nicolaeandreivasile/plc-embedded-application/board-design/kicad-files/ESP32-PLC/board-images-3D/ESP32-PLC-top.jpg

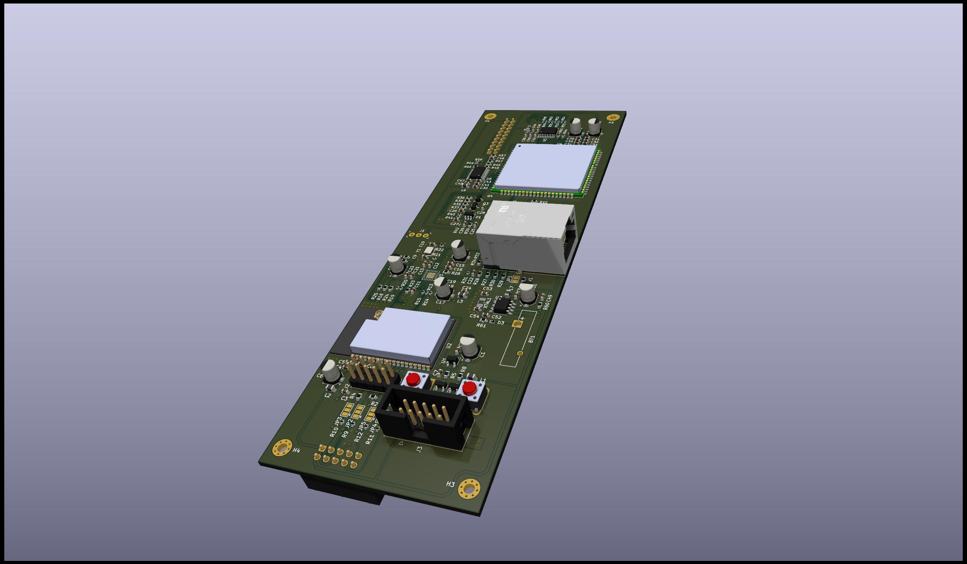
board-design/kicad-files/ESP32-PLC/board-images-3D/ESP32-PLC-top.jpg
