nicolaeandreivasile/plc-embedded-application/board-design/kicad-files/ESP32-PLC-programmer/board-images-3D/ESP32-PLC-programmer-3D-bottom.jpg

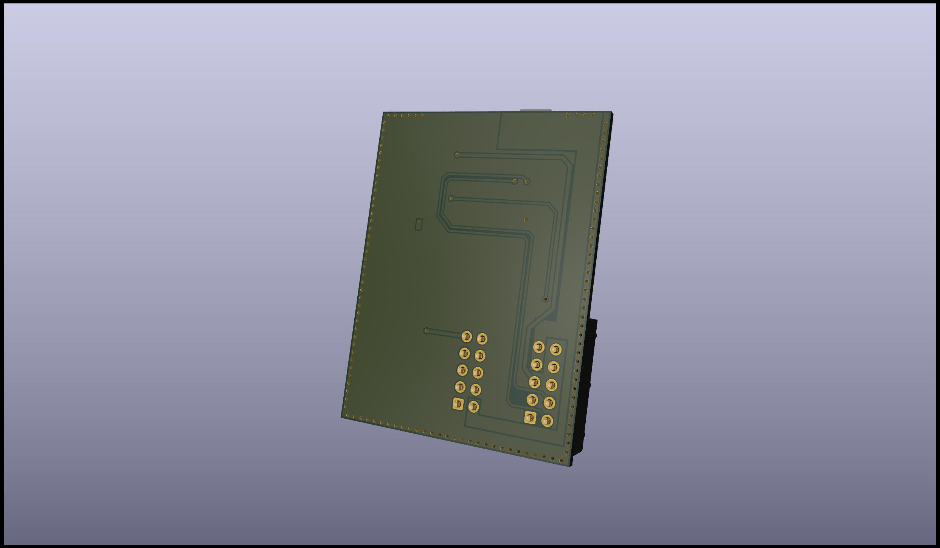
board-design/kicad-files/ESP32-PLC-programmer/board-images-3D/ESP32-PLC-programmer-3D-bottom.jpg
