nicolaeandreivasile/plc-embedded-application/README.md

# plc-embedded-application
A PLC (Programmable Logic Controller) made from scratch focused on controlling and maintaining industrial-like applications

## Board design
Control unit schematic under development. I/O unit schematic development process not started yet
