nicolaeandreivasile/plc-embedded-application/board-design/kicad-files/ESP32-PLC-programmer/schematic-images-sheet/ESP32-programmer-schematic-sheet-color-1.jpg

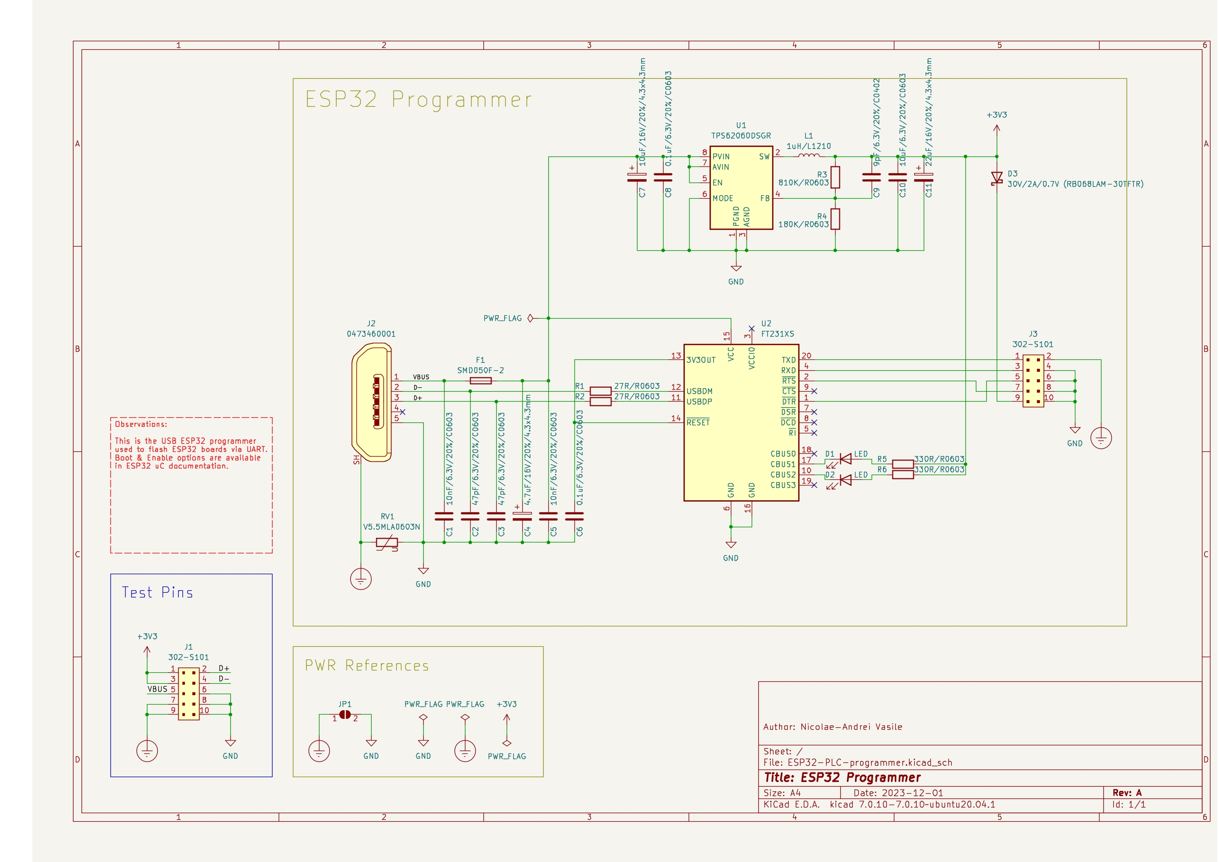
board-design/kicad-files/ESP32-PLC-programmer/schematic-images-sheet/ESP32-programmer-schematic-sheet-color-1.jpg
