nicolaeandreivasile/plc-embedded-application/board-design/kicad-files/ESP32-PLC-programmer/schematic-images-simple/ESP32-programmer-schematic-simple-mono-1.jpg

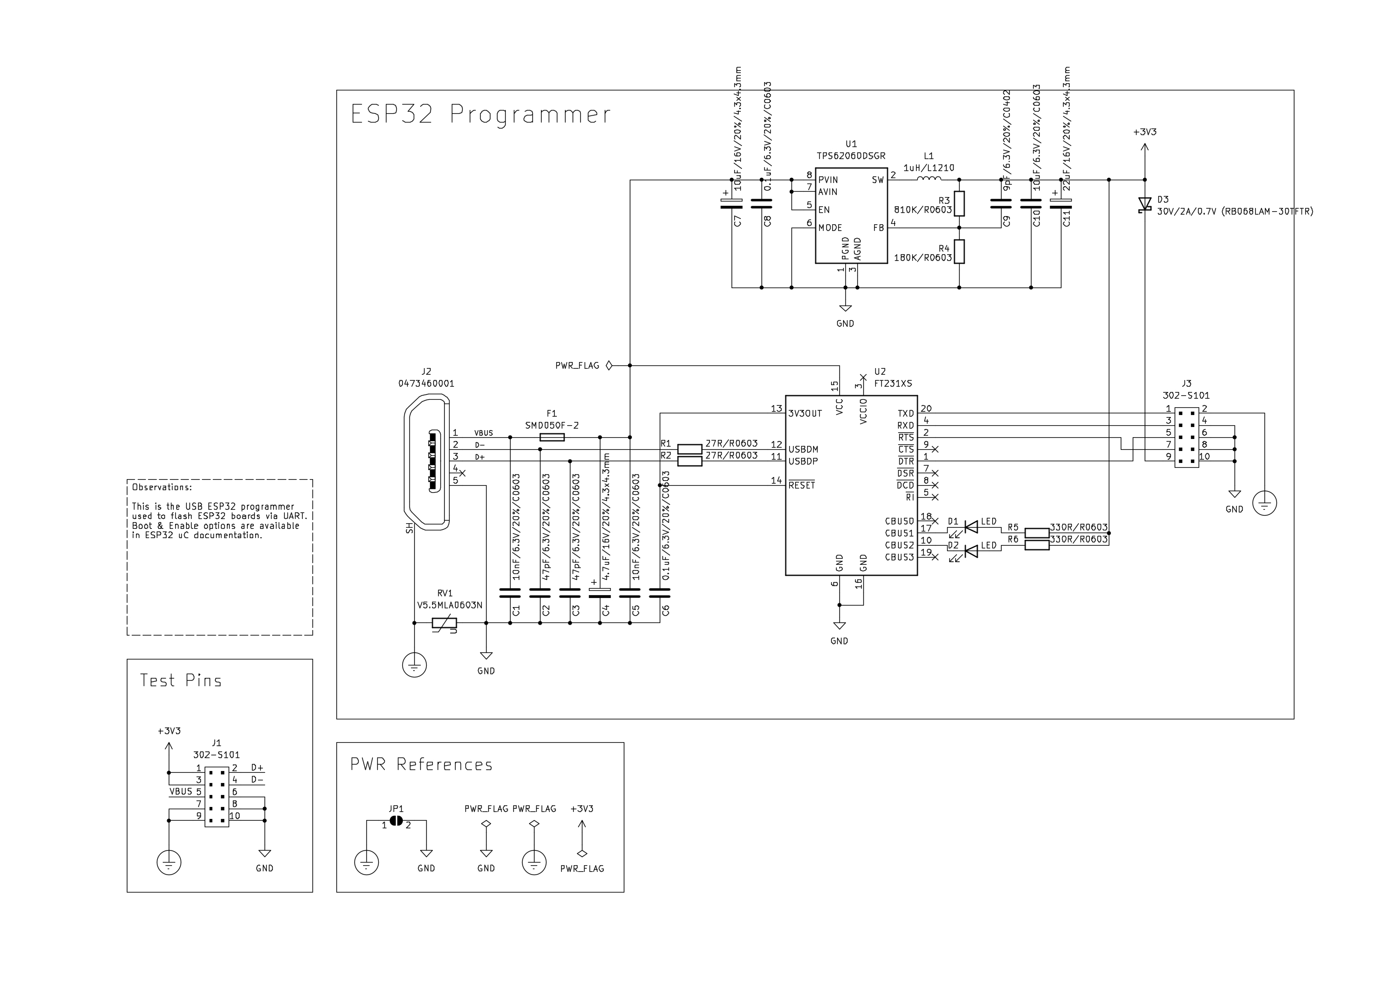
board-design/kicad-files/ESP32-PLC-programmer/schematic-images-simple/ESP32-programmer-schematic-simple-mono-1.jpg
