nicolaeandreivasile/plc-embedded-application/board-design/kicad-files/ESP32-PLC/schematic-images-sheet/ESP32-schematic-sheet-color-3.jpg

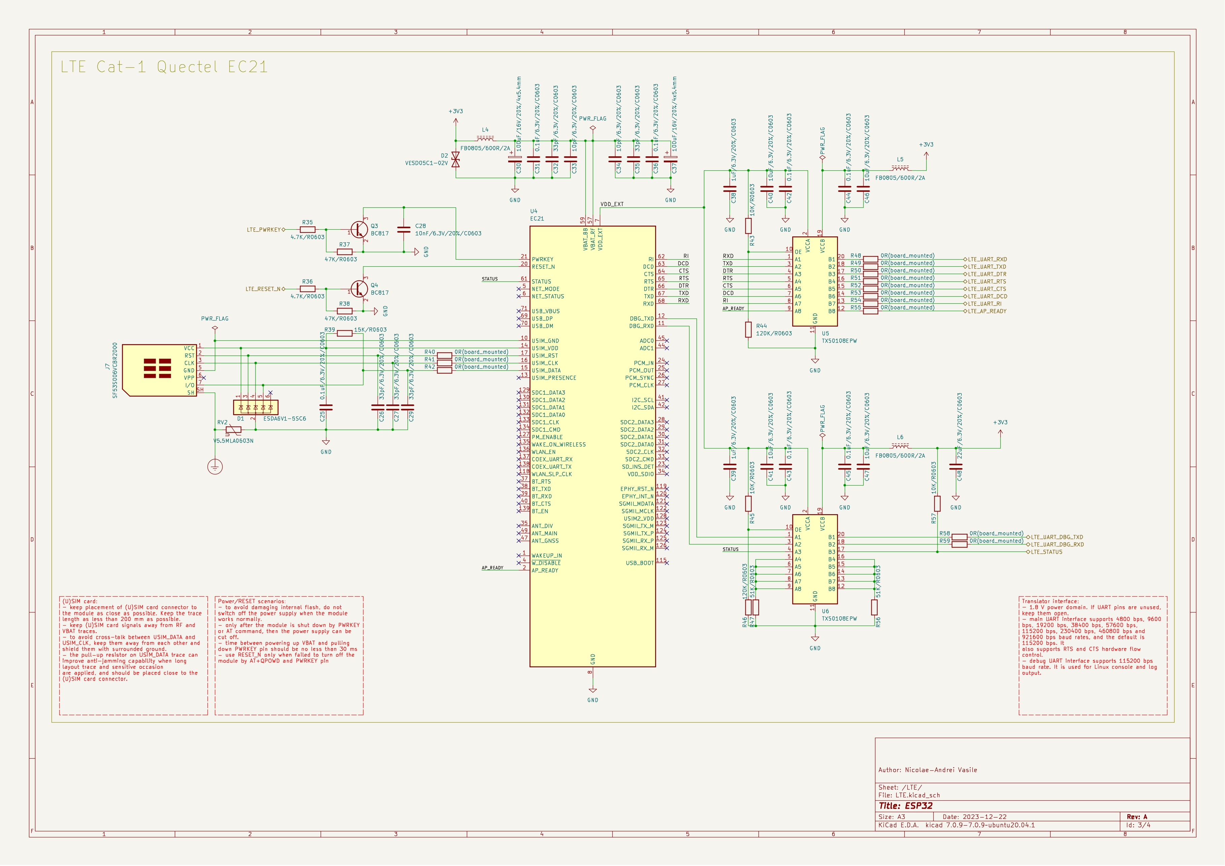
board-design/kicad-files/ESP32-PLC/schematic-images-sheet/ESP32-schematic-sheet-color-3.jpg
