nicolaeandreivasile/plc-embedded-application/board-design/kicad-files/ESP32-PLC/schematic-images-simple/ESP32-schematic-simple-mono-1.jpg

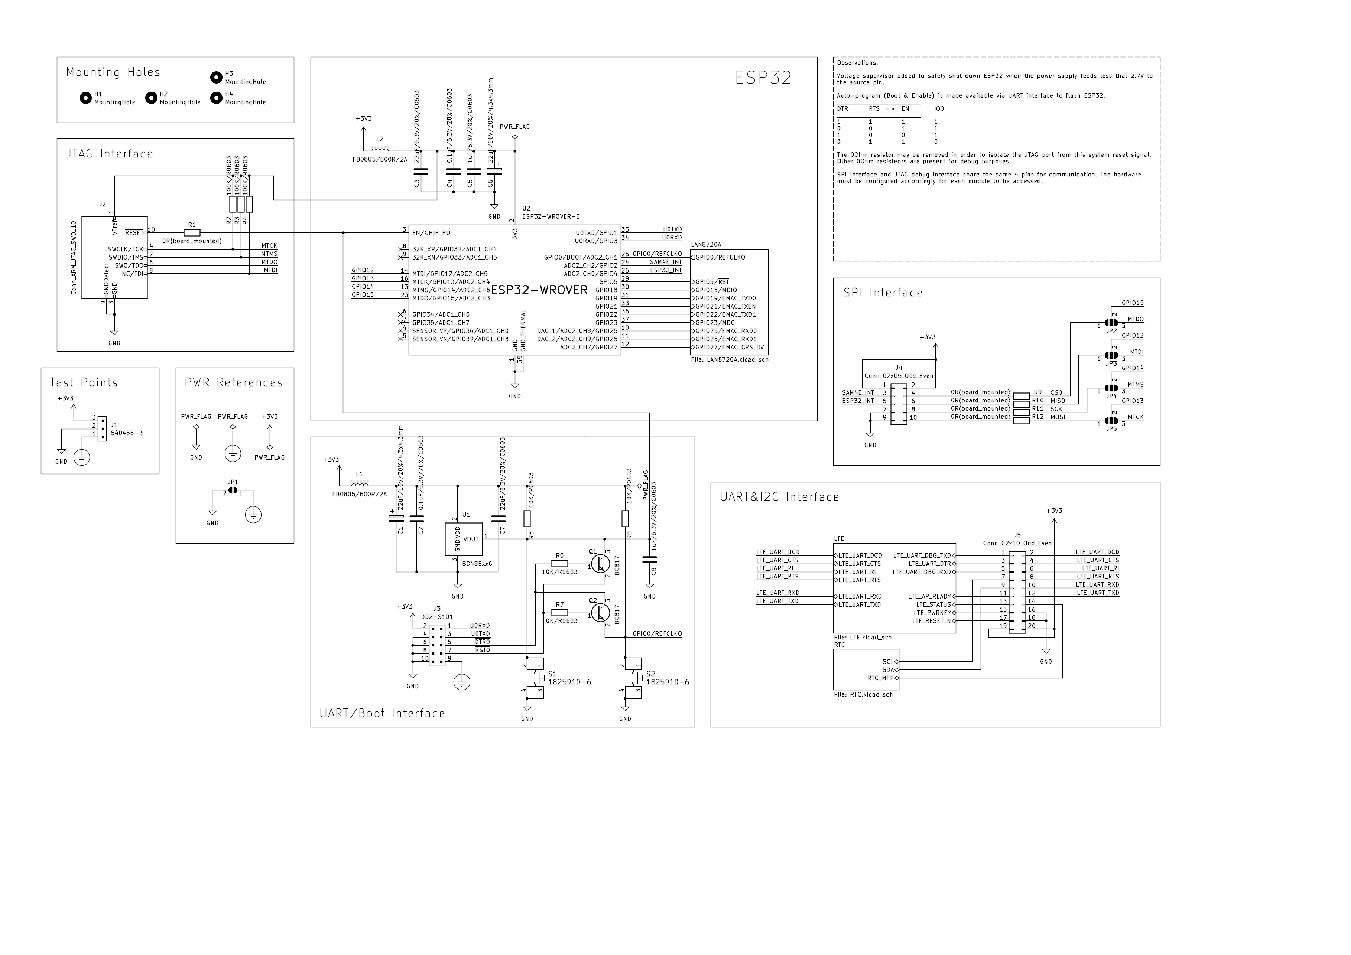
board-design/kicad-files/ESP32-PLC/schematic-images-simple/ESP32-schematic-simple-mono-1.jpg
