nicolaeandreivasile/plc-embedded-application/board-design/kicad-files/SAM4E-PLC/schematic-images-sheet/SAM4E-schematic-sheet-color-4.jpg

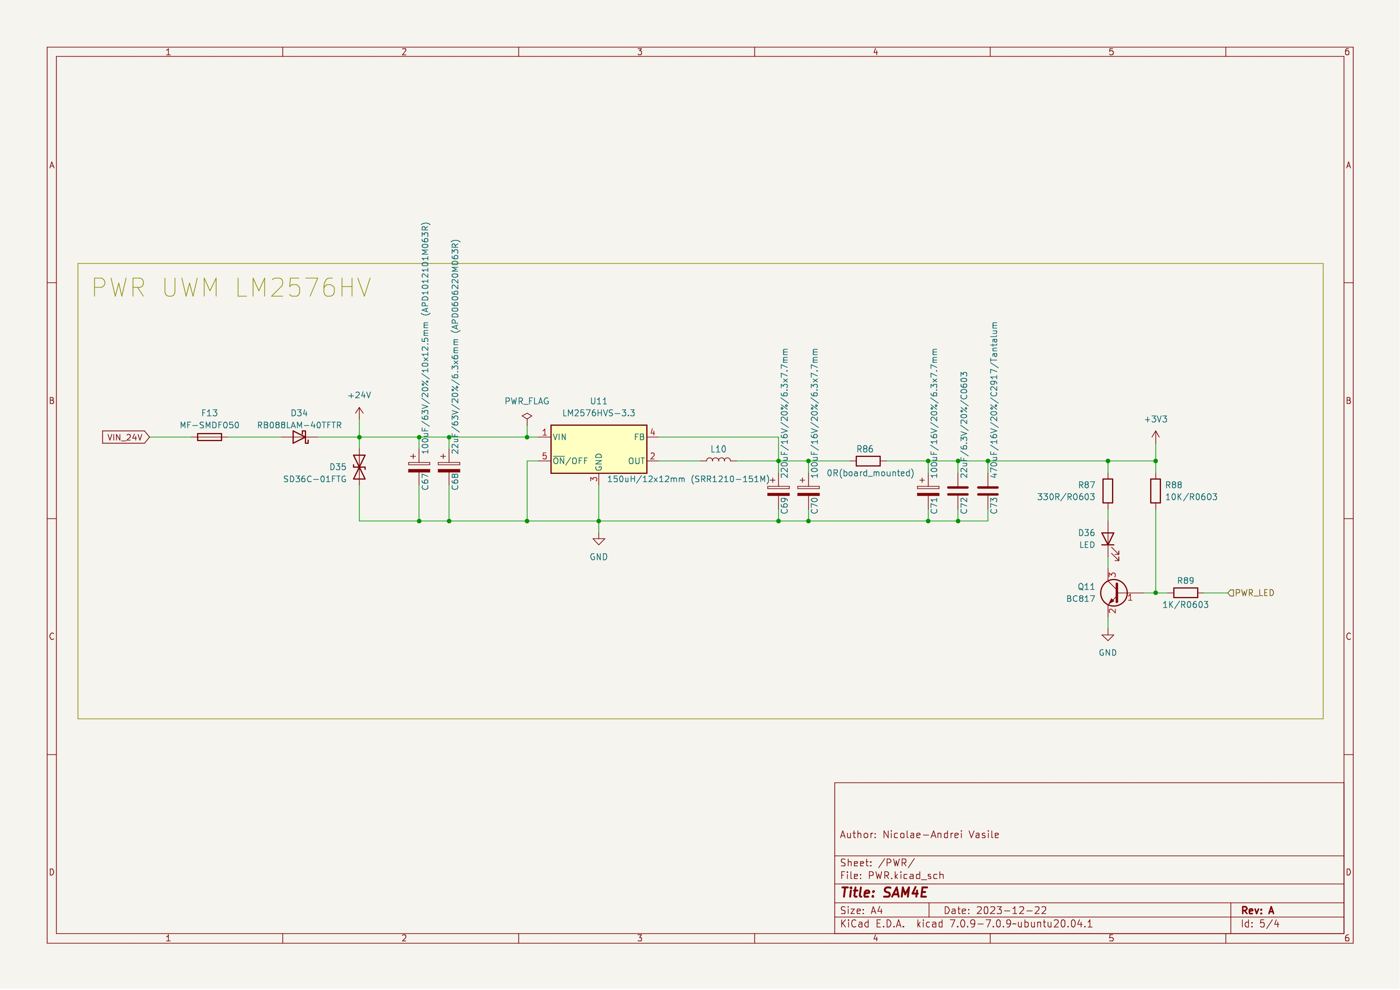
board-design/kicad-files/SAM4E-PLC/schematic-images-sheet/SAM4E-schematic-sheet-color-4.jpg
