nicolaeandreivasile/plc-embedded-application/board-design/kicad-files/SAM4E-PLC/schematic-images-simple/SAM4E-schematic-simple-color-2.jpg

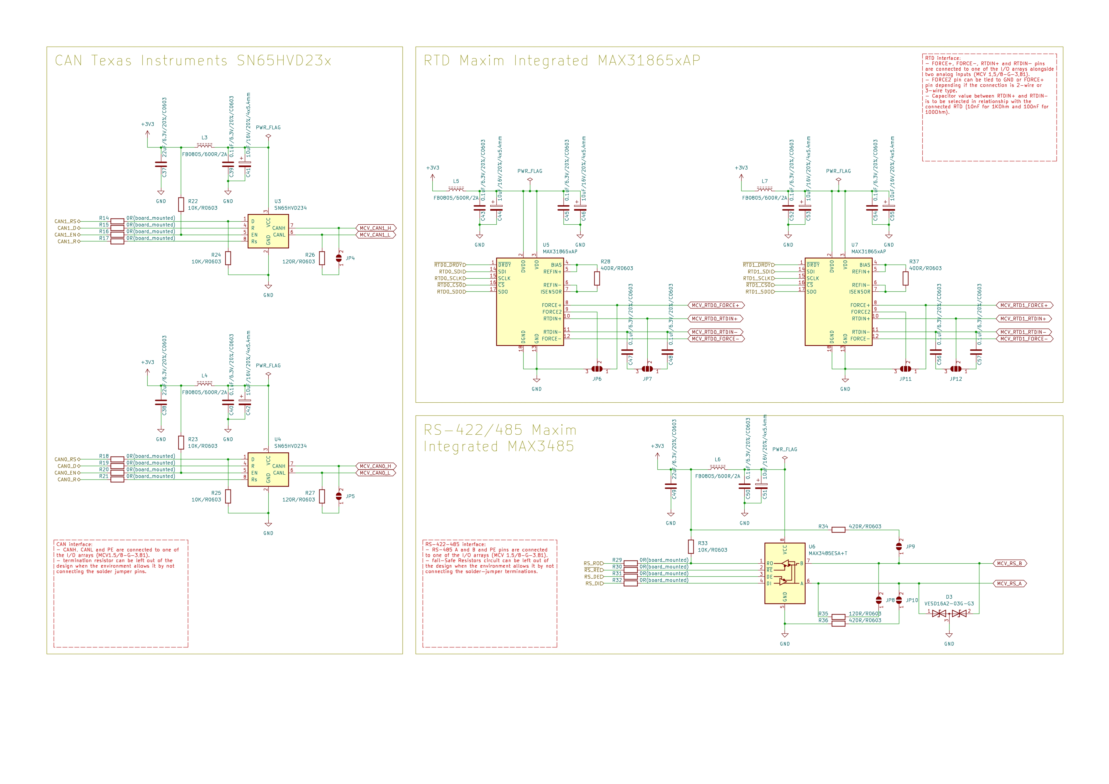
board-design/kicad-files/SAM4E-PLC/schematic-images-simple/SAM4E-schematic-simple-color-2.jpg
