nicolaeandreivasile/plc-embedded-application/board-design/kicad-files/PCB-top_merged.pdf

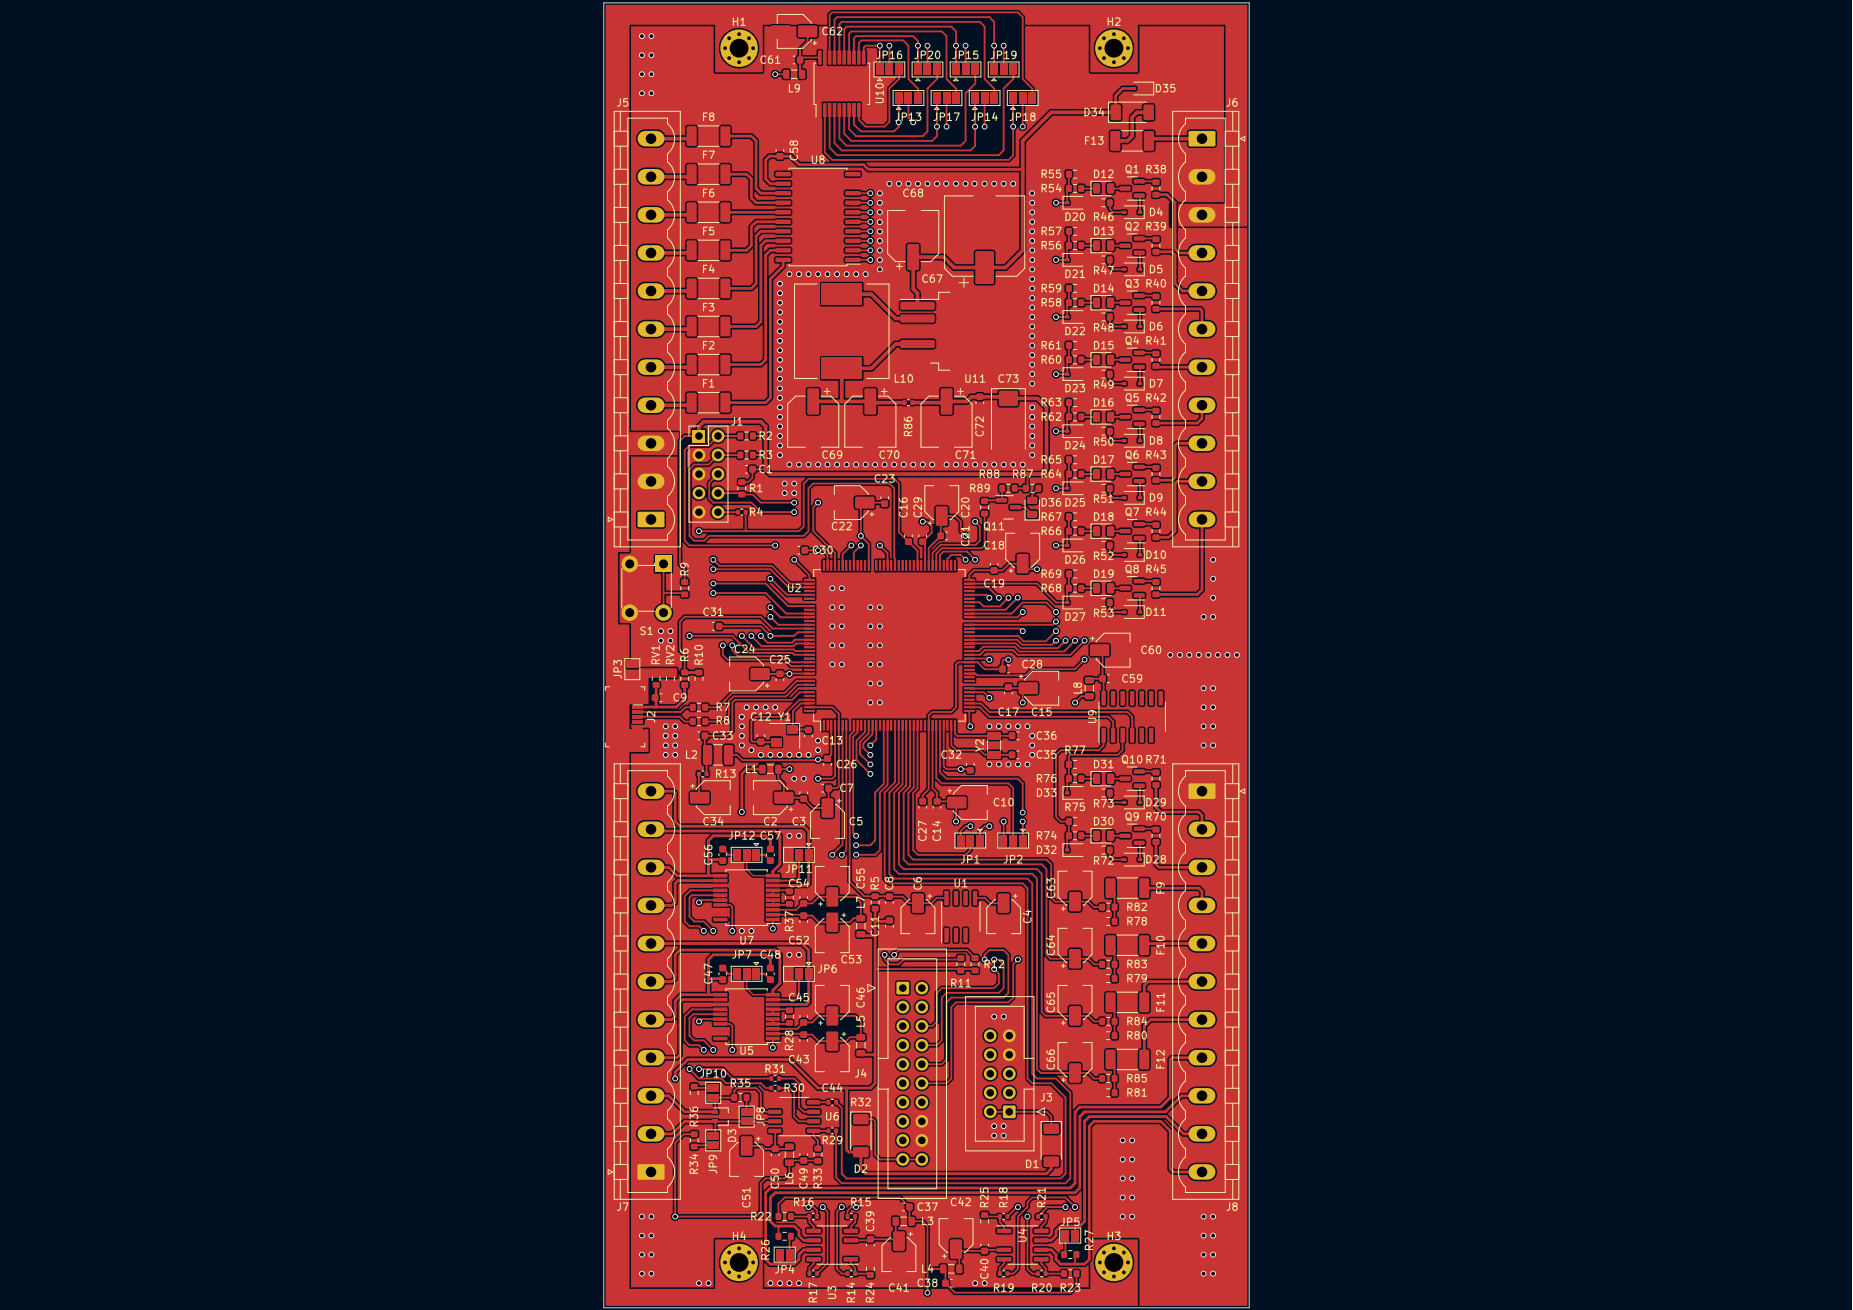
[picture p68: page 1]

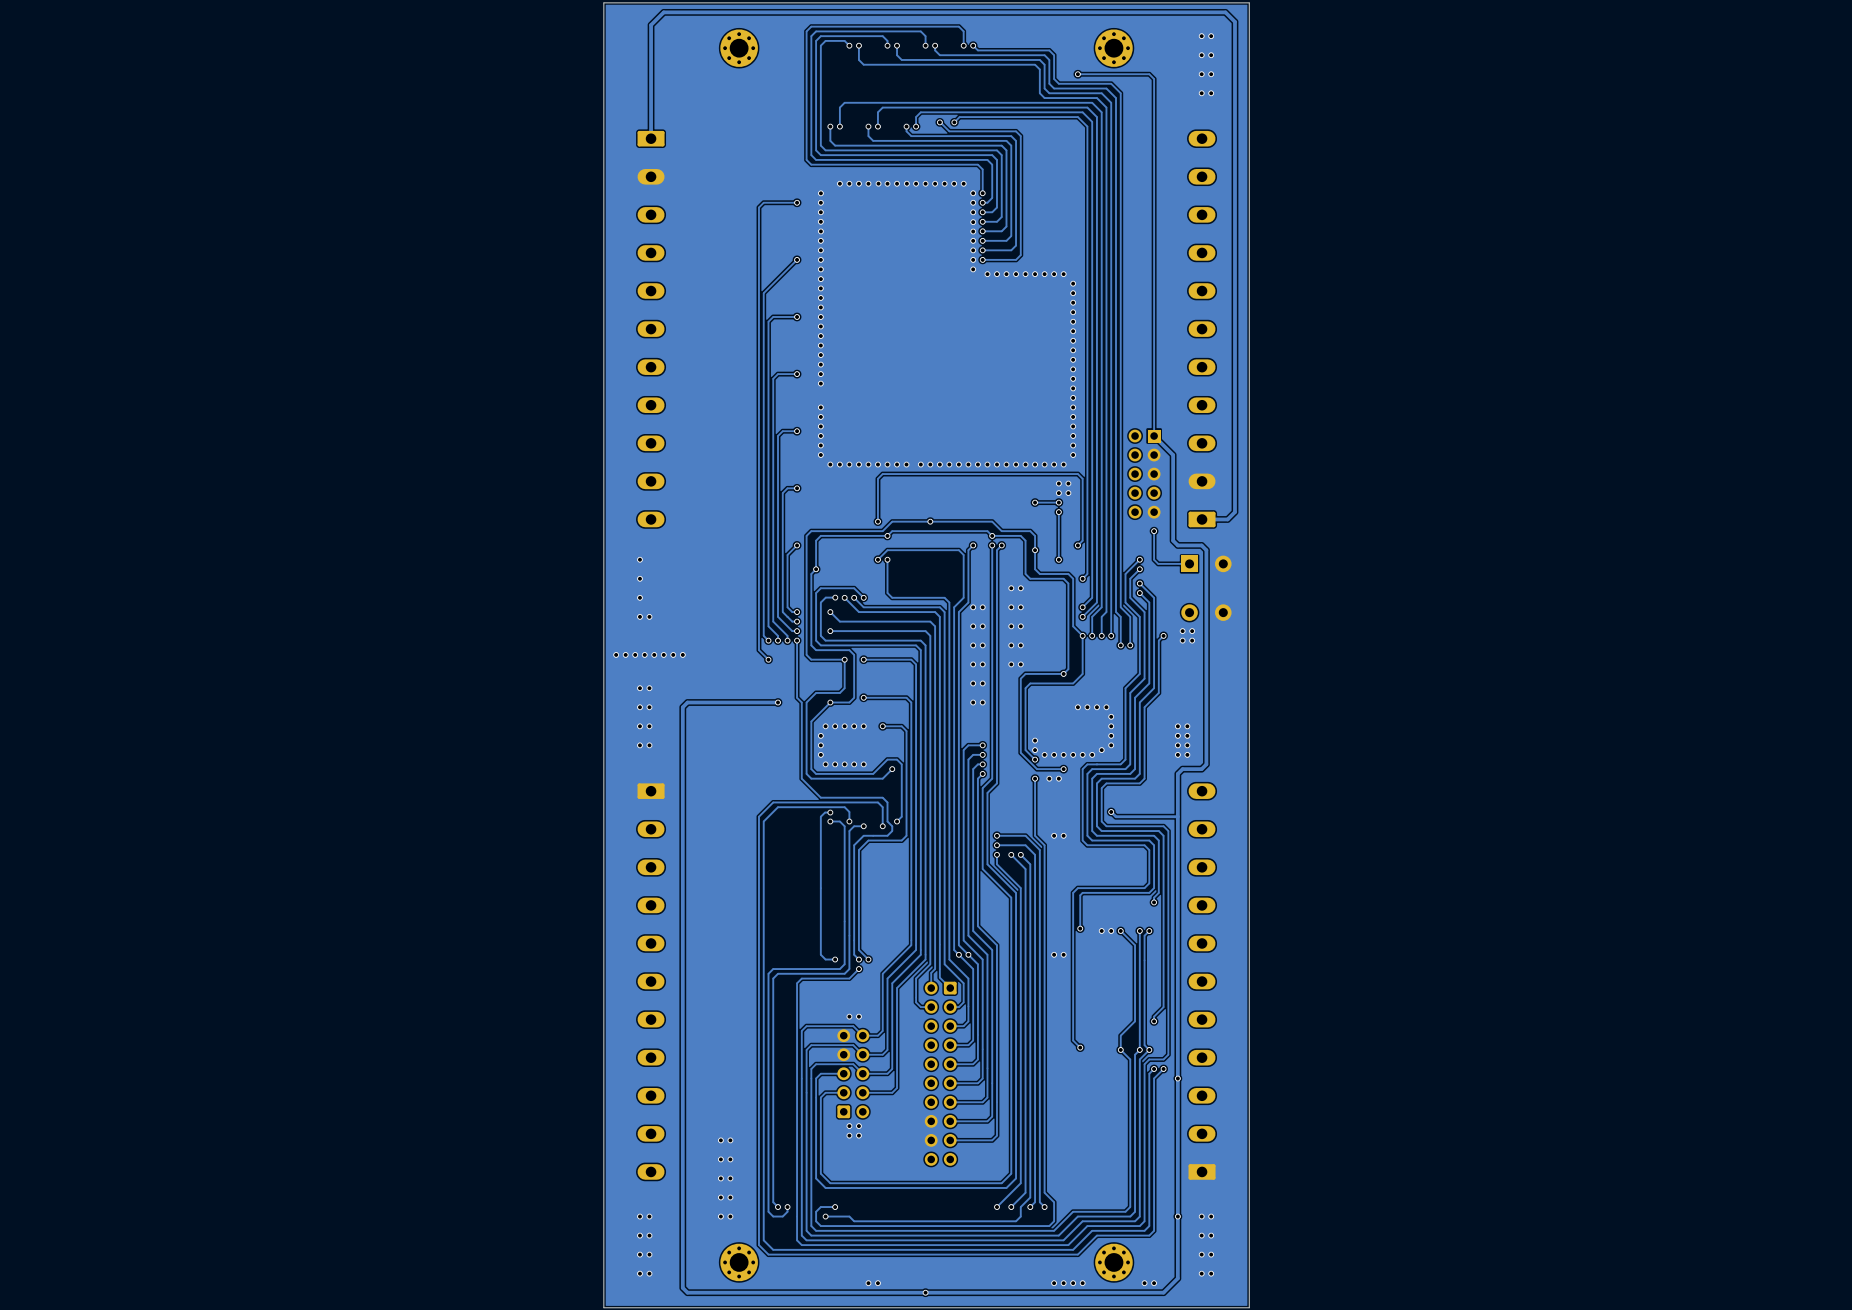
[picture p69: page 2]

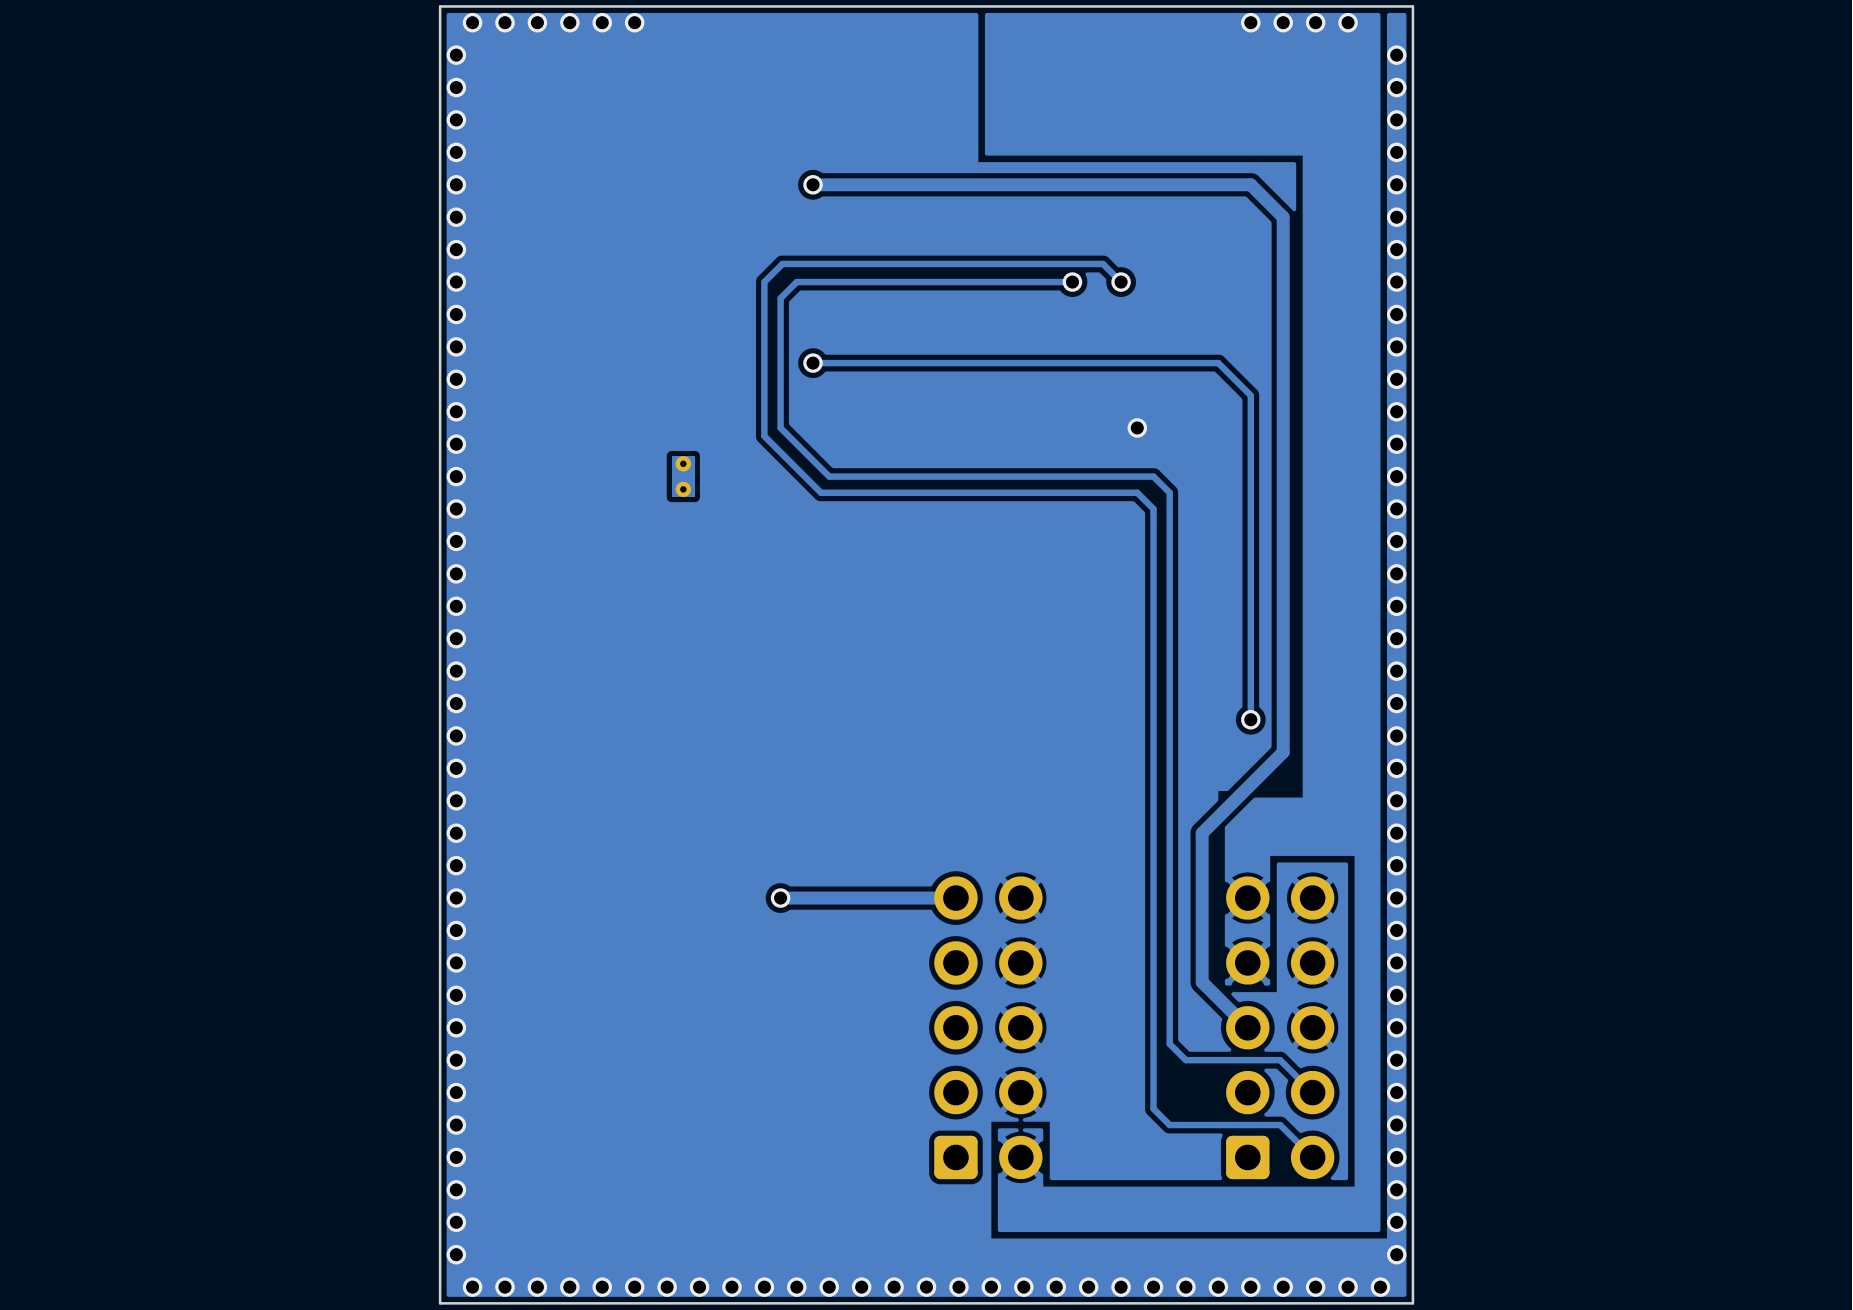
[picture p70: page 3]

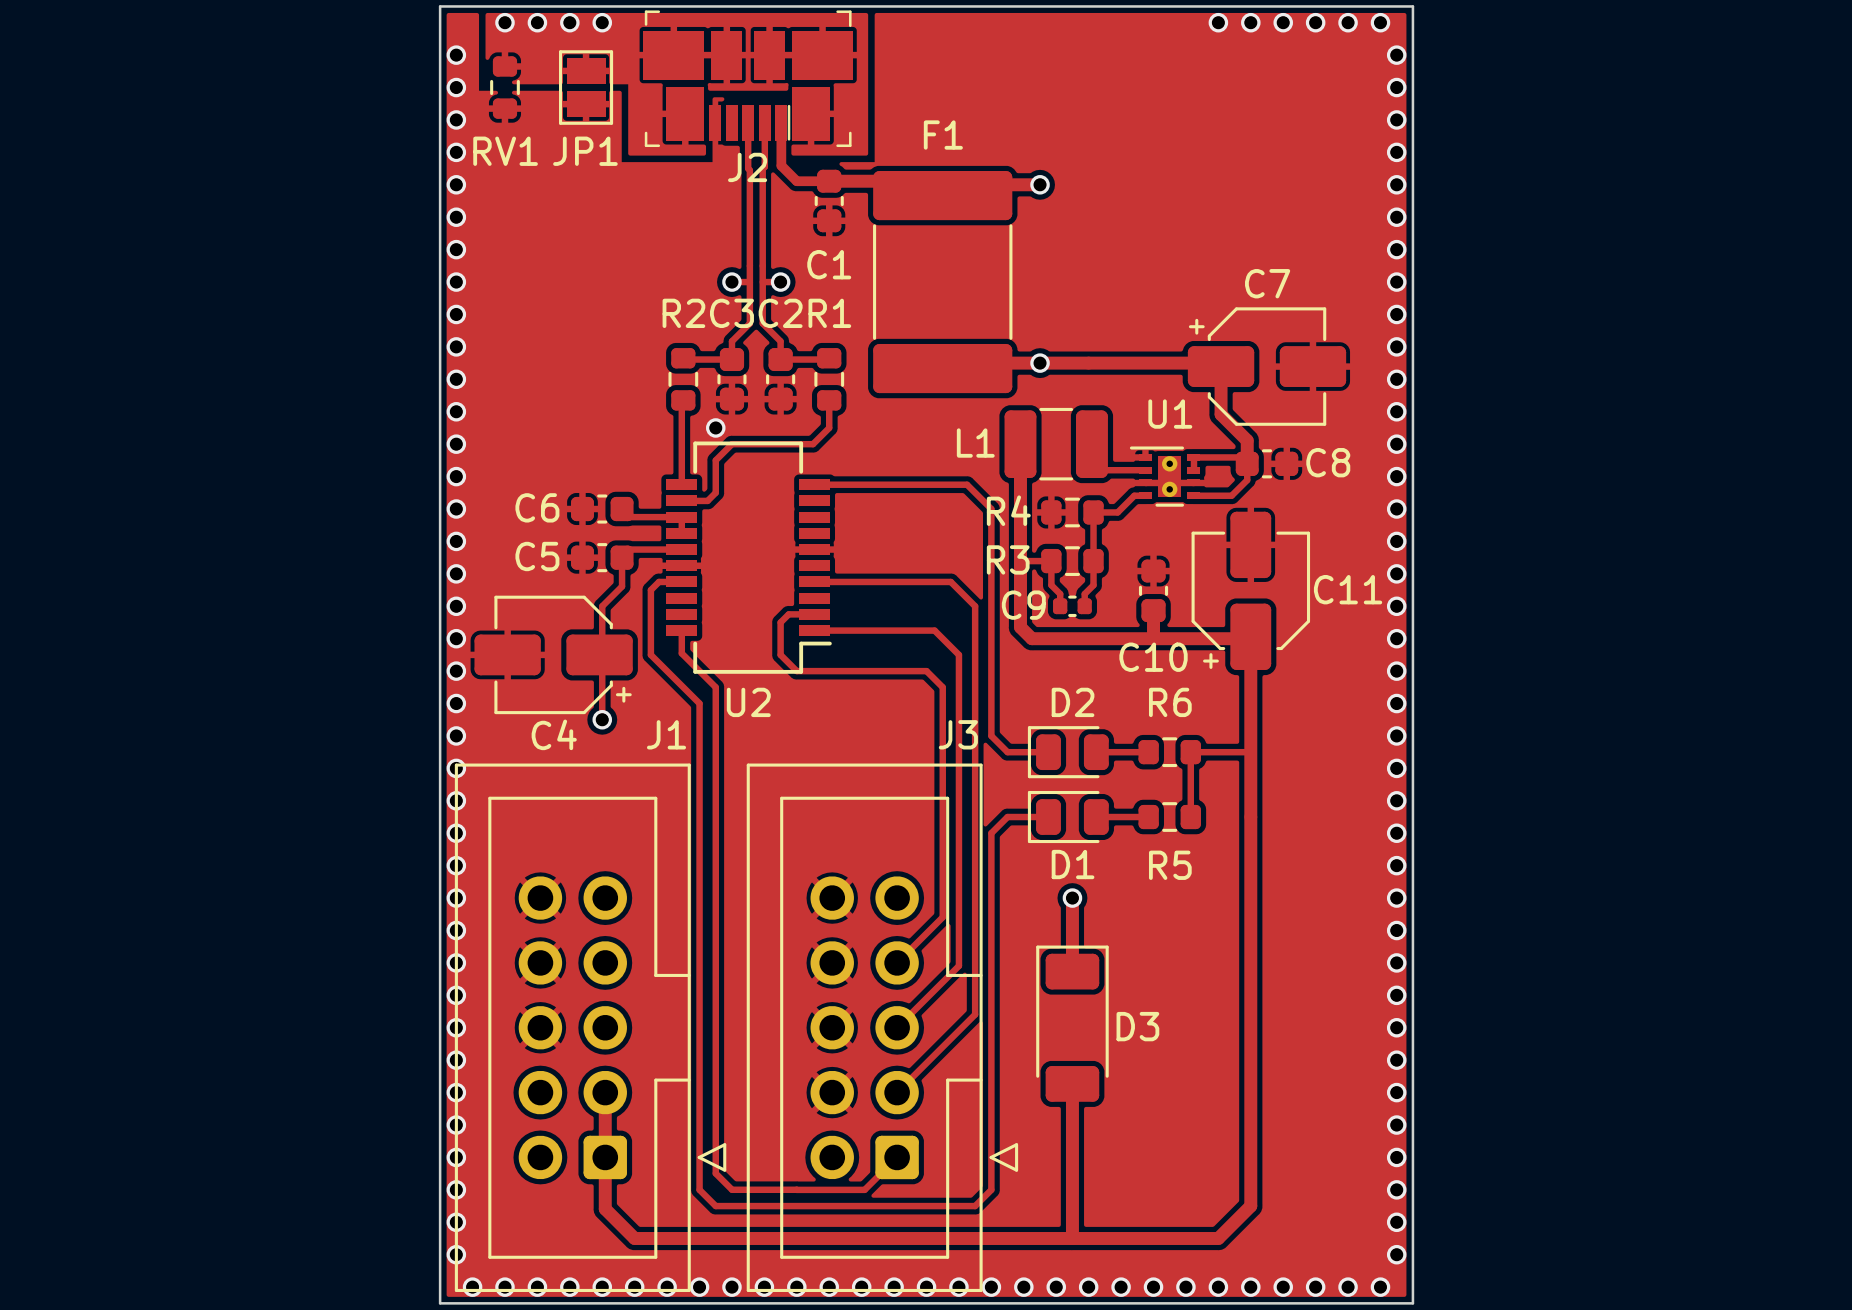
[picture p71: page 4]
