nicolaeandreivasile/plc-embedded-application/board-design/eagle-files/ESP32-PLC-programmer/plc_esp32_programmer.pdf

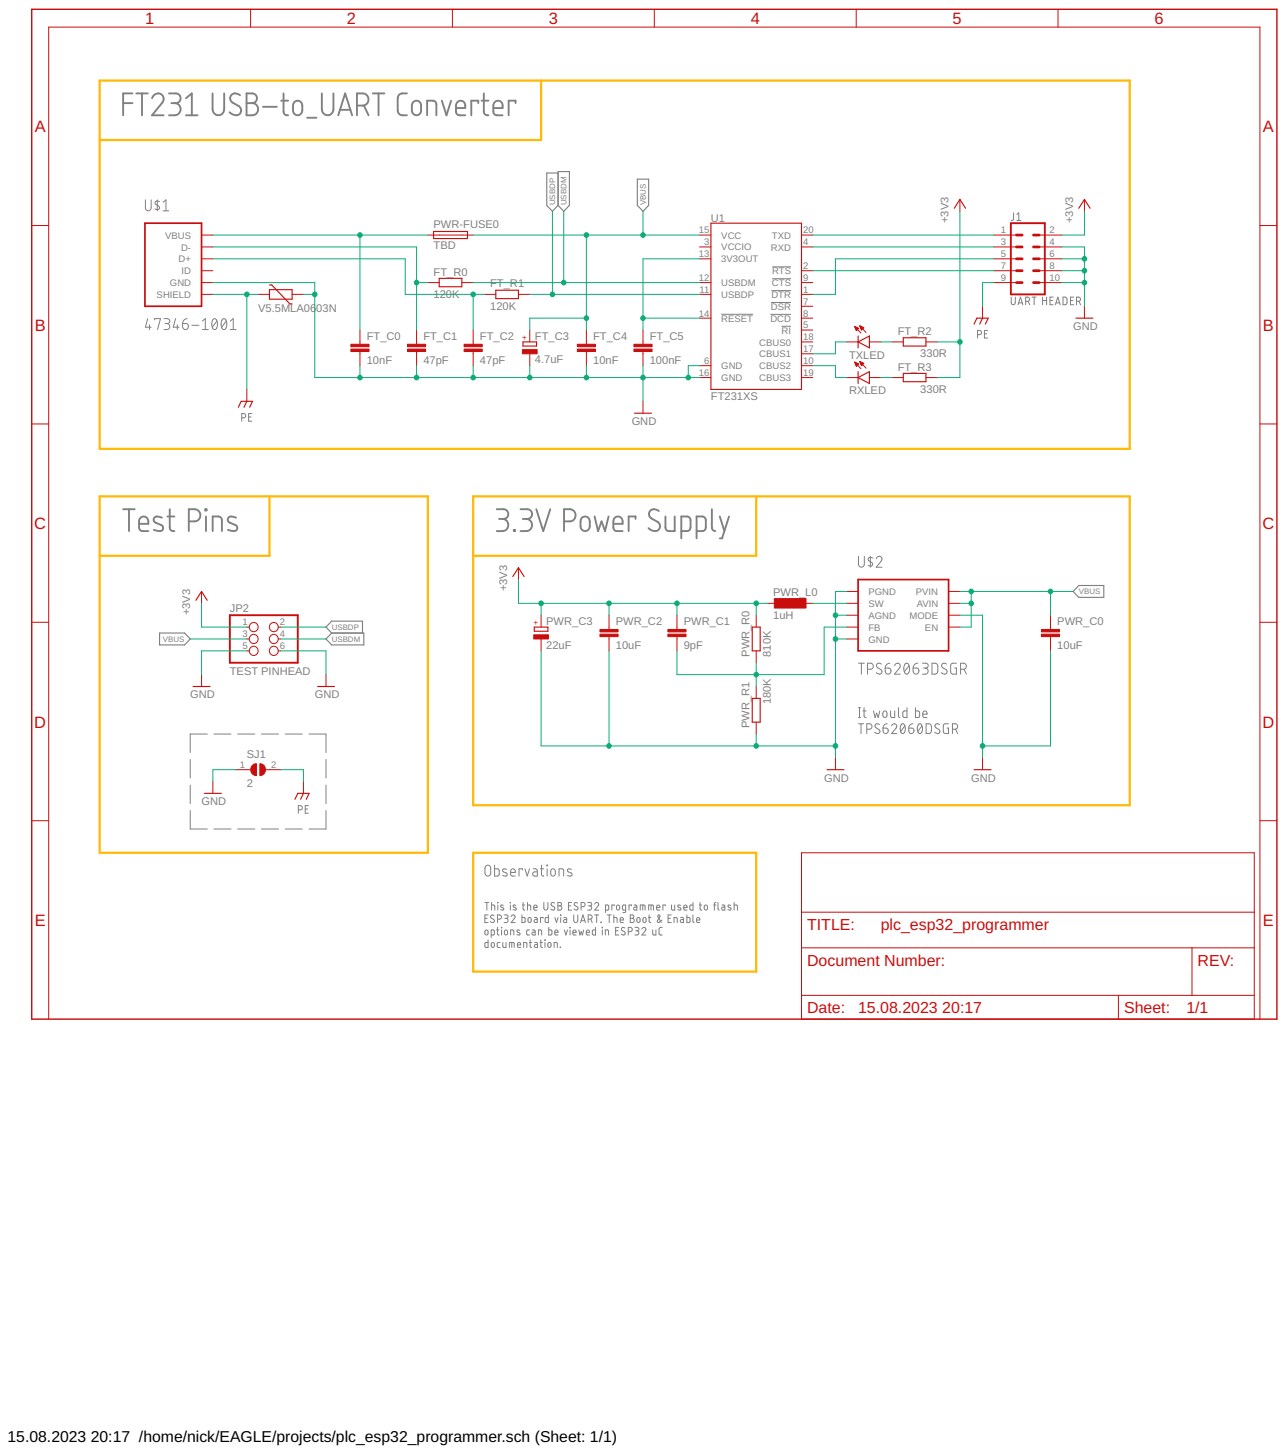
[picture p72: page 1]

3 | 1 VBUSD- D+ 3 | 4

Document Number: | REV:

Date: 15.08.2023 20:17 | Sheet: 1/1

15.08.2023 20:17 /home/nick/EAGLE/projects/plc_esp32_programmer.sch (Sheet: 1/1)
