nicolaeandreivasile/plc-embedded-application/board-design/eagle-files/ESP32-PLC/plc_esp32.pdf

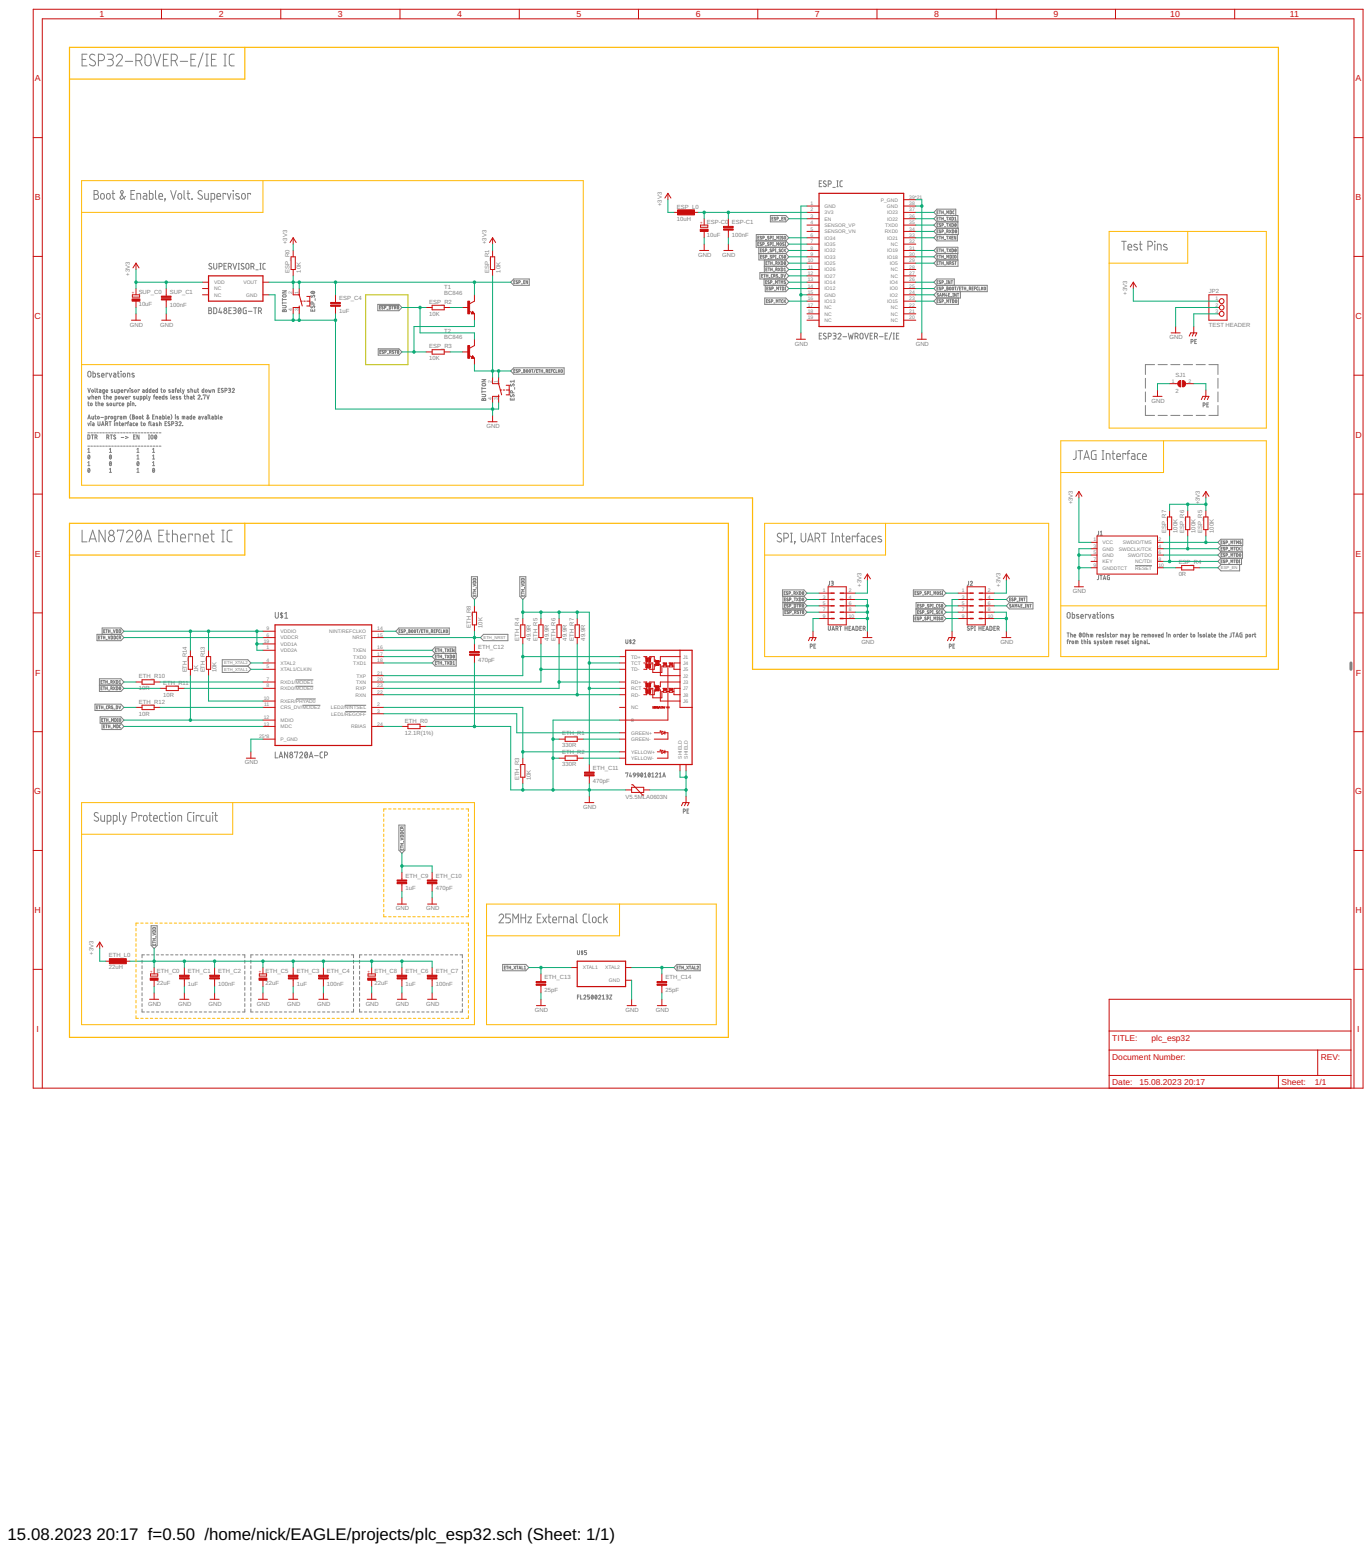
[picture p73: page 1]

TD+ TCT
TD- RD+ RCT RD- NC

15.08.2023 20:17 f=0.50 /home/nick/EAGLE/projects/plc_esp32.sch (Sheet: 1/1)
