nicolaeandreivasile/plc-embedded-application/board-design/eagle-files/SAM4E-PLC/plc_sam4e.pdf

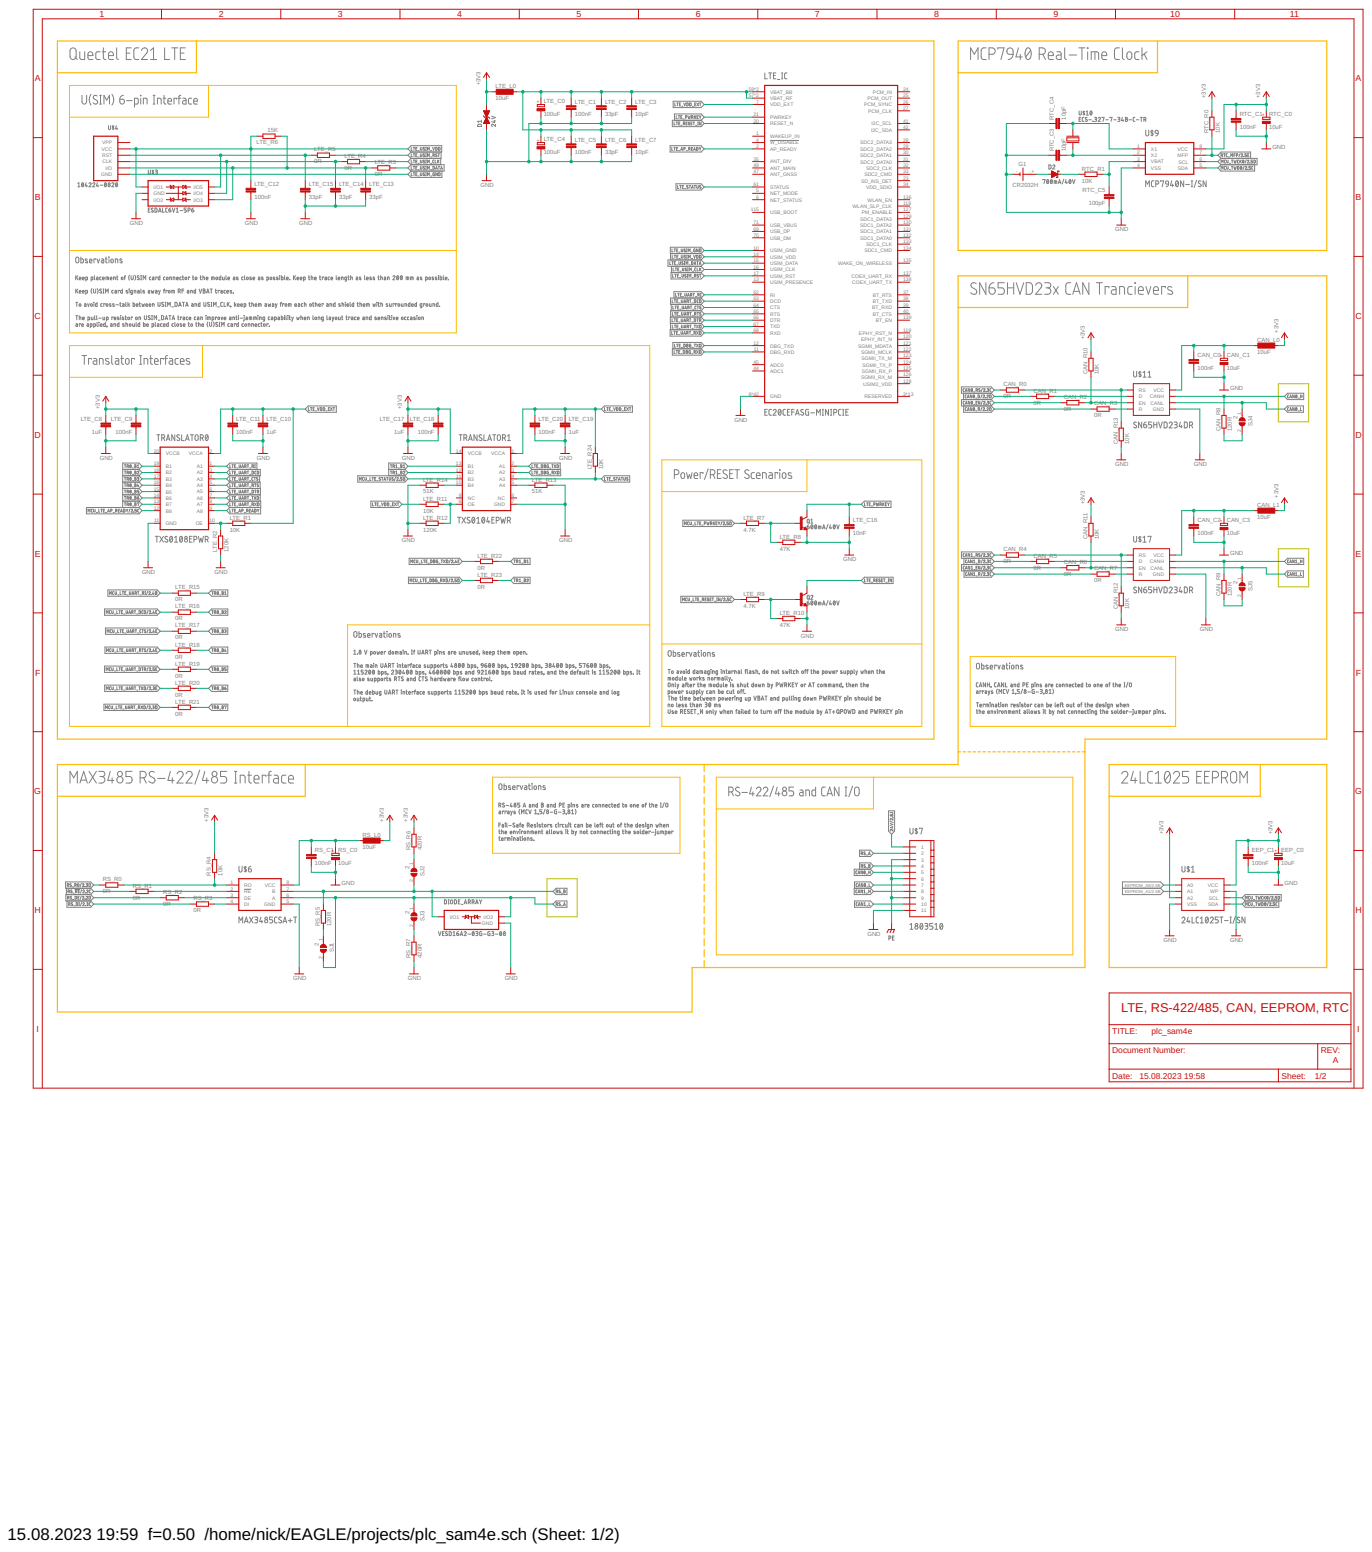
[picture p74: page 1]

LTE, RS-422/485, CAN, EEPROM, RTC

15.08.2023 19:59 f=0.50 /home/nick/EAGLE/projects/plc_sam4e.sch (Sheet: 1/2)

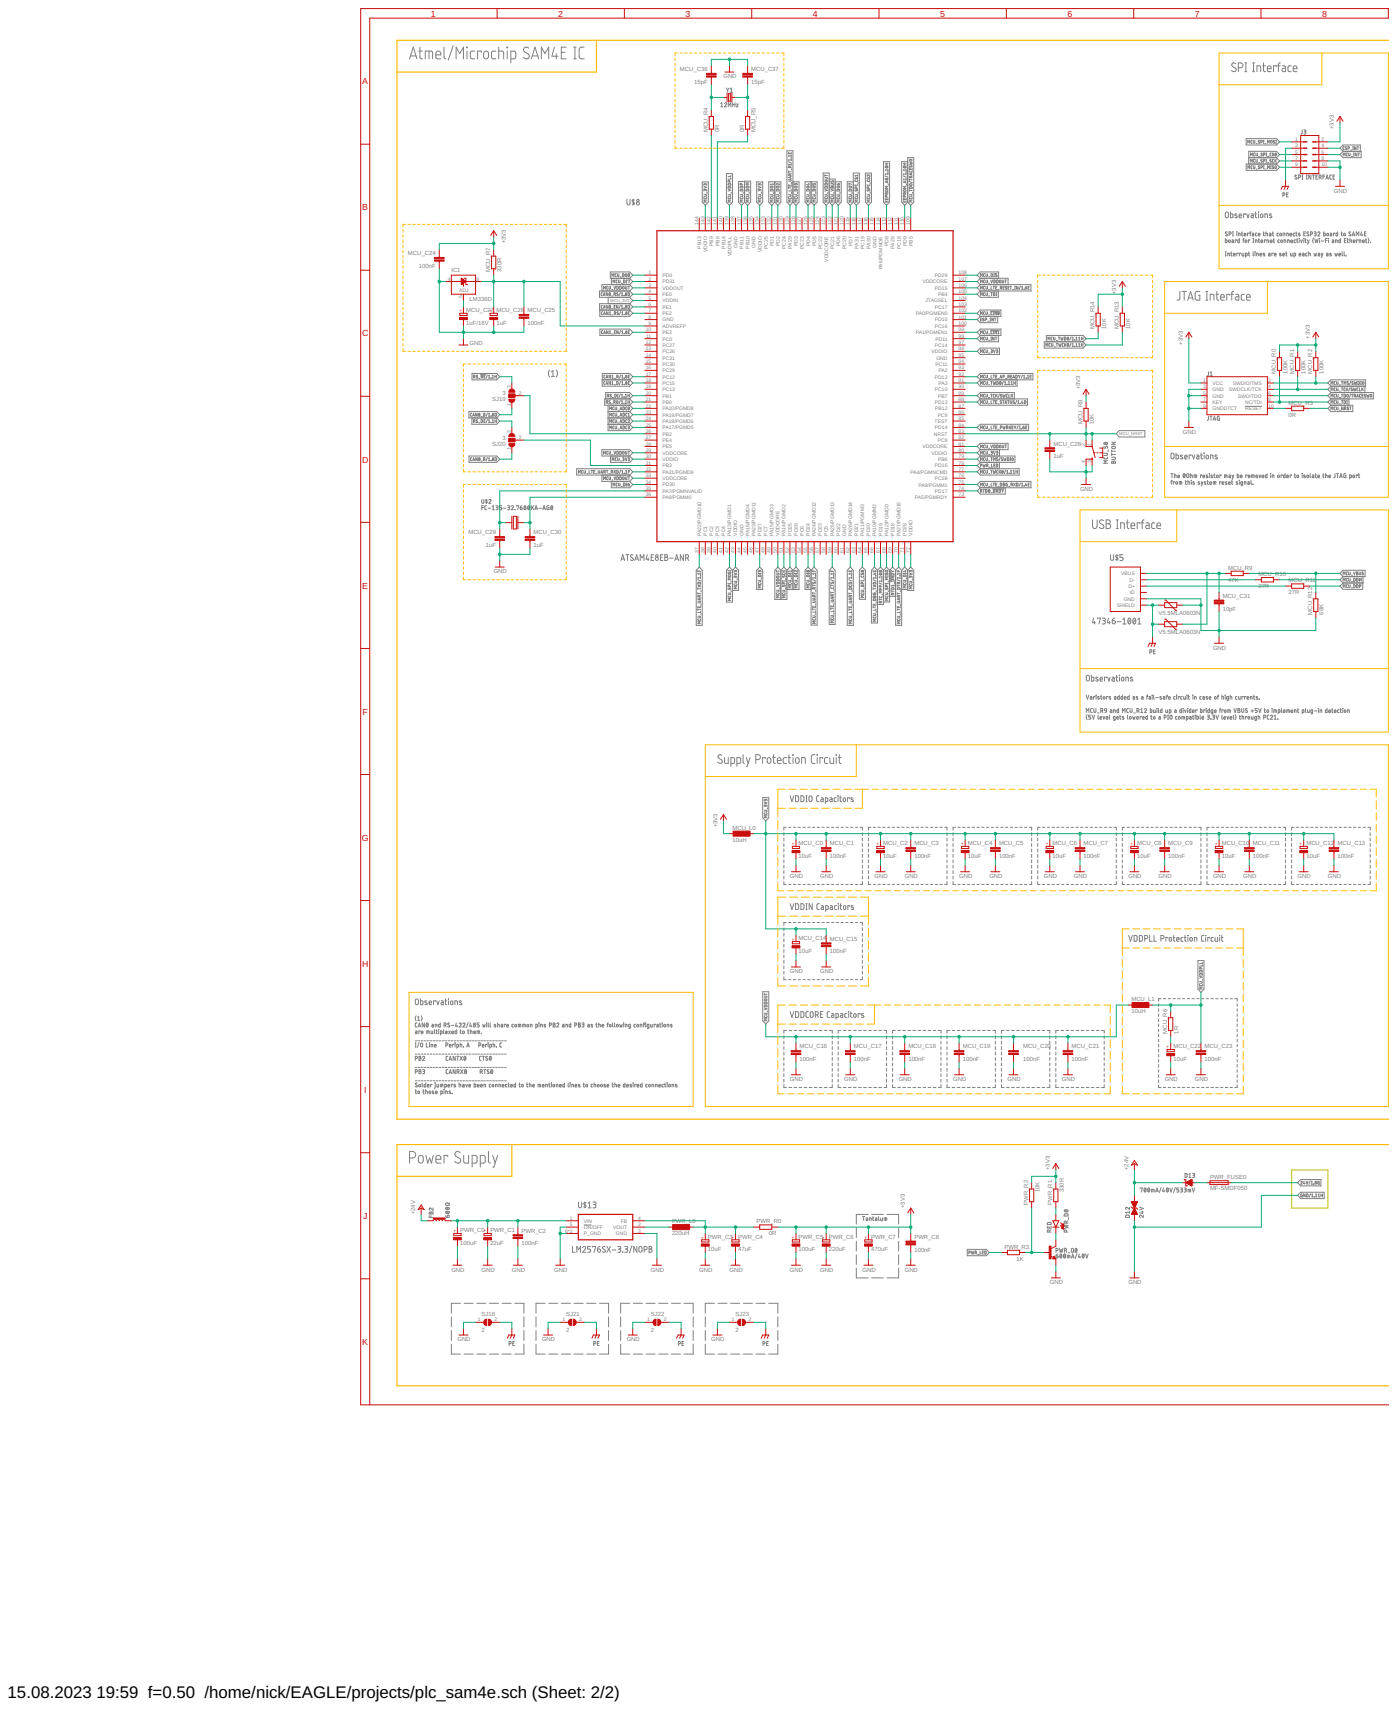
[picture p75: page 2]

4 SWDIO/TMS
6 SWDCLK/TCK
10 NC/TDI 8 SWO/TDO

15.08.2023 19:59 f=0.50 /home/nick/EAGLE/projects/plc_sam4e.sch (Sheet: 2/2)

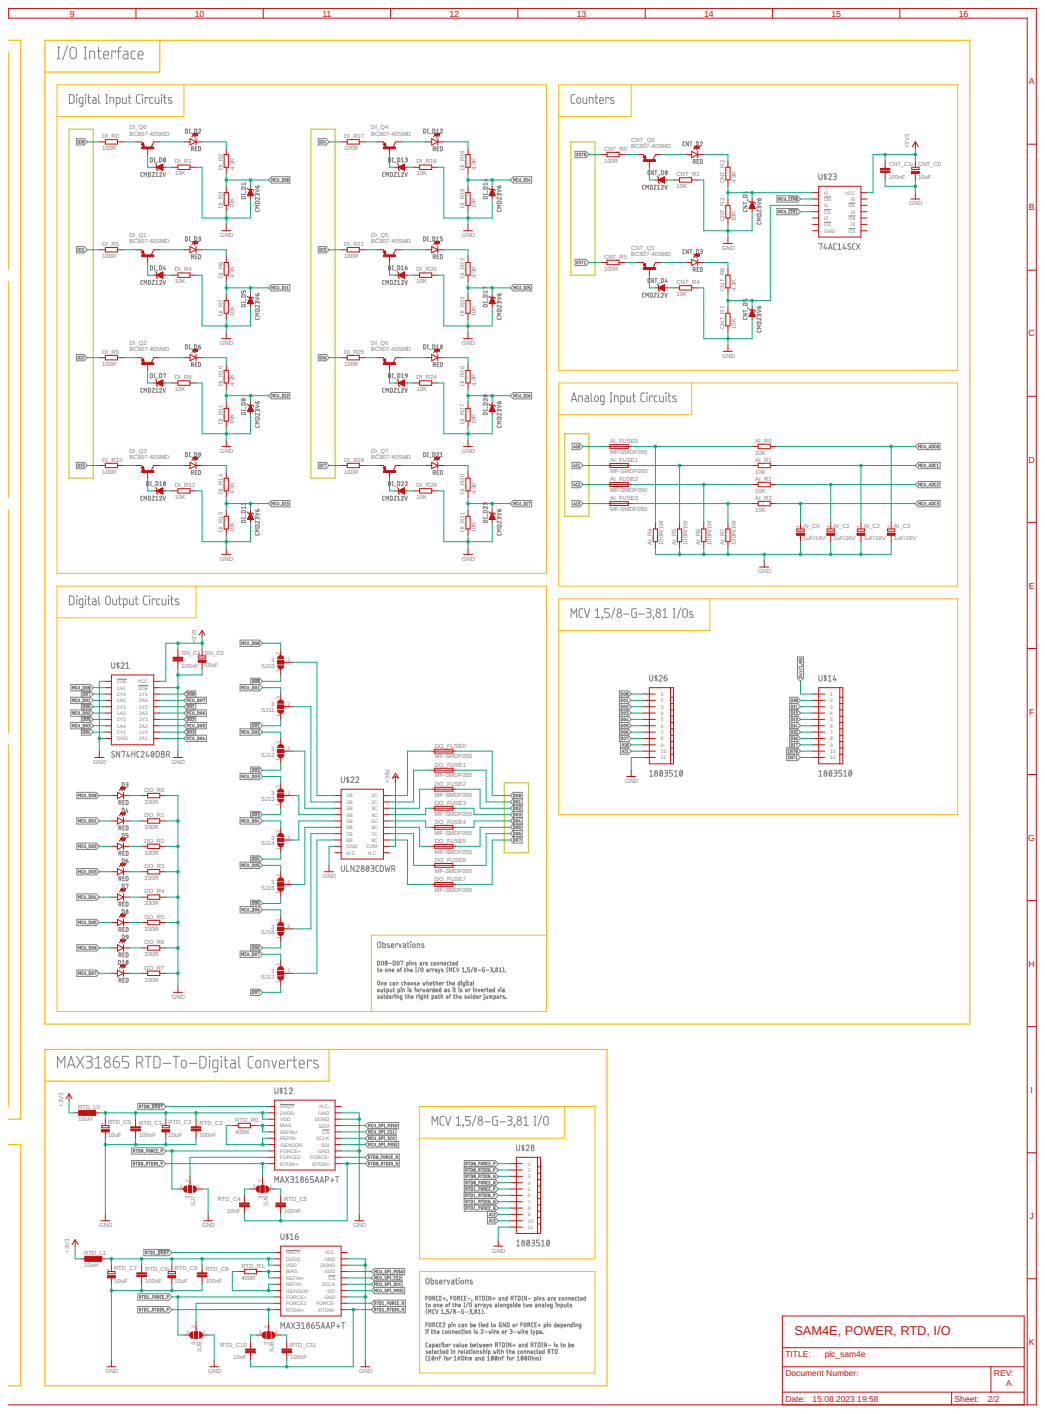
[picture p76: page 3]

DO_FUSE0 DO_FUSE1 DO_FUSE2 DO_FUSE3 DO_FUSE4 DO_FUSE5 DO_FUSE6 DO_FUSE7
MF-SMDF050 MF-SMDF050 MF-SMDF050 MF-SMDF050
