nicolaeandreivasile/plc-embedded-application/board-design/kicad-files/ESP32-PLC-programmer/schematic-sheet-color.pdf

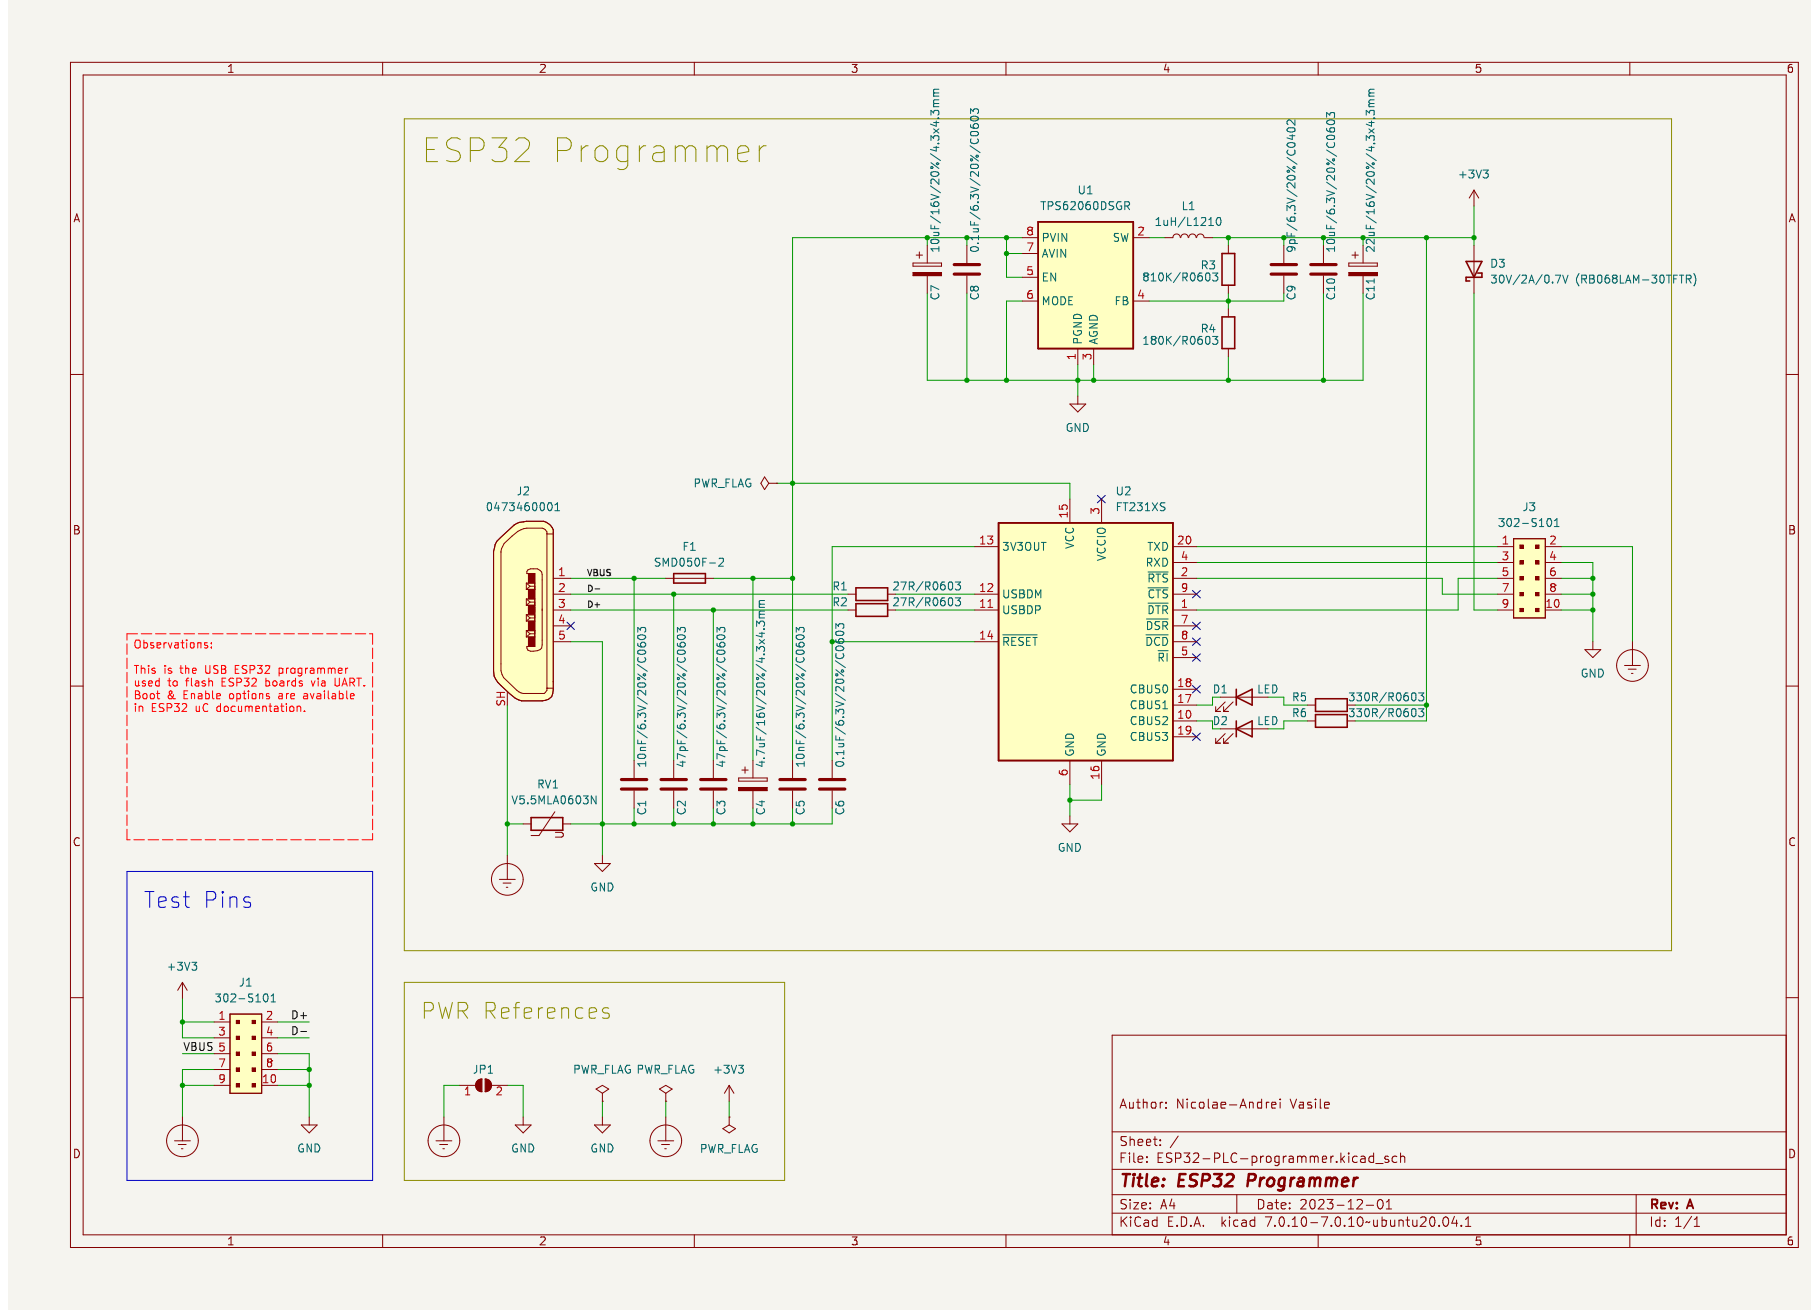
[picture p77: page 1]
