nicolaeandreivasile/plc-embedded-application/board-design/kicad-files/ESP32-PLC-programmer/schematic-simple-color.pdf

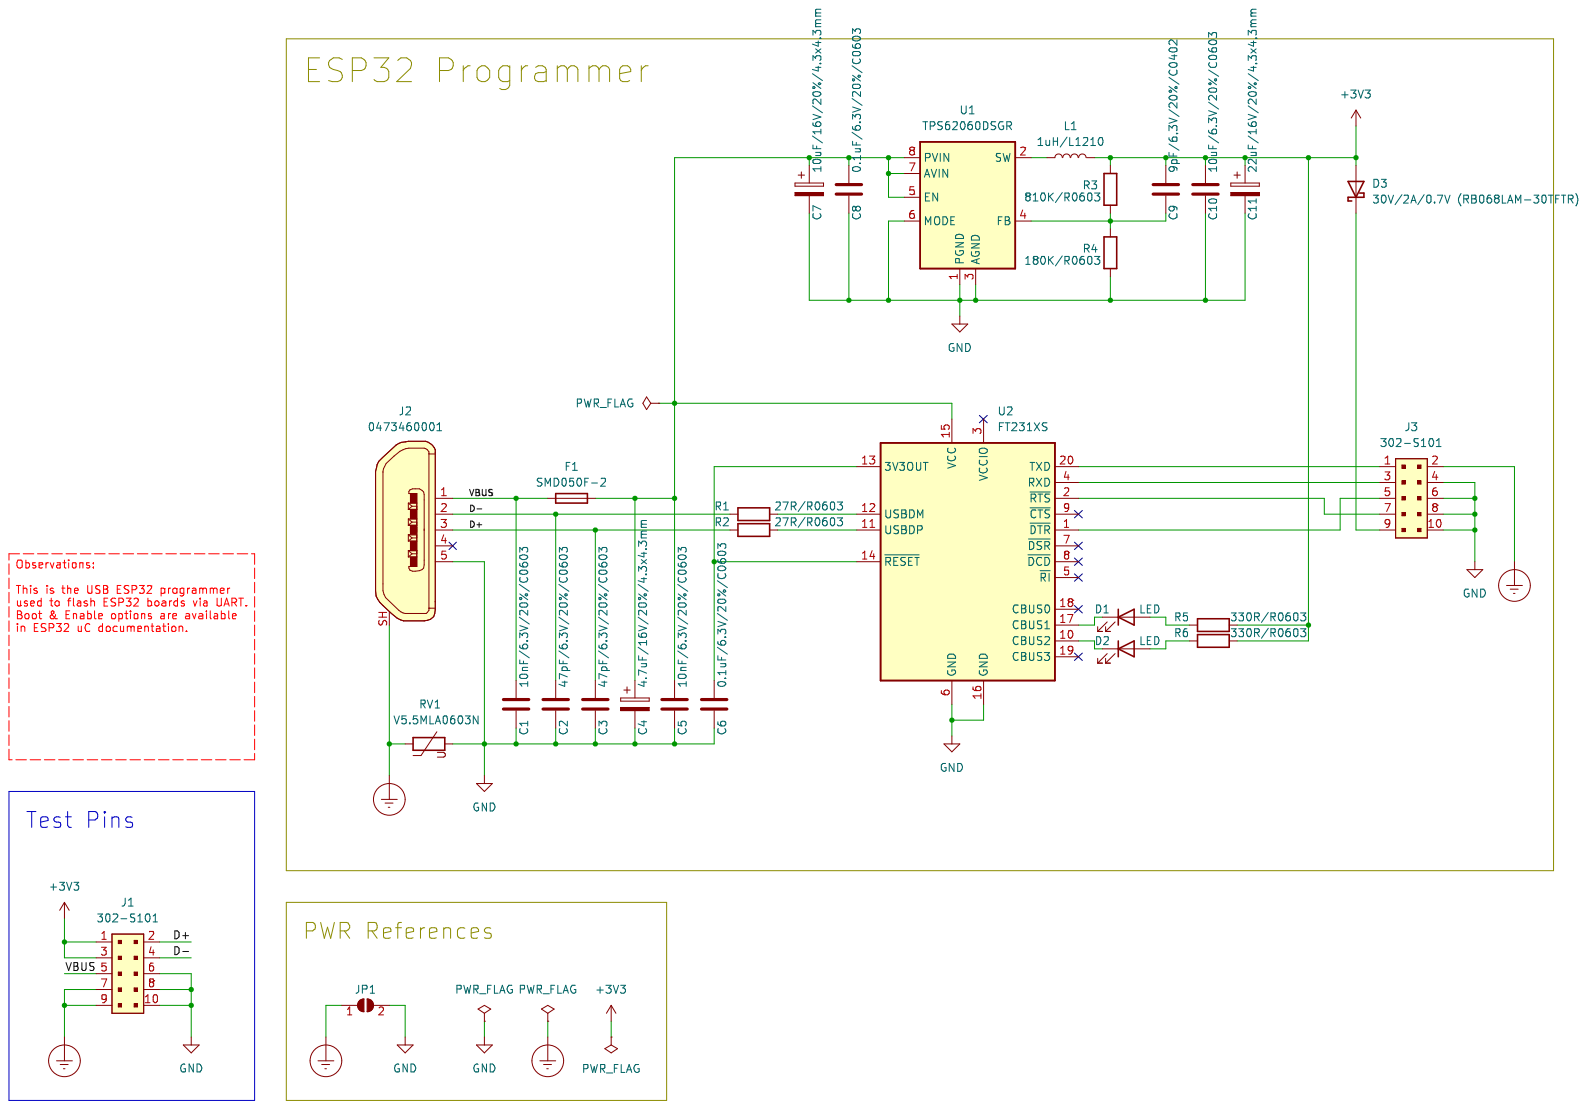
[picture p78: page 1]
