nicolaeandreivasile/plc-embedded-application/board-design/kicad-files/ESP32-PLC-programmer/schematic-simple-mono.pdf

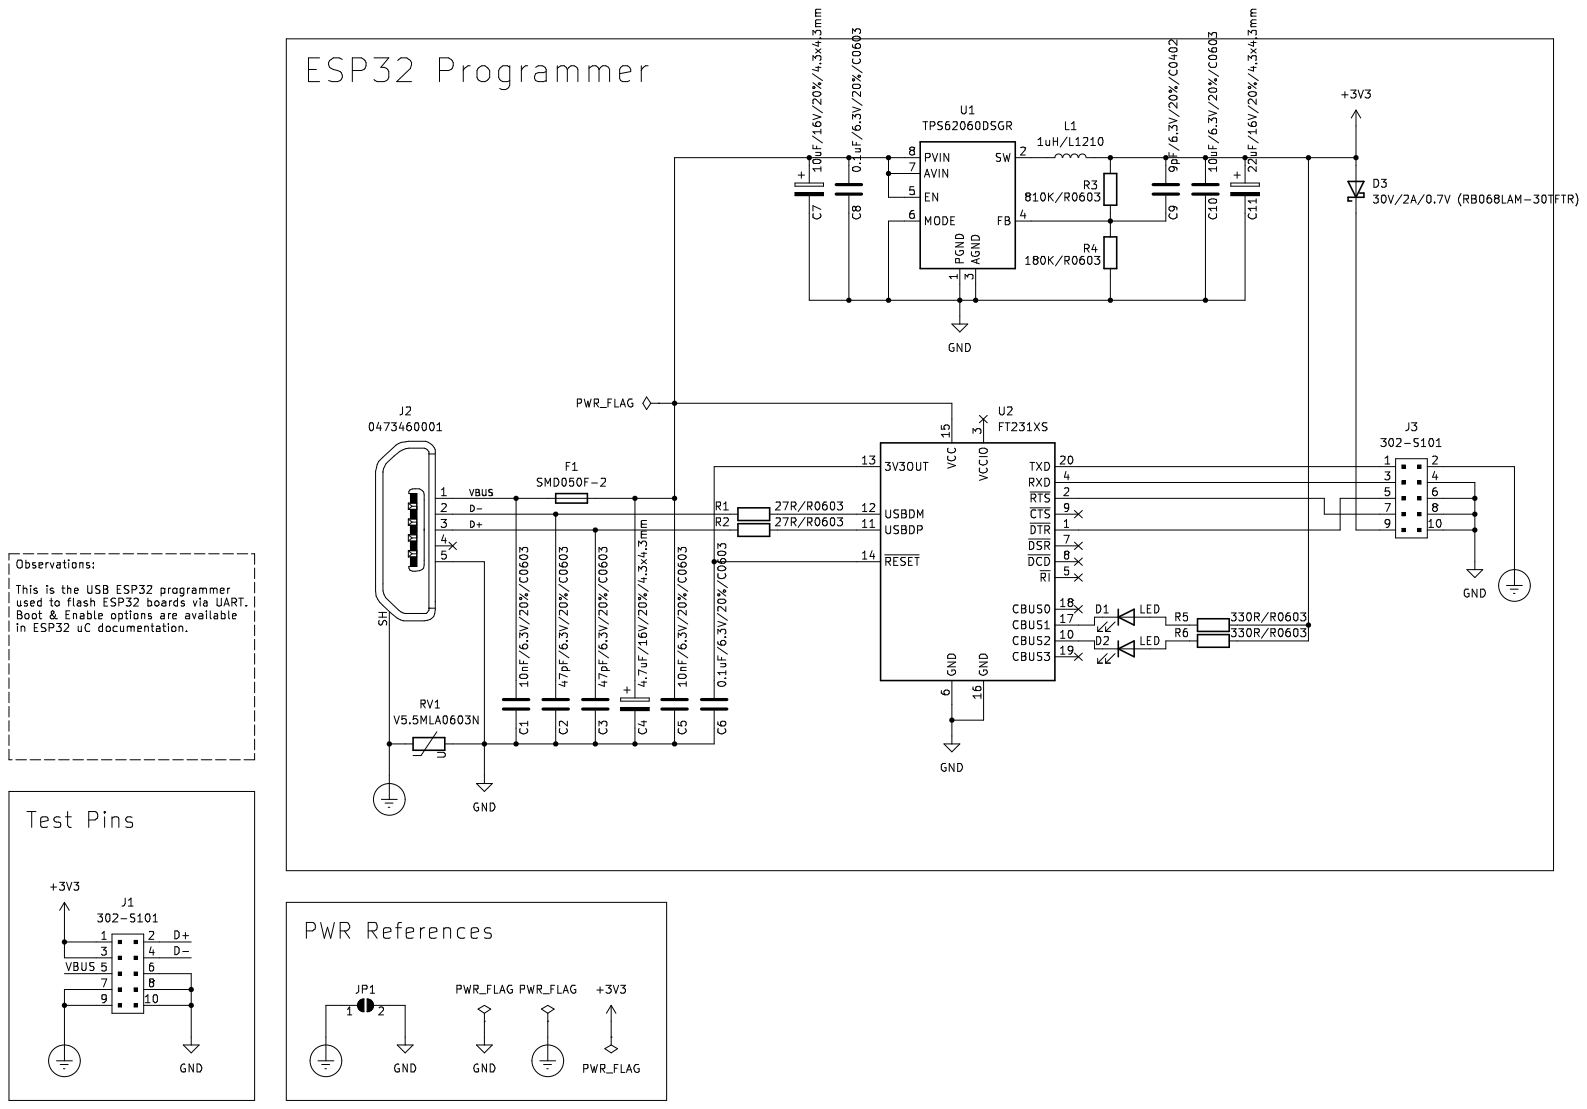
[picture p79: page 1]
