nicolaeandreivasile/plc-embedded-application/board-design/kicad-files/ESP32-PLC/PCB-bottom.pdf

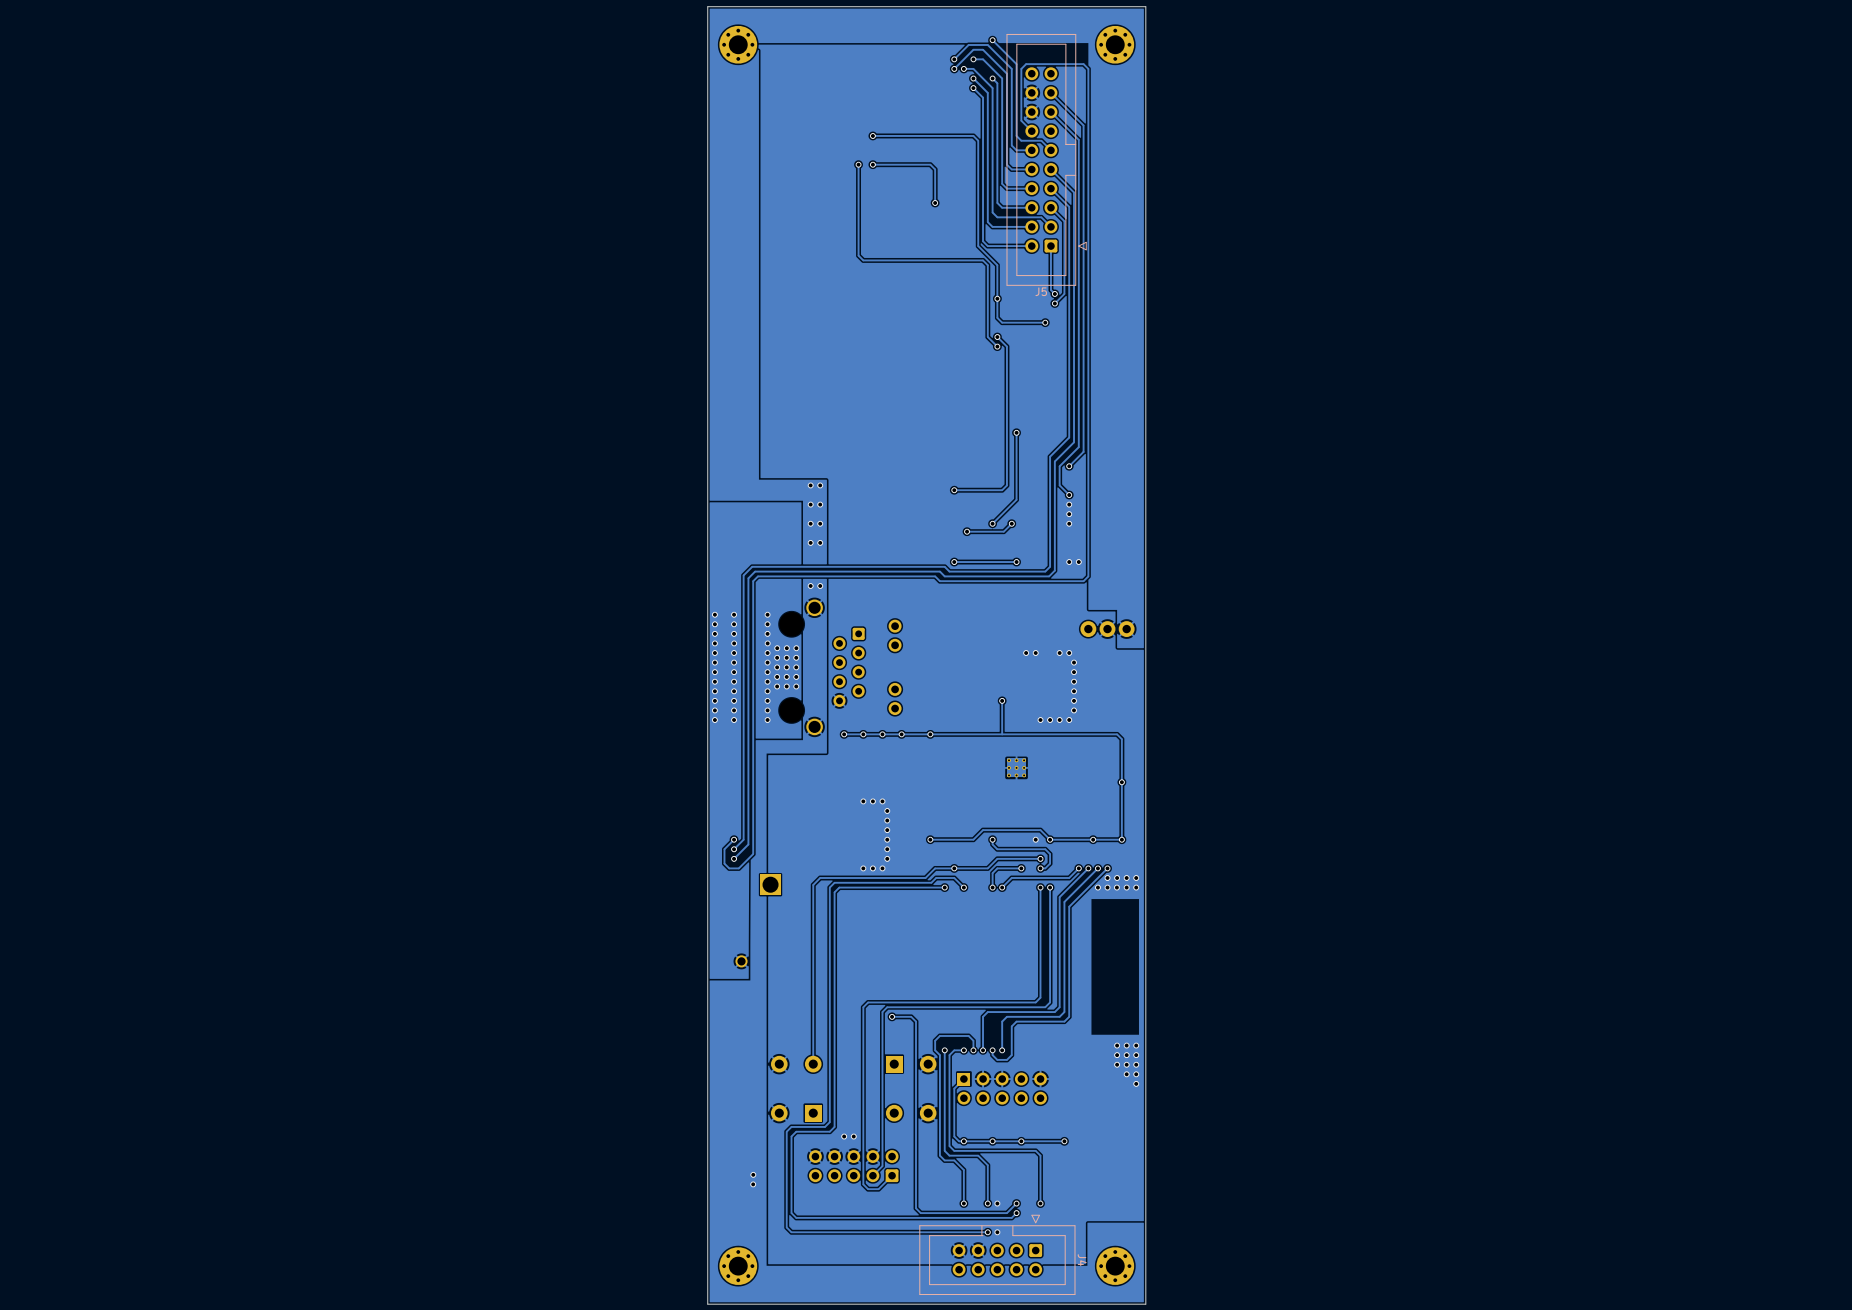
[picture p80: page 1]
