nicolaeandreivasile/plc-embedded-application/board-design/kicad-files/ESP32-PLC/PCB-top.pdf

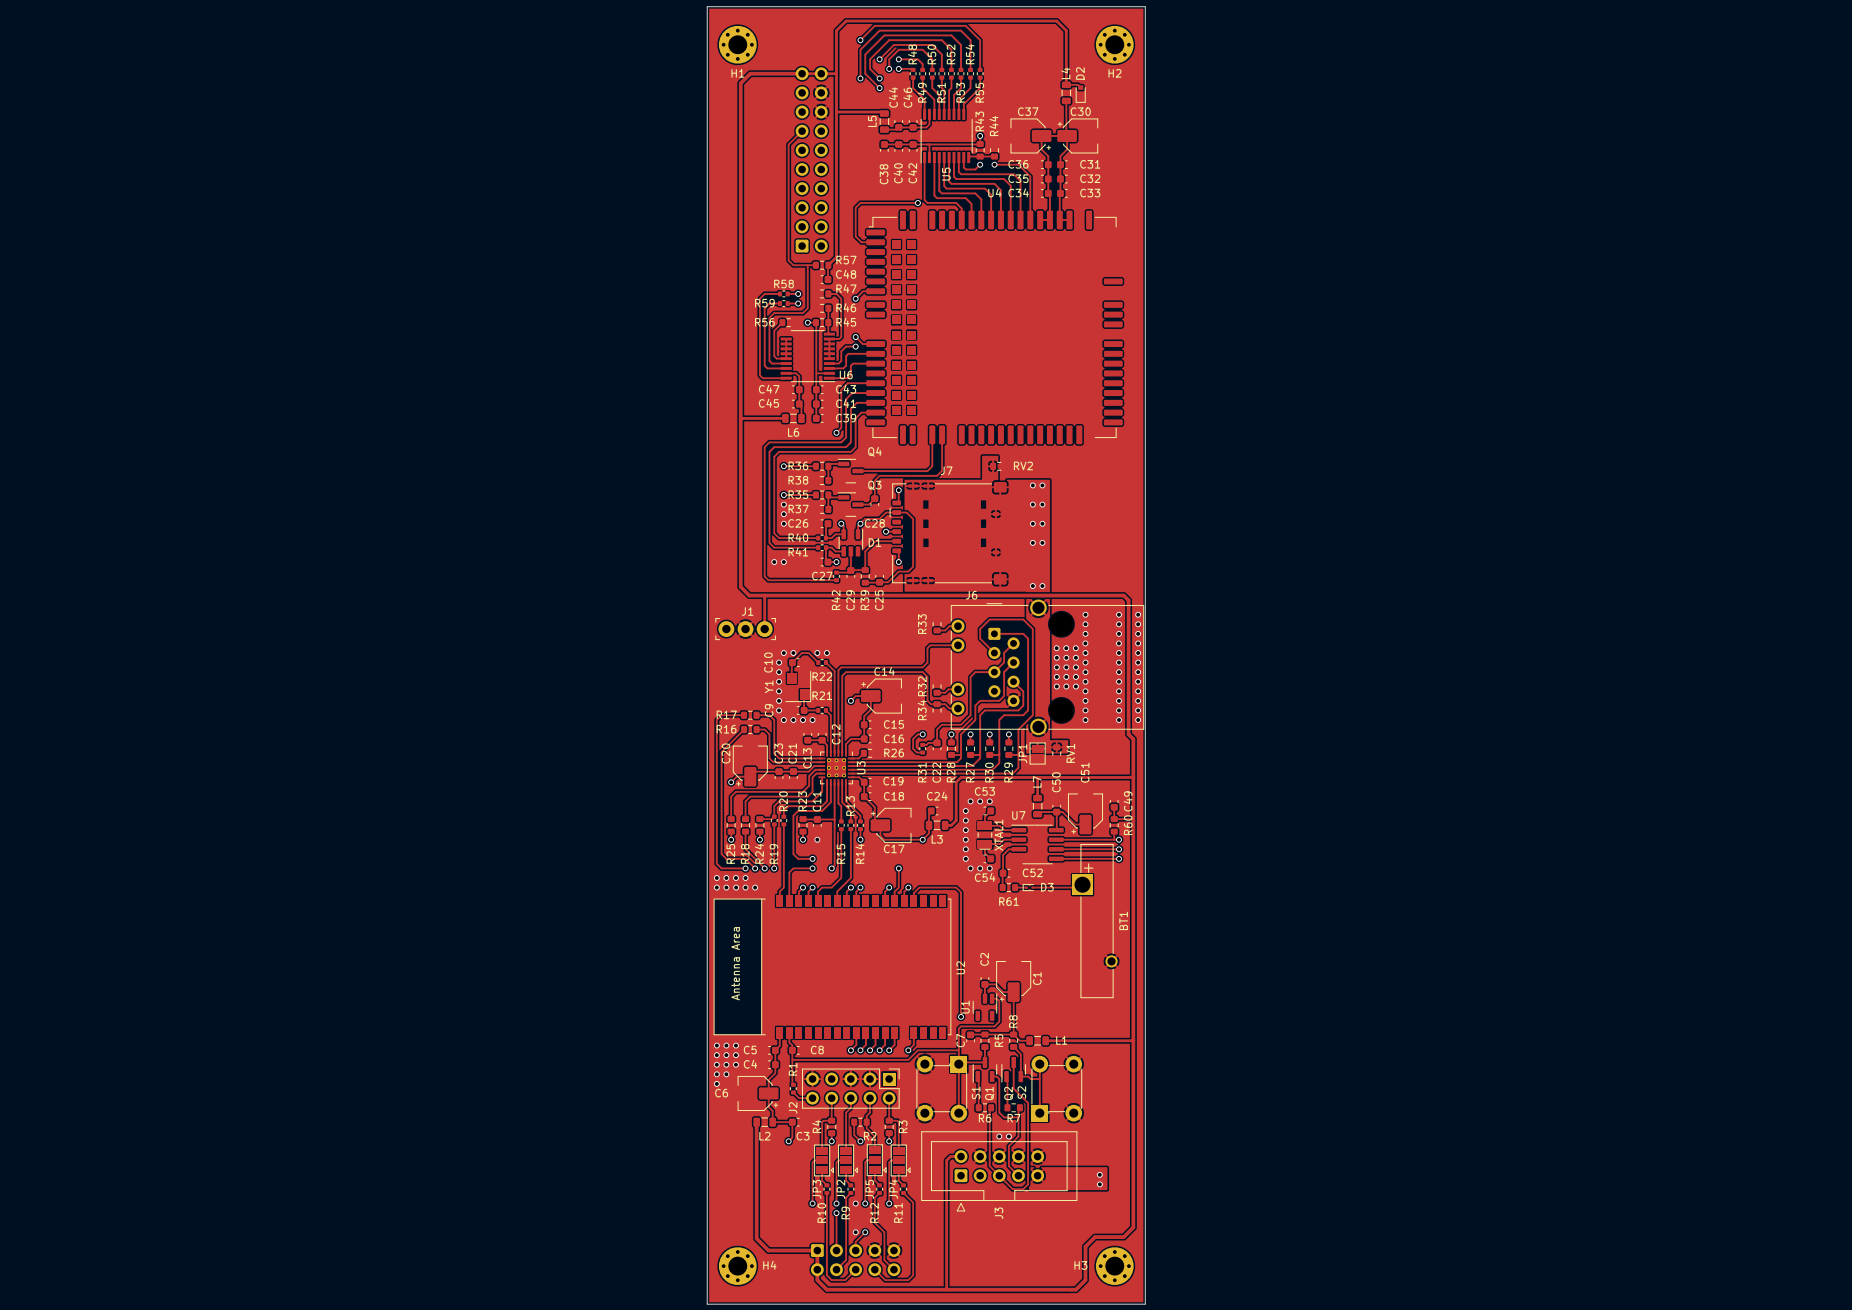
[picture p81: page 1]
