nicolaeandreivasile/plc-embedded-application/board-design/kicad-files/ESP32-PLC/schematic-sheet-color.pdf

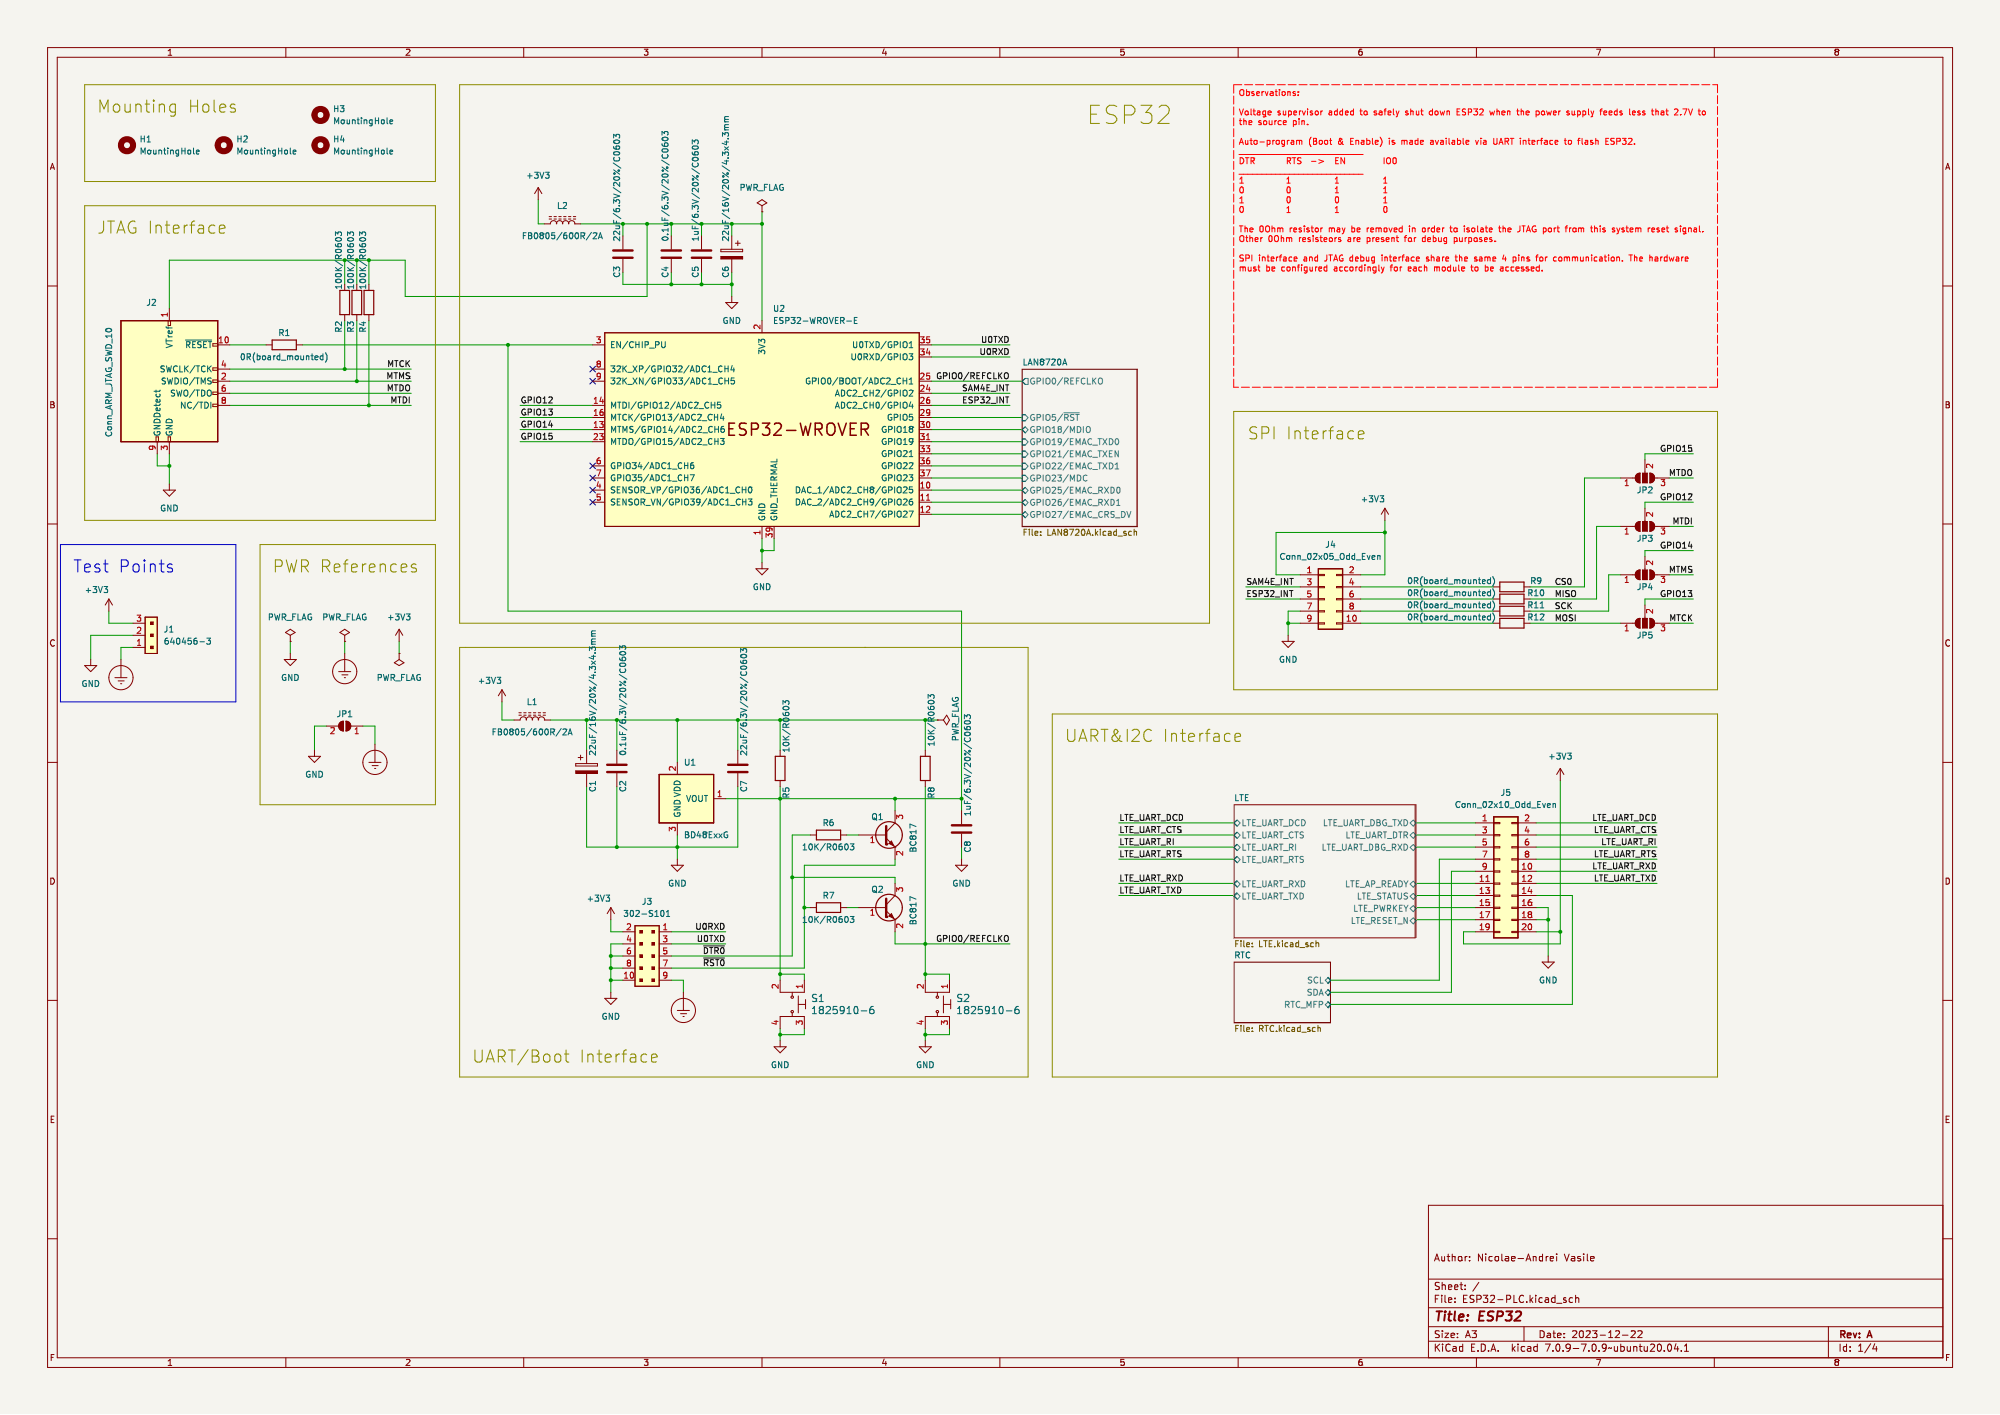
[picture p82: page 1]

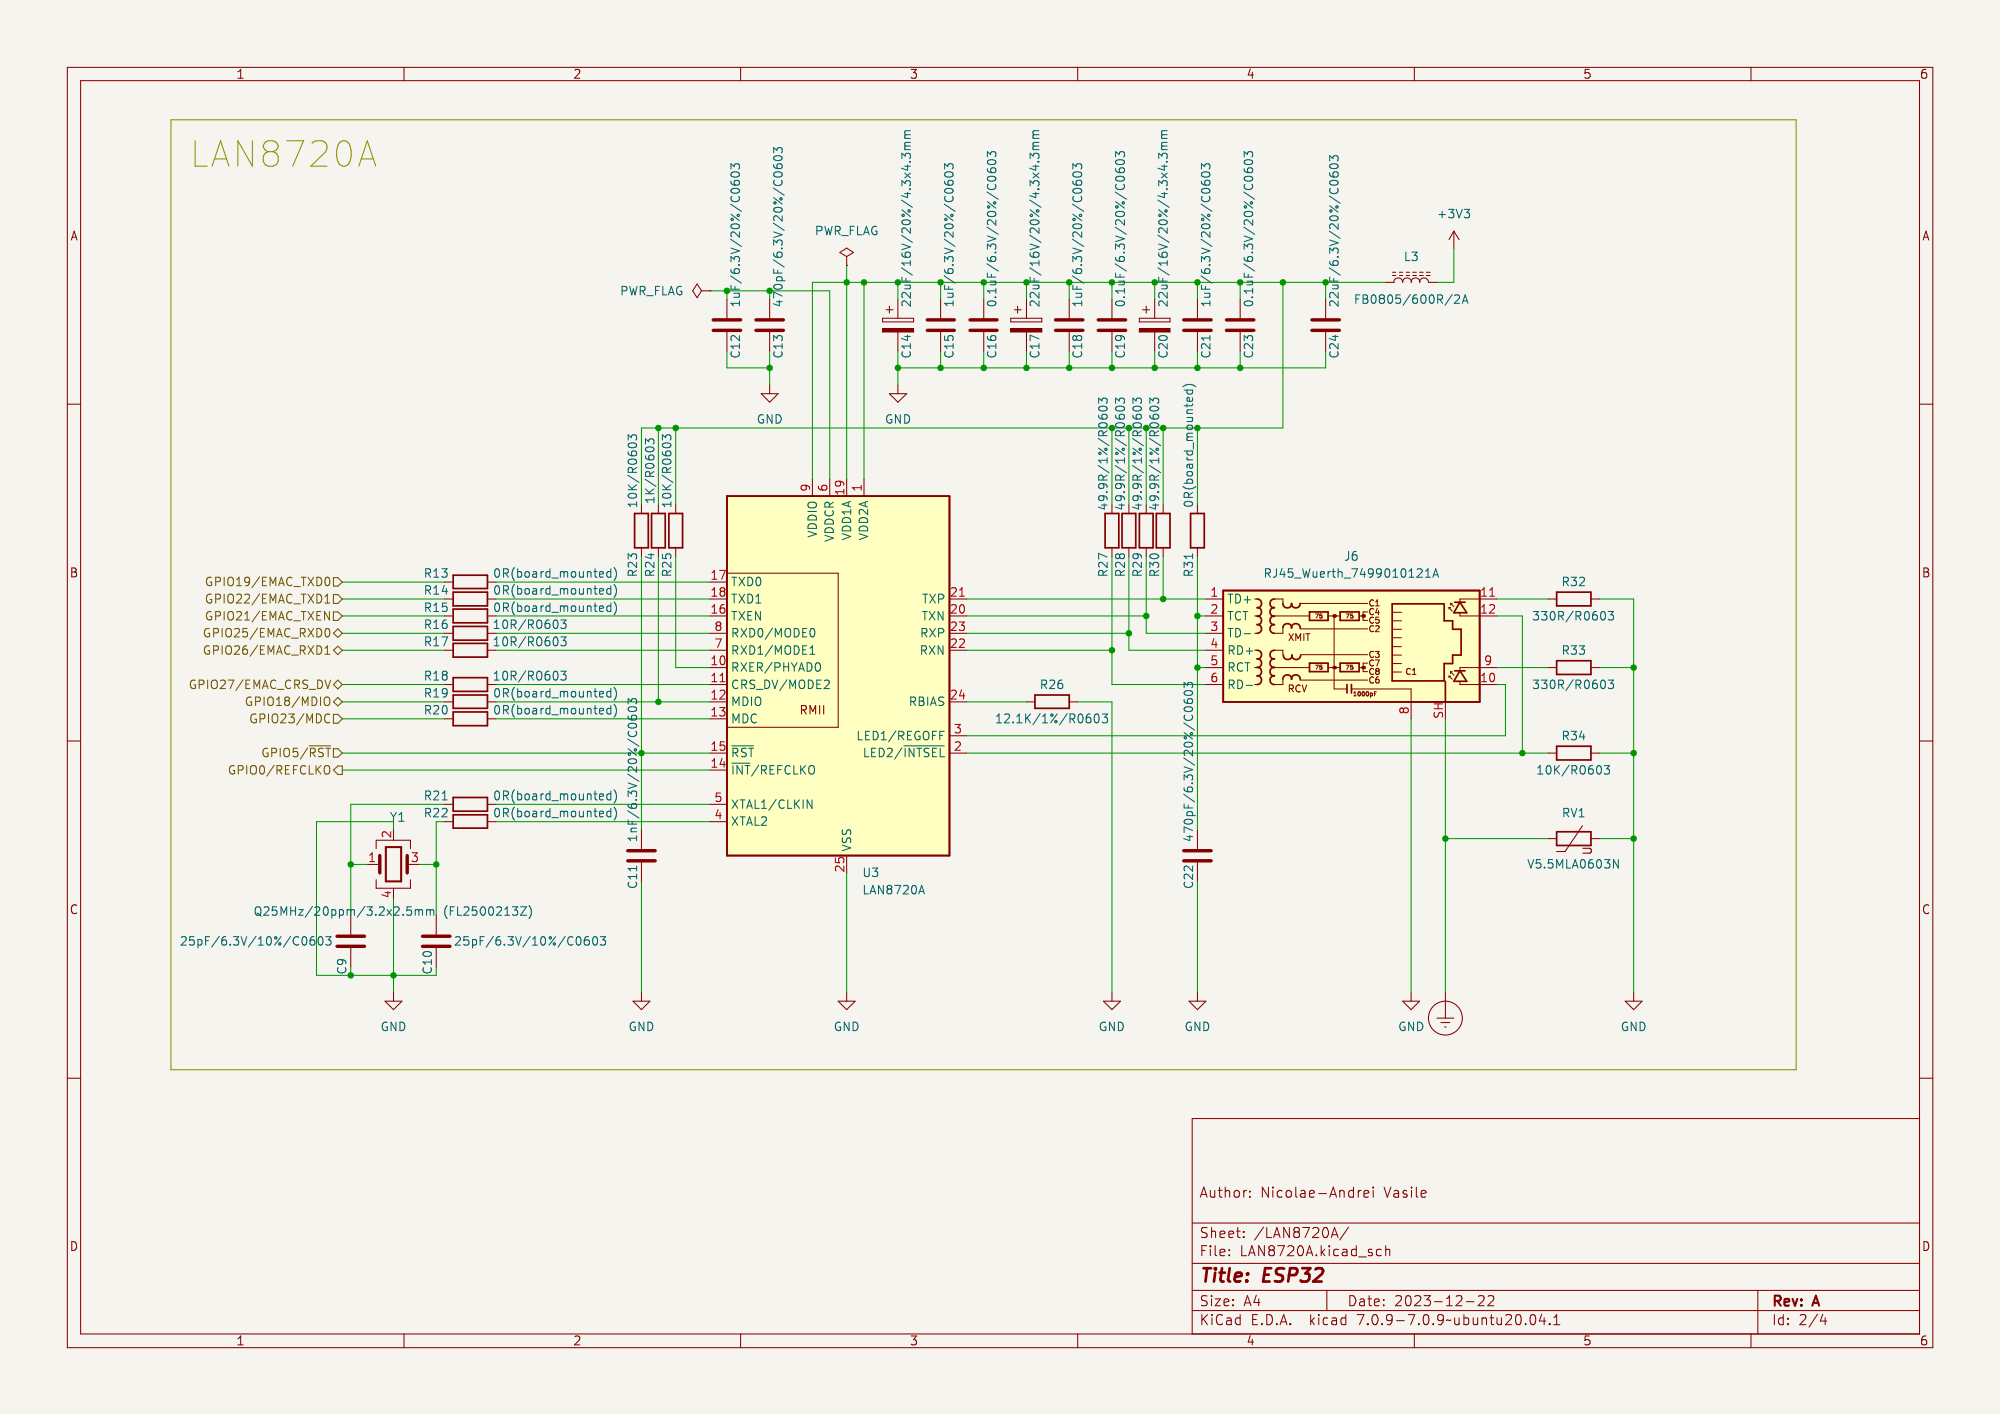
[picture p83: page 2]

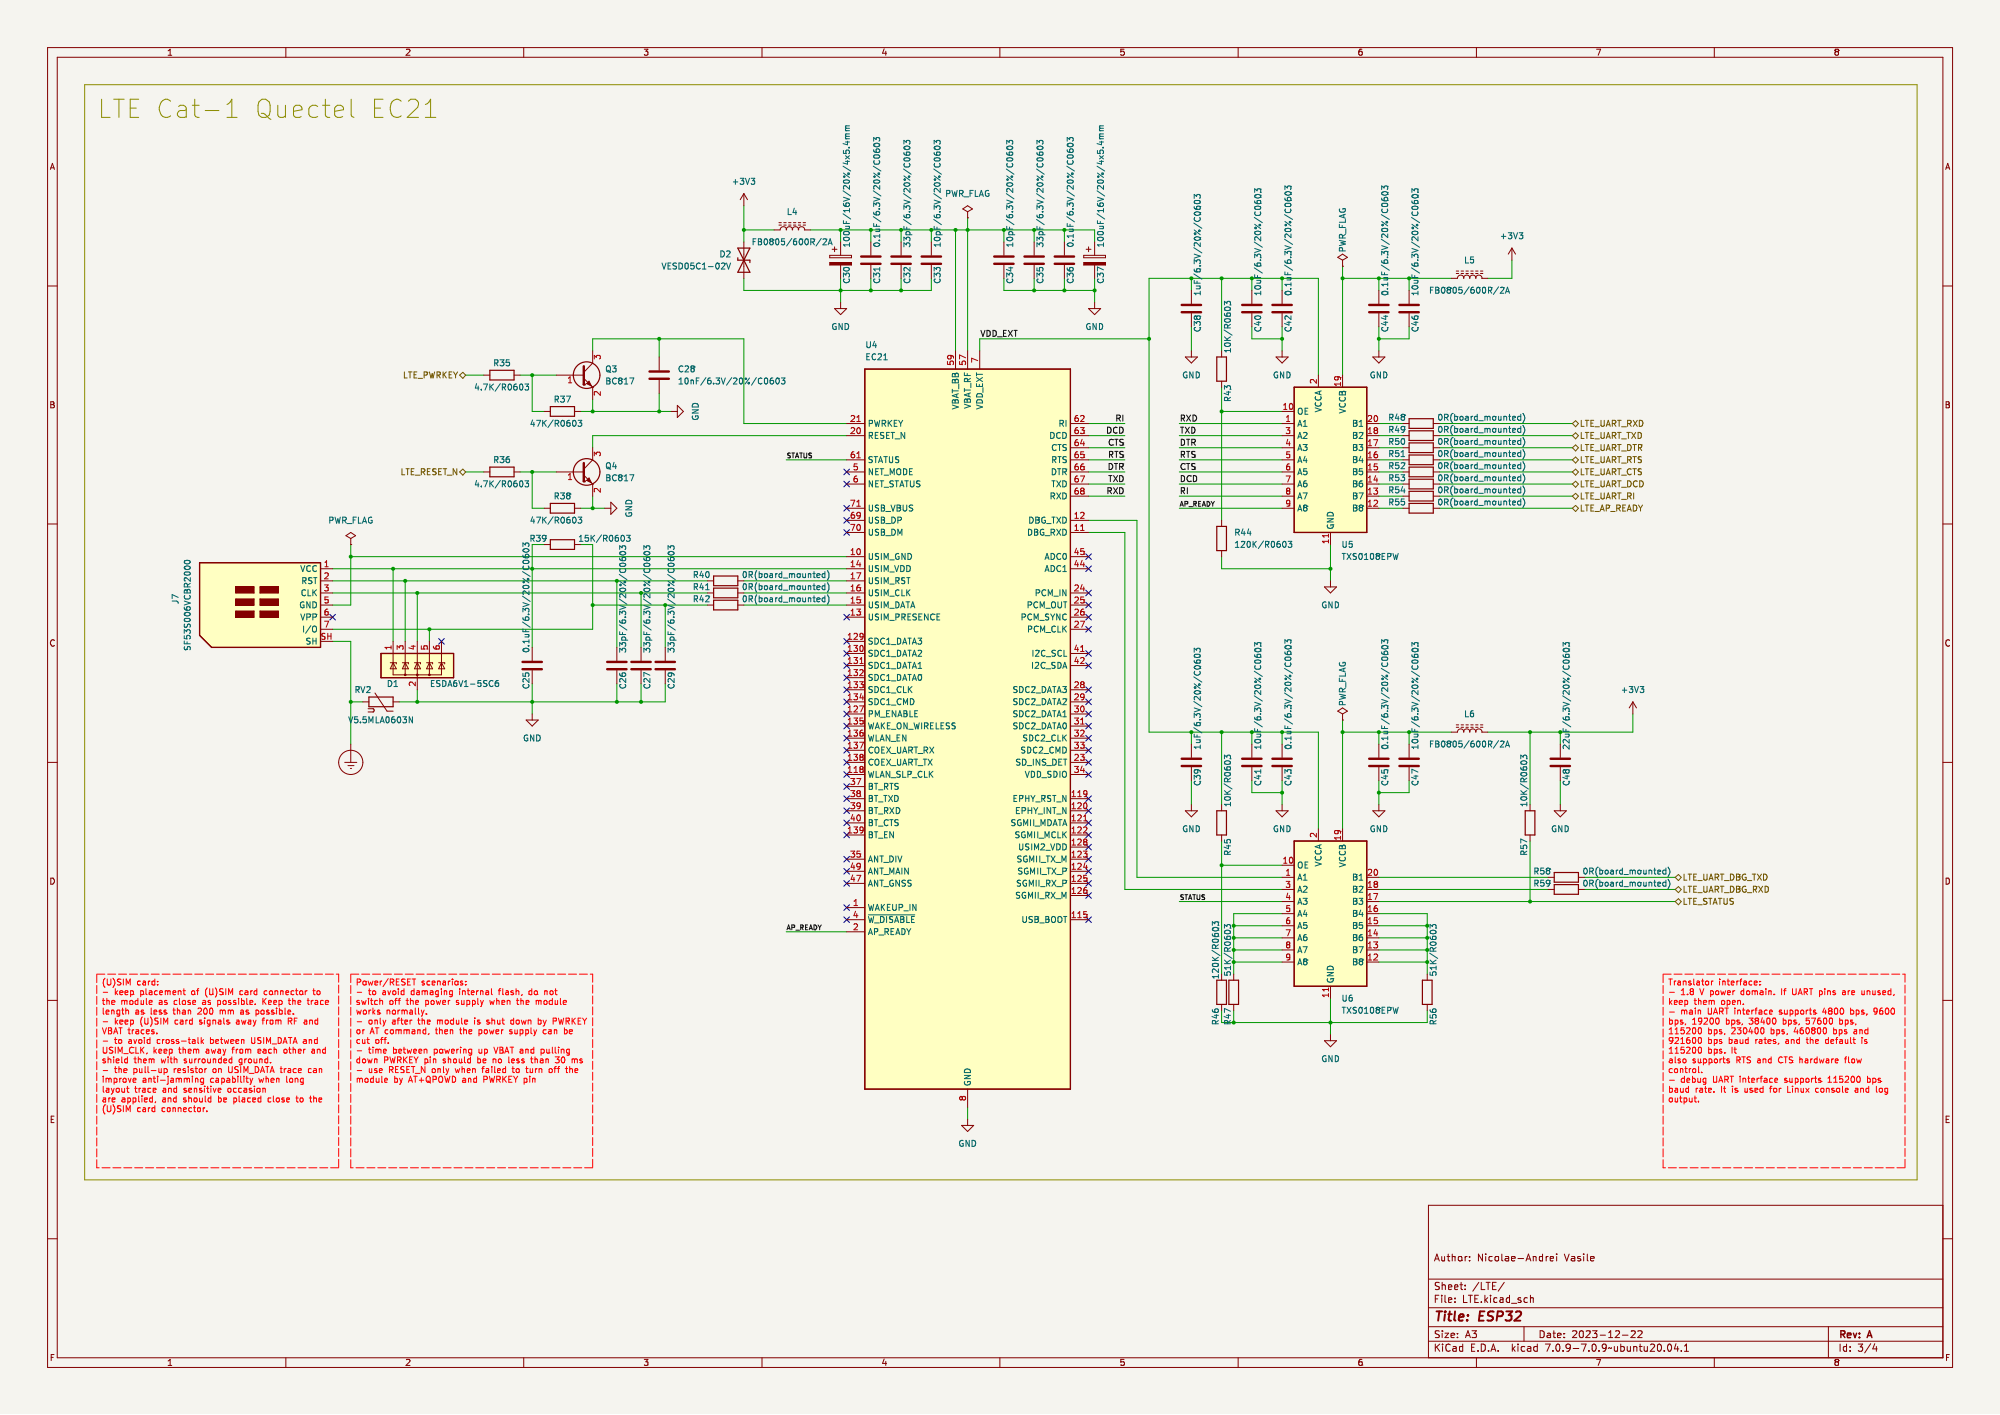
[picture p84: page 3]

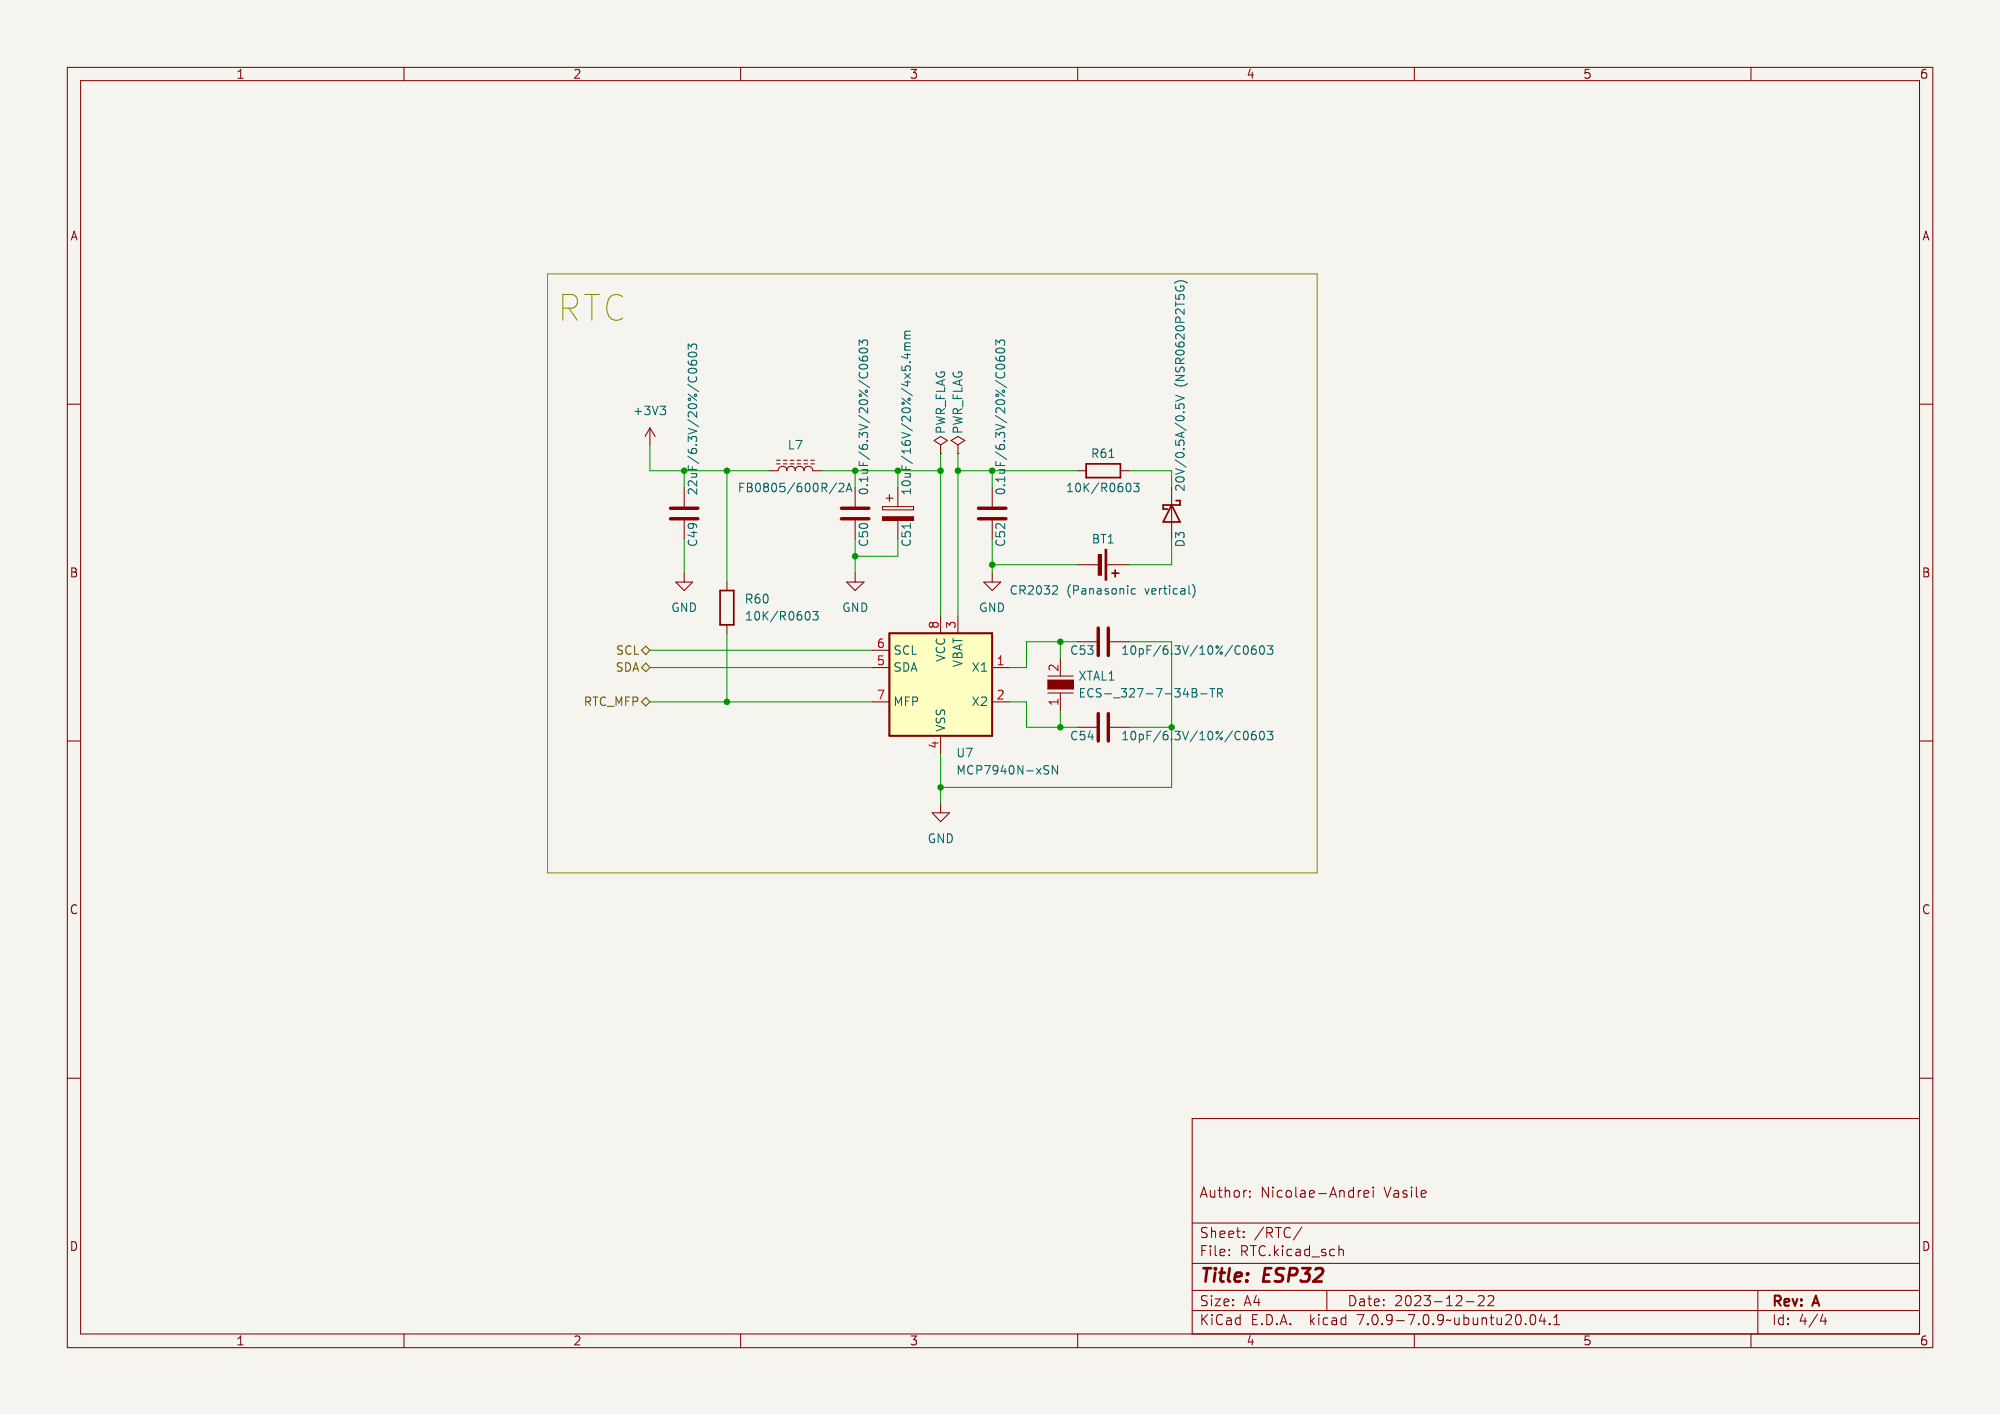
[picture p85: page 4]
