nicolaeandreivasile/plc-embedded-application/board-design/kicad-files/ESP32-PLC/schematic-simple-color.pdf

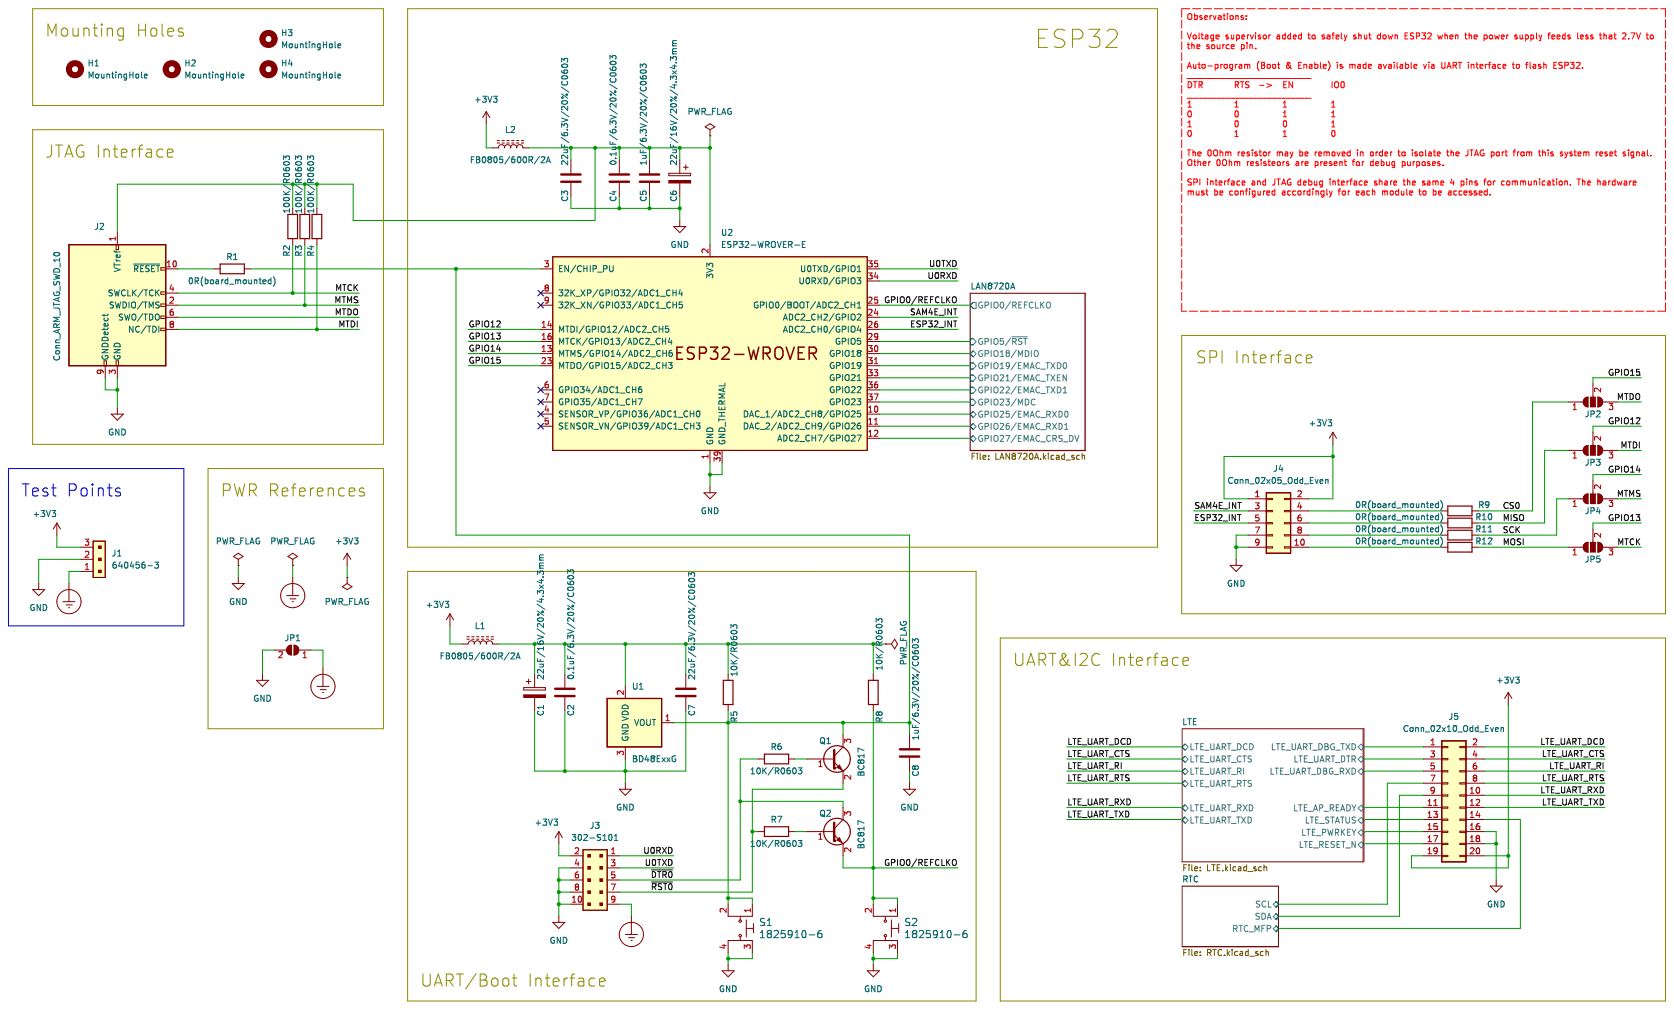
[picture p86: page 1]

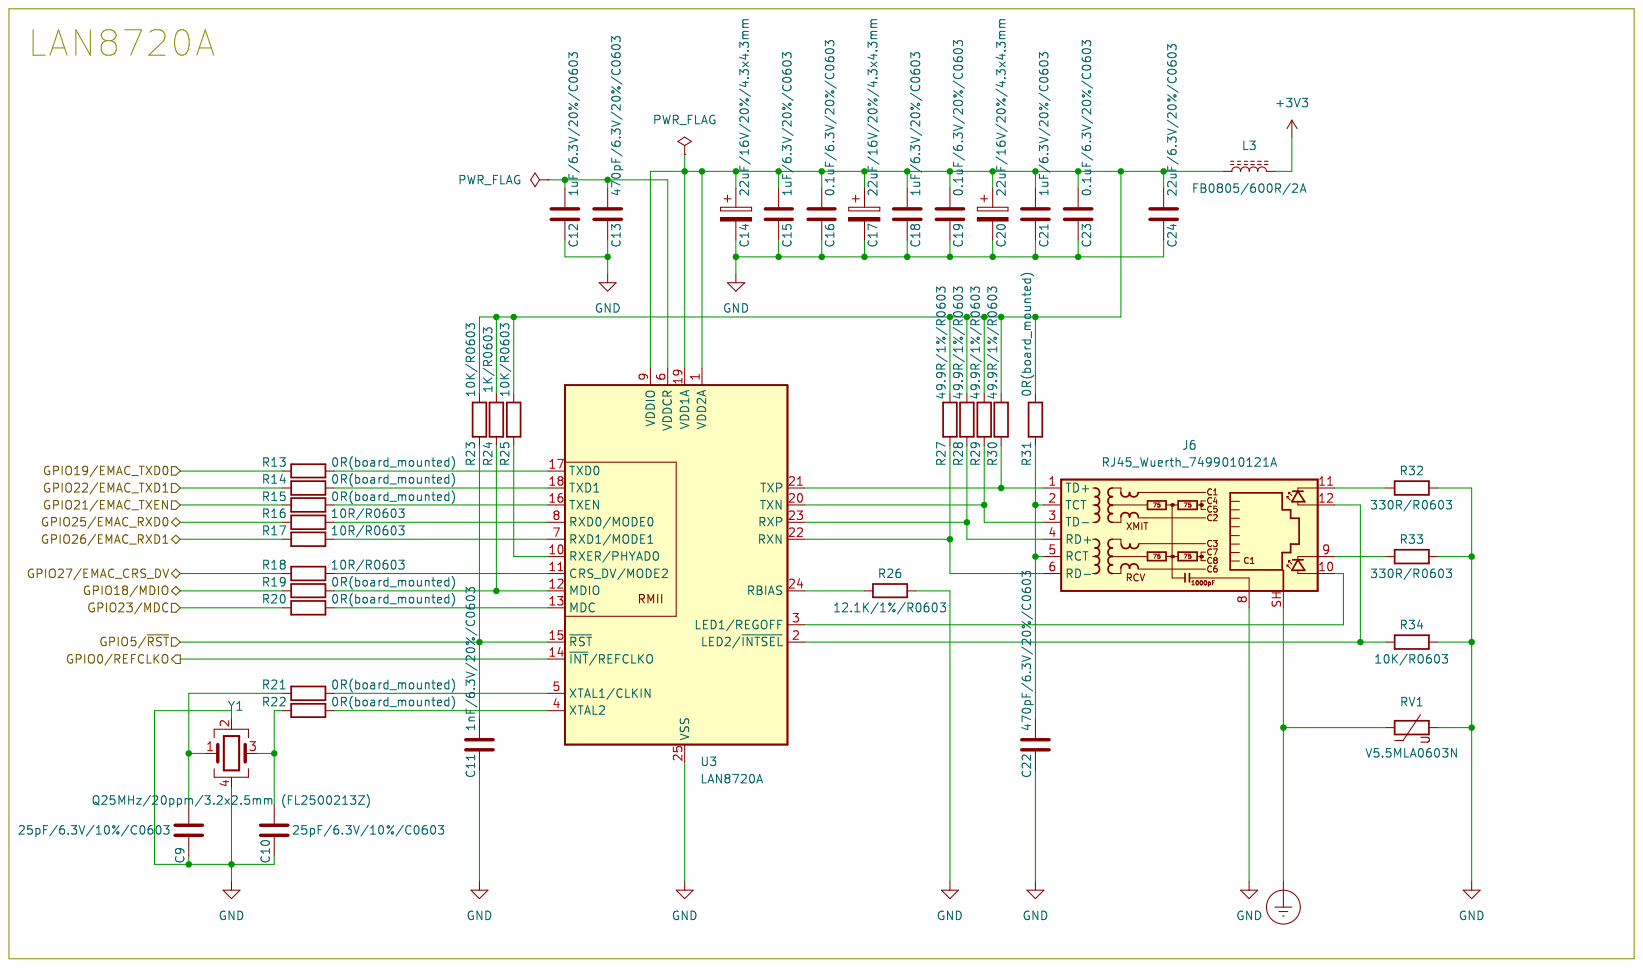
[picture p87: page 2]

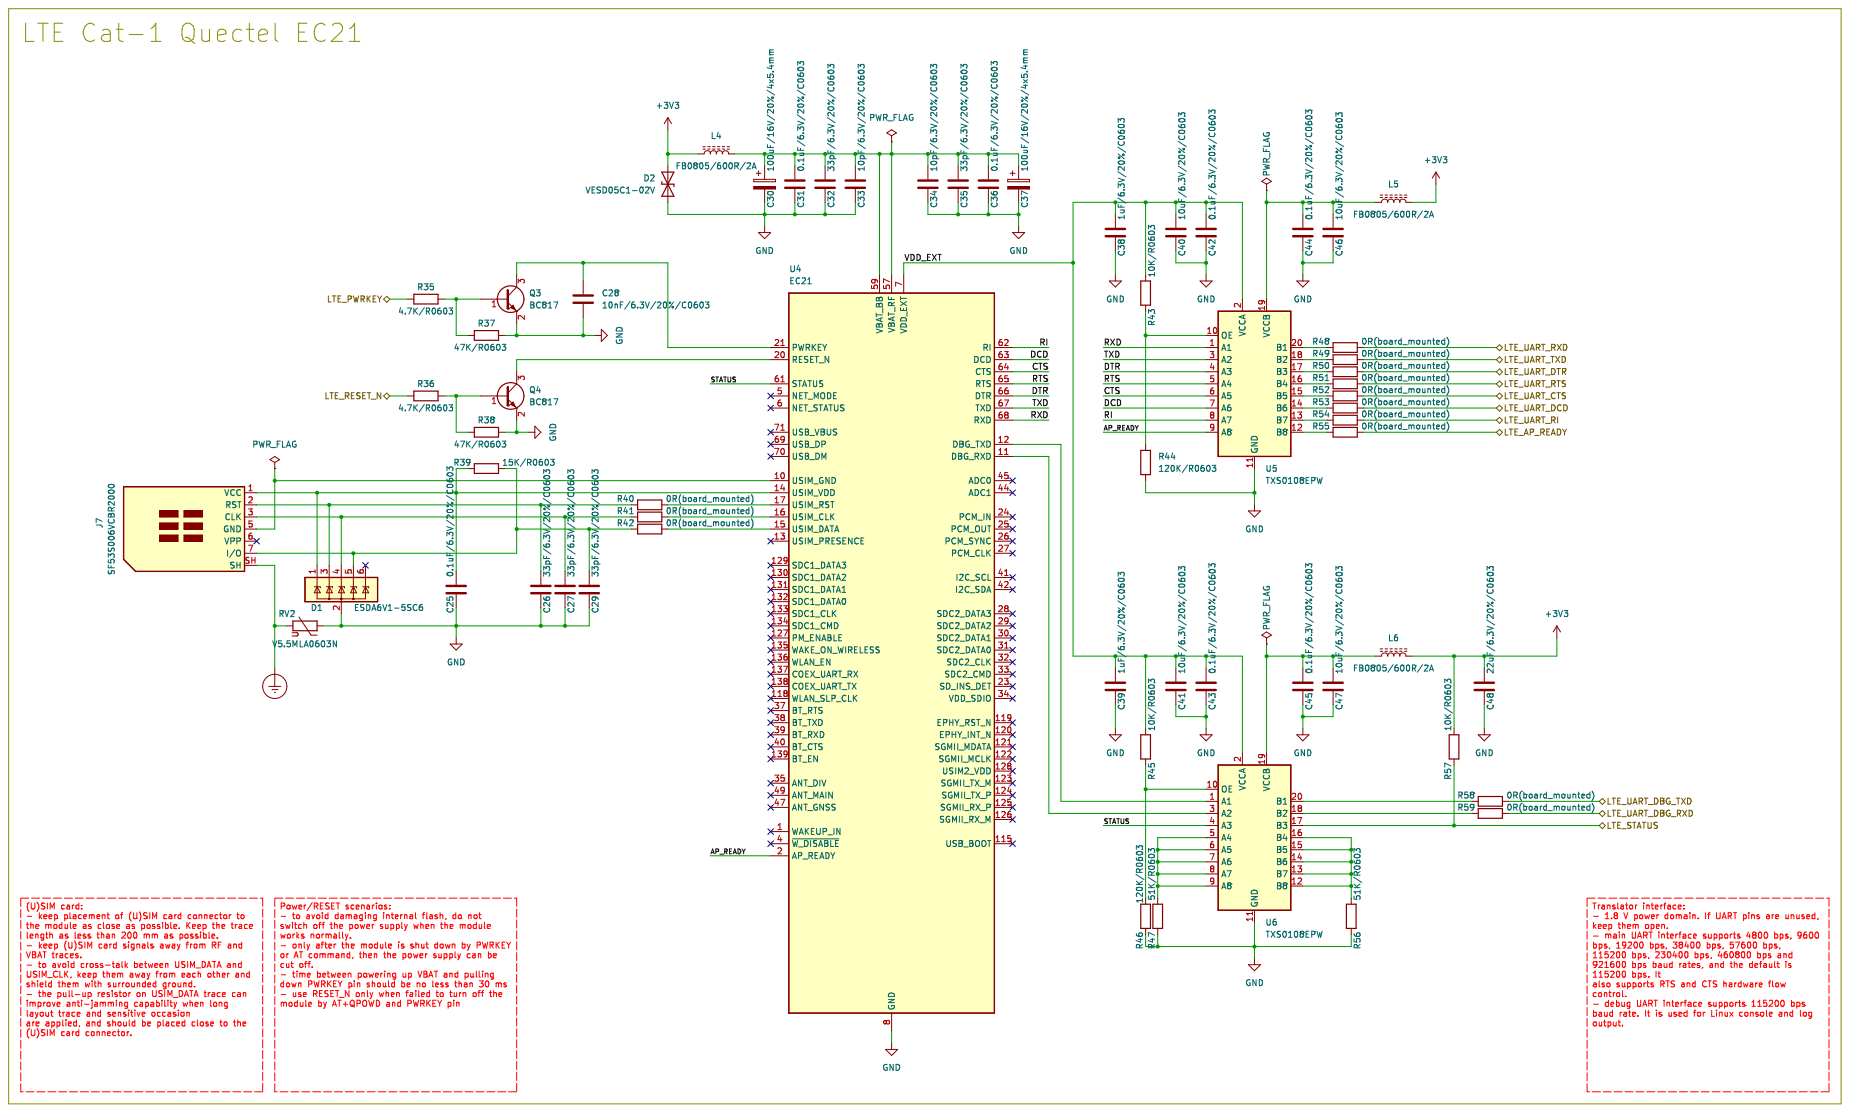
[picture p88: page 3]

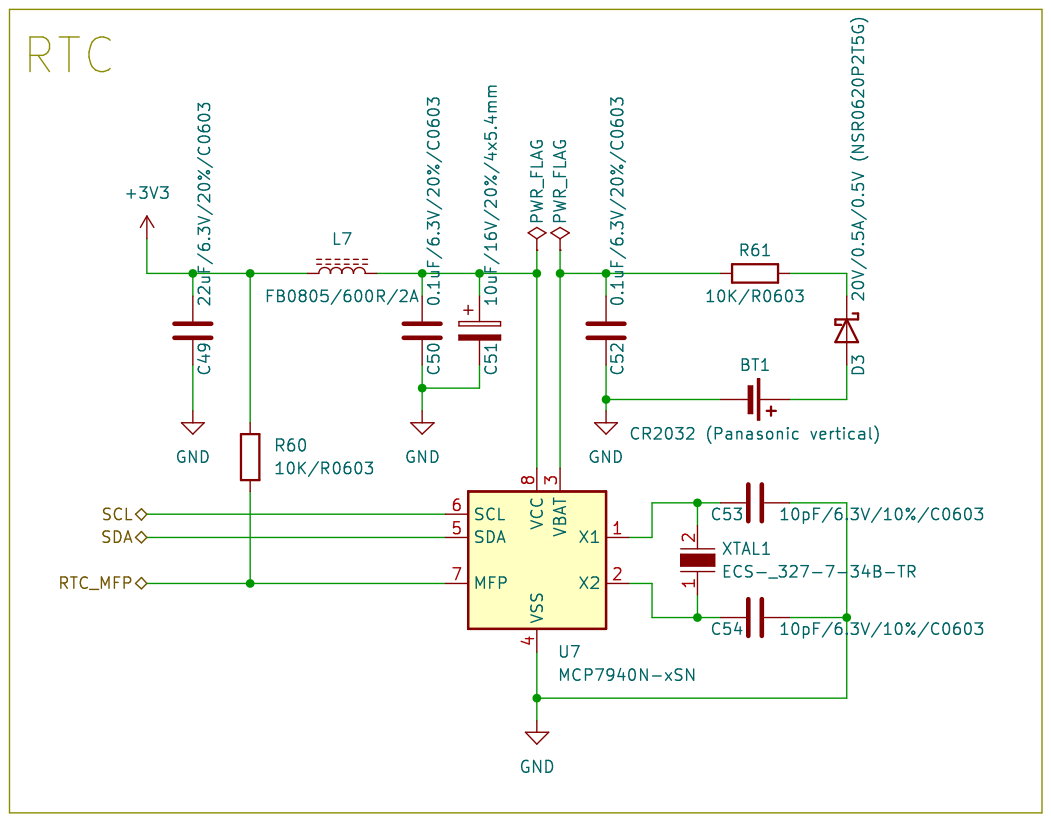
[picture p89: page 4]
