nicolaeandreivasile/plc-embedded-application/board-design/kicad-files/ESP32-PLC/schematic-simple-mono.pdf

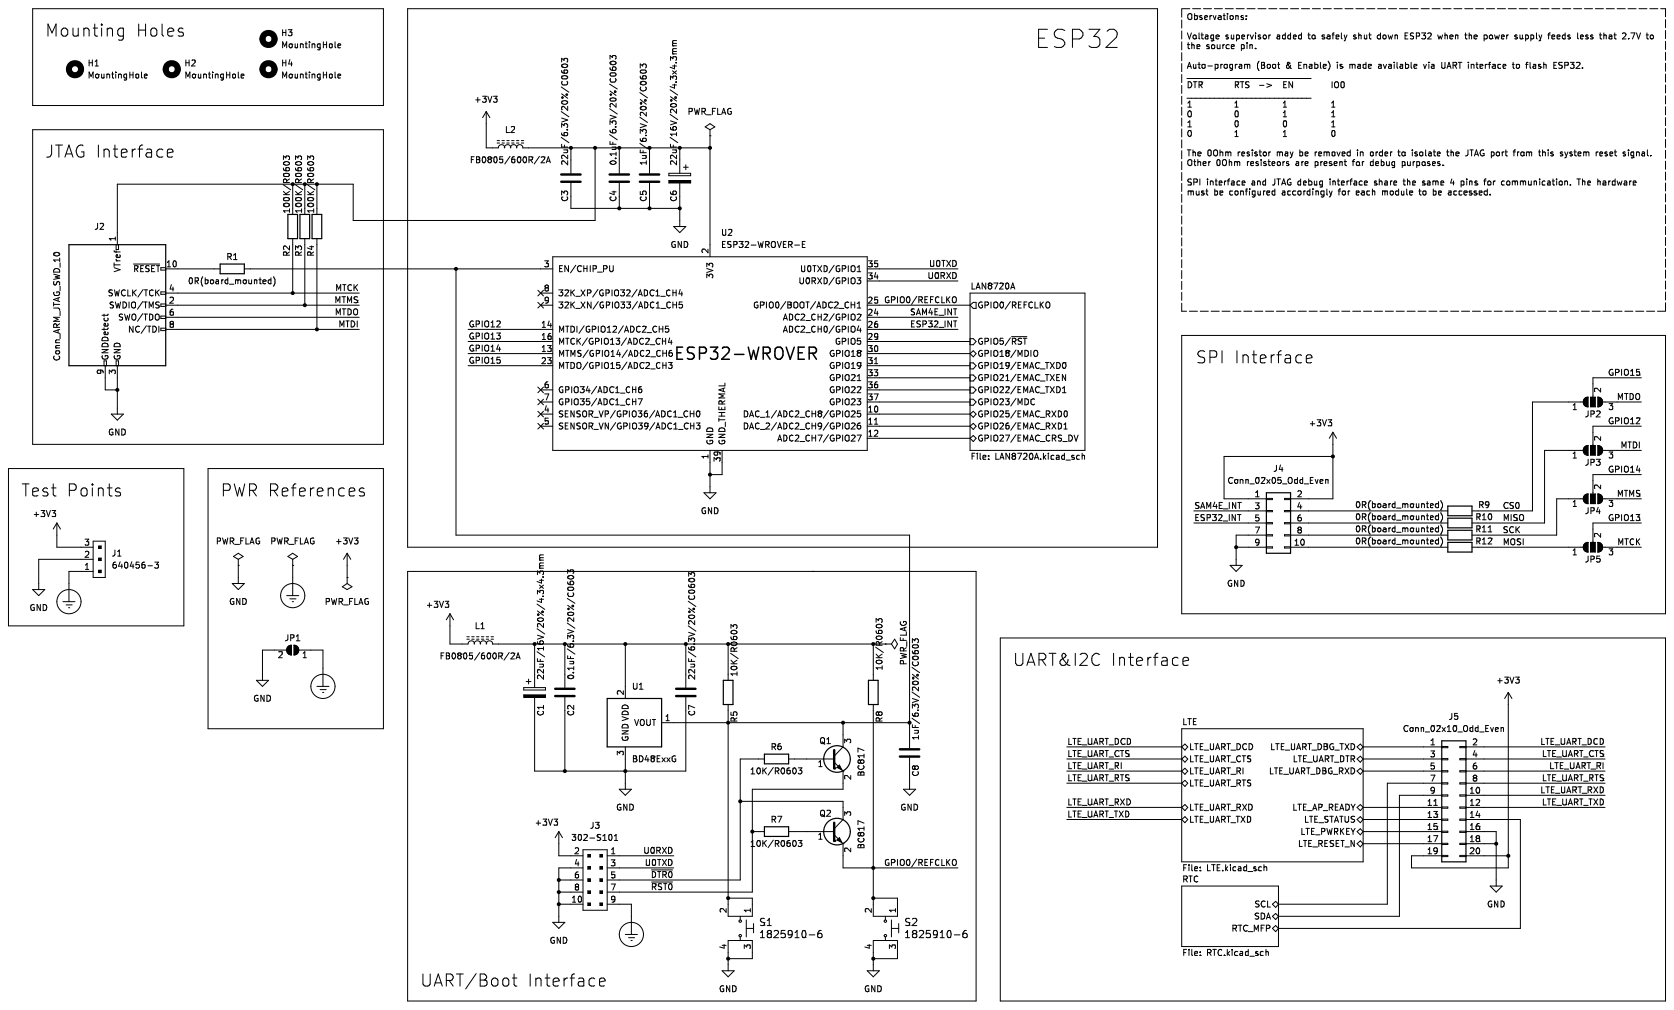
[picture p90: page 1]

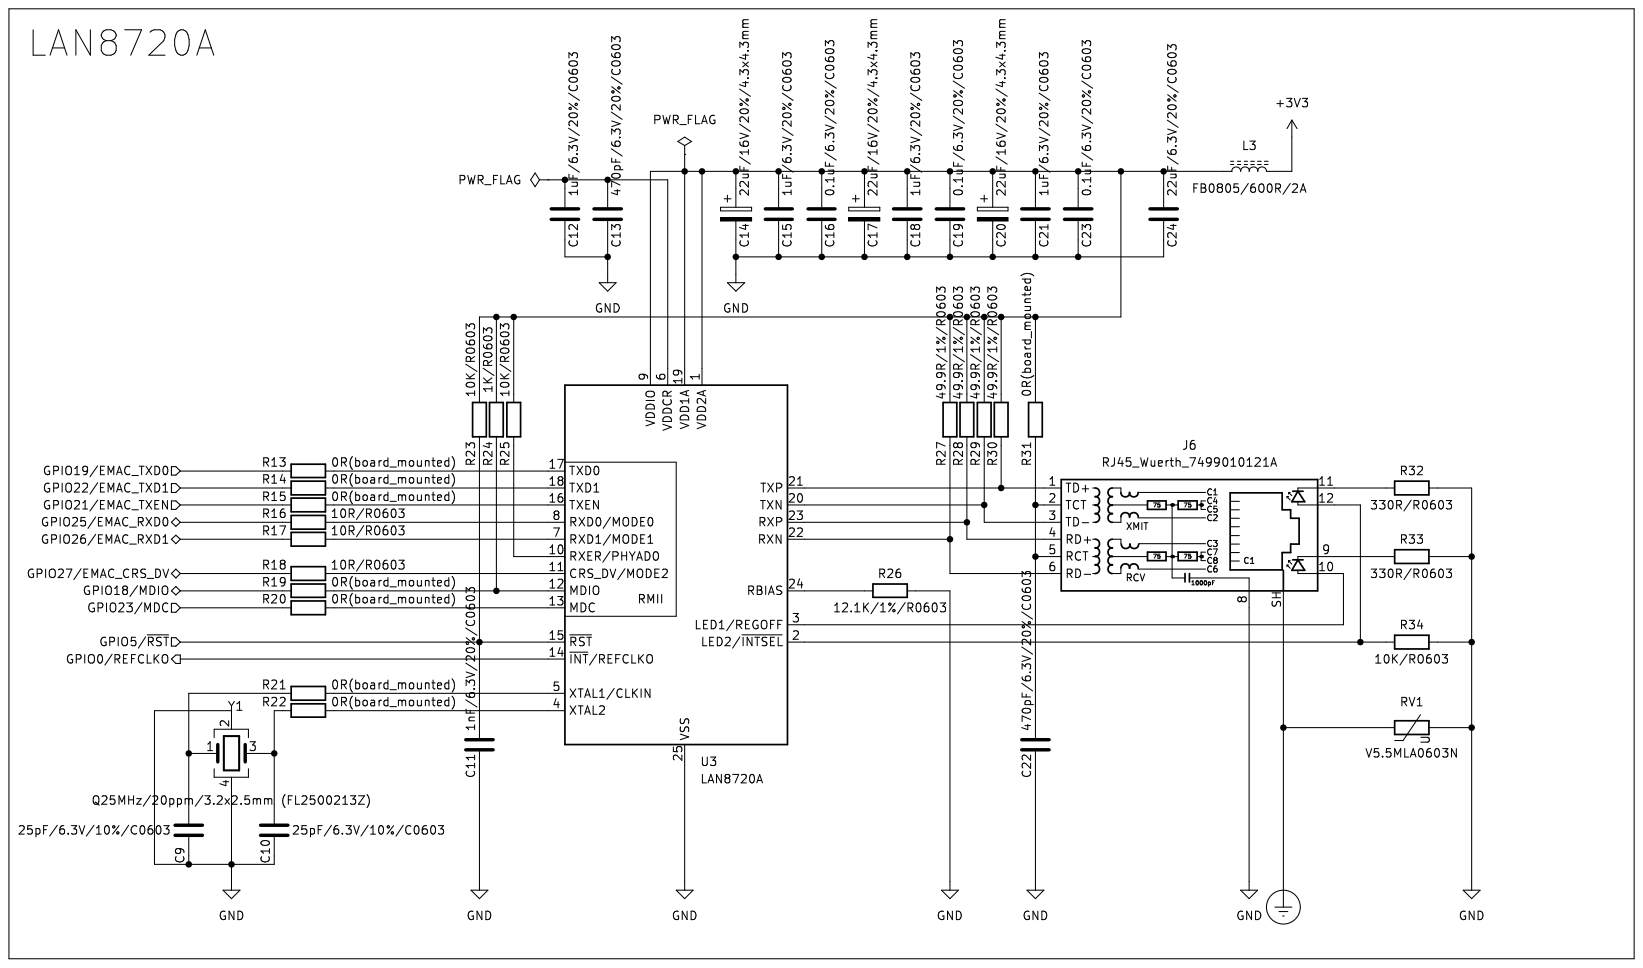
[picture p91: page 2]

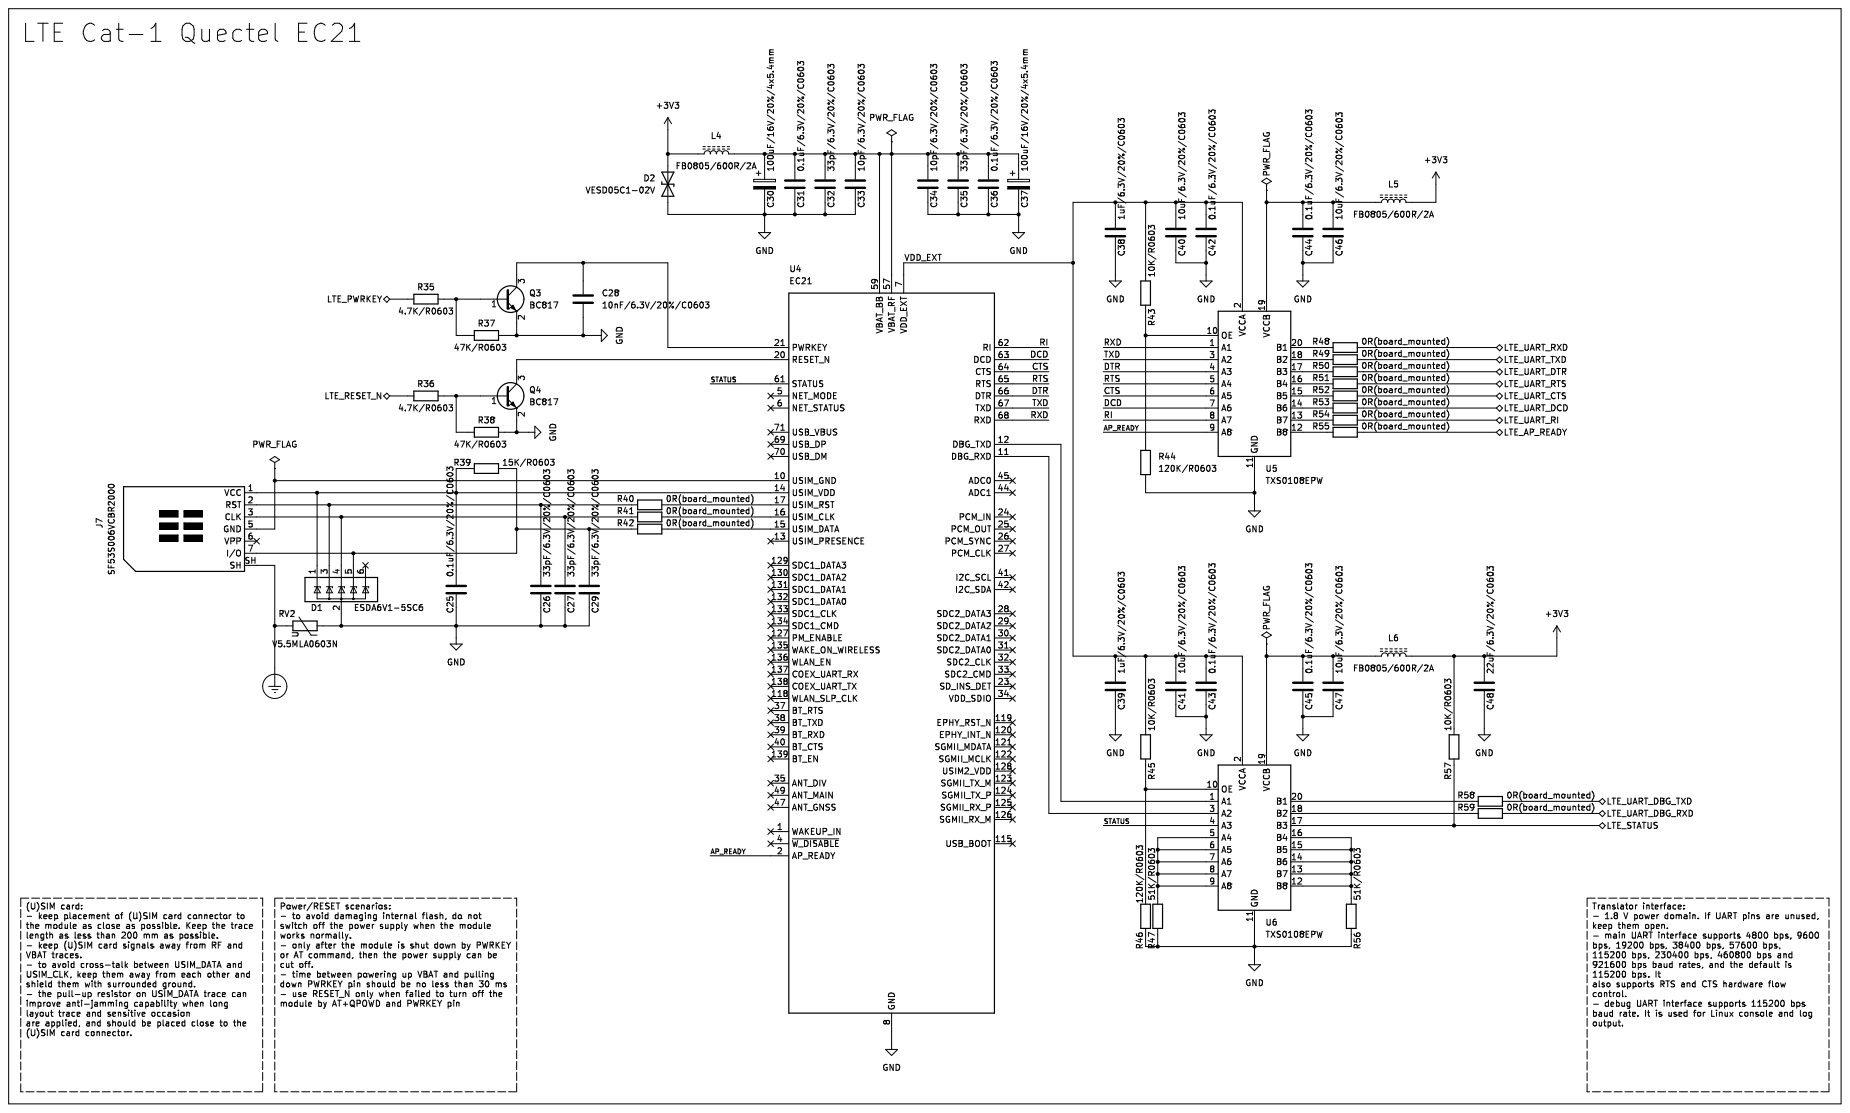
[picture p92: page 3]

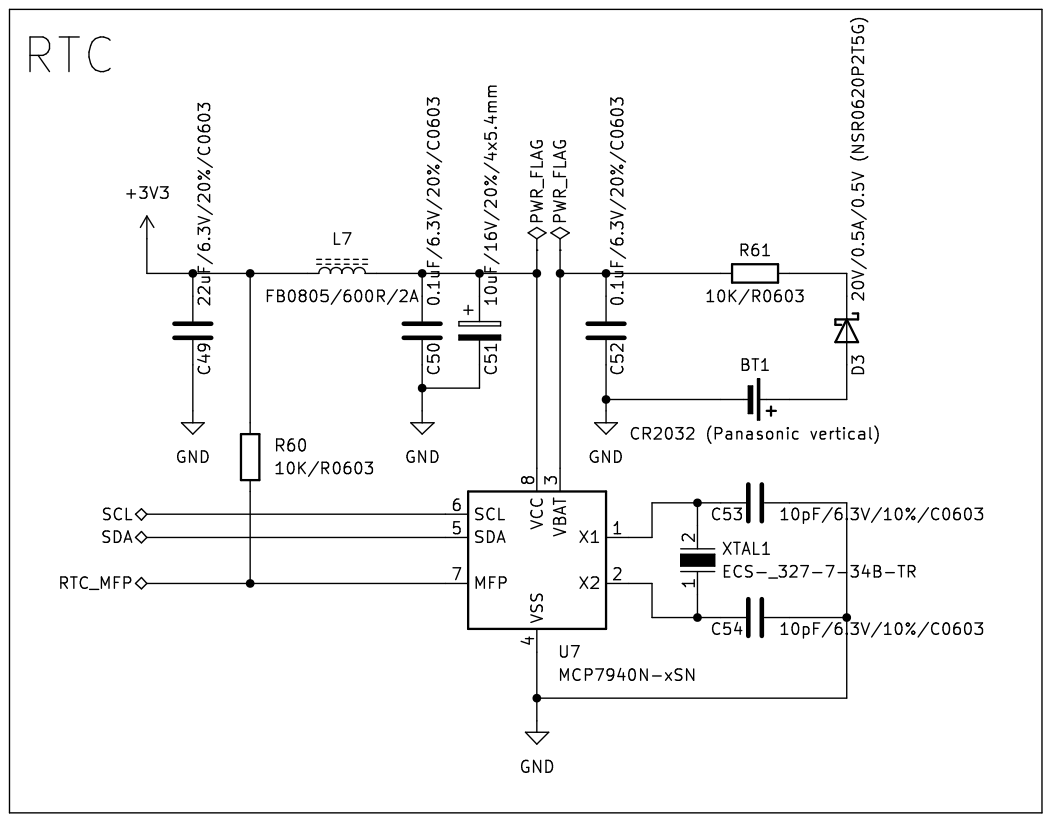
[picture p93: page 4]
