nicolaeandreivasile/plc-embedded-application/board-design/kicad-files/SAM4E-PLC/schematic-sheet-color.pdf

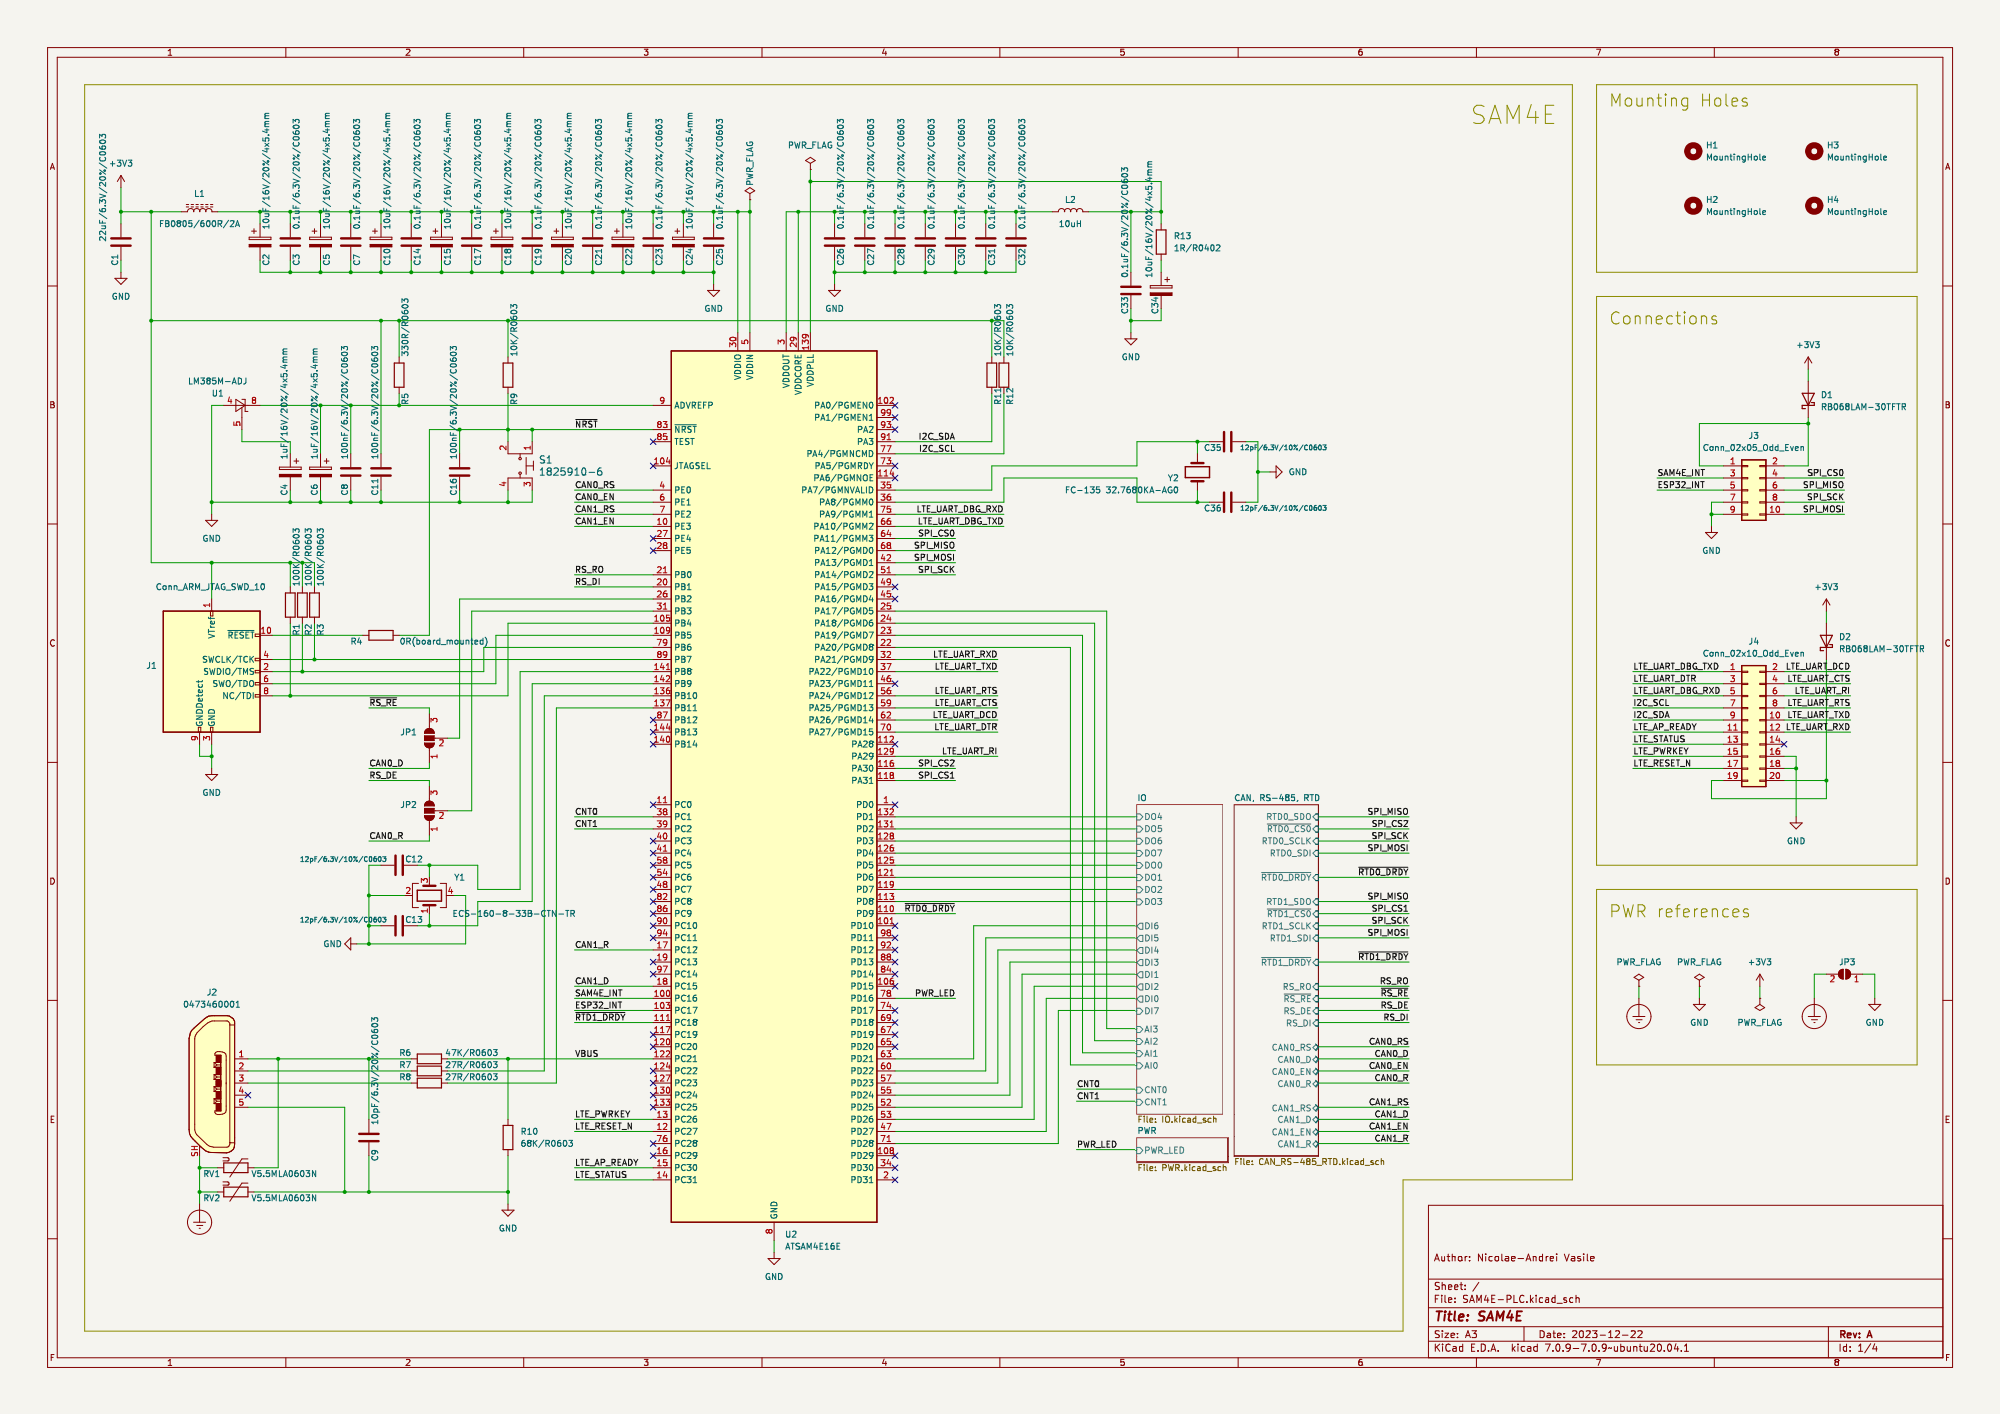
[picture p94: page 1]

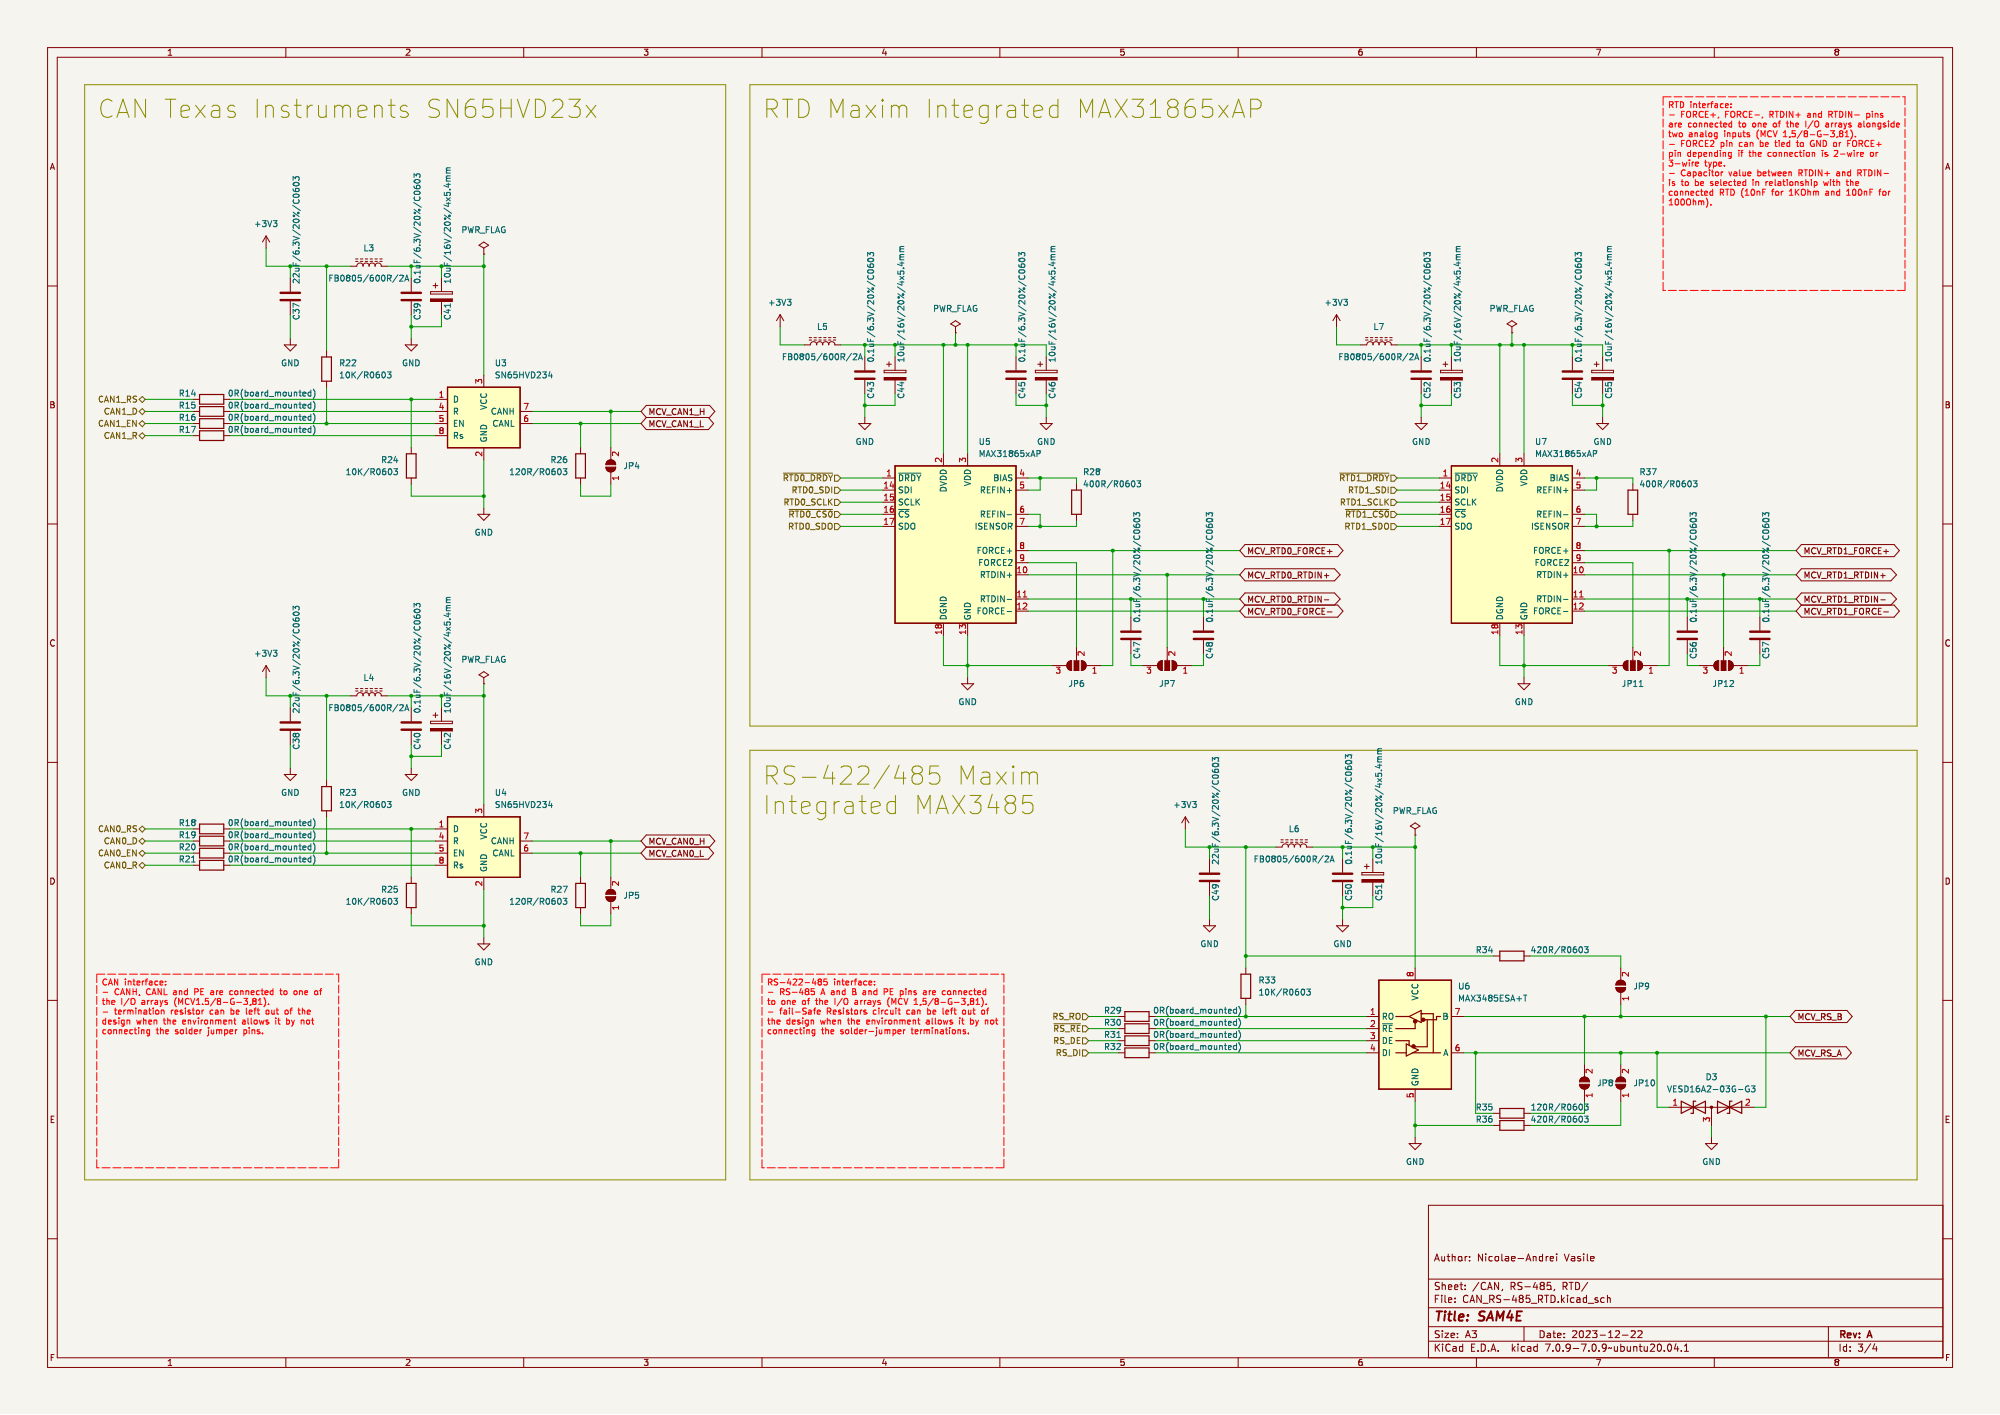
[picture p95: page 2]

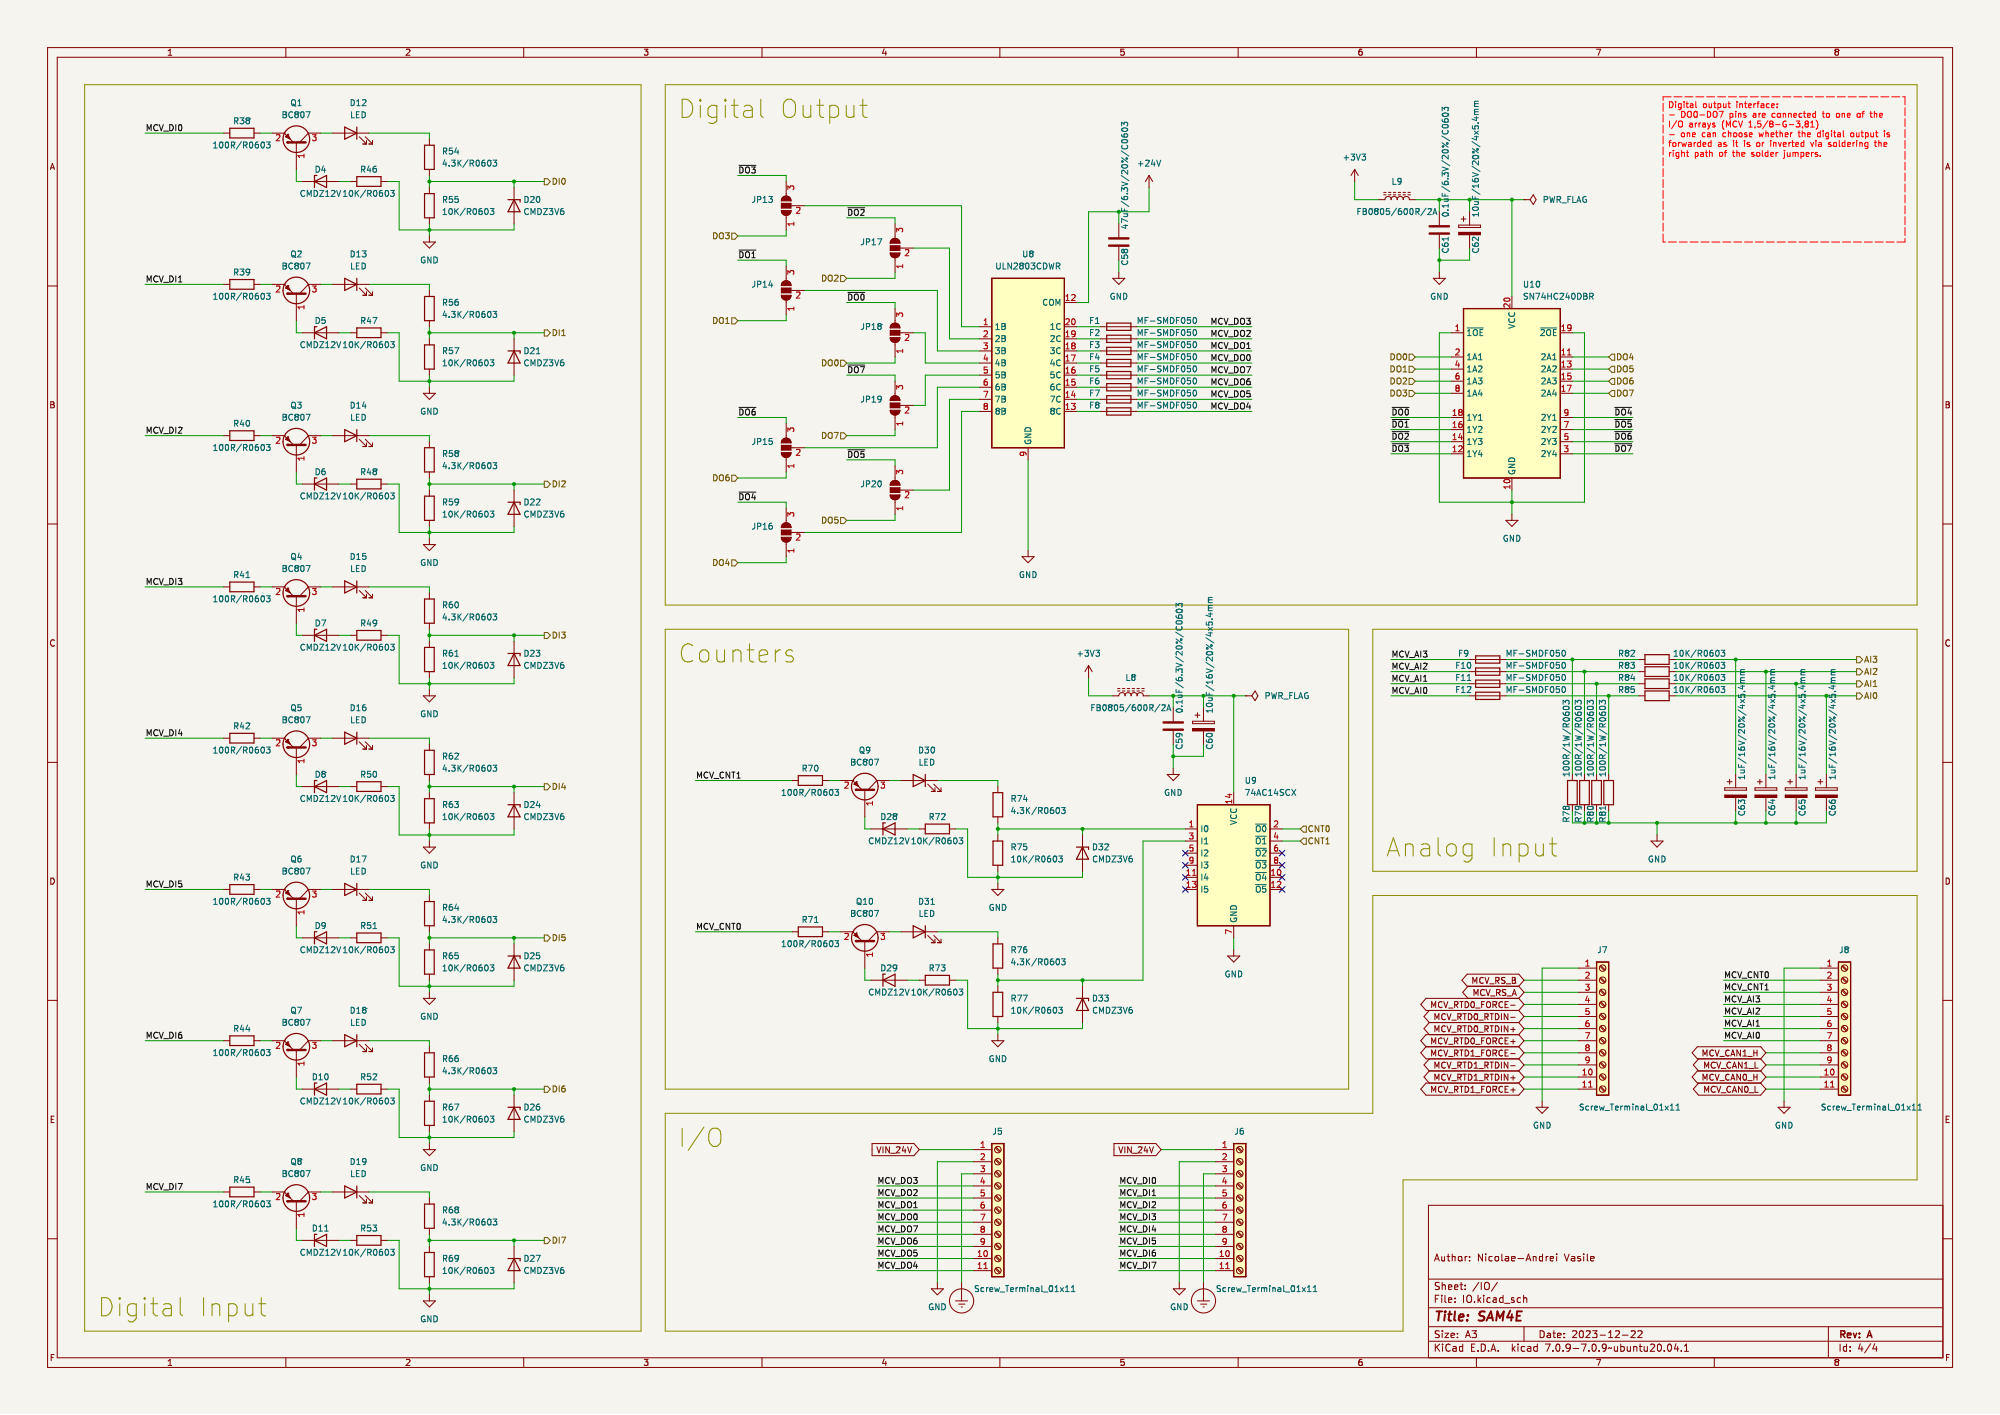
[picture p96: page 3]

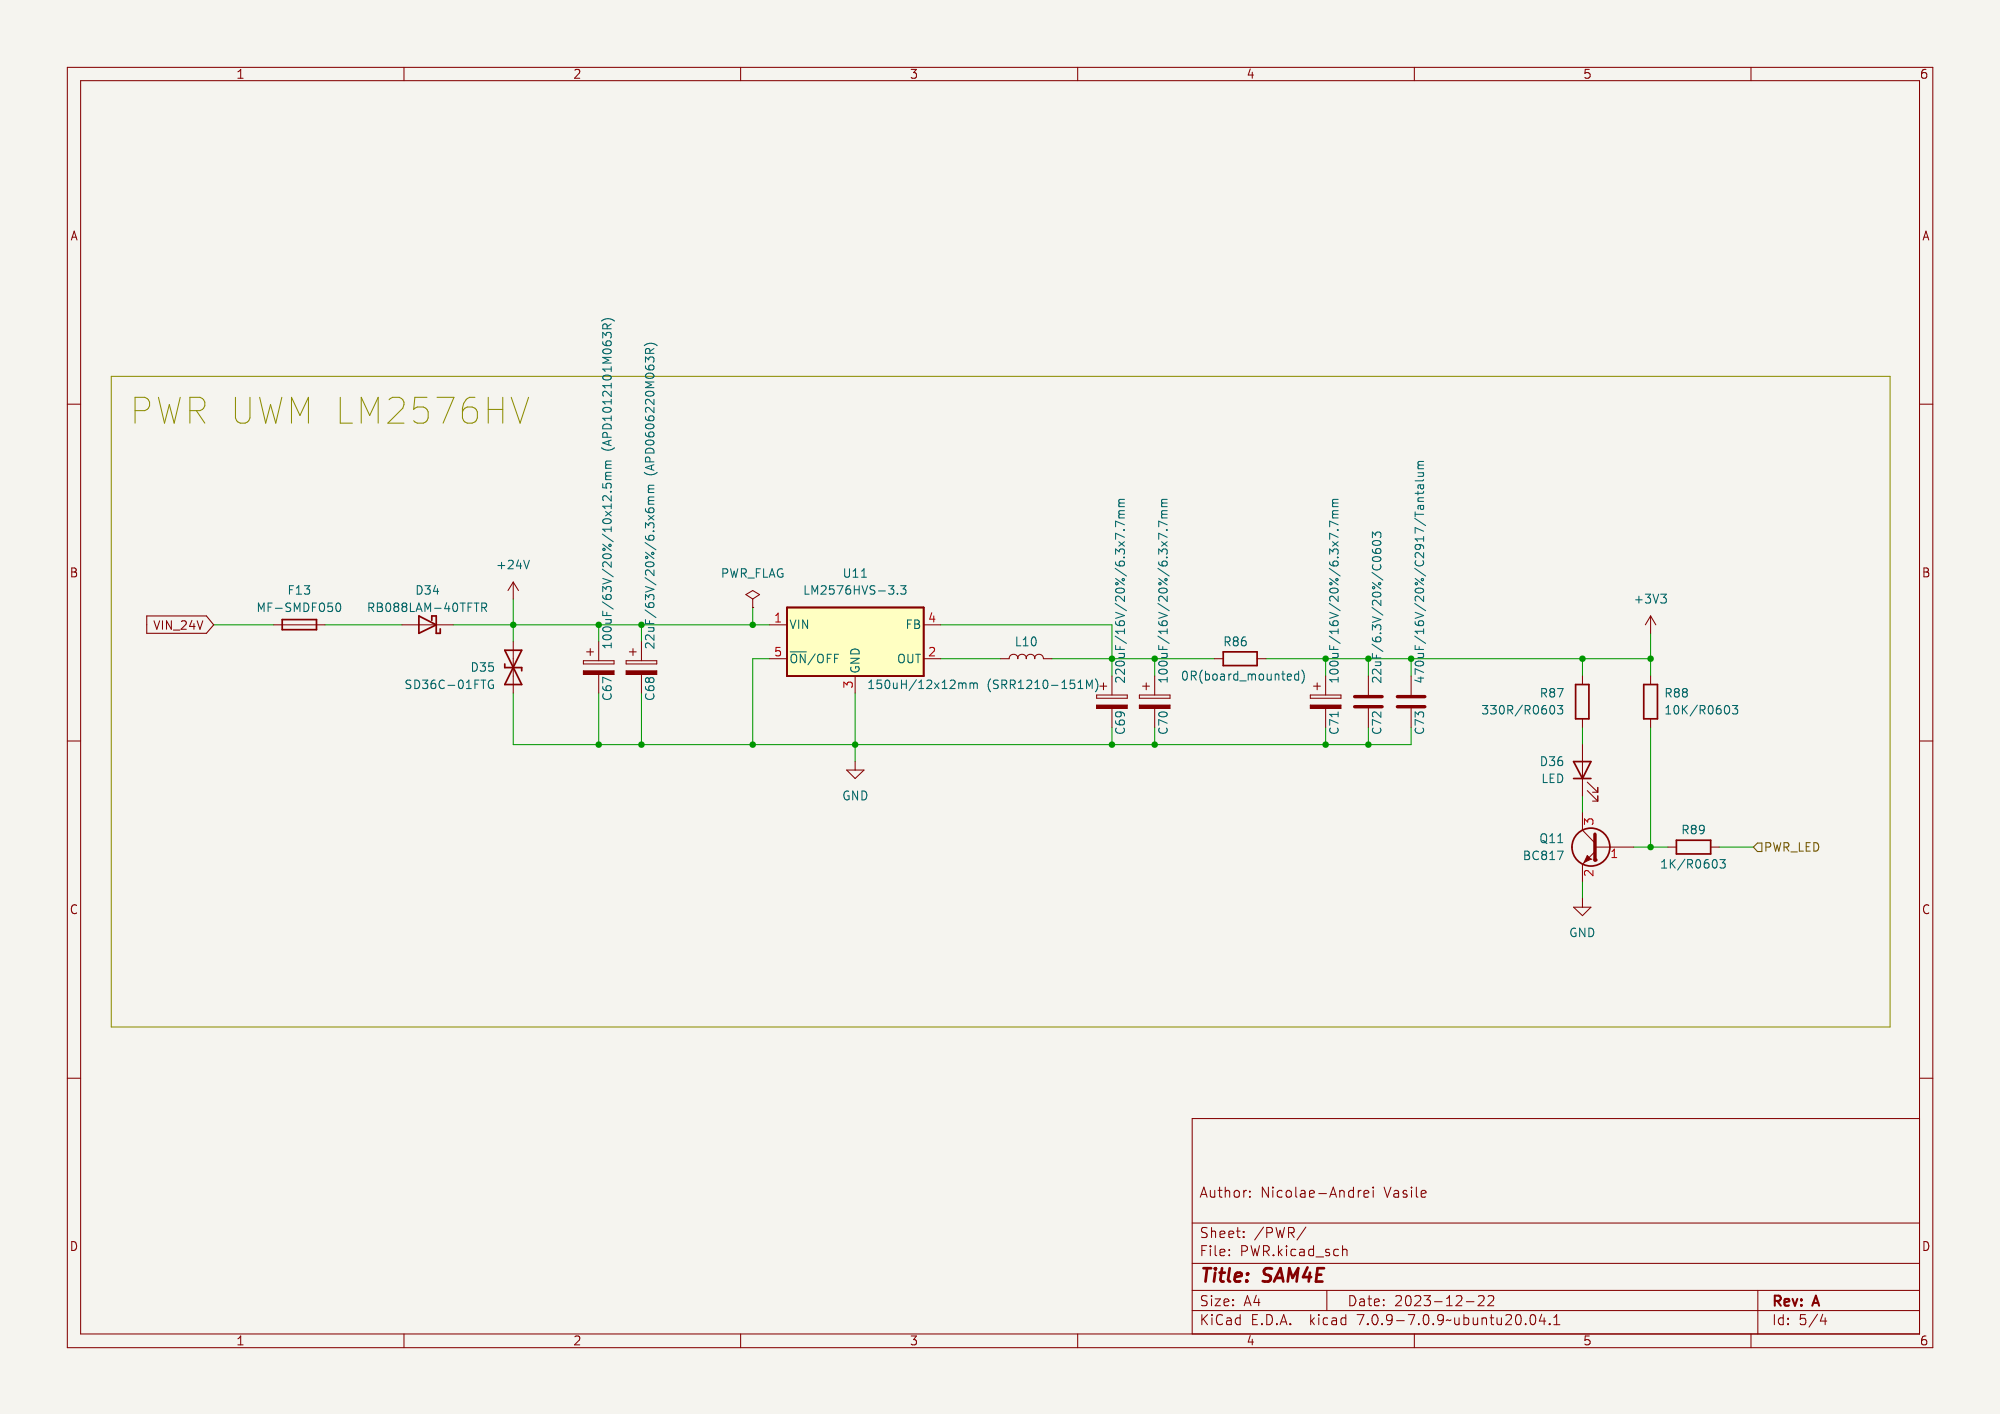
[picture p97: page 4]
