nicolaeandreivasile/plc-embedded-application/board-design/kicad-files/SAM4E-PLC/schematic-simple-color.pdf

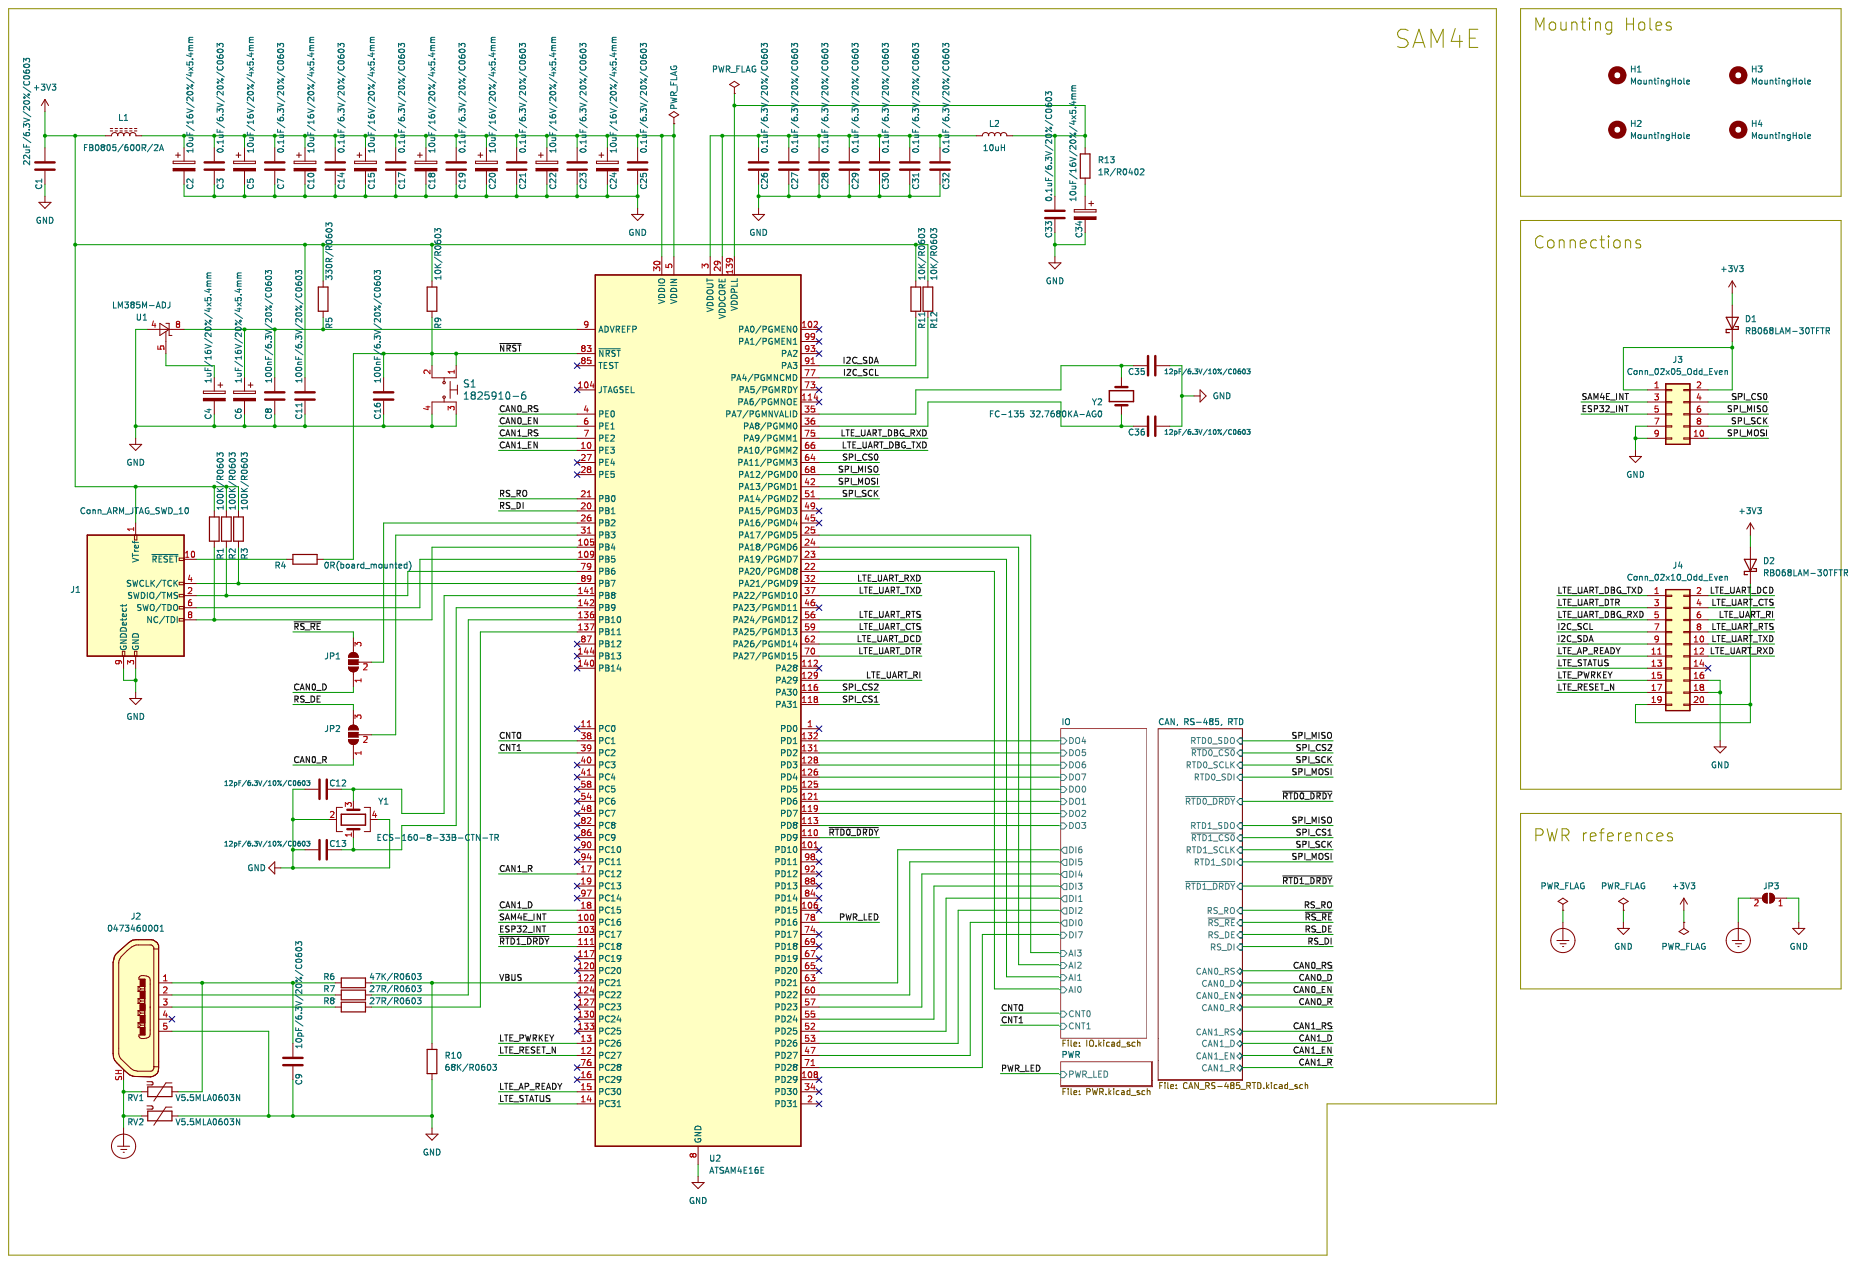
[picture p98: page 1]

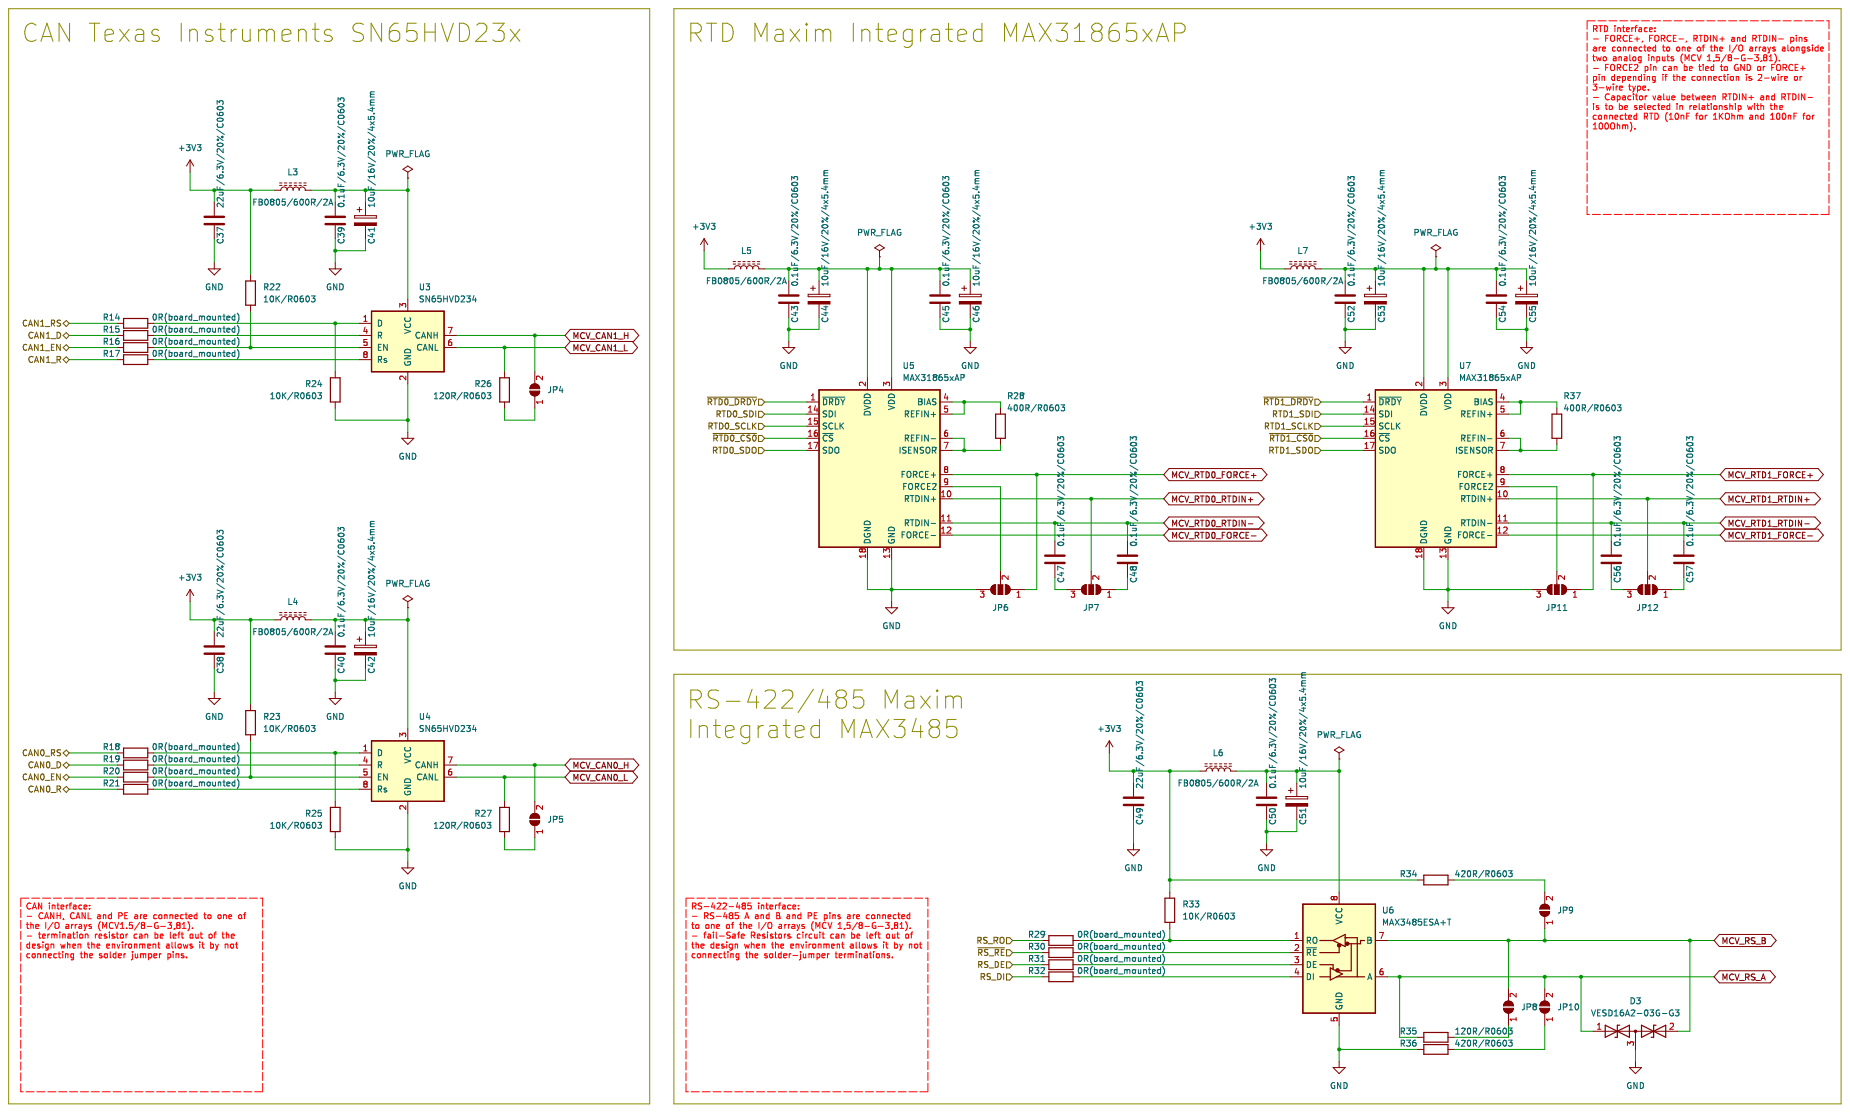
[picture p99: page 2]

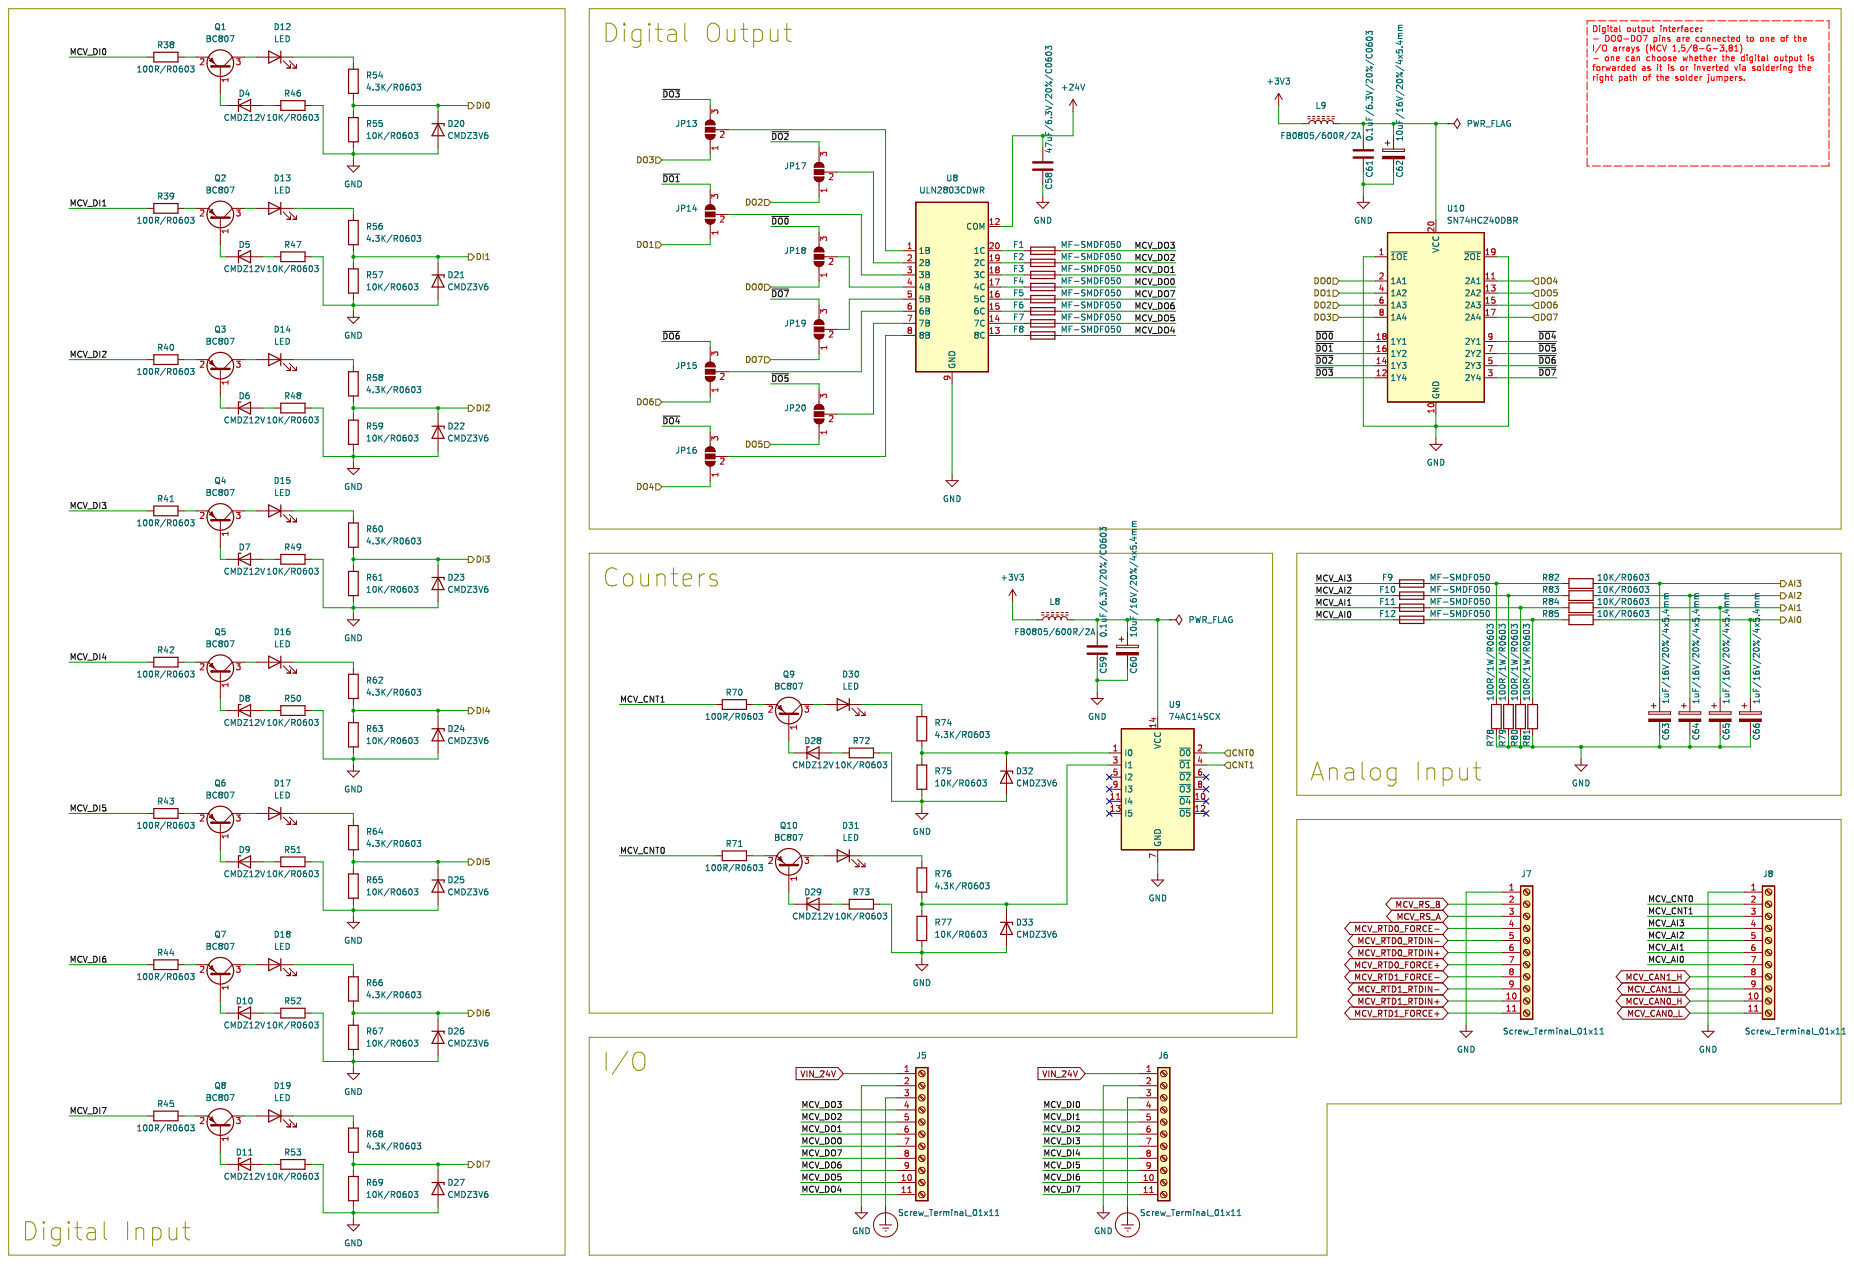
[picture p100: page 3]

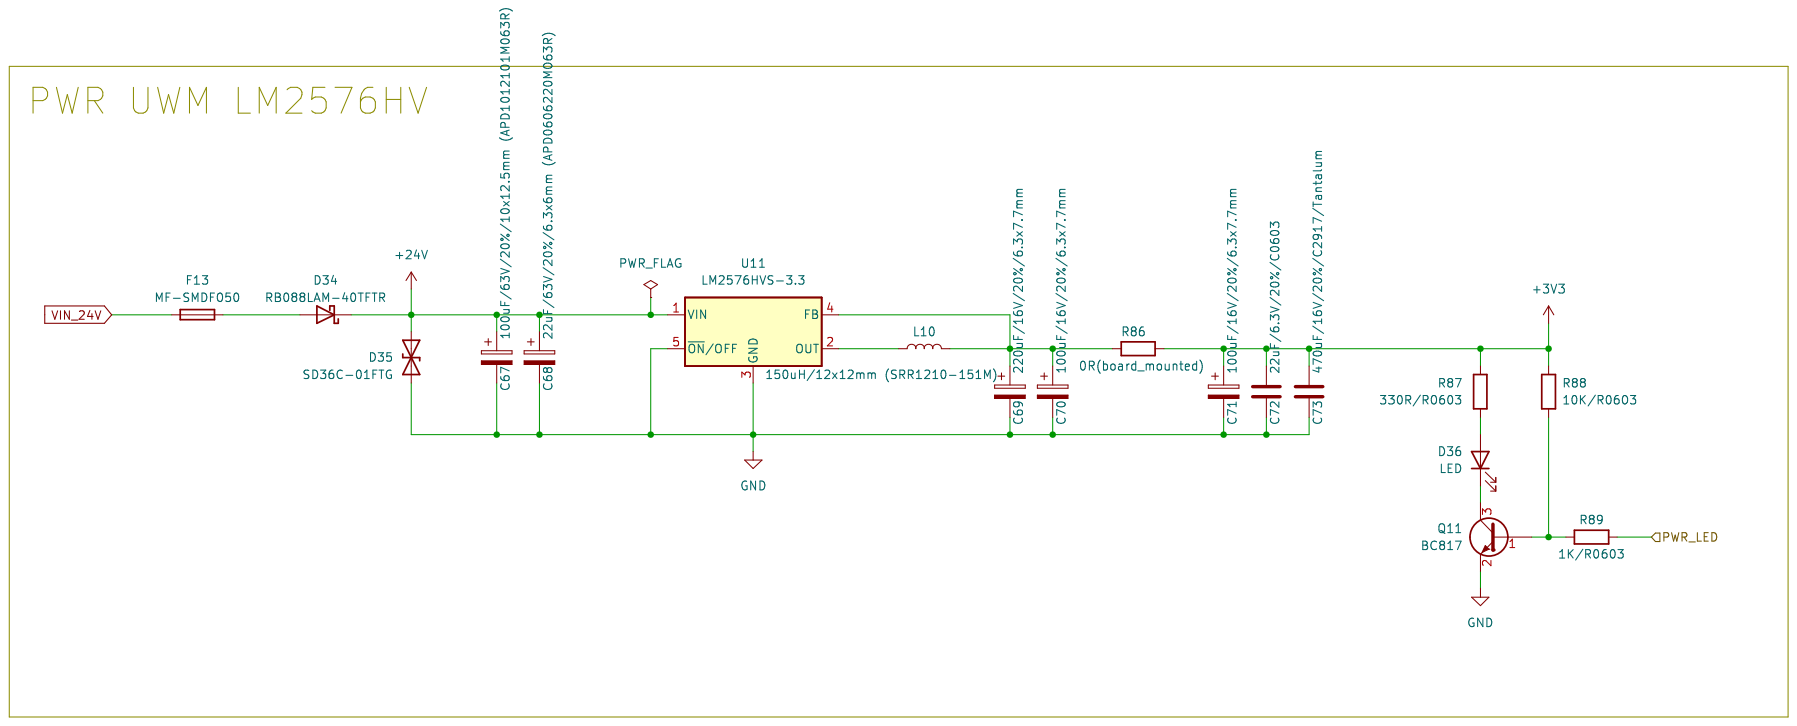
[picture p101: page 4]
