nicolaeandreivasile/plc-embedded-application/board-design/kicad-files/SAM4E-PLC/schematic-simple-mono.pdf

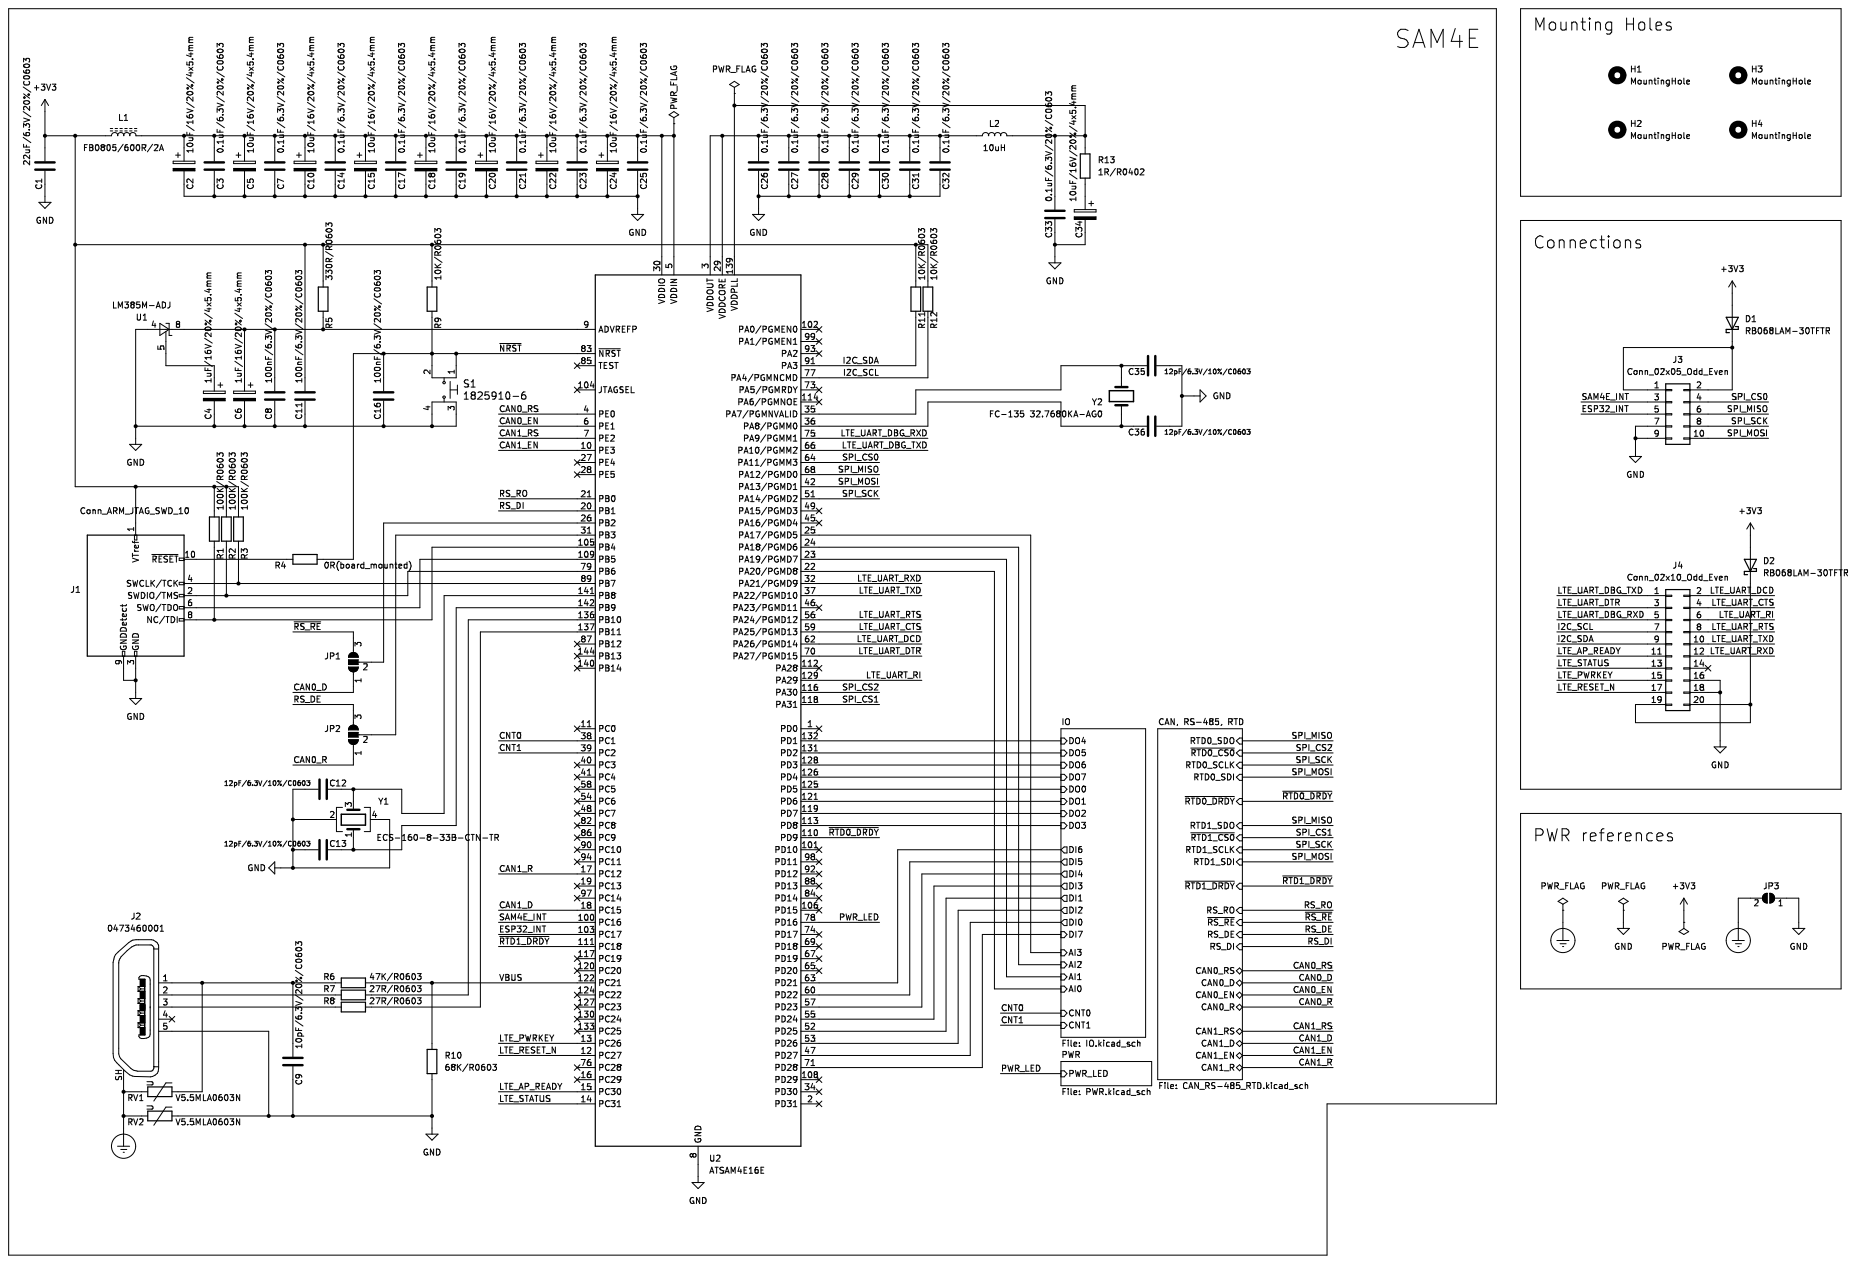
[picture p102: page 1]

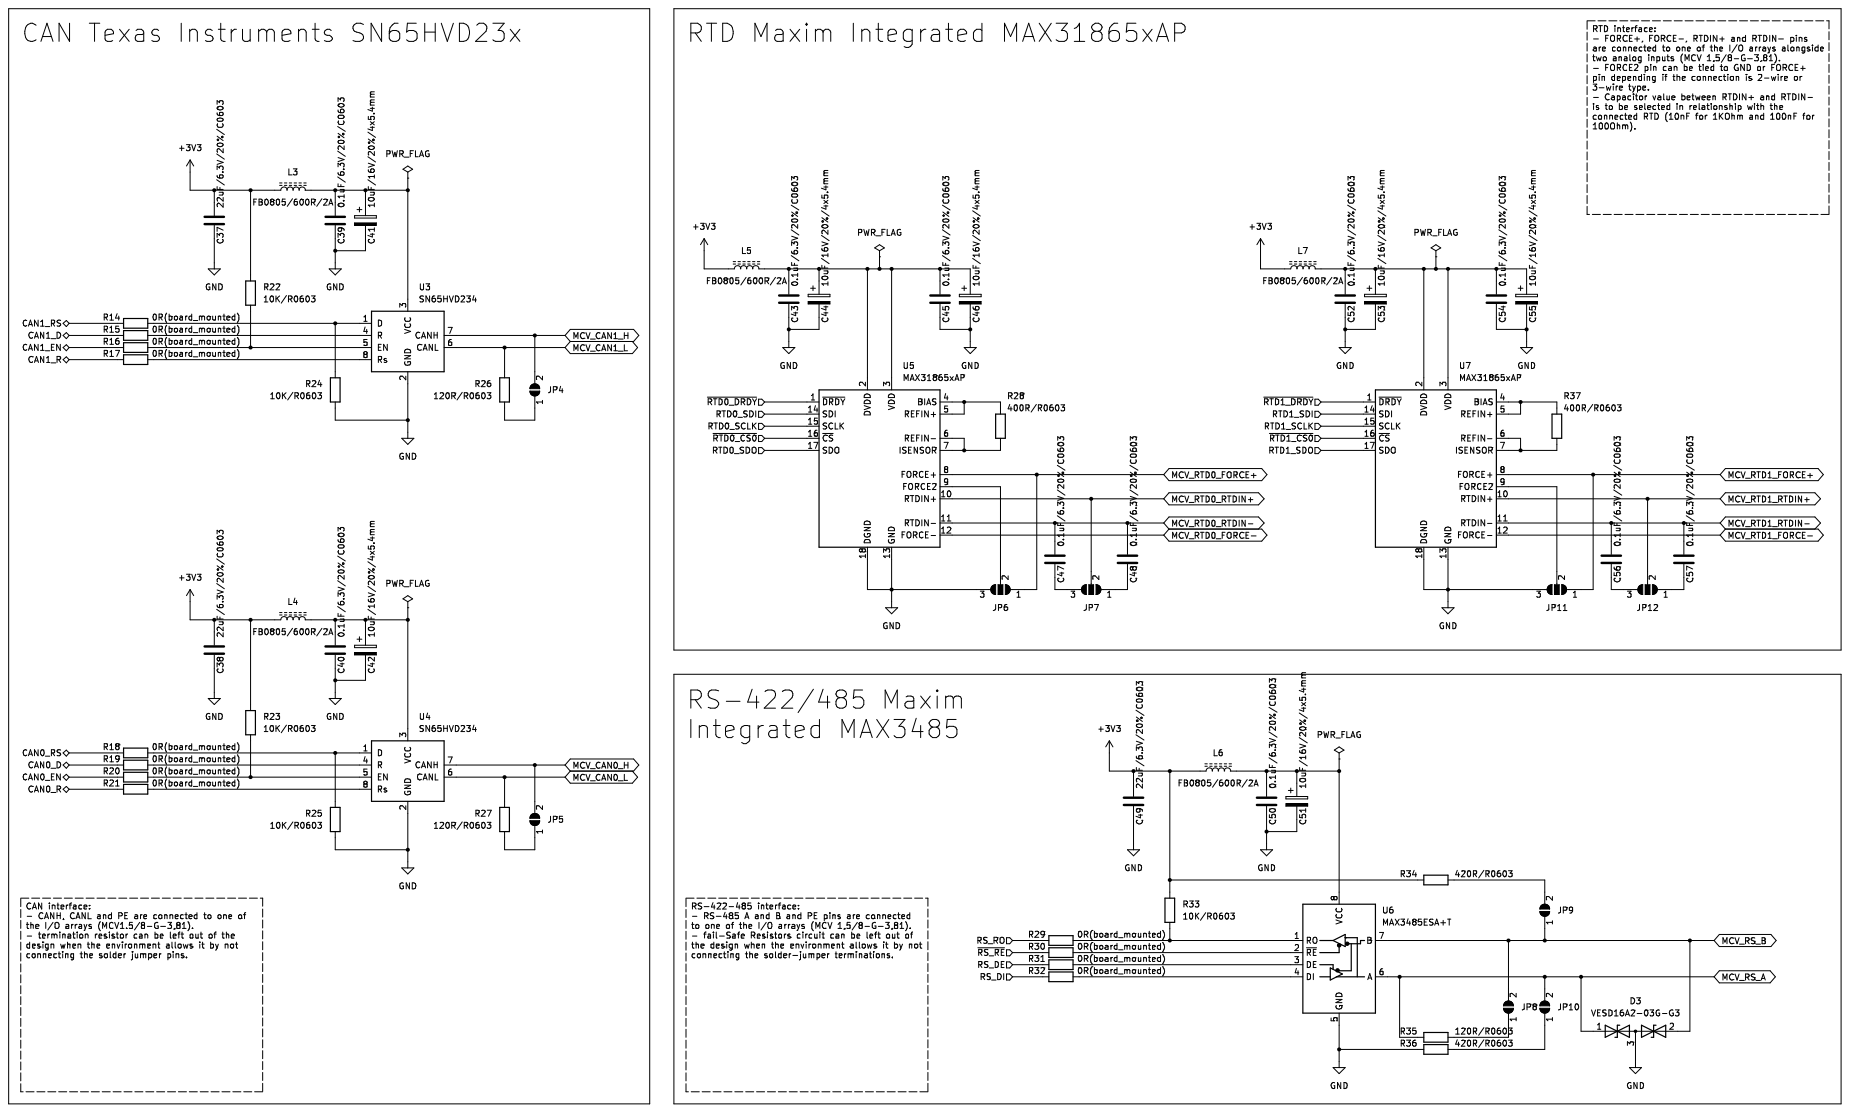
[picture p103: page 2]

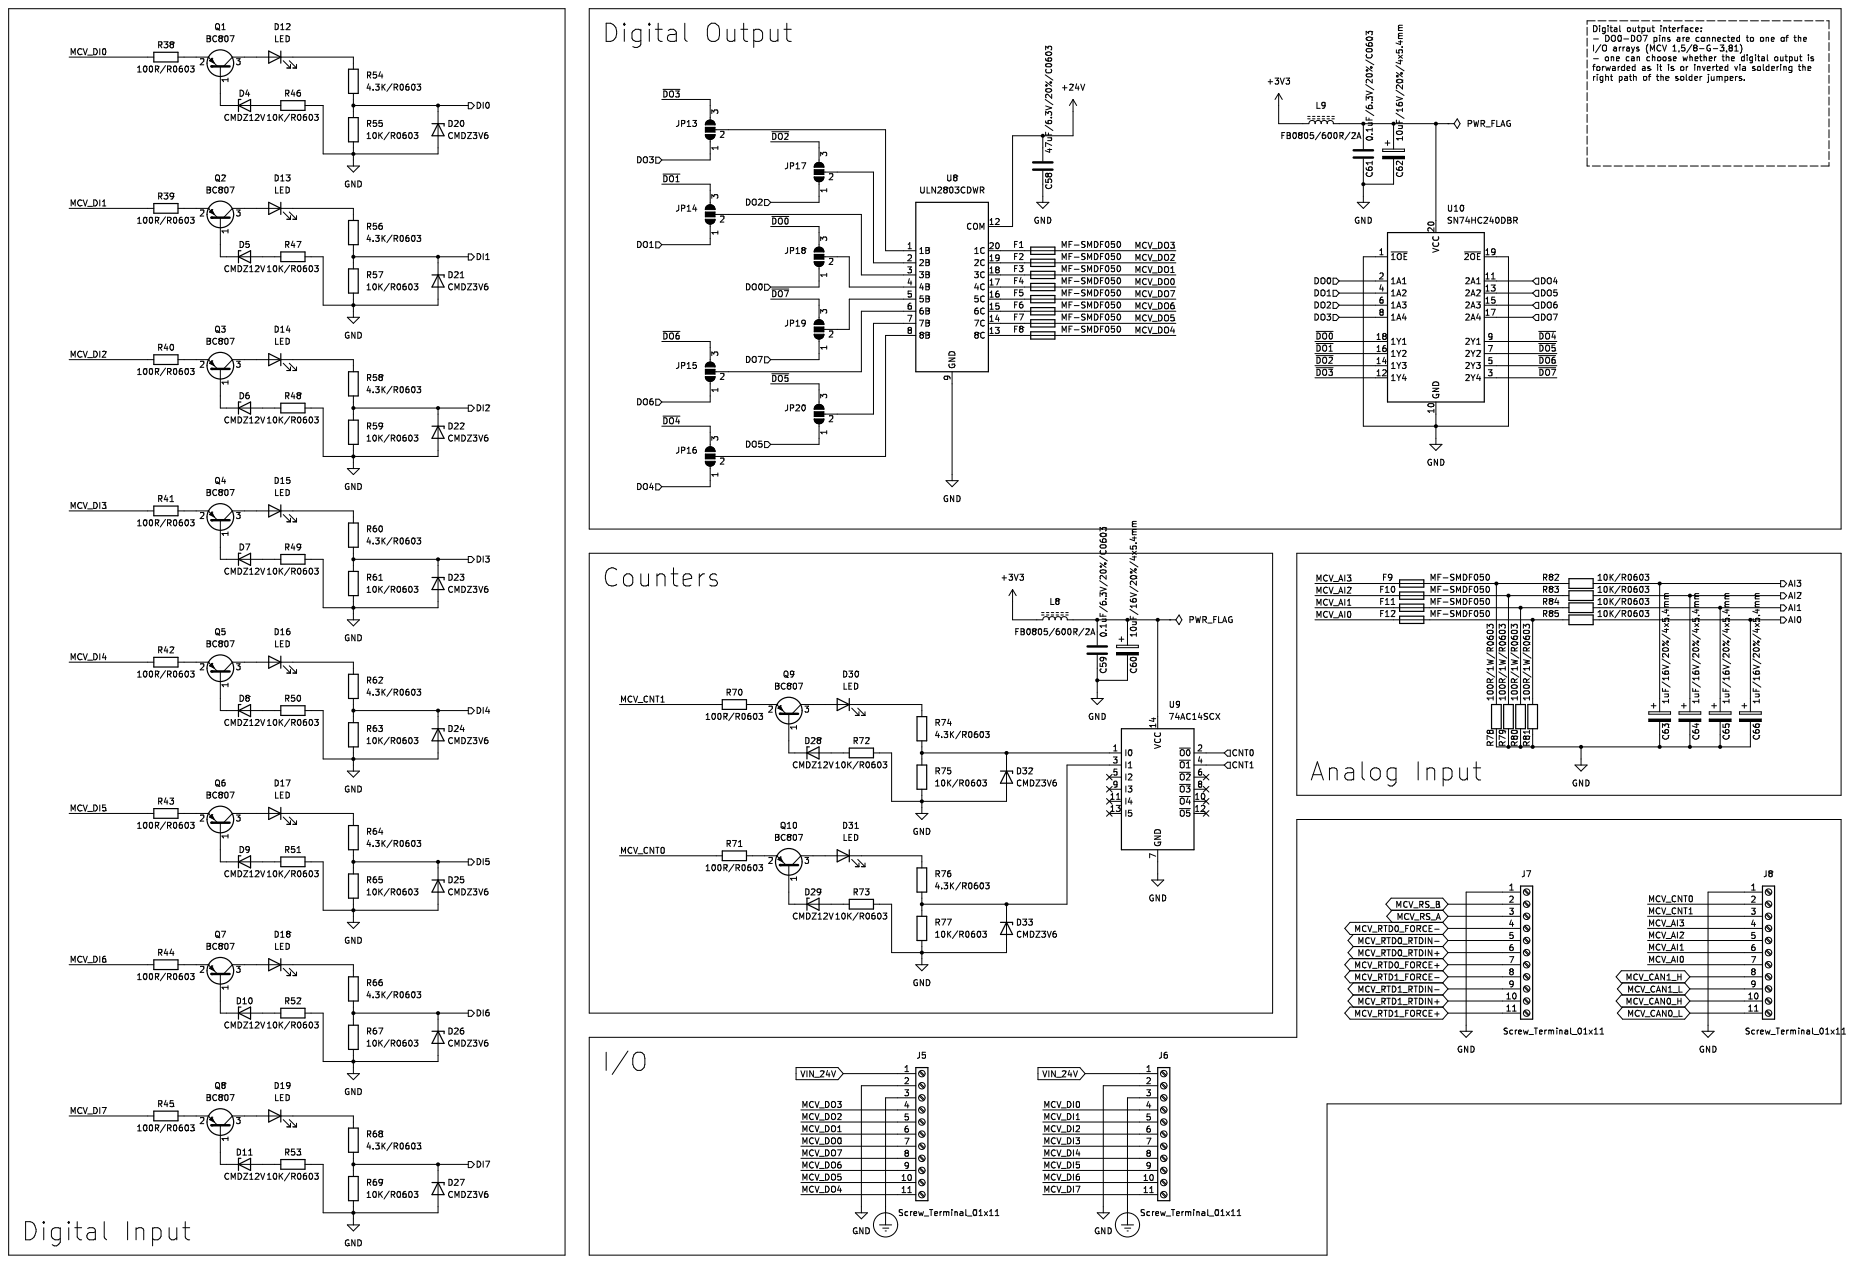
[picture p104: page 3]

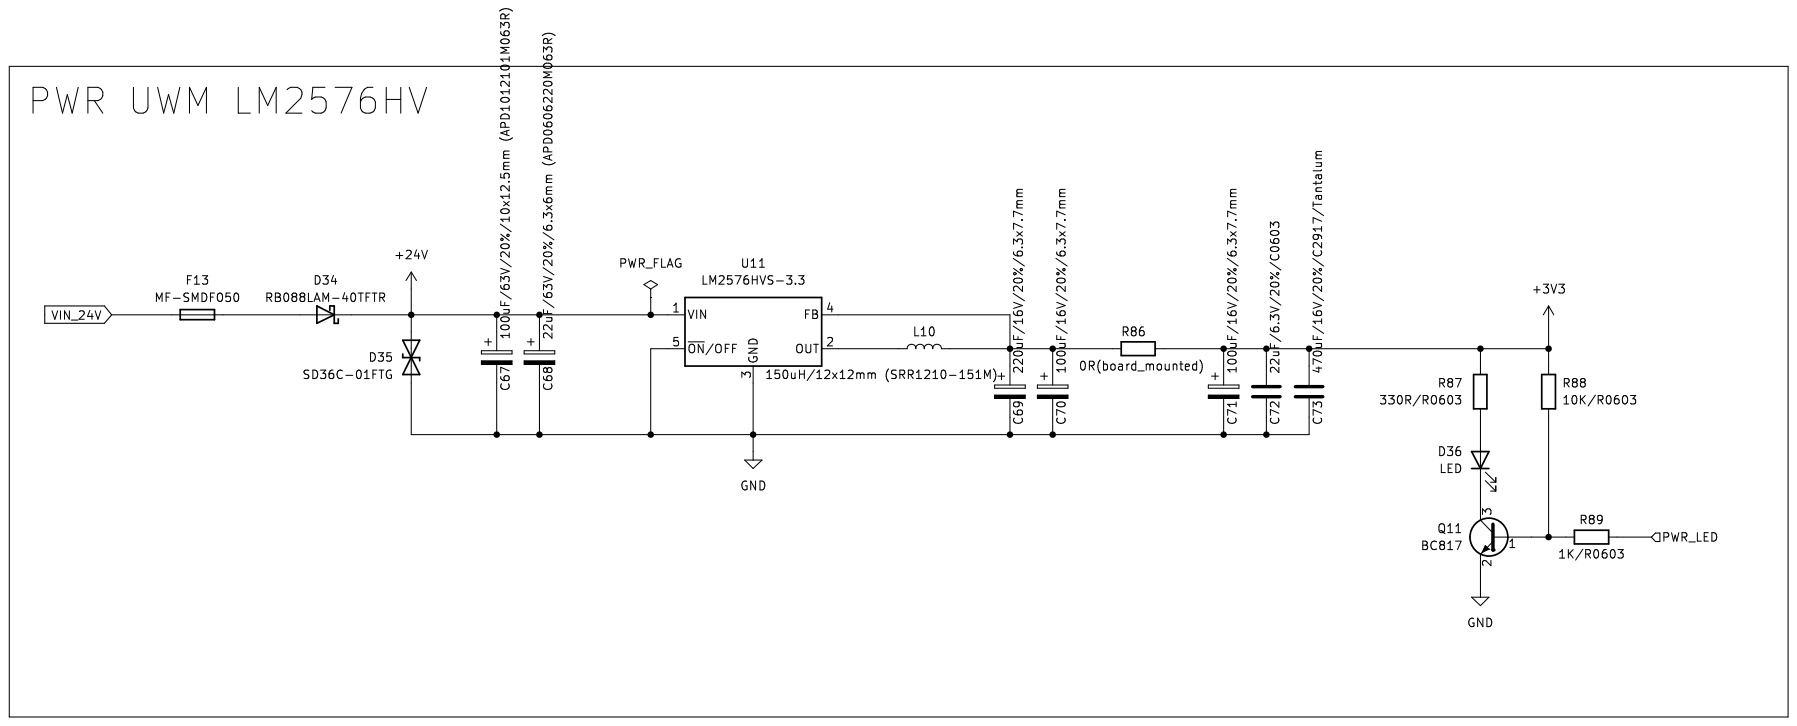
[picture p105: page 4]
