nicolaeandreivasile/plc-embedded-application/board-design/kicad-files/ESP32-PLC-programmer/ESP32-PLC-programmer.kicad_pcb

## KiCad design board-design/kicad-files/ESP32-PLC-programmer/ESP32-PLC-programmer.kicad_pcb (2026-04-05)

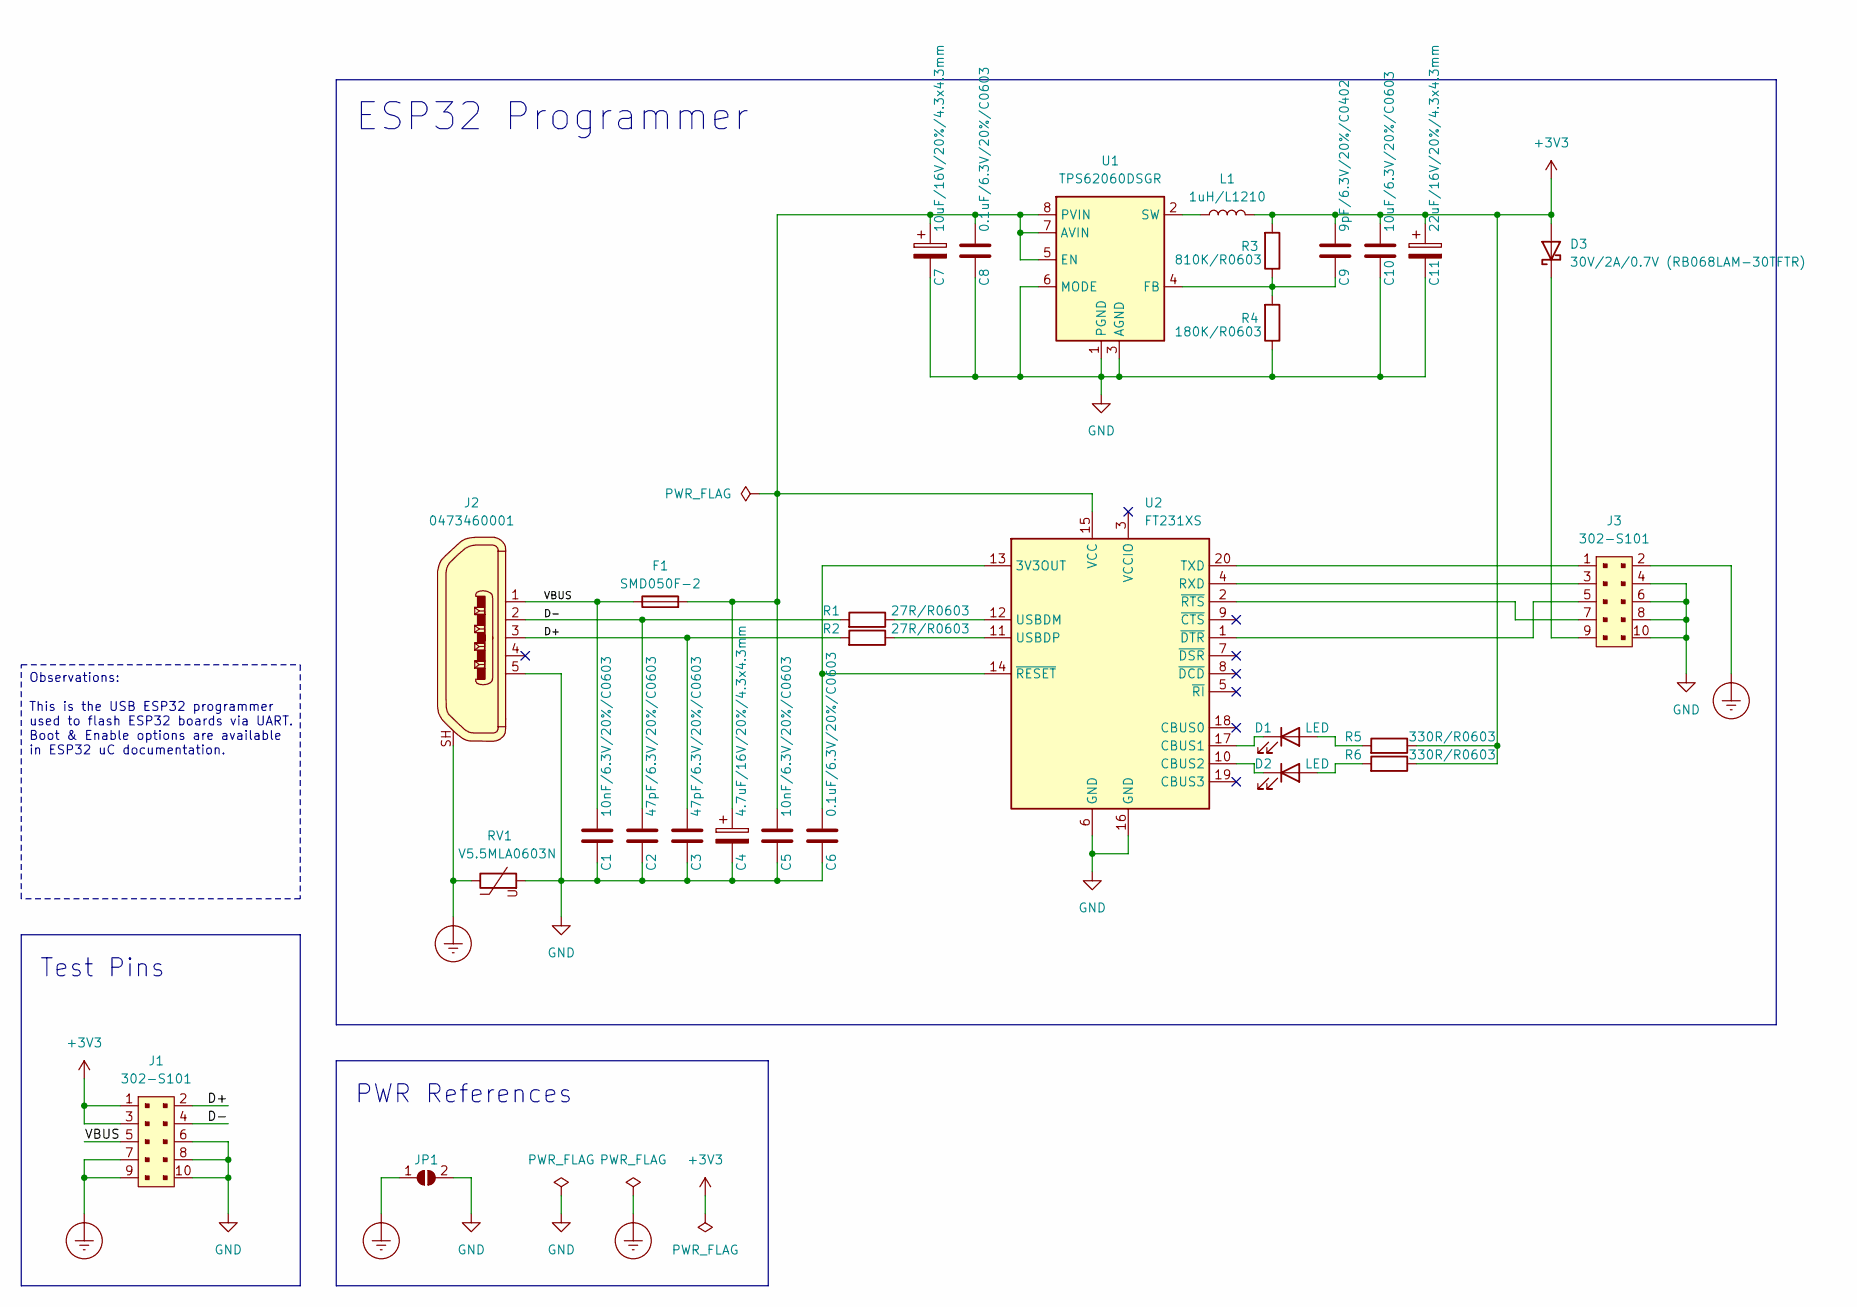
[picture p106: schematic ESP32-PLC-programmer.kicad_sch, ESP32 Programmer]

Parts:
C1, C5: 10nF/6.3V/20%/C0603; C_0603_1608Metric
C2, C3: 47pF/6.3V/20%/C0603; C_0603_1608Metric
C4: 4.7uF/16V/20%/4.3x4.3mm; CP_Elec_4x5.4
C6, C8: 0.1uF/6.3V/20%/C0603; C_0603_1608Metric
C7: 10uF/16V/20%/4.3x4.3mm; CP_Elec_4x5.4
C9: 9pF/6.3V/20%/C0402; C_0402_1005Metric
C10: 10uF/6.3V/20%/C0603; C_0603_1608Metric
C11: 22uF/16V/20%/4.3x4.3mm; CP_Elec_4x5.4
D1, D2: LED; LED_0805_2012Metric
D3: 30V/2A/0.7V (RB068LAM-30TFTR); D_SOD-128
F1: SMD050F-2; Fuse_2920_7451Metric
J1, J3: 302-S101; IDC-Header_2x05_P2.54mm_Vertical; MPN 302-S101; Digi-Key_PN ED1543-ND
J2: 0473460001; USB_Micro_B_Female_0473460001; MPN 0473460001; Digi-Key_PN WM17141CT-ND
JP1: SolderJumper_2_Open; SolderJumper-2_P1.3mm_Open_Pad1.0x1.5mm
L1: 1uH/L1210; L_1210_3225Metric
R1, R2: 27R/R0603; R_0603_1608Metric
R3: 810K/R0603; R_0603_1608Metric
R4: 180K/R0603; R_0603_1608Metric
R5, R6: 330R/R0603; R_0603_1608Metric
RV1: V5.5MLA0603N; R_0603_1608Metric
U1: TPS62060DSGR; WSON-8-1EP_2x2mm_P0.5mm_EP0.9x1.6mm_ThermalVias
U2: FT231XS; SSOP-20_3.9x8.7mm_P0.635mm

Connections:
+3V3: C9.1, C10.1, C11.1, D3.2 (A), J1.1, J1.3, L1.2, R3.2, R5.1, R6.1
/D+: C3.1, J1.2, J2.3, R2.2
/D-: C2.1, J1.4, J2.2, R1.2
/VBUS: C1.1, F1.1, J1.5, J2.1
Earth_Protective: J1.7, J1.9, J2.SH, J3.2, JP1.1 (A), RV1.1
GND: C1.2, C2.2, C3.2, C4.2, C5.2, C6.2, C7.2, C8.2, C10.2, C11.2, J1.6, J1.8, J1.10, J2.5, J3.4, J3.6, J3.8, J3.10, JP1.2 (B), R4.1, RV1.2, U1.1 (PGND), U1.3 (AGND), U1.6 (MODE), U2.6 (GND), U2.16 (GND)
unnamed: D1.2 (A), R5.2
unnamed: D1.1 (K), U2.17 (CBUS1)
unnamed: D2.2 (A), R6.2
unnamed: D2.1 (K), U2.10 (CBUS2)
unnamed: D3.1 (K), J3.9
unnamed: C4.1, C5.1, C7.1, C8.1, F1.2, U1.5 (EN), U1.7 (AVIN), U1.8 (PVIN), U2.15 (VCC)
unnamed: C9.2, R3.1, R4.2, U1.4 (FB)
unnamed: L1.1, U1.2 (SW)
unnamed: C6.1, U2.13 (3V3OUT), U2.14 (~RESET)
unnamed: J3.3, U2.4 (RXD)
unnamed: J3.1, U2.20 (TXD)
unnamed: R1.1, U2.12 (USBDM)
unnamed: R2.1, U2.11 (USBDP)
unnamed: J3.5, U2.1 (~DTR)
unnamed: J3.7, U2.2 (~RTS)

Notes on the sheet:
Observations: This is the USB ESP32 programmer used to flash ESP32 boards via UART. Boot & Enable options are available in ESP32 uC documentation.
PWR References
Test Pins
ESP32 Programmer

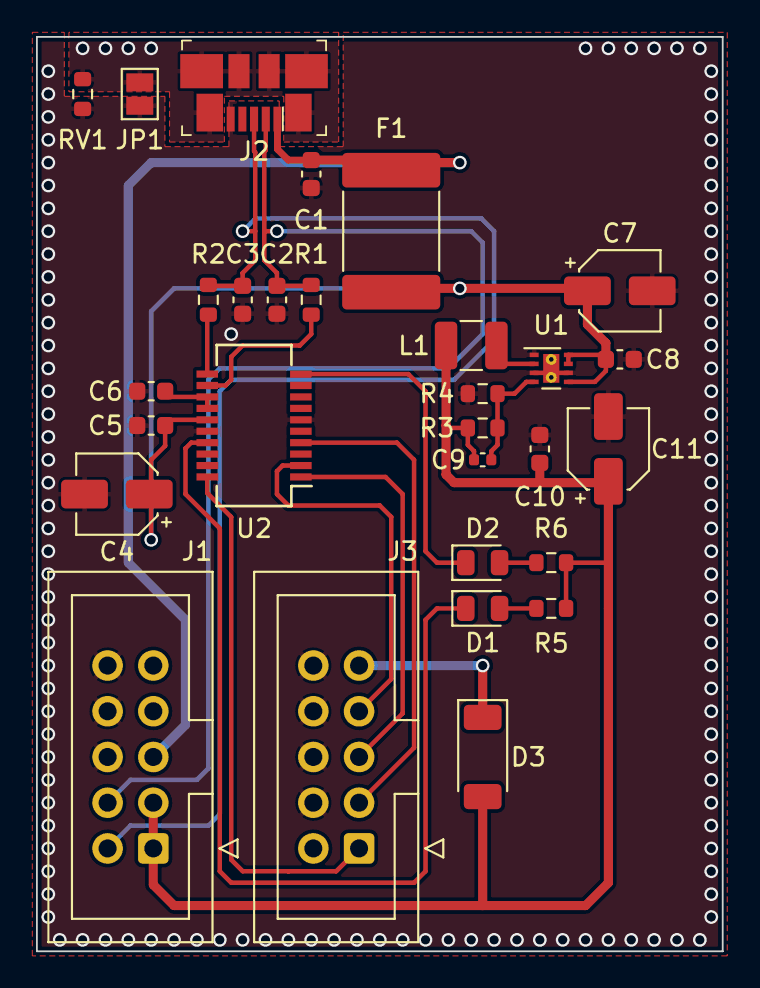
[picture p107: board ESP32-PLC-programmer.kicad_pcb from above]

Board: 2 copper layers, 38.1 x 50.8 mm, 29 parts (0 on the bottom side), 21 nets.
