nicolaeandreivasile/plc-embedded-application/board-design/kicad-files/SAM4E-PLC/SAM4E-PLC.kicad_pcb

## KiCad design board-design/kicad-files/SAM4E-PLC/SAM4E-PLC.kicad_pcb (2026-04-05)

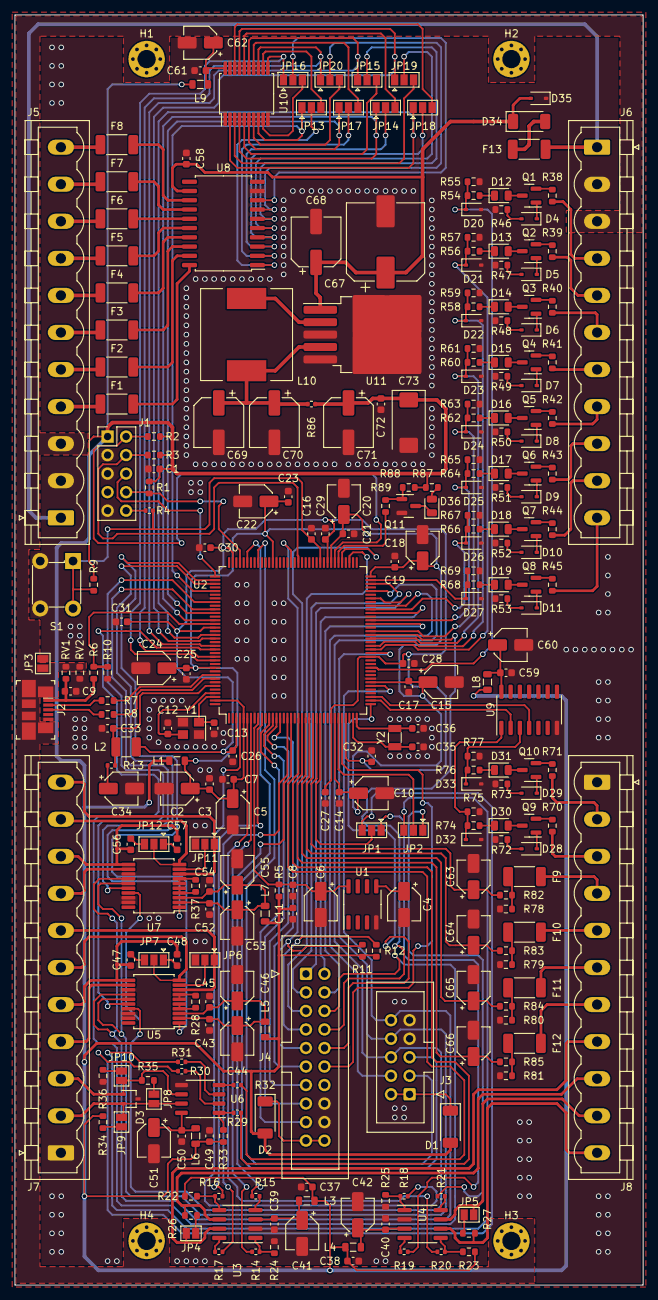
[picture p108: board SAM4E-PLC.kicad_pcb from above]

Board: 2 copper layers, 86.1 x 174.1 mm, 280 parts (0 on the bottom side), 247 nets.

Parts:
C1, C37, C38, C49, C72: 22uF/6.3V/20%/C0603; C_0603_1608Metric
C2, C5, C10, C15, C18, C20, C22, C24, C34, C41, C42, C44, C46, C51, C53, C55, C60, C62: 10uF/16V/20%/4x5.4mm; CP_Elec_4x5.4
C3, C7, C14, C17, C19, C21, C23, C25, C26, C27, C28, C29, C30, C31, C32, C33, C39, C40, C43, C45, C47, C48, C50, C52, C54, C56, C57, C59, C61: 0.1uF/6.3V/20%/C0603; C_0603_1608Metric
C4, C6, C63, C64, C65, C66: 1uF/16V/20%/4x5.4mm; CP_Elec_4x5.4
C8, C11, C16: 100nF/6.3V/20%/C0603; C_0603_1608Metric
C9: 10pF/6.3V/20%/C0603; C_0603_1608Metric
C12, C13, C35, C36: 12pF/6.3V/10%/C0603; C_0603_1608Metric
C58: 47uF/6.3V/20%/C0603; C_0603_1608Metric
C67: 100uF/63V/20%/10x12.5mm (APD1012101M063R); CP_Elec_10x12.5
C68: 22uF/63V/20%/6.3x6mm (APD0606220M063R); CP_Elec_6.3x5.9
C69: 220uF/16V/20%/6.3x7.7mm; CP_Elec_6.3x7.7
C70, C71: 100uF/16V/20%/6.3x7.7mm; CP_Elec_6.3x7.7
C73: 470uF/16V/20%/C2917/Tantalum; CP_EIA-7343-30_AVX-N
D1, D2: RB068LAM-30TFTR; D_SOD-128
D3: VESD16A2-03G-G3; SOT-323_SC-70
D4, D5, D6, D7, D8, D9, D10, D11, D28, D29: CMDZ12V; D_SOD-323
D12, D13, D14, D15, D16, D17, D18, D19, D30, D31, D36: LED; LED_0805_2012Metric
D20, D21, D22, D23, D24, D25, D26, D27, D32, D33: CMDZ3V6; D_SOD-323
D34: RB088LAM-40TFTR; D_SOD-128
D35: SD36C-01FTG; D_SOD-323
F1, F2, F3, F4, F5, F6, F7, F8, F9, F10, F11, F12, F13: MF-SMDF050; Fuse_2010_5025Metric
H1, H2, H3, H4: MountingHole; MountingHole_2.5mm_Pad_Via
J1: Conn_ARM_JTAG_SWD_10; PinHeader_2x05_P2.54mm_Vertical
J2: 0473460001; USB_Micro_B_Female_0473460001
J3: Conn_02x05_Odd_Even; IDC-Header_2x05_P2.54mm_Vertical
J4: Conn_02x10_Odd_Even; IDC-Header_2x10_P2.54mm_Vertical
J5, J6, J7, J8: Screw_Terminal_01x11; PhoenixContact_MSTBVA_2,5_11-G-5,08_1x11_P5.08mm_Vertical
JP1, JP2, JP6, JP7, JP11, JP12, JP13, JP14, JP15, JP16, JP17, JP18, JP19, JP20: SolderJumper_3_Open; SolderJumper-3_P1.3mm_Open_Pad1.0x1.5mm
JP3, JP4, JP5, JP8, JP9, JP10: SolderJumper_2_Open; SolderJumper-2_P1.3mm_Open_Pad1.0x1.5mm
L1, L3, L4, L5, L6, L7, L8, L9: FB0805/600R/2A; L_0805_2012Metric
L2: 10uH; L_1210_3225Metric
L10: 150uH/12x12mm (SRR1210-151M); L_12x12mm_H8mm
Q1, Q2, Q3, Q4, Q5, Q6, Q7, Q8, Q9, Q10: BC807; SOT-23
Q11: BC817; SOT-23
R1, R2, R3: 100K/R0603; R_0603_1608Metric
R4, R14, R15, R16, R17, R18, R19, R20, R21, R29, R30, R31, R32, R86: 0R(board_mounted); R_0402_1005Metric
R5, R87: 330R/R0603; R_0603_1608Metric
R6: 47K/R0603; R_0603_1608Metric
R7, R8: 27R/R0603; R_0603_1608Metric
R9, R11, R12, R22, R23, R24, R25, R33, R46, R47, R48, R49, R50, R51, R52, R53, R55, R57, R59, R61, R63, R65, R67, R69, R72, R73, R75, R77, R82, R83, R84, R85, R88: 10K/R0603; R_0603_1608Metric
R10: 68K/R0603; R_0603_1608Metric
R13: 1R/R0402; R_0402_1005Metric
R26, R27, R35: 120R/R0603; R_0603_1608Metric
R28, R37: 400R/R0603; R_0603_1608Metric
R34, R36: 420R/R0603; R_0603_1608Metric
R38, R39, R40, R41, R42, R43, R44, R45, R70, R71: 100R/R0603; R_0603_1608Metric
R54, R56, R58, R60, R62, R64, R66, R68, R74, R76: 4.3K/R0603; R_0603_1608Metric
R78, R79, R80, R81: 100R/1W/R0603; R_0603_1608Metric
R89: 1K/R0603; R_0603_1608Metric
RV1, RV2: V5.5MLA0603N; R_0603_1608Metric
S1: 1825910-6; Switch_Tactile_THT_6x6mm
U1: LM385M-ADJ; SOIC-8_3.9x4.9mm_P1.27mm
U2: ATSAM4E16E; LQFP-144_20x20mm_P0.5mm
U3, U4: SN65HVD234; SOIC-8_3.9x4.9mm_P1.27mm
U5, U7: MAX31865xAP; SSOP-20_5.3x7.2mm_P0.65mm
U6: MAX3485ESA+T; SO-8_3.9x4.9mm_P1.27mm
U8: ULN2803CDWR; SOIC-20W_7.5x12.8mm_P1.27mm
U9: 74AC14SCX; SOIC-14_3.9x8.7mm_P1.27mm
U10: SN74HC240DBR; SSOP-20_5.3x7.2mm_P0.65mm
U11: LM2576HVS-3.3; TO-263-5_TabPin3
Y1: ECS-160-8-33B-CTN-TR; Crystal_SMD_3225-4Pin_3.2x2.5mm
Y2: FC-135 32.7680KA-AG0; Crystal_SMD_3215-2Pin_3.2x1.5mm

Connections:
+3V3: C1.1, C11.1, C37.1, C38.1, C49.1, C71.1, C72.1, C73.1, D1.2 (A), D2.2 (A), J1.1 (VTref), L1.1, L3.1, L4.1, L5.1, L6.1, L7.1, L8.1, L9.1, R1.2, R2.2, R3.2, R5.1, R9.1, R11.1, R12.1, R22.1, R23.1, R33.1, R34.1, R86.2, R87.1, R88.1
+24V: C58.1, C67.1, C68.1, D34.1 (K), D35.2 (A2), U8.12 (COM), U11.1 (VIN)
/CAN0_D: JP1.1 (A), R19.1
/CAN0_EN: R20.1, U2.6 (PE1)
/CAN0_R: JP2.1 (A), R21.1
/CAN0_RS: R18.1, U2.4 (PE0)
/CAN1_D: R15.1, U2.18 (PC15)
/CAN1_EN: R16.1, U2.10 (PE3)
/CAN1_R: R17.1, U2.17 (PC12)
/CAN1_RS: R14.1, U2.7 (PE2)
/CNT0: U2.38 (PC1), U9.2 (~O0)
/CNT1: U2.39 (PC2), U9.4 (~O1)
/ESP32_INT: J3.5, U2.103 (PC17)
/I2C_SCL: J4.7, R12.2, U2.77 (PA4/PGMNCMD)
/I2C_SDA: J4.9, R11.2, U2.91 (PA3)
/IO/AI0: C66.1, R85.2, U2.22 (PA20/PGMD8)
/IO/AI1: C65.1, R84.2, U2.23 (PA19/PGMD7)
/IO/AI2: C64.1, R83.2, U2.24 (PA18/PGMD6)
/IO/AI3: C63.1, R82.2, U2.25 (PA17/PGMD5)
/IO/DI0: D20.1 (K), R54.2, R55.1, U2.47 (PD27)
/IO/DI1: D21.1 (K), R56.2, R57.1, U2.52 (PD25)
/IO/DI2: D22.1 (K), R58.2, R59.1, U2.53 (PD26)
/IO/DI3: D23.1 (K), R60.2, R61.1, U2.55 (PD24)
/IO/DI4: D24.1 (K), R62.2, R63.1, U2.57 (PD23)
/IO/DI5: D25.1 (K), R64.2, R65.1, U2.60 (PD22)
/IO/DI6: D26.1 (K), R66.2, R67.1, U2.63 (PD21)
/IO/DI7: D27.1 (K), R68.2, R69.1, U2.71 (PD28)
/IO/DO0: JP18.1 (A), U2.125 (PD5), U10.2 (1A1)
/IO/DO1: JP14.1 (A), U2.121 (PD6), U10.4 (1A2)
/IO/DO2: JP17.1 (A), U2.119 (PD7), U10.6 (1A3)
/IO/DO3: JP13.1 (A), U2.113 (PD8), U10.8 (1A4)
/IO/DO4: JP16.1 (A), U2.132 (PD1), U10.11 (2A1)
/IO/DO5: JP20.1 (A), U2.131 (PD2), U10.13 (2A2)
/IO/DO6: JP15.1 (A), U2.128 (PD3), U10.15 (2A3)
/IO/DO7: JP19.1 (A), U2.126 (PD4), U10.17 (2A4)
/IO/MCV_AI0: F12.1, J8.7
/IO/MCV_AI1: F11.1, J8.6
/IO/MCV_AI2: F10.1, J8.5
/IO/MCV_AI3: F9.1, J8.4
/IO/MCV_CNT0: J8.2, R71.1
/IO/MCV_CNT1: J8.3, R70.1
/IO/MCV_DI0: J6.4, R38.1
/IO/MCV_DI1: J6.5, R39.1
/IO/MCV_DI2: J6.6, R40.1
/IO/MCV_DI3: J6.7, R41.1
/IO/MCV_DI4: J6.8, R42.1
/IO/MCV_DI5: J6.9, R43.1
/IO/MCV_DI6: J6.10, R44.1
/IO/MCV_DI7: J6.11, R45.1
/IO/MCV_DO0: F4.2, J5.7
/IO/MCV_DO1: F3.2, J5.6
/IO/MCV_DO2: F2.2, J5.5
/IO/MCV_DO3: F1.2, J5.4
/IO/MCV_DO4: F8.2, J5.11
/IO/MCV_DO5: F7.2, J5.10
/IO/MCV_DO6: F6.2, J5.9
/IO/MCV_DO7: F5.2, J5.8
/IO/~DO0: JP18.3 (B), U10.18 (1Y1)
/IO/~DO1: JP14.3 (B), U10.16 (1Y2)
/IO/~DO2: JP17.3 (B), U10.14 (1Y3)
/IO/~DO3: JP13.3 (B), U10.12 (1Y4)
/IO/~DO4: JP16.3 (B), U10.9 (2Y1)
/IO/~DO5: JP20.3 (B), U10.7 (2Y2)
/IO/~DO6: JP15.3 (B), U10.5 (2Y3)
/IO/~DO7: JP19.3 (B), U10.3 (2Y4)
/LTE_AP_READY: J4.11, U2.15 (PC30)
/LTE_PWRKEY: J4.15, U2.13 (PC26)
/LTE_RESET_N: J4.17, U2.12 (PC27)
/LTE_STATUS: J4.13, U2.14 (PC31)
/LTE_UART_CTS: J4.4, U2.59 (PA25/PGMD13)
/LTE_UART_DBG_RXD: J4.5, U2.75 (PA9/PGMM1)
/LTE_UART_DBG_TXD: J4.1, U2.66 (PA10/PGMM2)
/LTE_UART_DCD: J4.2, U2.62 (PA26/PGMD14)
/LTE_UART_DTR: J4.3, U2.70 (PA27/PGMD15)
/LTE_UART_RI: J4.6, U2.129 (PA29)
/LTE_UART_RTS: J4.8, U2.56 (PA24/PGMD12)
/LTE_UART_RXD: J4.12, U2.32 (PA21/PGMD9)
/LTE_UART_TXD: J4.10, U2.37 (PA22/PGMD10)
/PWR_LED: R89.2, U2.78 (PD16)
/RS_DE: JP2.3 (B), R31.1
/RS_DI: R32.1, U2.20 (PB1)
/RS_RO: R29.1, U2.21 (PB0)
/SAM4E_INT: J3.3, U2.100 (PC16)
/SPI_CS0: J3.4, U2.64 (PA11/PGMM3)
/SPI_CS1: U2.118 (PA31), U7.16 (~CS)
/SPI_CS2: U2.116 (PA30), U5.16 (~CS)
/SPI_MISO: J3.6, U2.68 (PA12/PGMD0), U5.17 (SDO), U7.17 (SDO)
/SPI_MOSI: J3.10, U2.42 (PA13/PGMD1), U5.14 (SDI), U7.14 (SDI)
/SPI_SCK: J3.8, U2.51 (PA14/PGMD2), U5.15 (SCLK), U7.15 (SCLK)
/VBUS: R6.2, R10.1, U2.122 (PC21)
/~NRST: C16.1, R4.2, R9.2, S1.1, S1.2, U2.83 (~NRST)
/~RS_RE: JP1.3 (B), R30.1
/~RTD0_DRDY: U2.110 (PD9), U5.1 (~DRDY)
/~RTD1_DRDY: U2.111 (PC18), U7.1 (~DRDY)
Earth_Protective: J2.SH, J5.3, J6.3, JP3.2 (B), RV1.2, RV2.2
GND: C1.2, C2.2, C3.2, C4.2, C5.2, C6.2, C7.2, C8.2, C9.2, C10.2, C11.2, C12.1, C13.1, C14.2, C15.2, C16.2, C17.2, C18.2, C19.2, C20.2, C21.2, C22.2, C23.2, C24.2, C25.2, C26.2, C27.2, C28.2, C29.2, C30.2, C31.2, C32.2, C33.2, C34.2, C35.1, C36.1, C37.2, C38.2, C39.2, C40.2, C41.2, C42.2, C43.2, C44.2, C45.2, C46.2, C49.2, C50.2, C51.2, C52.2, C53.2, C54.2, C55.2, C58.2, C59.2, C60.2, C61.2, C62.2, C63.2, C64.2, C65.2, C66.2, C67.2, C68.2, C69.2, C70.2, C71.2, C72.2, C73.2, D3.3 (common), D20.2 (A), D21.2 (A), D22.2 (A), D23.2 (A), D24.2 (A), D25.2 (A), D26.2 (A), D27.2 (A), D32.2 (A), D33.2 (A), D35.1 (A1), J1.3 (GND), J1.5 (GND), J1.9 (GNDDetect), J2.5, J3.7, J3.9, J4.16, J4.18, J5.2, J6.2, J7.1, J8.1, JP3.1 (A), JP6.3 (B), JP11.3 (B), Q11.2 (E), R10.2, R24.2, R25.2, R36.1, R46.2, R47.2, R48.2, R49.2, R50.2, R51.2, R52.2, R53.2, R55.2, R57.2, R59.2, R61.2, R63.2, R65.2, R67.2, R69.2, R72.2, R73.2, R75.2, R77.2, R78.1, R79.1, R80.1, R81.1, RV2.1, S1.3, S1.4, U1.4 (A), U2.8 (GND), U2.44 (GND), U2.61 (GND), U2.95 (GND), U2.115 (GND), U2.135 (GND), U2.138 (GND), U3.2 (GND), U4.2 (GND), U5.13 (GND), U5.18 (DGND), U5.19 (GND), U6.5 (GND), U7.13 (GND), U7.18 (DGND), U7.19 (GND), U8.9 (GND), U9.7 (GND), U10.1 (~1OE), U10.10 (GND), U10.19 (~2OE), U11.3 (GND), U11.5 (~ON/OFF), Y1.2, Y1.4
MCV_CAN0_H: J8.10, JP5.2 (B), U4.7 (CANH)
MCV_CAN0_L: J8.11, R27.1, U4.6 (CANL)
MCV_CAN1_H: J8.8, JP4.2 (B), U3.7 (CANH)
MCV_CAN1_L: J8.9, R26.1, U3.6 (CANL)
MCV_RS_A: D3.1 (A1), J7.3, JP10.2 (B), R35.1, U6.6 (A)
MCV_RS_B: D3.2 (A2), J7.2, JP8.2 (B), JP9.1 (A), U6.7 (B)
MCV_RTD0_FORCE+: J7.7, JP6.1 (A), U5.8 (FORCE+)
MCV_RTD0_FORCE-: J7.4, U5.12 (FORCE-)
MCV_RTD0_RTDIN+: J7.6, JP7.2 (C), U5.10 (RTDIN+)
MCV_RTD0_RTDIN-: C47.1, C48.1, J7.5, U5.11 (RTDIN-)
MCV_RTD1_FORCE+: J7.11, JP11.1 (A), U7.8 (FORCE+)
MCV_RTD1_FORCE-: J7.8, U7.12 (FORCE-)
MCV_RTD1_RTDIN+: J7.10, JP12.2 (C), U7.10 (RTDIN+)
MCV_RTD1_RTDIN-: C56.1, C57.1, J7.9, U7.11 (RTDIN-)
unnamed: C9.1, J2.1, R6.1, RV1.1
unnamed: C34.1, R13.2
unnamed: D1.1 (K), J3.1, J3.2
unnamed: D2.1 (K), J4.19, J4.20
unnamed: D4.2 (A), R46.1
unnamed: D4.1 (K), Q1.1 (B)
unnamed: D5.2 (A), R47.1
unnamed: D5.1 (K), Q2.1 (B)
unnamed: D6.2 (A), R48.1
unnamed: D6.1 (K), Q3.1 (B)
unnamed: D7.2 (A), R49.1
unnamed: D7.1 (K), Q4.1 (B)
unnamed: D8.2 (A), R50.1
unnamed: D8.1 (K), Q5.1 (B)
unnamed: D9.2 (A), R51.1
unnamed: D9.1 (K), Q6.1 (B)
unnamed: D10.2 (A), R52.1
unnamed: D10.1 (K), Q7.1 (B)
unnamed: D11.2 (A), R53.1
unnamed: D11.1 (K), Q8.1 (B)
unnamed: D12.2 (A), Q1.3 (C)
unnamed: D12.1 (K), R54.1
unnamed: D13.2 (A), Q2.3 (C)
unnamed: D13.1 (K), R56.1
unnamed: D14.2 (A), Q3.3 (C)
unnamed: D14.1 (K), R58.1
unnamed: D15.2 (A), Q4.3 (C)
unnamed: D15.1 (K), R60.1
unnamed: D16.2 (A), Q5.3 (C)
unnamed: D16.1 (K), R62.1
unnamed: D17.2 (A), Q6.3 (C)
unnamed: D17.1 (K), R64.1
unnamed: D18.2 (A), Q7.3 (C)
unnamed: D18.1 (K), R66.1
unnamed: D19.2 (A), Q8.3 (C)
unnamed: D19.1 (K), R68.1
unnamed: D28.2 (A), R72.1
unnamed: D28.1 (K), Q9.1 (B)
unnamed: D29.2 (A), R73.1
unnamed: D29.1 (K), Q10.1 (B)
unnamed: D30.2 (A), Q9.3 (C)
unnamed: D30.1 (K), R74.1
unnamed: D31.2 (A), Q10.3 (C)
unnamed: D31.1 (K), R76.1
unnamed: D32.1 (K), R74.2, R75.1, U9.1 (I0)
unnamed: D33.1 (K), R76.2, R77.1, U9.3 (I1)
unnamed: D34.2 (A), F13.2
unnamed: D36.2 (A), R87.2
unnamed: D36.1 (K), Q11.3 (C)
unnamed: F9.2, R78.2, R82.1
unnamed: F10.2, R79.2, R83.1
unnamed: F11.2, R80.2, R84.1
unnamed: F12.2, R81.2, R85.1
unnamed: J1.8 (NC/TDI), R1.1, U2.105 (PB4)
unnamed: J1.4 (SWCLK/TCK), R3.1, U2.89 (PB7)
unnamed: J1.2 (SWDIO/TMS), R2.1, U2.79 (PB6)
unnamed: J1.6 (SWO/TDO), U2.109 (PB5)
unnamed: J1.10 (~RESET), R4.1
unnamed: J2.2, R7.1
unnamed: J2.3, R8.1
unnamed: JP1.2 (C), U2.26 (PB2)
unnamed: JP2.2 (C), U2.31 (PB3)
unnamed: JP4.1 (A), R26.2
unnamed: JP5.1 (A), R27.2
unnamed: JP6.2 (C), U5.9 (FORCE2)
unnamed: C48.2, JP7.1 (A)
unnamed: C47.2, JP7.3 (B)
unnamed: JP8.1 (A), R35.2
unnamed: JP9.2 (B), R34.2
unnamed: JP10.1 (A), R36.2
unnamed: JP11.2 (C), U7.9 (FORCE2)
unnamed: C57.2, JP12.1 (A)
unnamed: C56.2, JP12.3 (B)
unnamed: JP13.2 (C), U8.1 (1B)
unnamed: JP14.2 (C), U8.3 (3B)
unnamed: JP15.2 (C), U8.6 (6B)
unnamed: JP16.2 (C), U8.8 (8B)
unnamed: JP17.2 (C), U8.2 (2B)
unnamed: JP18.2 (C), U8.4 (4B)
unnamed: JP19.2 (C), U8.5 (5B)
unnamed: JP20.2 (C), U8.7 (7B)
unnamed: Q1.2 (E), R38.2
unnamed: Q2.2 (E), R39.2
unnamed: Q3.2 (E), R40.2
unnamed: Q4.2 (E), R41.2
unnamed: Q5.2 (E), R42.2
unnamed: Q6.2 (E), R43.2
unnamed: Q7.2 (E), R44.2
unnamed: Q8.2 (E), R45.2
unnamed: Q9.2 (E), R70.2
unnamed: Q10.2 (E), R71.2
unnamed: Q11.1 (B), R88.2, R89.1
unnamed: C4.1, U1.5 (FB)
unnamed: C6.1, C8.1, R5.2, U1.8 (K), U2.9 (ADVREFP)
unnamed: C35.2, U2.35 (PA7/PGMNVALID), Y2.2
unnamed: C36.2, U2.36 (PA8/PGMM0), Y2.1
unnamed: C12.2, U2.141 (PB8), Y1.3
unnamed: C13.2, U2.142 (PB9), Y1.1
unnamed: R7.2, U2.136 (PB10)
unnamed: R8.2, U2.137 (PB11)
unnamed: C2.1, C3.1, C5.1, C7.1, C10.1, C14.1, C15.1, C17.1, C18.1, C19.1, C20.1, C21.1, C22.1, C23.1, C24.1, C25.1, L1.2, U2.5 (VDDIN), U2.30 (VDDIO), U2.43 (VDDIO), U2.72 (VDDIO), U2.80 (VDDIO), U2.96 (VDDIO), U2.134 (VDDIO), U2.143 (VDDIO)
unnamed: C26.1, C27.1, C28.1, C29.1, C30.1, C31.1, C32.1, L2.1, U2.3 (VDDOUT), U2.29 (VDDCORE), U2.33 (VDDCORE), U2.50 (VDDCORE), U2.81 (VDDCORE), U2.107 (VDDCORE), U2.123 (VDDCORE)
unnamed: C33.1, L2.2, R13.1, U2.139 (VDDPLL)
unnamed: R14.2, R24.1, U3.1 (D)
unnamed: R16.2, R22.2, U3.5 (EN)
unnamed: R15.2, U3.4 (R)
unnamed: R17.2, U3.8 (Rs)
unnamed: C39.1, C41.1, L3.2, U3.3 (VCC)
unnamed: R18.2, R25.1, U4.1 (D)
unnamed: R20.2, R23.2, U4.5 (EN)
unnamed: R19.2, U4.4 (R)
unnamed: R21.2, U4.8 (Rs)
unnamed: C40.1, C42.1, L4.2, U4.3 (VCC)
unnamed: R28.1, U5.4 (BIAS), U5.5 (REFIN+)
unnamed: C43.1, C44.1, C45.1, C46.1, L5.2, U5.2 (DVDD), U5.3 (VDD)
unnamed: R28.2, U5.6 (REFIN-), U5.7 (ISENSOR)
unnamed: R31.2, U6.3 (DE)
unnamed: R32.2, U6.4 (DI)
unnamed: R29.2, R33.2, U6.1 (RO)
unnamed: C50.1, C51.1, L6.2, U6.8 (VCC)
unnamed: R30.2, U6.2 (~RE)
unnamed: R37.1, U7.4 (BIAS), U7.5 (REFIN+)
unnamed: C52.1, C53.1, C54.1, C55.1, L7.2, U7.2 (DVDD), U7.3 (VDD)
unnamed: R37.2, U7.6 (REFIN-), U7.7 (ISENSOR)
unnamed: F1.1, U8.20 (1C)
unnamed: F2.1, U8.19 (2C)
unnamed: F3.1, U8.18 (3C)
unnamed: F4.1, U8.17 (4C)
unnamed: F5.1, U8.16 (5C)
unnamed: F6.1, U8.15 (6C)
unnamed: F7.1, U8.14 (7C)
unnamed: F8.1, U8.13 (8C)
unnamed: C59.1, C60.1, L8.2, U9.14 (VCC)
unnamed: C61.1, C62.1, L9.2, U10.20 (VCC)
unnamed: C69.1, C70.1, L10.2, R86.1, U11.4 (FB)
unnamed: L10.1, U11.2 (OUT)
VIN_24V: F13.1, J5.1, J6.1
