nicolaeandreivasile/plc-embedded-application/board-design/kicad-files/ESP32-PLC/ESP32-PLC.kicad_pcb

## KiCad design board-design/kicad-files/ESP32-PLC/ESP32-PLC.kicad_pcb (2026-04-05)

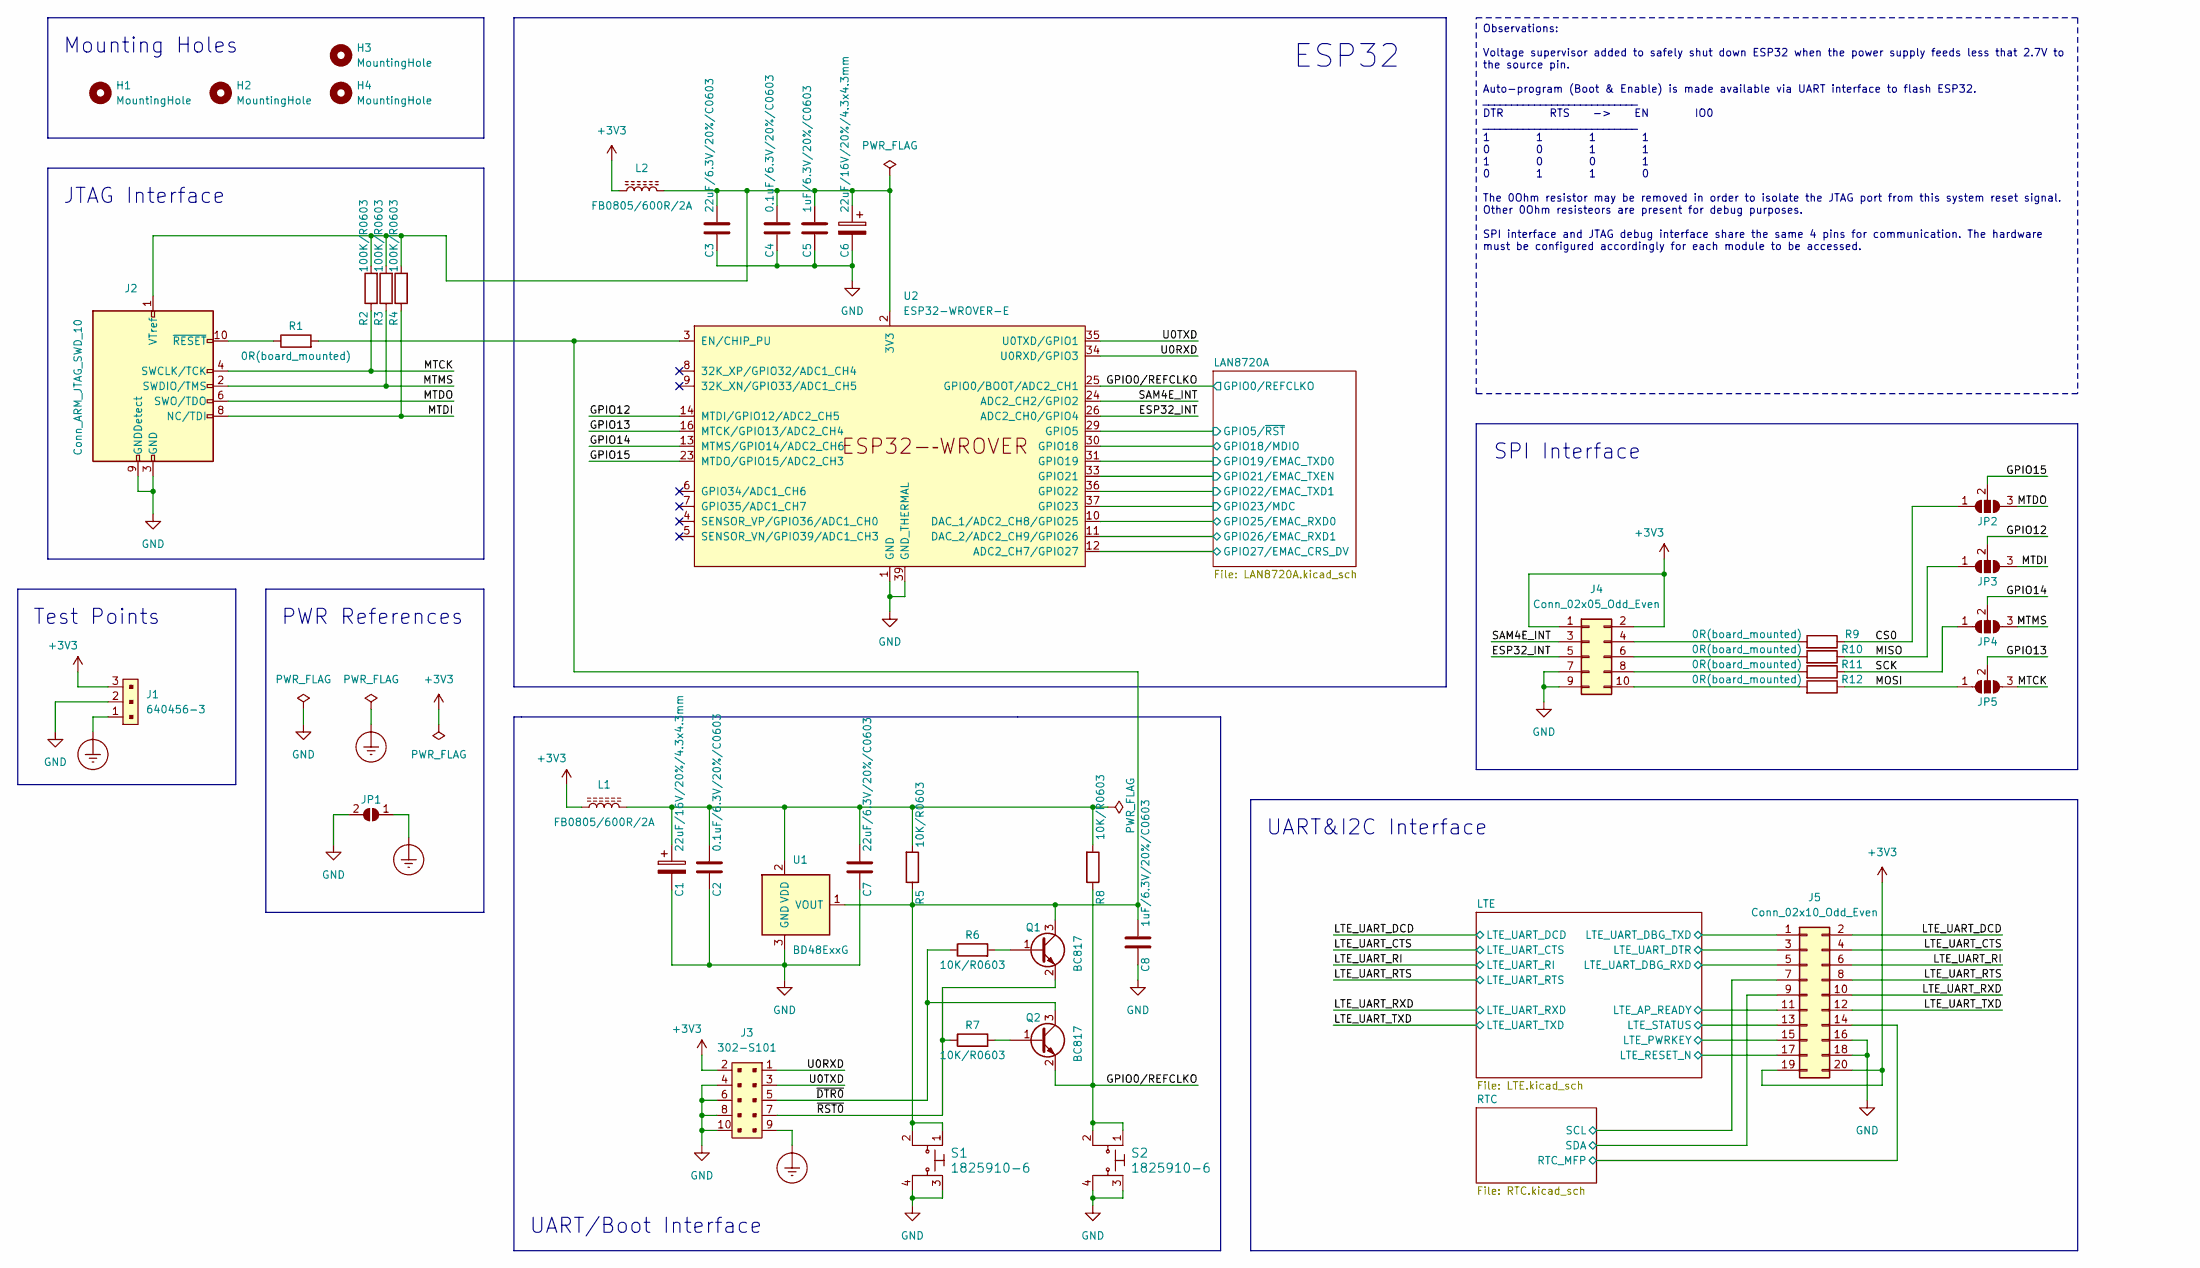
[picture p109: schematic ESP32-PLC.kicad_sch, ESP32]

Parts:
C1, C6: 22uF/16V/20%/4.3x4.3mm; CP_Elec_4x5.4
C2, C4: 0.1uF/6.3V/20%/C0603; C_0603_1608Metric
C3, C7: 22uF/6.3V/20%/C0603; C_0603_1608Metric
C5, C8: 1uF/6.3V/20%/C0603; C_0603_1608Metric
H1, H2, H3, H4: MountingHole; MountingHole_2.5mm_Pad_Via
J1: 640456-3; PinHeader_1x3_P2.54_Drill1.1mm; MPN 640456-3; Digi-Key_PN A19470-ND
J2: Conn_ARM_JTAG_SWD_10; PinHeader_2x05_P2.54mm_Vertical
J3: 302-S101; IDC-Header_2x05_P2.54mm_Vertical; MPN 302-S101; Digi-Key_PN ED1543-ND
J4: Conn_02x05_Odd_Even; IDC-Header_2x05_P2.54mm_Vertical
J5: Conn_02x10_Odd_Even; IDC-Header_2x10_P2.54mm_Vertical
JP1: SolderJumper_2_Open; SolderJumper-2_P1.3mm_Open_Pad1.0x1.5mm
JP2, JP3, JP4, JP5: SolderJumper_3_Open; SolderJumper-3_P1.3mm_Open_Pad1.0x1.5mm
L1, L2: FB0805/600R/2A; L_0805_2012Metric
Q1, Q2: BC817; SOT-23
R1, R9, R10, R11, R12: 0R(board_mounted); R_0402_1005Metric
R2, R3, R4: 100K/R0603; R_0603_1608Metric
R5, R6, R7, R8: 10K/R0603; R_0603_1608Metric
S1, S2: 1825910-6; Switch_Tactile_THT_6x6mm; MPN 1825910-6; Digi-Key_PN 450-1650-ND
U1: BD48ExxG; SOT-23-5
U2: ESP32-WROVER-E

Connections:
+3V3: J1.3, J3.2, J4.1, J4.2, J5.19, J5.20, L1.1, L2.1; also elsewhere on the board
/CS0: JP2.1 (A), R9.1
/ESP32_INT: J4.5, U2.26 (ADC2_CH0/GPIO4)
/GPIO0/REFCLKO: Q2.2 (E), R8.1, S2.1, S2.2, U2.25 (GPIO0/BOOT/ADC2_CH1); also elsewhere on the board
/GPIO12: JP3.2 (C), U2.14 (MTDI/GPIO12/ADC2_CH5)
/GPIO13: JP5.2 (C), U2.16 (MTCK/GPIO13/ADC2_CH4)
/GPIO14: JP4.2 (C), U2.13 (MTMS/GPIO14/ADC2_CH6)
/GPIO15: JP2.2 (C), U2.23 (MTDO/GPIO15/ADC2_CH3)
/LAN8720A/GPIO5/~RST: U2.29 (GPIO5); also elsewhere on the board
/LAN8720A/GPIO18/MDIO: U2.30 (GPIO18); also elsewhere on the board
/LAN8720A/GPIO19/EMAC_TXD0: U2.31 (GPIO19); also elsewhere on the board
/LAN8720A/GPIO21/EMAC_TXEN: U2.33 (GPIO21); also elsewhere on the board
/LAN8720A/GPIO22/EMAC_TXD1: U2.36 (GPIO22); also elsewhere on the board
/LAN8720A/GPIO23/MDC: U2.37 (GPIO23); also elsewhere on the board
/LAN8720A/GPIO25/EMAC_RXD0: U2.10 (DAC_1/ADC2_CH8/GPIO25); also elsewhere on the board
/LAN8720A/GPIO26/EMAC_RXD1: U2.11 (DAC_2/ADC2_CH9/GPIO26); also elsewhere on the board
/LAN8720A/GPIO27/EMAC_CRS_DV: U2.12 (ADC2_CH7/GPIO27); also elsewhere on the board
/LTE/LTE_AP_READY: J5.11; also elsewhere on the board
/LTE/LTE_PWRKEY: J5.15; also elsewhere on the board
/LTE/LTE_RESET_N: J5.17; also elsewhere on the board
/LTE/LTE_STATUS: J5.13; also elsewhere on the board
/LTE/LTE_UART_DBG_RXD: J5.5; also elsewhere on the board
/LTE/LTE_UART_DBG_TXD: J5.1; also elsewhere on the board
/LTE/LTE_UART_DTR: J5.3; also elsewhere on the board
/LTE_UART_CTS: J5.4; also elsewhere on the board
/LTE_UART_DCD: J5.2; also elsewhere on the board
/LTE_UART_RI: J5.6; also elsewhere on the board
/LTE_UART_RTS: J5.8; also elsewhere on the board
/LTE_UART_RXD: J5.10; also elsewhere on the board
/LTE_UART_TXD: J5.12; also elsewhere on the board
/MISO: JP3.1 (A), R10.1
/MOSI: JP5.1 (A), R12.1
/MTCK: J2.4 (SWCLK/TCK), JP5.3 (B), R2.1
/MTDI: J2.8 (NC/TDI), JP3.3 (B), R4.1
/MTDO: J2.6 (SWO/TDO), JP2.3 (B)
/MTMS: J2.2 (SWDIO/TMS), JP4.3 (B), R3.1
/RTC/RTC_MFP: J5.14; also elsewhere on the board
/RTC/SCL: J5.7; also elsewhere on the board
/RTC/SDA: J5.9; also elsewhere on the board
/SAM4E_INT: J4.3, U2.24 (ADC2_CH2/GPIO2)
/SCK: JP4.1 (A), R11.1
/U0RXD: J3.1, U2.34 (U0RXD/GPIO3)
/U0TXD: J3.3, U2.35 (U0TXD/GPIO1)
/~DTR0: J3.5, Q2.3 (C), R6.1
/~RST0: J3.7, Q1.2 (E), R7.1
Earth_Protective: J1.1, J3.9, JP1.1 (A); also elsewhere on the board
GND: C1.2, C2.2, C3.2, C4.2, C5.2, C6.2, C7.2, C8.2, J1.2, J2.3 (GND), J2.5 (GND), J2.9 (GNDDetect), J3.4, J3.6, J3.8, J3.10, J4.7, J4.9, J5.16, J5.18, JP1.2 (B), S1.3, S1.4, S2.3, S2.4, U1.3 (GND), U2.1 (GND), U2.15 (GND), U2.38 (GND), U2.39 (GND_THERMAL); also elsewhere on the board
unnamed: C3.1, C4.1, C5.1, C6.1, J2.1 (VTref), L2.2, R2.2, R3.2, R4.2, U2.2 (3V3)
unnamed: J2.10 (~RESET), R1.1
unnamed: J4.4, R9.2
unnamed: J4.6, R10.2
unnamed: J4.8, R11.2
unnamed: J4.10, R12.2
unnamed: Q1.1 (B), R6.2
unnamed: C8.1, Q1.3 (C), R1.2, R5.1, S1.1, S1.2, U1.1 (VOUT), U2.3 (EN/CHIP_PU)
unnamed: Q2.1 (B), R7.2
unnamed: C1.1, C2.1, C7.1, L1.2, R5.2, R8.2, U1.2 (VDD)

Notes on the sheet:
Observations: Voltage supervisor added to safely shut down ESP32 when the power supply feeds less that 2.7V to the source pin. Auto-program (Boot & Enable) is made available via UART interface to flash ESP32. ___________________________ DTR RTS -> EN IO0 ___________________________ 1 1 1 1 0 0 1 1 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
SPI Interface
UART/Boot Interface
Test Points
ESP32
PWR References
Mounting Holes
JTAG Interface
UART&I2C Interface

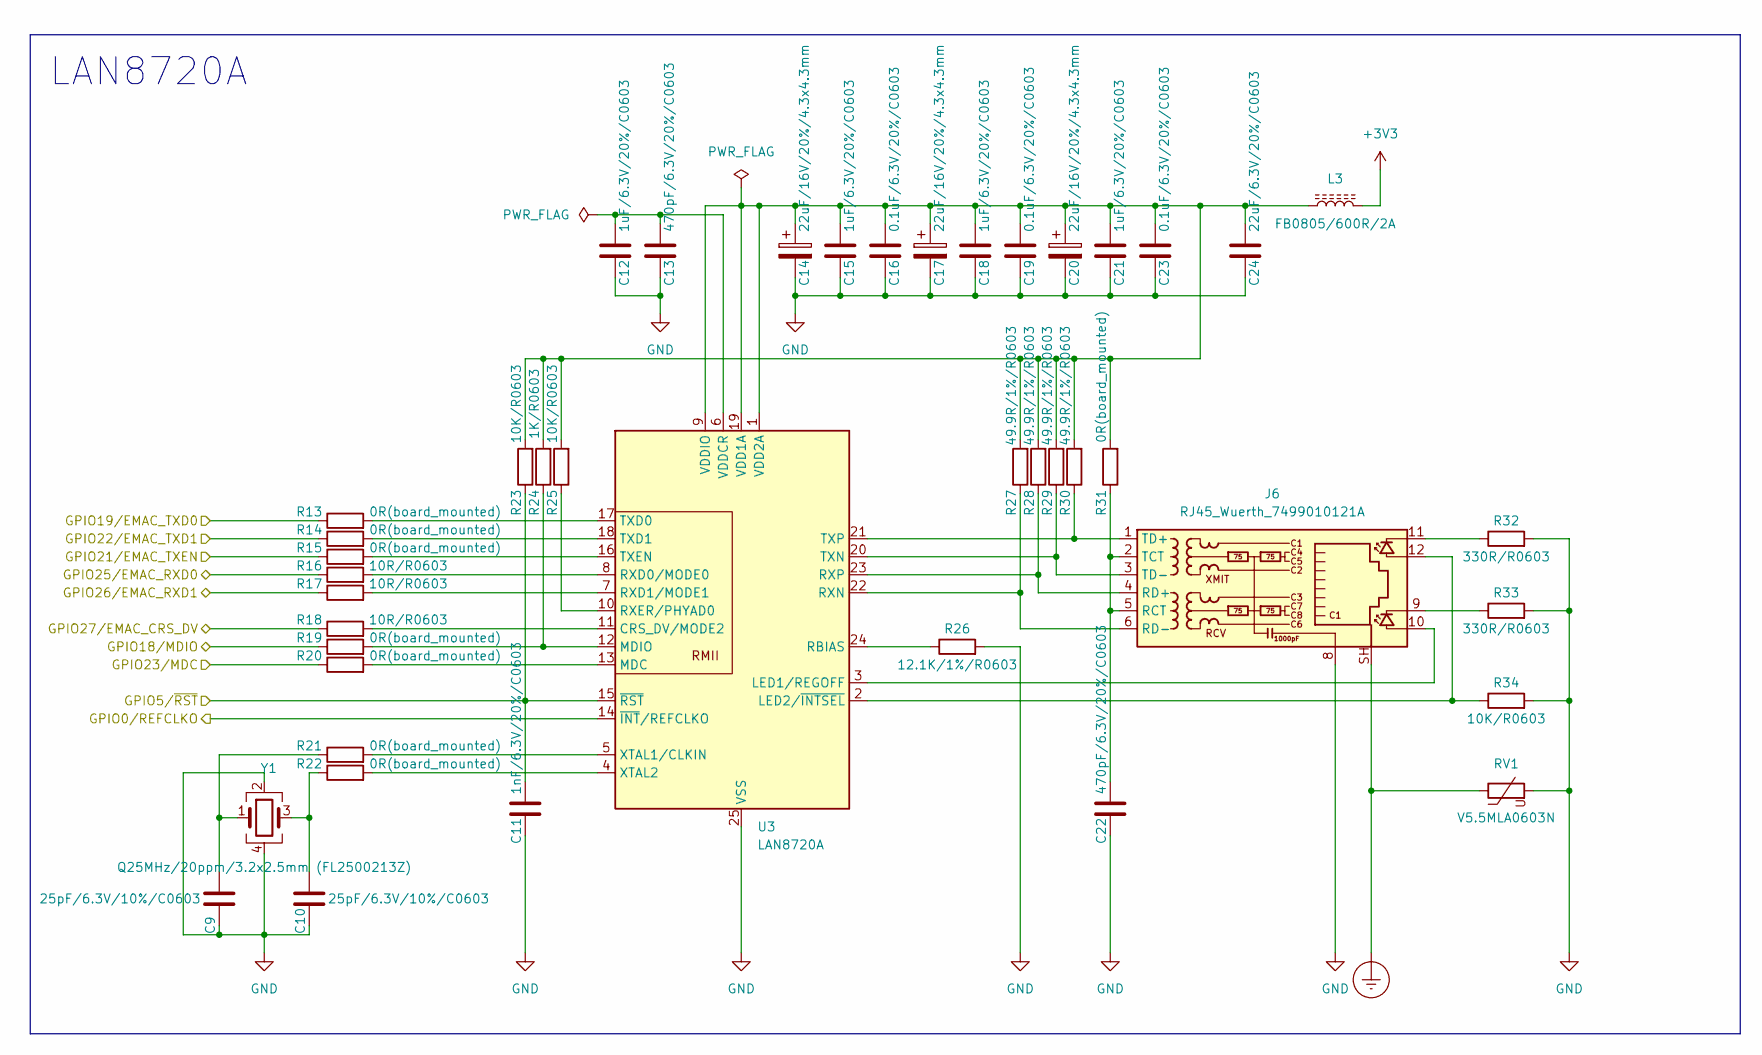
[picture p110: schematic LAN8720A.kicad_sch, ESP32]

Parts:
C9, C10: 25pF/6.3V/10%/C0603; C_0603_1608Metric
C11: 1nF/6.3V/20%/C0603; C_0603_1608Metric
C12, C15, C18, C21: 1uF/6.3V/20%/C0603; C_0603_1608Metric
C13, C22: 470pF/6.3V/20%/C0603; C_0603_1608Metric
C14, C17, C20: 22uF/16V/20%/4.3x4.3mm; CP_Elec_4x5.4
C16, C19, C23: 0.1uF/6.3V/20%/C0603; C_0603_1608Metric
C24: 22uF/6.3V/20%/C0603; C_0603_1608Metric
J6: RJ45_Wuerth_7499010121A; RJ45_Wuerth_7499010121A_Horizontal
L3: FB0805/600R/2A; L_0805_2012Metric
R13, R14, R15, R19, R20, R21, R22, R31: 0R(board_mounted); R_0402_1005Metric
R16, R17, R18: 10R/R0603; R_0603_1608Metric
R23, R25, R34: 10K/R0603; R_0603_1608Metric
R24: 1K/R0603; R_0603_1608Metric
R26: 12.1K/1%/R0603; R_0603_1608Metric
R27, R28, R29, R30: 49.9R/1%/R0603; R_0603_1608Metric
R32, R33: 330R/R0603; R_0603_1608Metric
RV1: V5.5MLA0603N; R_0603_1608Metric
U3: LAN8720A; VQFN-24-1EP_4x4mm_P0.5mm_EP2.5x2.5mm_ThermalVias
Y1: Q25MHz/20ppm/3.2x2.5mm (FL2500213Z); Crystal_SMD_3225-4Pin_3.2x2.5mm

Connections:
+3V3: L3.2; also elsewhere on the board
/GPIO0/REFCLKO: U3.14 (~INT/REFCLKO); also elsewhere on the board
/LAN8720A/GPIO5/~RST: C11.1, R23.1, U3.15 (~RST); also elsewhere on the board
/LAN8720A/GPIO18/MDIO: R19.1; also elsewhere on the board
/LAN8720A/GPIO19/EMAC_TXD0: R13.1; also elsewhere on the board
/LAN8720A/GPIO21/EMAC_TXEN: R15.1; also elsewhere on the board
/LAN8720A/GPIO22/EMAC_TXD1: R14.1; also elsewhere on the board
/LAN8720A/GPIO23/MDC: R20.1; also elsewhere on the board
/LAN8720A/GPIO25/EMAC_RXD0: R16.1; also elsewhere on the board
/LAN8720A/GPIO26/EMAC_RXD1: R17.1; also elsewhere on the board
/LAN8720A/GPIO27/EMAC_CRS_DV: R18.1; also elsewhere on the board
Earth_Protective: J6.SH, RV1.1; also elsewhere on the board
GND: C9.2, C10.2, C11.2, C12.2, C13.2, C14.2, C15.2, C16.2, C17.2, C18.2, C19.2, C20.2, C21.2, C22.2, C23.2, C24.2, J6.8, R26.2, R32.2, R33.2, R34.2, RV1.2, U3.25 (VSS), Y1.2, Y1.4; also elsewhere on the board
unnamed: C9.1, R21.1, Y1.1
unnamed: C10.1, R22.1, Y1.3
unnamed: J6.9, R33.1
unnamed: J6.11, R32.1
unnamed: C22.1, J6.2 (TCT), J6.5 (RCT), R31.1
unnamed: J6.4 (RD+), R28.1, U3.23 (RXP)
unnamed: J6.6 (RD-), R27.1, U3.22 (RXN)
unnamed: J6.1 (TD+), R30.1, U3.21 (TXP)
unnamed: J6.3 (TD-), R29.1, U3.20 (TXN)
unnamed: R18.2, U3.11 (CRS_DV/MODE2)
unnamed: J6.10, U3.3 (LED1/REGOFF)
unnamed: J6.12, R34.1, U3.2 (LED2/~INTSEL)
unnamed: R20.2, U3.13 (MDC)
unnamed: R19.2, R24.1, U3.12 (MDIO)
unnamed: R26.1, U3.24 (RBIAS)
unnamed: R16.2, U3.8 (RXD0/MODE0)
unnamed: R17.2, U3.7 (RXD1/MODE1)
unnamed: R25.1, U3.10 (RXER/PHYAD0)
unnamed: R13.2, U3.17 (TXD0)
unnamed: R14.2, U3.18 (TXD1)
unnamed: R15.2, U3.16 (TXEN)
unnamed: C14.1, C15.1, C16.1, C17.1, C18.1, C19.1, C20.1, C21.1, C23.1, C24.1, L3.1, R23.2, R24.2, R25.2, R27.2, R28.2, R29.2, R30.2, R31.2, U3.1 (VDD2A), U3.9 (VDDIO), U3.19 (VDD1A)
unnamed: C12.1, C13.1, U3.6 (VDDCR)
unnamed: R21.2, U3.5 (XTAL1/CLKIN)
unnamed: R22.2, U3.4 (XTAL2)

Notes on the sheet:
LAN8720A
