nicolaeandreivasile/plc-embedded-application/board-design/kicad-files/ESP32-PLC/ESP32-PLC.kicad_pcb

## KiCad design board-design/kicad-files/ESP32-PLC/ESP32-PLC.kicad_pcb (continued)

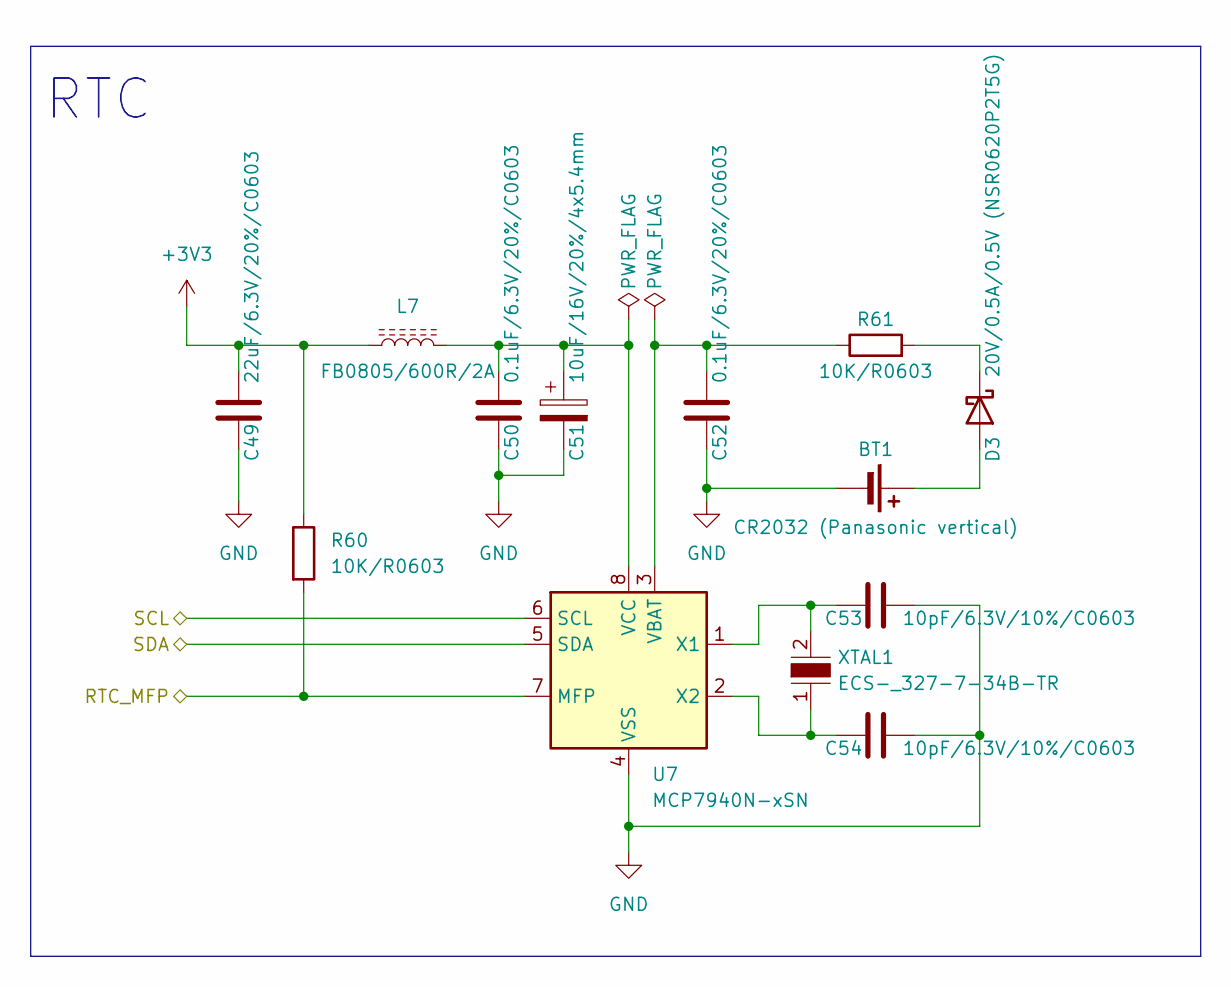
[picture p111: schematic RTC.kicad_sch, ESP32]

Parts:
BT1: CR2032 (Panasonic vertical); Battery_Panasonic_CR2032-VS1N_Vertical_CircularHoles
C49: 22uF/6.3V/20%/C0603; C_0603_1608Metric
C50, C52: 0.1uF/6.3V/20%/C0603; C_0603_1608Metric
C51: 10uF/16V/20%/4x5.4mm; CP_Elec_4x5.4
C53, C54: 10pF/6.3V/10%/C0603; C_0603_1608Metric
D3: 20V/0.5A/0.5V (NSR0620P2T5G); D_SOD-923
L7: FB0805/600R/2A; L_0805_2012Metric
R60, R61: 10K/R0603; R_0603_1608Metric
U7: MCP7940N-xSN; SOIC-8_3.9x4.9mm_P1.27mm
XTAL1: ECS-_327-7-34B-TR; SMD-2_3.2x1.5mm; MPN ECS-.327-12.5-34B-TR; Digi-Key_PN XC1617CT-ND

Connections:
+3V3: C49.1, L7.1, R60.1; also elsewhere on the board
/RTC/RTC_MFP: R60.2, U7.7 (MFP); also elsewhere on the board
/RTC/SCL: U7.6 (SCL); also elsewhere on the board
/RTC/SDA: U7.5 (SDA); also elsewhere on the board
GND: BT1.2 (-), C49.2, C50.2, C51.2, C52.2, C53.1, C54.1, U7.4 (VSS); also elsewhere on the board
unnamed: BT1.1 (+), D3.2 (A)
unnamed: D3.1 (K), R61.2
unnamed: C52.1, R61.1, U7.3 (VBAT)
unnamed: C50.1, C51.1, L7.2, U7.8 (VCC)
unnamed: C53.2, U7.1 (X1), XTAL1.2
unnamed: C54.2, U7.2 (X2), XTAL1.1

Notes on the sheet:
RTC

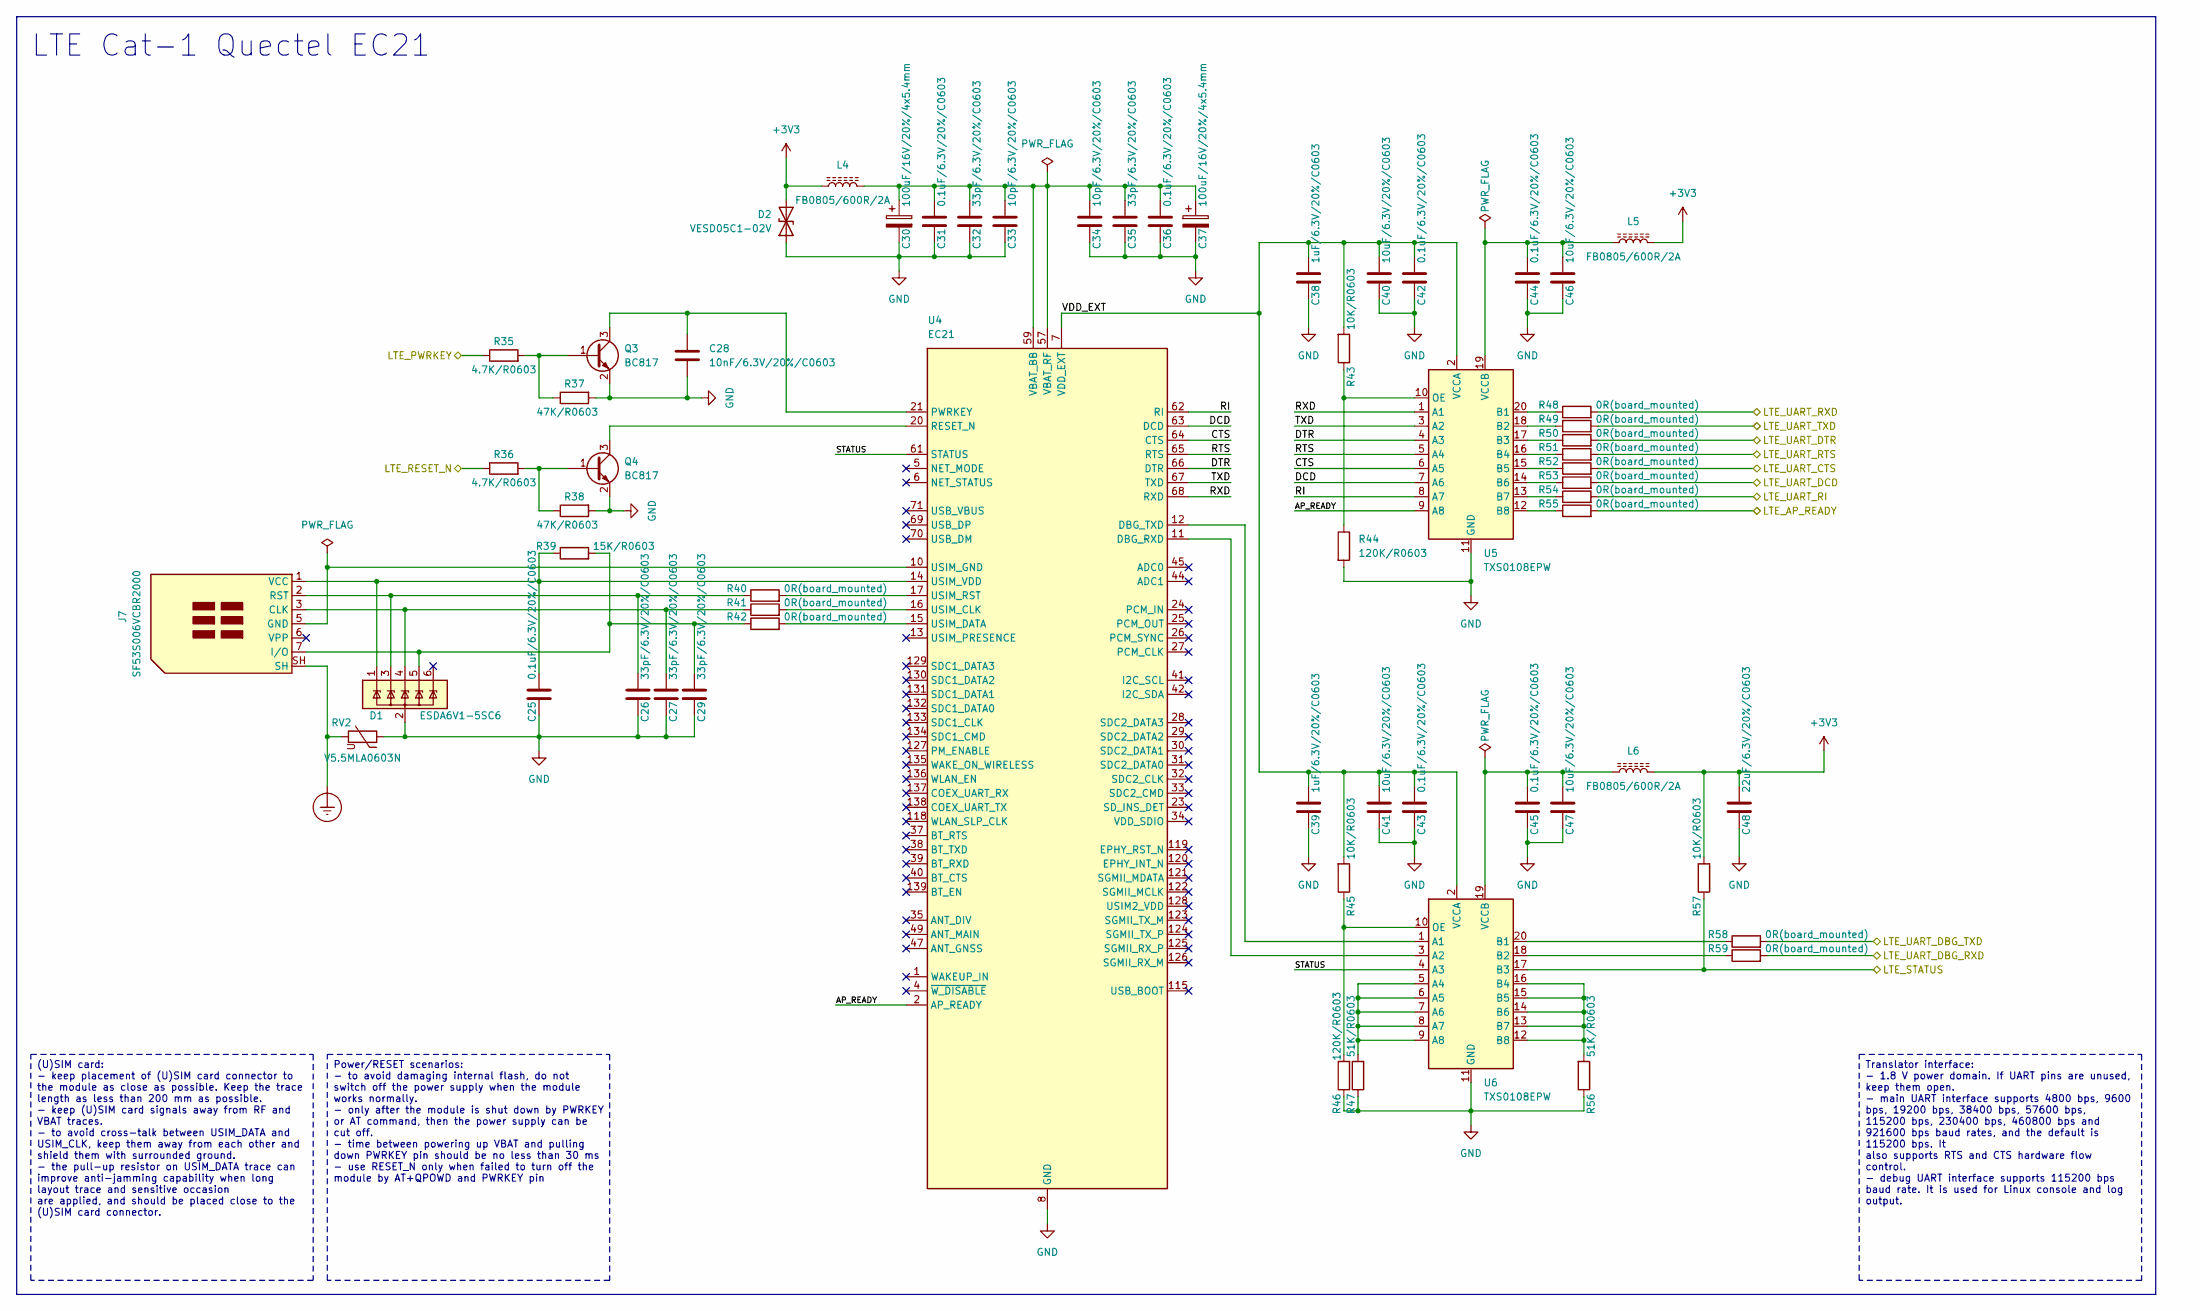
[picture p112: schematic LTE.kicad_sch, ESP32]

Parts:
C25, C31, C36, C42, C43, C44, C45: 0.1uF/6.3V/20%/C0603; C_0603_1608Metric
C26, C27, C29, C32, C35: 33pF/6.3V/20%/C0603; C_0603_1608Metric
C28: 10nF/6.3V/20%/C0603; C_0603_1608Metric
C30, C37: 100uF/16V/20%/4x5.4mm; CP_Elec_4x5.4
C33, C34: 10pF/6.3V/20%/C0603; C_0603_1608Metric
C38, C39: 1uF/6.3V/20%/C0603; C_0603_1608Metric
C40, C41, C46, C47: 10uF/6.3V/20%/C0603; C_0603_1608Metric
C48: 22uF/6.3V/20%/C0603; C_0603_1608Metric
D1: ESDA6V1-5SC6; SOT-23-6
D2: VESD05C1-02V; D_SOD-523
J7: SF53S006VCBR2000; microSIM_JAE_SF53S006VCBR2000
L4, L5, L6: FB0805/600R/2A; L_0805_2012Metric
Q3, Q4: BC817; SOT-23
R35, R36: 4.7K/R0603; R_0603_1608Metric
R37, R38: 47K/R0603; R_0603_1608Metric
R39: 15K/R0603; R_0603_1608Metric
R40, R41, R42, R48, R49, R50, R51, R52, R53, R54, R55, R58, R59: 0R(board_mounted); R_0402_1005Metric
R43, R45, R57: 10K/R0603; R_0603_1608Metric
R44, R46: 120K/R0603; R_0603_1608Metric
R47, R56: 51K/R0603; R_0603_1608Metric
RV2: V5.5MLA0603N; R_0603_1608Metric
U4: EC21; Quectel_EC21_L29.0mm_W32.0mm
U5, U6: TXS0108EPW; TSSOP-20_4.4x6.5mm_P0.65mm

Connections:
+3V3: C48.1, D2.2 (A2), L4.1, L5.2, L6.2, R57.2; also elsewhere on the board
/LTE/AP_READY: U4.2 (AP_READY), U5.9 (A8)
/LTE/CTS: U4.64 (CTS), U5.6 (A5)
/LTE/DCD: U4.63 (DCD), U5.7 (A6)
/LTE/DTR: U4.66 (DTR), U5.4 (A3)
/LTE/LTE_AP_READY: R55.2; also elsewhere on the board
/LTE/LTE_PWRKEY: R35.1; also elsewhere on the board
/LTE/LTE_RESET_N: R36.1; also elsewhere on the board
/LTE/LTE_STATUS: R57.1, U6.17 (B3); also elsewhere on the board
/LTE/LTE_UART_DBG_RXD: R59.2; also elsewhere on the board
/LTE/LTE_UART_DBG_TXD: R58.2; also elsewhere on the board
/LTE/LTE_UART_DTR: R50.2; also elsewhere on the board
/LTE/RI: U4.62 (RI), U5.8 (A7)
/LTE/RTS: U4.65 (RTS), U5.5 (A4)
/LTE/RXD: U4.68 (RXD), U5.1 (A1)
/LTE/STATUS: U4.61 (STATUS), U6.4 (A3)
/LTE/TXD: U4.67 (TXD), U5.3 (A2)
/LTE/VDD_EXT: C38.1, C39.1, C40.1, C41.1, C42.1, C43.1, R43.2, R45.2, U4.7 (VDD_EXT), U5.2 (VCCA), U6.2 (VCCA)
/LTE_UART_CTS: R52.2; also elsewhere on the board
/LTE_UART_DCD: R53.2; also elsewhere on the board
/LTE_UART_RI: R54.2; also elsewhere on the board
/LTE_UART_RTS: R51.2; also elsewhere on the board
/LTE_UART_RXD: R48.2; also elsewhere on the board
/LTE_UART_TXD: R49.2; also elsewhere on the board
Earth_Protective: J7.SH, RV2.2; also elsewhere on the board
GND: C25.2, C26.2, C27.2, C28.2, C29.2, C30.2, C31.2, C32.2, C33.2, C34.2, C35.2, C36.2, C37.2, C38.2, C39.2, C40.2, C41.2, C42.2, C43.2, C44.2, C45.2, C46.2, C47.2, C48.2, D1.2 (GND), D2.1 (A1), Q3.2 (E), Q4.2 (E), R37.2, R38.2, R44.2, R46.1, R47.1, R56.1, RV2.1, U4.8 (GND), U4.9 (GND), U4.19 (GND), U4.22 (GND), U4.36 (GND), U4.46 (GND), U4.48 (GND), U4.50 (GND), U4.51 (GND), U4.52 (GND), U4.53 (GND), U4.54 (GND), U4.56 (GND), U4.72 (GND), U4.85 (GND), U4.86 (GND), U4.87 (GND), U4.88 (GND), U4.89 (GND), U4.90 (GND), U4.91 (GND), U4.92 (GND), U4.93 (GND), U4.94 (GND), U4.95 (GND), U4.96 (GND), U4.97 (GND), U4.98 (GND), U4.99 (GND), U4.100 (GND), U4.101 (GND), U4.102 (GND), U4.103 (GND), U4.104 (GND), U4.105 (GND), U4.106 (GND), U4.107 (GND), U4.108 (GND), U4.109 (GND), U4.110 (GND), U4.111 (GND), U4.112 (GND), U5.11 (GND), U6.11 (GND); also elsewhere on the board
unnamed: C30.1, C31.1, C32.1, C33.1, C34.1, C35.1, C36.1, C37.1, L4.2, U4.57 (VBAT_RF), U4.58 (VBAT_RF), U4.59 (VBAT_BB), U4.60 (VBAT_BB)
unnamed: C25.1, D1.1 (IO1), J7.1 (VCC), R39.1, U4.14 (USIM_VDD)
unnamed: C26.1, D1.3 (IO2), J7.2 (RST), R40.1
unnamed: C27.1, D1.4 (IO3), J7.3 (CLK), R41.1
unnamed: C29.1, D1.5 (IO4), J7.7 (I/O), R39.2, R42.1
unnamed: J7.5 (GND), U4.10 (USIM_GND)
unnamed: Q3.1 (B), R35.2, R37.1
unnamed: C28.1, Q3.3 (C), U4.21 (PWRKEY)
unnamed: Q4.1 (B), R36.2, R38.1
unnamed: Q4.3 (C), U4.20 (RESET_N)
unnamed: U4.11 (DBG_RXD), U6.3 (A2)
unnamed: U4.12 (DBG_TXD), U6.1 (A1)
unnamed: R41.2, U4.16 (USIM_CLK)
unnamed: R42.2, U4.15 (USIM_DATA)
unnamed: R40.2, U4.17 (USIM_RST)
unnamed: R48.1, U5.20 (B1)
unnamed: R49.1, U5.18 (B2)
unnamed: R50.1, U5.17 (B3)
unnamed: R51.1, U5.16 (B4)
unnamed: R52.1, U5.15 (B5)
unnamed: R53.1, U5.14 (B6)
unnamed: R54.1, U5.13 (B7)
unnamed: R55.1, U5.12 (B8)
unnamed: R43.1, R44.1, U5.10 (OE)
unnamed: C44.1, C46.1, L5.1, U5.19 (VCCB)
unnamed: R47.2, U6.5 (A4), U6.6 (A5), U6.7 (A6), U6.8 (A7), U6.9 (A8)
unnamed: R58.1, U6.20 (B1)
unnamed: R59.1, U6.18 (B2)
unnamed: R56.2, U6.12 (B8), U6.13 (B7), U6.14 (B6), U6.15 (B5), U6.16 (B4)
unnamed: R45.1, R46.2, U6.10 (OE)
unnamed: C45.1, C47.1, L6.1, U6.19 (VCCB)

Notes on the sheet:
(U)SIM card: - keep placement of (U)SIM card connector to the module as close as possible. Keep the trace length as less than 200 mm as possible. - keep (U)SIM card signals away from RF and VBAT traces. - to avoid cross-talk between USIM_DATA and USIM_CLK, keep them away from each other and shield 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
Translator interface: - 1.8 V power domain. If UART pins are unused, keep them open. - main UART interface supports 4800 bps, 9600 bps, 19200 bps, 38400 bps, 57600 bps, 115200 bps, 230400 bps, 460800 bps and 921600 bps baud rates, and the default is 115200 bps. It also supports RTS and CTS hardware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
Power/RESET scenarios: - to avoid damaging internal flash, do not switch off the power supply when the module works normally. - only after the module is shut down by PWRKEY or AT command, then the power supply can be cut off. - time between powering up VBAT and pulling down PWRKEY pin should be no 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
LTE Cat-1 Quectel EC21

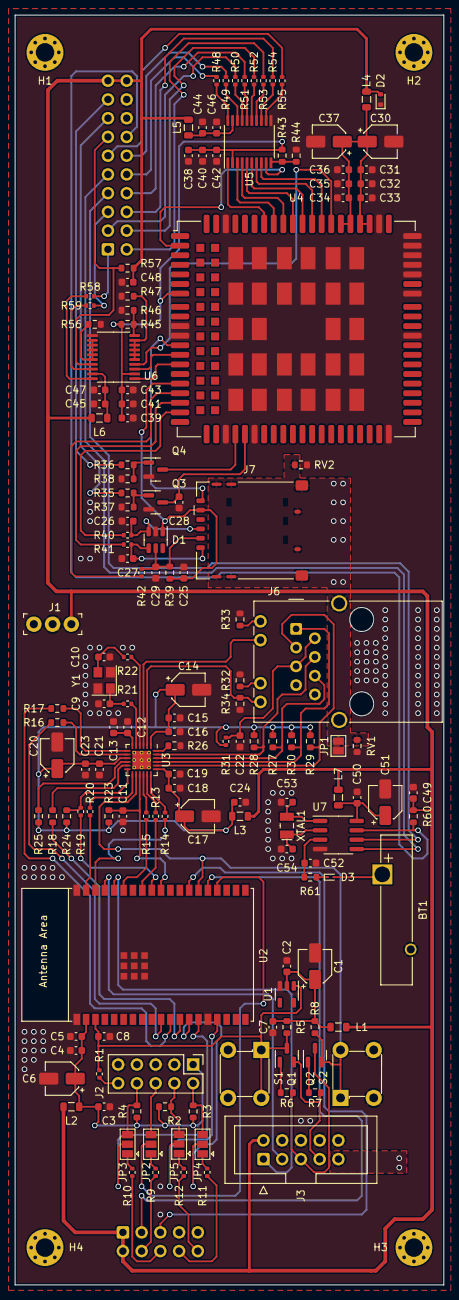
[picture p113: board ESP32-PLC.kicad_pcb from above]

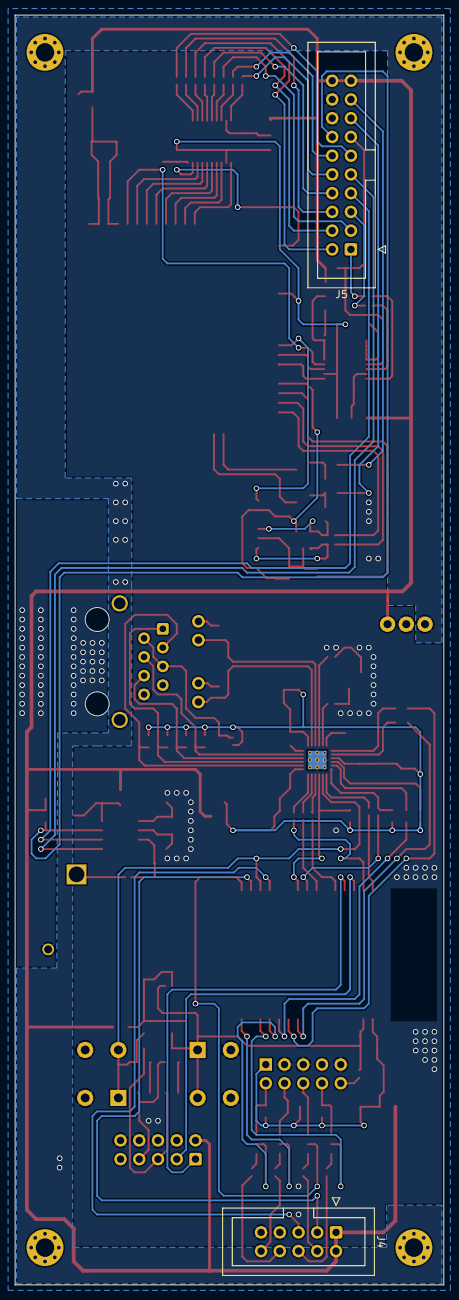
[picture p114: board ESP32-PLC.kicad_pcb from below]

Board: 2 copper layers, 58.1 x 172.1 mm, 159 parts (2 on the bottom side), 129 nets.
