nicolaeandreivasile/plc-embedded-application/board-design/eagle-files/ESP32-PLC/plc_esp32.brd

## EAGLE design board-design/eagle-files/ESP32-PLC/plc_esp32.brd (2026-04-05)

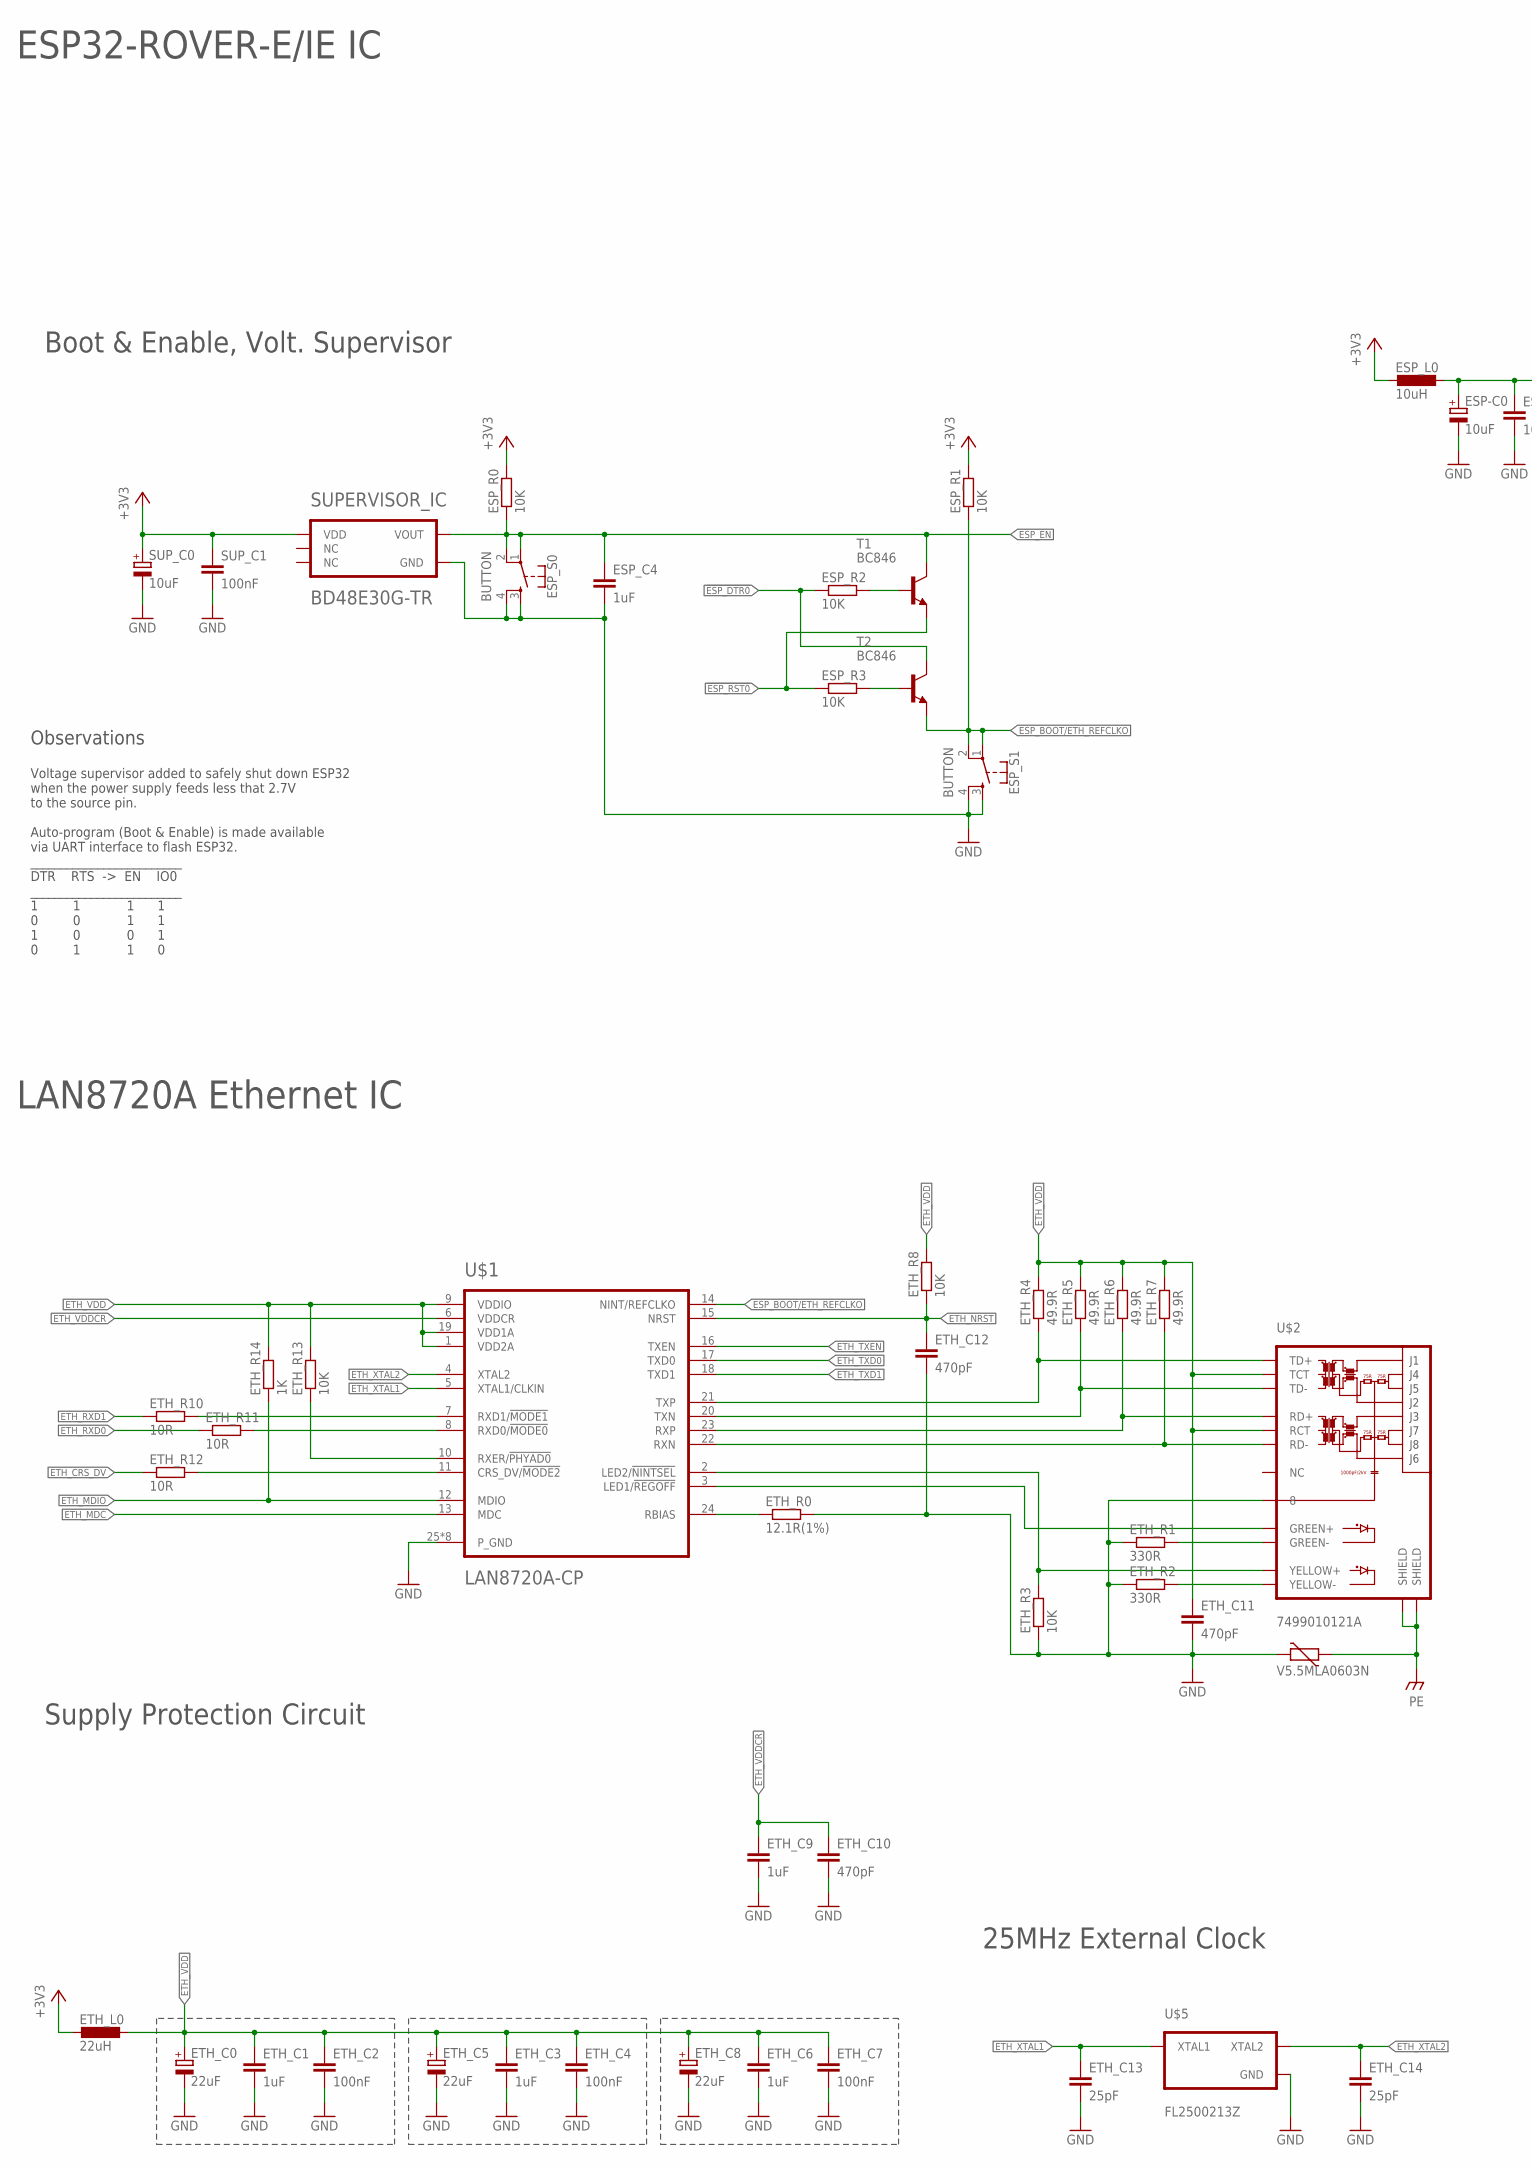
[picture p115: schematic plc_esp32.sch, part in row 1, column 1]

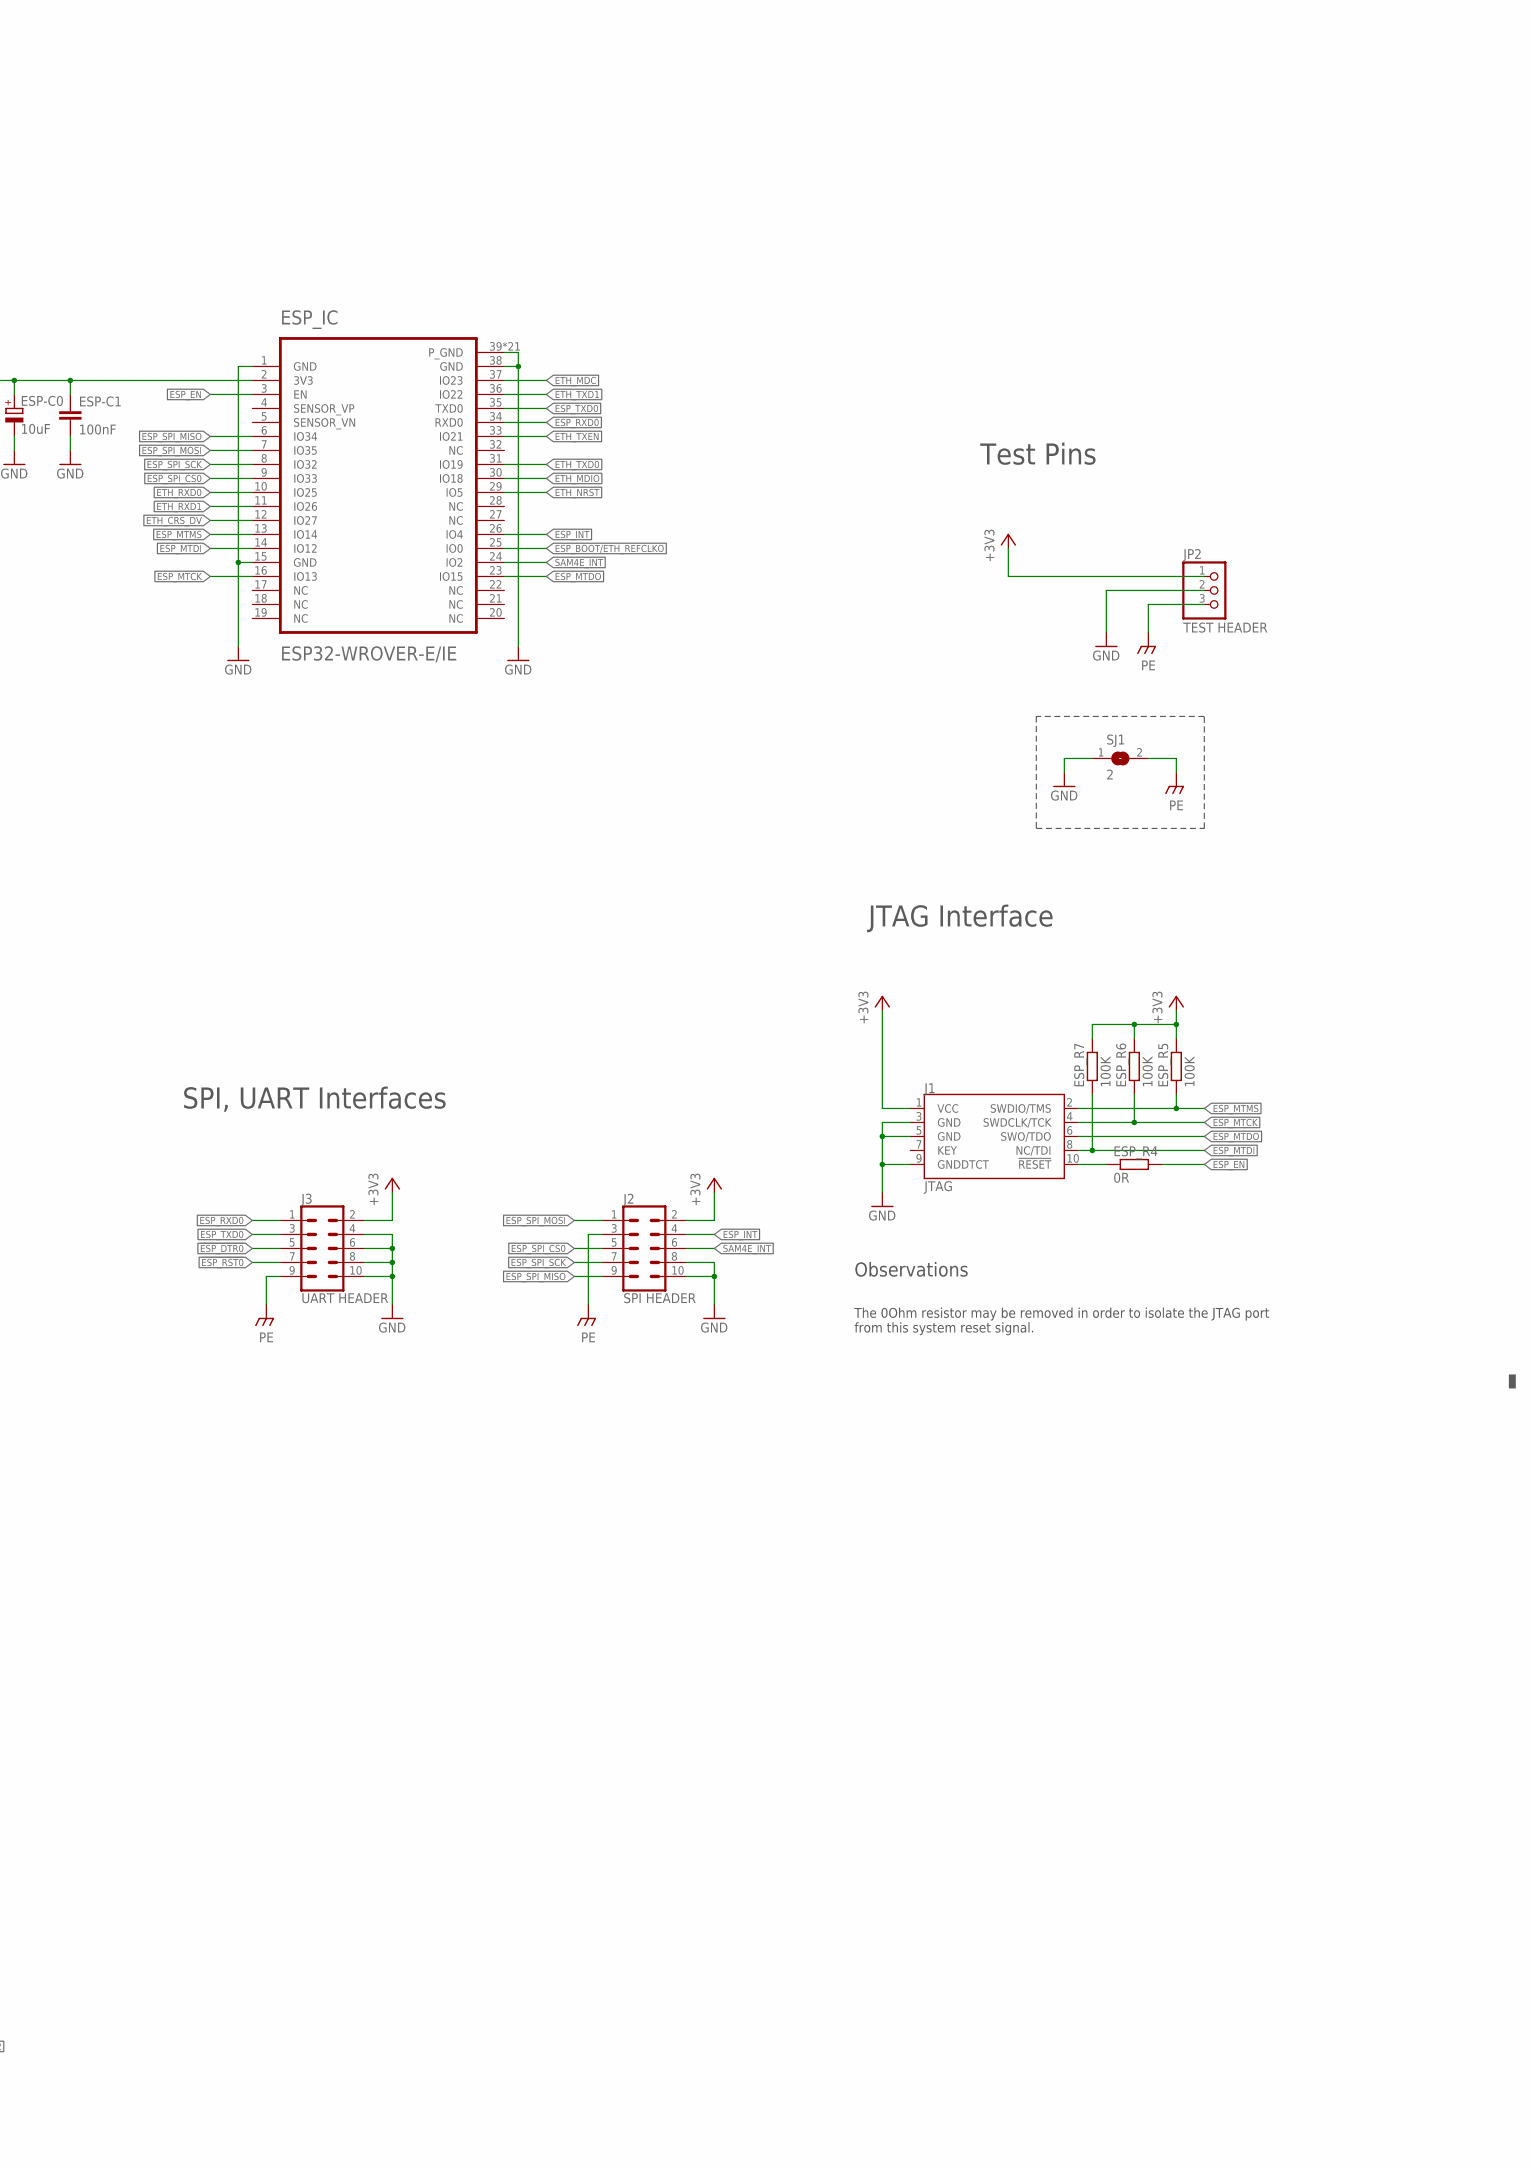
[picture p116: schematic plc_esp32.sch, part in row 1, column 2]

Parts:
ESP-C0: 10uF; SMC_B
ESP-C1: 100nF; C0402
ESP_C4: 1uF; C0402
ESP_IC: ESP32-WROVER-E/IE
ESP_L0: 10uH; L1812
ESP_R0, ESP_R1, ESP_R2, ESP_R3: 10K; R0402
ESP_R4: 0R; R0402
ESP_R5, ESP_R6, ESP_R7: 100K; R0402
ESP_S0, ESP_S1: BUTTON; TACTILE_SWITCH_SMD_4.6X2.8MM
ETH_C0, ETH_C5, ETH_C8: 22uF; SMC_B
ETH_C1, ETH_C3, ETH_C6, ETH_C9: 1uF; C0402
ETH_C2, ETH_C4, ETH_C7: 100nF; C0402
ETH_C10, ETH_C11, ETH_C12: 470pF; C0402
ETH_C13, ETH_C14: 25pF; C0402
ETH_L0: 22uH; L1812
ETH_R0: 12.1R(1%); R0402
ETH_R1, ETH_R2: 330R; R0402
ETH_R3, ETH_R8, ETH_R13: 10K; R0402
ETH_R4, ETH_R5, ETH_R6, ETH_R7: 49.9R; R0402
ETH_R10, ETH_R11, ETH_R12: 10R; R0402
ETH_R14: 1K; R0402
J1: JTAG; 2X5-SMD-1.27MM
J2: SPI HEADER; 2X5-SHROUDED_SMD
J3: UART HEADER; 2X5-SHROUDED_SMD
JP2: TEST HEADER; 1X03
MCU_VAR1: V5.5MLA0603N; CT/CN0603
SJ1: 2; SJ
SUPERVISOR_IC: BD48E30G-TR; SSOP5
SUP_C0: 10uF; SMC_B
SUP_C1: 100nF; C0402
T1, T2: BC846; SOT23
U$1: LAN8720A-CP; QFN-24(4X4MM)
U$2: 7499010121A; RJ45-7499010121A
U$5: FL2500213Z; 3.2X2.5MM

Connections:
!ESP_DTR0: ESP_R2.1, J3.5, T2.3 (C)
!ESP_RST0: ESP_R3.1, J3.7, T1.2 (E)
+3V3: ESP_L0.2, ESP_R0.2, ESP_R1.2, ESP_R5.2, ESP_R6.2, ESP_R7.2, ETH_L0.2, J1.1 (VCC), J2.2, J3.2, JP2.1, SUPERVISOR_IC.2 (VDD), SUP_C0.+, SUP_C1.1
ESP_3V3: ESP-C0.+, ESP-C1.1, ESP_IC.2 (3V3), ESP_L0.1
ESP_BOOT/ETH_REFCLKO: ESP_IC.25 (IO0), ESP_R1.1, ESP_S1.1, ESP_S1.2, T2.2 (E), U$1.14 (NINT/REFCLKO)
ESP_EN: ESP_C4.1, ESP_IC.3 (EN), ESP_R0.1, ESP_R4.2, ESP_S0.1, ESP_S0.2, SUPERVISOR_IC.1 (VOUT), T1.3 (C)
ESP_INT: ESP_IC.26 (IO4), J2.4
ESP_MTCK: ESP_IC.16 (IO13), ESP_R6.1, J1.4 (SWDCLK/TCK)
ESP_MTDI: ESP_IC.14 (IO12), ESP_R7.1, J1.8 (NC/TDI)
ESP_MTDO: ESP_IC.23 (IO15), J1.6 (SWO/TDO)
ESP_MTMS: ESP_IC.13 (IO14), ESP_R5.1, J1.2 (SWDIO/TMS)
ESP_RXD0: ESP_IC.34 (RXD0), J3.1
ESP_SPI_CS0: ESP_IC.9 (IO33), J2.5
ESP_SPI_MISO: ESP_IC.6 (IO34), J2.9
ESP_SPI_MOSI: ESP_IC.7 (IO35), J2.1
ESP_SPI_SCK: ESP_IC.8 (IO32), J2.7
ESP_TXD0: ESP_IC.35 (TXD0), J3.3
ETH_CRS_DV: ESP_IC.12 (IO27), ETH_R12.1
ETH_MDC: ESP_IC.37 (IO23), U$1.13 (MDC)
ETH_MDIO: ESP_IC.30 (IO18), ETH_R14.1, U$1.12 (MDIO)
ETH_NRST: ESP_IC.29 (IO5), ETH_C12.1, ETH_R8.1, U$1.15 (NRST)
ETH_RJ45_LED2: ETH_R3.2, U$1.2 (LED2/!NINTSEL), U$2.12 (YELLOW+)
ETH_RJ45_RXN: ETH_R7.1, U$1.22 (RXN), U$2.6 (RD-)
ETH_RJ45_RXP: ETH_R6.1, U$1.23 (RXP), U$2.4 (RD+)
ETH_RJ45_TXN: ETH_R5.1, U$1.20 (TXN), U$2.3 (TD-)
ETH_RJ45_TXP: ETH_R4.1, U$1.21 (TXP), U$2.1 (TD+)
ETH_RXD0: ESP_IC.10 (IO25), ETH_R11.1
ETH_RXD1: ESP_IC.11 (IO26), ETH_R10.1
ETH_TXD0: ESP_IC.31 (IO19), U$1.17 (TXD0)
ETH_TXD1: ESP_IC.36 (IO22), U$1.18 (TXD1)
ETH_TXEN: ESP_IC.33 (IO21), U$1.16 (TXEN)
ETH_VDD: ETH_C0.+, ETH_C1.1, ETH_C2.1, ETH_C3.1, ETH_C4.1, ETH_C5.+, ETH_C6.1, ETH_C7.1, ETH_C8.+, ETH_C11.1, ETH_L0.1, ETH_R4.2, ETH_R5.2, ETH_R6.2, ETH_R7.2, ETH_R8.2, ETH_R13.2, ETH_R14.2, U$1.1 (VDD2A), U$1.9 (VDDIO), U$1.19 (VDD1A), U$2.2 (TCT), U$2.5 (RCT)
ETH_VDDCR: ETH_C9.1, ETH_C10.1, U$1.6 (VDDCR)
ETH_XTAL1: ETH_C13.1, U$1.5 (XTAL1/CLKIN), U$5.1 (XTAL1)
ETH_XTAL2: ETH_C14.1, U$1.4 (XTAL2), U$5.3 (XTAL2)
GND: ESP-C0.-, ESP-C1.2, ESP_C4.2, ESP_IC.1 (GND), ESP_IC.15 (GND), ESP_IC.38 (GND), ESP_IC.39 (P_GND), ESP_IC.40 (P_GND), ESP_IC.41 (P_GND), ESP_IC.42 (P_GND), ESP_IC.43 (P_GND), ESP_IC.44 (P_GND), ESP_IC.45 (P_GND), ESP_IC.46 (P_GND), ESP_IC.47 (P_GND), ESP_IC.48 (P_GND), ESP_IC.49 (P_GND), ESP_IC.50 (P_GND), ESP_IC.51 (P_GND), ESP_IC.52 (P_GND), ESP_IC.53 (P_GND), ESP_IC.54 (P_GND), ESP_IC.55 (P_GND), ESP_IC.56 (P_GND), ESP_IC.57 (P_GND), ESP_IC.58 (P_GND), ESP_IC.59 (P_GND), ESP_S0.3, ESP_S0.4, ESP_S1.3, ESP_S1.4, ETH_C0.-, ETH_C1.2, ETH_C2.2, ETH_C3.2, ETH_C4.2, ETH_C5.-, ETH_C6.2, ETH_C7.2, ETH_C8.-, ETH_C9.2, ETH_C10.2, ETH_C11.2, ETH_C12.2, ETH_C13.2, ETH_C14.2, ETH_R0.2, ETH_R1.1, ETH_R2.1, ETH_R3.1, J1.3 (GND), J1.5 (GND), J1.9 (GNDDTCT), J2.8, J2.10, J3.4, J3.6, J3.8, J3.10, JP2.2, MCU_VAR1.2, SJ1.1, SUPERVISOR_IC.3 (GND), SUP_C0.-, SUP_C1.2, U$1.25 (P_GND), U$1.26 (P_GND), U$1.27 (P_GND), U$1.28 (P_GND), U$1.29 (P_GND), U$1.30 (P_GND), U$1.31 (P_GND), U$1.32 (P_GND), U$2.8, U$5.2 (GND), U$5.4 (GND)
unnamed: ETH_R0.1, U$1.24 (RBIAS)
unnamed: ETH_R10.2, U$1.7 (RXD1/!MODE1)
unnamed: ETH_R11.2, U$1.8 (RXD0/!MODE0)
unnamed: ETH_R13.1, U$1.10 (RXER/!PHYAD0)
unnamed: ESP_R4.1, J1.10 (!RESET)
unnamed: U$1.3 (LED1/!REGOFF), U$2.10 (GREEN+)
unnamed: ESP_R3.2, T2.1 (B)
unnamed: ESP_R2.2, T1.1 (B)
unnamed: ETH_R12.2, U$1.11 (CRS_DV/!MODE2)
unnamed: ETH_R1.2, U$2.9 (GREEN-)
unnamed: ETH_R2.2, U$2.11 (YELLOW-)
P$1: J2.3, J3.9, JP2.3, MCU_VAR1.1, SJ1.2, U$2.13 (SHIELD), U$2.14 (SHIELD)
SAM4E_INT: ESP_IC.24 (IO2), J2.6

Notes on the sheet:
Supply Protection Circuit
25MHz External Clock
LAN8720A Ethernet IC
Observations
The 0Ohm resistor may be removed in order to isolate the JTAG port from this system reset signal.
JTAG Interface
Boot & Enable, Volt. Supervisor
Voltage supervisor added to safely shut down ESP32 when the power supply feeds less that 2.7V to the source pin. Auto-program (Boot & Enable) is made available via UART interface to flash ESP32. _________________________ DTR RTS -> EN IO0 _________________________ 1 1 1 1 0 0 1 1 1 0 0 1 0 1 1 0
SPI, UART Interfaces
Test Pins
ESP32-ROVER-E/IE IC

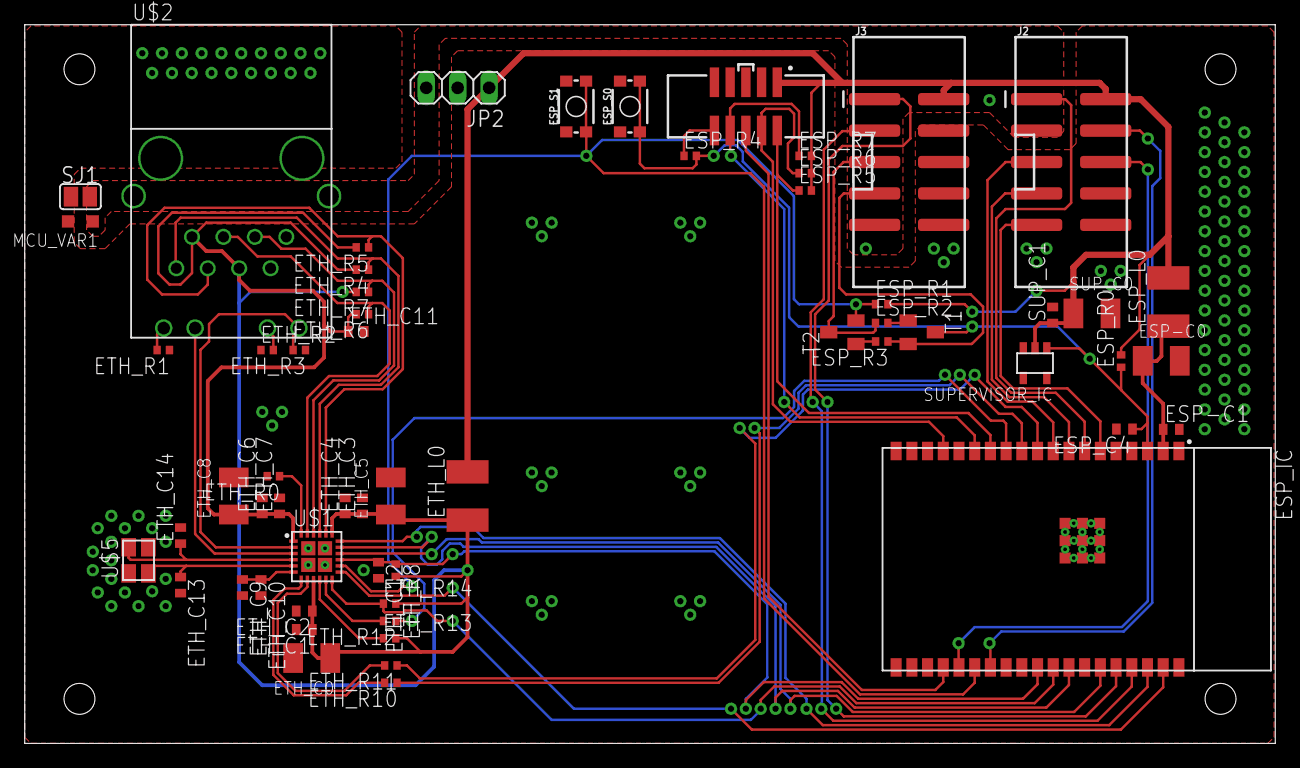
[picture p117: board plc_esp32.brd from above]

Board: 2 copper layers, 101.1 x 58.1 mm, 59 parts (0 on the bottom side), 49 nets.
