nicolaeandreivasile/plc-embedded-application/board-design/eagle-files/SAM4E-PLC/plc_sam4e.brd

## EAGLE design board-design/eagle-files/SAM4E-PLC/plc_sam4e.brd (2026-04-05)

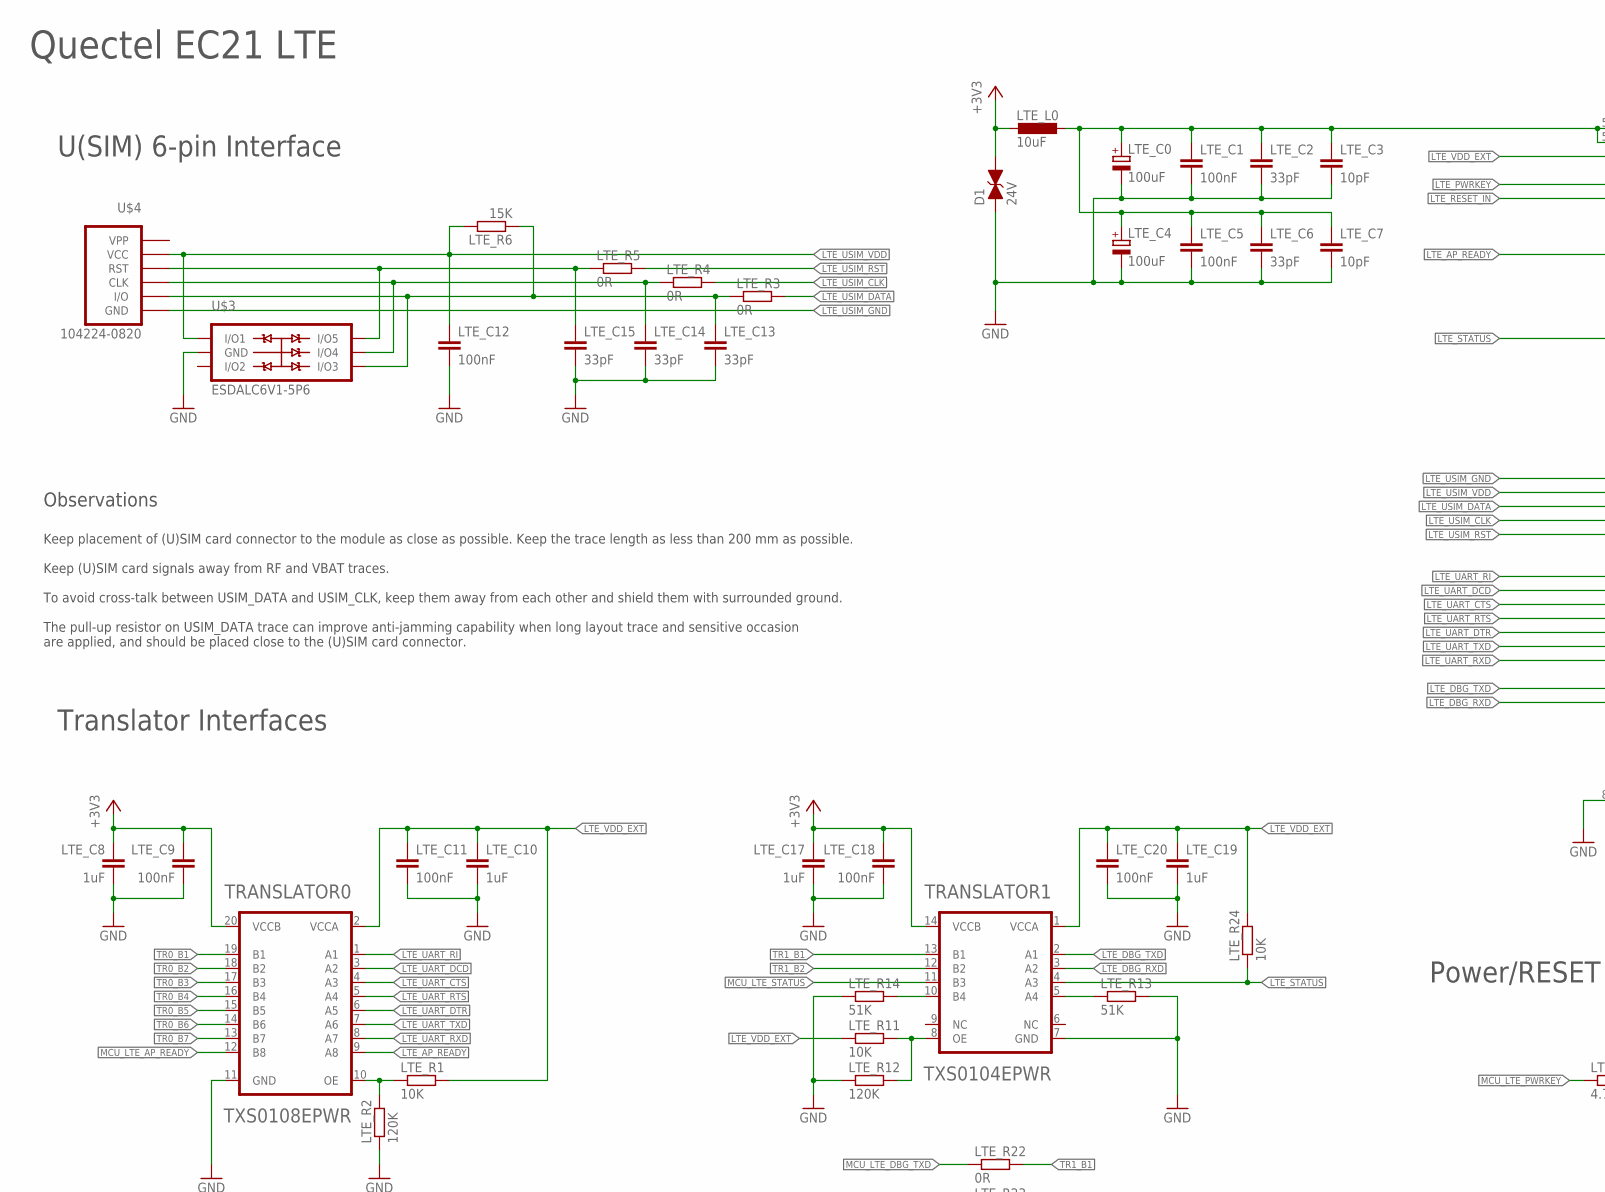
[picture p118: schematic plc_sam4e.sch, sheet 1, part in row 1, column 1]

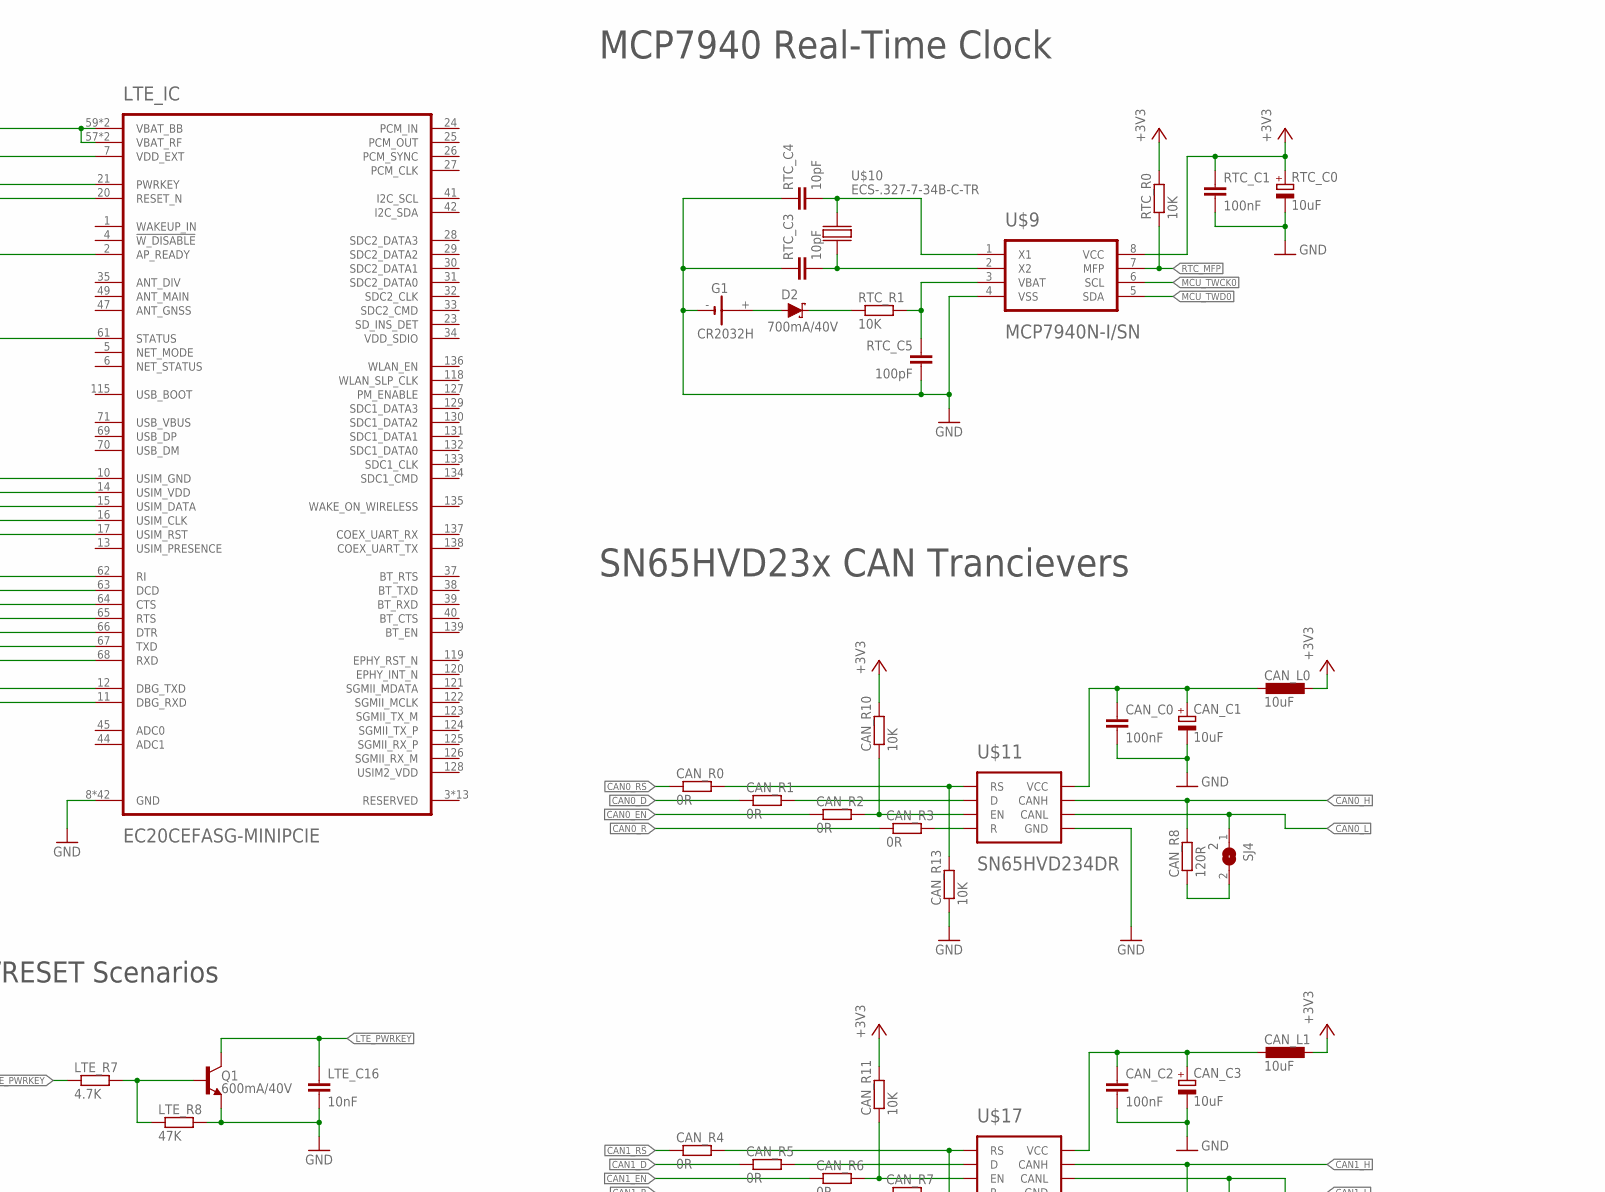
[picture p119: schematic plc_sam4e.sch, sheet 1, part in row 1, column 2]

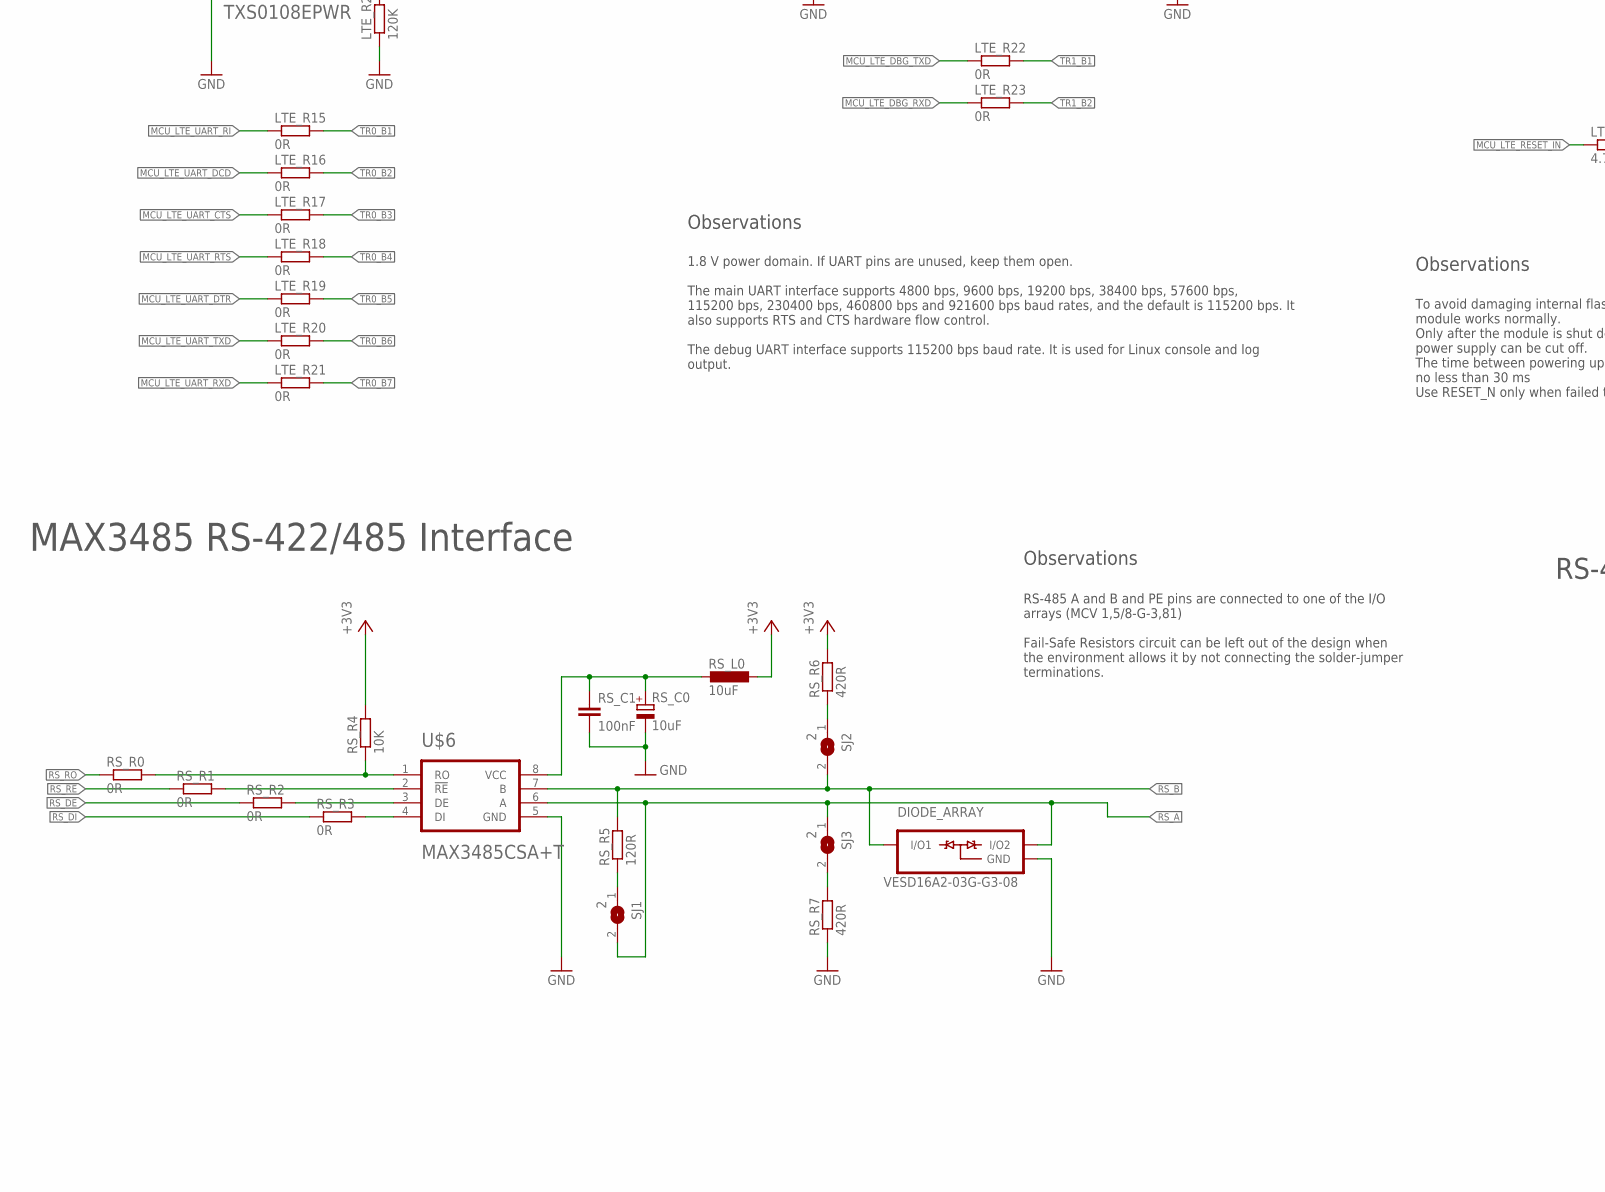
[picture p120: schematic plc_sam4e.sch, sheet 1, part in row 2, column 1]

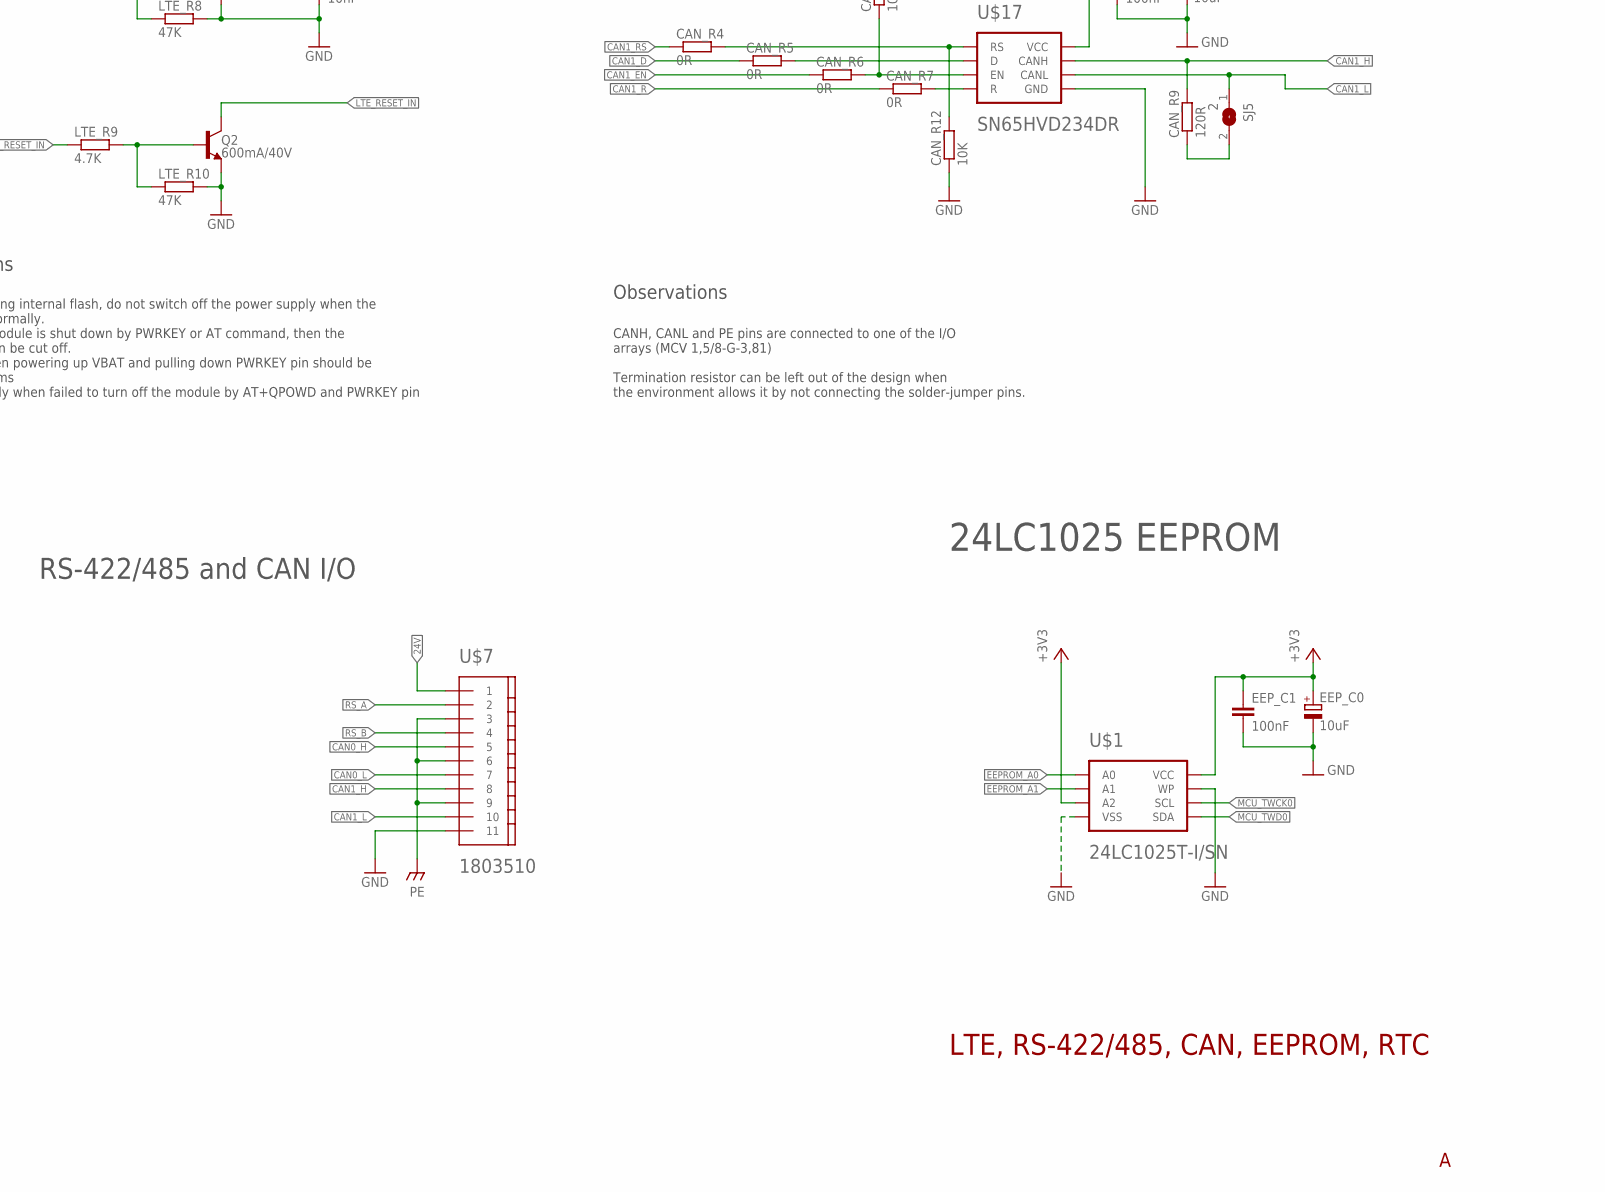
[picture p121: schematic plc_sam4e.sch, sheet 1, part in row 2, column 2]

Parts:
CAN_C0, CAN_C2: 100nF; C0402
CAN_C1, CAN_C3: 10uF; SMC_B
CAN_L0, CAN_L1: 10uF; L1812
CAN_R0, CAN_R1, CAN_R2, CAN_R3, CAN_R4, CAN_R5, CAN_R6, CAN_R7: 0R; R0402
CAN_R8, CAN_R9: 120R; R0402
CAN_R10, CAN_R11, CAN_R12, CAN_R13: 10K; R0402
D1: 24V; 0603
D2: 700mA/40V; SOT23-3
DIODE_ARRAY: VESD16A2-03G-G3-08; SOT-323-3
EEP_C0: 10uF; SMC_B
EEP_C1: 100nF; C0402
G1: CR2032H
LTE_C0, LTE_C4: 100uF; SMC_B
LTE_C1, LTE_C5, LTE_C9, LTE_C11, LTE_C12, LTE_C18, LTE_C20: 100nF; C0402
LTE_C2, LTE_C6, LTE_C13, LTE_C14, LTE_C15: 33pF; C0402
LTE_C3, LTE_C7: 10pF; C0402
LTE_C8, LTE_C10, LTE_C17, LTE_C19: 1uF; C0402
LTE_C16: 10nF; C0402
LTE_IC: EC20CEFASG-MINIPCIE; EC21
LTE_L0: 10uF; L1812
LTE_R1, LTE_R11, LTE_R24: 10K; R0402
LTE_R2, LTE_R12: 120K; R0402
LTE_R3, LTE_R4, LTE_R5, LTE_R15, LTE_R16, LTE_R17, LTE_R18, LTE_R19, LTE_R20, LTE_R21, LTE_R22, LTE_R23: 0R; R0402
LTE_R6: 15K; R0402
LTE_R7, LTE_R9: 4.7K; R0402
LTE_R8, LTE_R10: 47K; R0402
LTE_R13, LTE_R14: 51K; R0402
Q1, Q2: 600mA/40V; SOT23-3
RS_C0: 10uF; SMC_B
RS_C1: 100nF; C0402
RS_L0: 10uF; L1812
RS_R0, RS_R1, RS_R2, RS_R3: 0R; R0402
RS_R4: 10K; R0402
RS_R5: 120R; R0402
RS_R6, RS_R7: 420R; R0402
RTC_C0: 10uF; SMC_B
RTC_C1: 100nF; C0402
RTC_C3, RTC_C4: 10pF; C0402
RTC_C5: 100pF; C0402
RTC_R0, RTC_R1: 10K; R0402
SJ1, SJ2, SJ3, SJ4, SJ5: 2; SJ
TRANSLATOR0: TXS0108EPWR; TSSOP-20
TRANSLATOR1: TXS0104EPWR; TSSOP-14
U$1: 24LC1025T-I/SN; SOIC-8
U$3: ESDALC6V1-5P6; SOT-666
U$4: 104224-0820
U$6: MAX3485CSA+T; SOIC-8
U$7: 1803510
U$9: MCP7940N-I/SN; SOIC-8
U$10: ECS-.327-7-34B-C-TR; 3.2X1.5MM
U$11, U$17: SN65HVD234DR; SOIC-8

Connections:
24V: U$7.1; also elsewhere on the board
+3V3: CAN_L0.1, CAN_L1.1, CAN_R10.2, CAN_R11.2, D1.2 (C), EEP_C0.+, EEP_C1.1, LTE_C8.1, LTE_C9.1, LTE_C17.1, LTE_C18.1, LTE_L0.2, RS_L0.1, RS_R4.2, RS_R6.2, RTC_C0.+, RTC_C1.1, RTC_R0.2, TRANSLATOR0.20 (VCCB), TRANSLATOR1.14 (VCCB), U$1.3 (A2), U$1.8 (VCC), U$9.8 (VCC); also elsewhere on the board
CAN0_D: CAN_R1.1; also elsewhere on the board
CAN0_EN: CAN_R2.1; also elsewhere on the board
CAN0_H: CAN_R8.2, U$7.5, U$11.7 (CANH)
CAN0_L: SJ4.1, U$7.7, U$11.6 (CANL)
CAN0_R: CAN_R3.1; also elsewhere on the board
CAN0_RS: CAN_R0.1; also elsewhere on the board
CAN1_D: CAN_R5.1; also elsewhere on the board
CAN1_EN: CAN_R6.1; also elsewhere on the board
CAN1_H: CAN_R9.2, U$7.8, U$17.7 (CANH)
CAN1_L: SJ5.1, U$7.10, U$17.6 (CANL)
CAN1_R: CAN_R7.1; also elsewhere on the board
CAN1_RS: CAN_R4.1; also elsewhere on the board
EEPROM_A0: U$1.1 (A0); also elsewhere on the board
EEPROM_A1: U$1.2 (A1); also elsewhere on the board
GND: CAN_C0.2, CAN_C1.-, CAN_C2.2, CAN_C3.-, CAN_R12.1, CAN_R13.1, D1.1 (A), DIODE_ARRAY.3 (GND), EEP_C0.-, EEP_C1.2, G1.-, LTE_C0.-, LTE_C1.2, LTE_C2.2, LTE_C3.2, LTE_C4.-, LTE_C5.2, LTE_C6.2, LTE_C7.2, LTE_C8.2, LTE_C9.2, LTE_C10.2, LTE_C11.2, LTE_C12.2, LTE_C13.2, LTE_C14.2, LTE_C15.2, LTE_C16.2, LTE_C17.2, LTE_C18.2, LTE_C19.2, LTE_C20.2, LTE_IC.8 (GND), LTE_IC.9 (GND), LTE_IC.19 (GND), LTE_IC.22 (GND), LTE_IC.36 (GND), LTE_IC.46 (GND), LTE_IC.48 (GND), LTE_IC.50 (GND), LTE_IC.51 (GND), LTE_IC.52 (GND), LTE_IC.53 (GND), LTE_IC.54 (GND), LTE_IC.56 (GND), LTE_IC.72 (GND), LTE_IC.85 (GND), LTE_IC.86 (GND), LTE_IC.87 (GND), LTE_IC.88 (GND), LTE_IC.89 (GND), LTE_IC.90 (GND), LTE_IC.91 (GND), LTE_IC.92 (GND), LTE_IC.93 (GND), LTE_IC.94 (GND), LTE_IC.95 (GND), LTE_IC.96 (GND), LTE_IC.97 (GND), LTE_IC.98 (GND), LTE_IC.99 (GND), LTE_IC.100 (GND), LTE_IC.101 (GND), LTE_IC.102 (GND), LTE_IC.103 (GND), LTE_IC.104 (GND), LTE_IC.105 (GND), LTE_IC.106 (GND), LTE_IC.107 (GND), LTE_IC.108 (GND), LTE_IC.109 (GND), LTE_IC.110 (GND), LTE_IC.111 (GND), LTE_IC.112 (GND), LTE_R2.1, LTE_R8.2, LTE_R10.2, LTE_R12.1, LTE_R13.2, LTE_R14.1, Q1.2 (E), Q2.2 (E), RS_C0.-, RS_C1.2, RS_R7.1, RTC_C0.-, RTC_C1.2, RTC_C3.1, RTC_C4.1, RTC_C5.2, TRANSLATOR0.11 (GND), TRANSLATOR1.7 (GND), U$1.4 (VSS), U$1.7 (WP), U$3.2 (GND), U$6.5 (GND), U$7.11, U$9.4 (VSS), U$11.2 (GND), U$17.2 (GND); also elsewhere on the board
LTE_AP_READY: LTE_IC.2 (AP_READY), TRANSLATOR0.9 (A8)
LTE_DBG_RXD: LTE_IC.11 (DBG_RXD), TRANSLATOR1.3 (A2)
LTE_DBG_TXD: LTE_IC.12 (DBG_TXD), TRANSLATOR1.2 (A1)
LTE_PWRKEY: LTE_C16.1, LTE_IC.21 (PWRKEY), Q1.3 (C)
LTE_RESET_IN: LTE_IC.20 (RESET_N), Q2.3 (C)
LTE_STATUS: LTE_IC.61 (STATUS), LTE_R24.1, TRANSLATOR1.4 (A3)
LTE_UART_CTS: LTE_IC.64 (CTS), TRANSLATOR0.4 (A3)
LTE_UART_DCD: LTE_IC.63 (DCD), TRANSLATOR0.3 (A2)
LTE_UART_DTR: LTE_IC.66 (DTR), TRANSLATOR0.6 (A5)
LTE_UART_RI: LTE_IC.62 (RI), TRANSLATOR0.1 (A1)
LTE_UART_RTS: LTE_IC.65 (RTS), TRANSLATOR0.5 (A4)
LTE_UART_RXD: LTE_IC.68 (RXD), TRANSLATOR0.8 (A7)
LTE_UART_TXD: LTE_IC.67 (TXD), TRANSLATOR0.7 (A6)
LTE_USIM_CLK: LTE_IC.16 (USIM_CLK), LTE_R4.2
LTE_USIM_DATA: LTE_IC.15 (USIM_DATA), LTE_R3.2
LTE_USIM_GND: LTE_IC.10 (USIM_GND), U$4.G1 (GND), U$4.G2 (GND), U$4.G3 (GND), U$4.G4 (GND), U$4.S4 (GND)
LTE_USIM_RST: LTE_IC.17 (USIM_RST), LTE_R5.2
LTE_USIM_VDD: LTE_C12.1, LTE_IC.14 (USIM_VDD), LTE_R6.2, U$3.1 (I/O1), U$4.S1 (VCC)
LTE_VBAT: LTE_C0.+, LTE_C1.1, LTE_C2.1, LTE_C3.1, LTE_C4.+, LTE_C5.1, LTE_C6.1, LTE_C7.1, LTE_IC.57 (VBAT_RF), LTE_IC.58 (VBAT_RF), LTE_IC.59 (VBAT_BB), LTE_IC.60 (VBAT_BB), LTE_L0.1
LTE_VDD_EXT: LTE_C10.1, LTE_C11.1, LTE_C19.1, LTE_C20.1, LTE_IC.7 (VDD_EXT), LTE_R1.2, LTE_R11.1, LTE_R24.2, TRANSLATOR0.2 (VCCA), TRANSLATOR1.1 (VCCA)
MCU_LTE_AP_READY: TRANSLATOR0.12 (B8); also elsewhere on the board
MCU_LTE_DBG_RXD: LTE_R23.1; also elsewhere on the board
MCU_LTE_DBG_TXD: LTE_R22.1; also elsewhere on the board
MCU_LTE_PWRKEY: LTE_R7.1; also elsewhere on the board
MCU_LTE_RESET_IN: LTE_R9.1; also elsewhere on the board
MCU_LTE_STATUS: TRANSLATOR1.11 (B3); also elsewhere on the board
MCU_LTE_UART_CTS: LTE_R17.1; also elsewhere on the board
MCU_LTE_UART_DCD: LTE_R16.1; also elsewhere on the board
MCU_LTE_UART_DTR: LTE_R19.1; also elsewhere on the board
MCU_LTE_UART_RI: LTE_R15.1; also elsewhere on the board
MCU_LTE_UART_RTS: LTE_R18.1; also elsewhere on the board
MCU_LTE_UART_RXD: LTE_R21.1; also elsewhere on the board
MCU_LTE_UART_TXD: LTE_R20.1; also elsewhere on the board
MCU_TWCK0: U$1.6 (SCL), U$9.6 (SCL); also elsewhere on the board
MCU_TWD0: U$1.5 (SDA), U$9.5 (SDA); also elsewhere on the board
unnamed: LTE_R7.2, LTE_R8.1, Q1.1 (B)
unnamed: RS_R0.2, RS_R4.1, U$6.1 (RO)
unnamed: RS_R1.2, U$6.2 (!RE)
unnamed: RS_R2.2, U$6.3 (DE)
unnamed: LTE_R9.2, LTE_R10.1, Q2.1 (B)
unnamed: LTE_R14.2, TRANSLATOR1.10 (B4)
unnamed: RTC_C4.2, U$9.1 (X1), U$10.2
unnamed: RS_R3.2, U$6.4 (DI)
unnamed: CAN_R3.2, U$11.4 (R)
unnamed: RTC_C3.2, U$9.2 (X2), U$10.1
unnamed: CAN_R2.2, CAN_R10.1, U$11.5 (EN)
unnamed: D2.3 (C), RTC_R1.1
unnamed: D2.1 (A), G1.+
unnamed: LTE_R13.1, TRANSLATOR1.5 (A4)
unnamed: RTC_C5.1, RTC_R1.2, U$9.3 (VBAT)
unnamed: CAN_R1.2, U$11.1 (D)
unnamed: RS_R5.1, SJ1.1
unnamed: CAN_R0.2, CAN_R13.2, U$11.8 (RS)
unnamed: RS_R6.1, SJ2.1
unnamed: RS_R7.2, SJ3.2
unnamed: LTE_R1.1, LTE_R2.2, TRANSLATOR0.10 (OE)
unnamed: CAN_R4.2, CAN_R12.2, U$17.8 (RS)
unnamed: CAN_R5.2, U$17.1 (D)
unnamed: CAN_R6.2, CAN_R11.1, U$17.5 (EN)
unnamed: CAN_R7.2, U$17.4 (R)
unnamed: RS_C0.+, RS_C1.1, RS_L0.2, U$6.8 (VCC)
unnamed: CAN_R8.1, SJ4.2
unnamed: CAN_R9.1, SJ5.2
unnamed: LTE_C15.1, LTE_R5.1, U$3.6 (I/O5), U$4.S2 (RST)
unnamed: LTE_C14.1, LTE_R4.1, U$3.5 (I/O4), U$4.S3 (CLK)
unnamed: LTE_C13.1, LTE_R3.1, LTE_R6.1, U$3.4 (I/O3), U$4.S6 (I/O)
unnamed: CAN_C0.1, CAN_C1.+, CAN_L0.2, U$11.3 (VCC)
unnamed: CAN_C2.1, CAN_C3.+, CAN_L1.2, U$17.3 (VCC)
unnamed: LTE_R11.2, LTE_R12.2, TRANSLATOR1.8 (OE)
P$1: U$7.3, U$7.6, U$7.9; also elsewhere on the board
RS_!RE: RS_R1.1; also elsewhere on the board
RS_A: DIODE_ARRAY.2 (I/O2), SJ1.2, SJ3.1, U$6.6 (A), U$7.2
RS_B: DIODE_ARRAY.1 (I/O1), RS_R5.2, SJ2.2, U$6.7 (B), U$7.4
RS_DE: RS_R2.1; also elsewhere on the board
RS_DI: RS_R3.1; also elsewhere on the board
RS_RO: RS_R0.1; also elsewhere on the board
RTC_MFP: RTC_R0.1, U$9.7 (MFP); also elsewhere on the board
TR0_B1: LTE_R15.2, TRANSLATOR0.19 (B1)
TR0_B2: LTE_R16.2, TRANSLATOR0.18 (B2)
TR0_B3: LTE_R17.2, TRANSLATOR0.17 (B3)
TR0_B4: LTE_R18.2, TRANSLATOR0.16 (B4)
TR0_B5: LTE_R19.2, TRANSLATOR0.15 (B5)
TR0_B6: LTE_R20.2, TRANSLATOR0.14 (B6)
TR0_B7: LTE_R21.2, TRANSLATOR0.13 (B7)
TR1_B1: LTE_R22.2, TRANSLATOR1.13 (B1)
TR1_B2: LTE_R23.2, TRANSLATOR1.12 (B2)

Notes on the sheet:
U(SIM) 6-pin Interface
Translator Interfaces
Power/RESET Scenarios
Observations
Quectel EC21 LTE
1.8 V power domain. If UART pins are unused, keep them open. The main UART interface supports 4800 bps, 9600 bps, 19200 bps, 38400 bps, 57600 bps, 115200 bps, 230400 bps, 460800 bps and 921600 bps baud rates, and the default is 115200 bps. It also supports RTS and CTS hardware flow control. The deb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
Keep placement of (U)SIM card connector to the module as close as possible. Keep the trace length as less than 200 mm as possible. Keep (U)SIM card signals away from RF and VBAT traces. To avoid cross-talk between USIM_DATA and USIM_CLK, keep them away from each other and shield them with surrounde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
To avoid damaging internal flash, do not switch off the power supply when the module works normally. Only after the module is shut down by PWRKEY or AT command, then the power supply can be cut off. The time between powering up VBAT and pulling down PWRKEY pin should be no less than 30 ms Use RESET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
MAX3485 RS-422/485 Interface
RS-485 A and B and PE pins are connected to one of the I/O arrays (MCV 1,5/8-G-3,81) Fail-Safe Resistors circuit can be left out of the design when the environment allows it by not connecting the solder-jumper terminations.
MCP7940 Real-Time Clock
SN65HVD23x CAN Trancievers
CANH, CANL and PE pins are connected to one of the I/O arrays (MCV 1,5/8-G-3,81) Termination resistor can be left out of the design when the environment allows it by not connecting the solder-jumper pins.
RS-422/485 and CAN I/O
24LC1025 EEPROM
LTE, RS-422/485, CAN, EEPROM, RTC
