nicolaeandreivasile/plc-embedded-application/board-design/eagle-files/SAM4E-PLC/plc_sam4e.brd

## EAGLE design board-design/eagle-files/SAM4E-PLC/plc_sam4e.brd (continued)

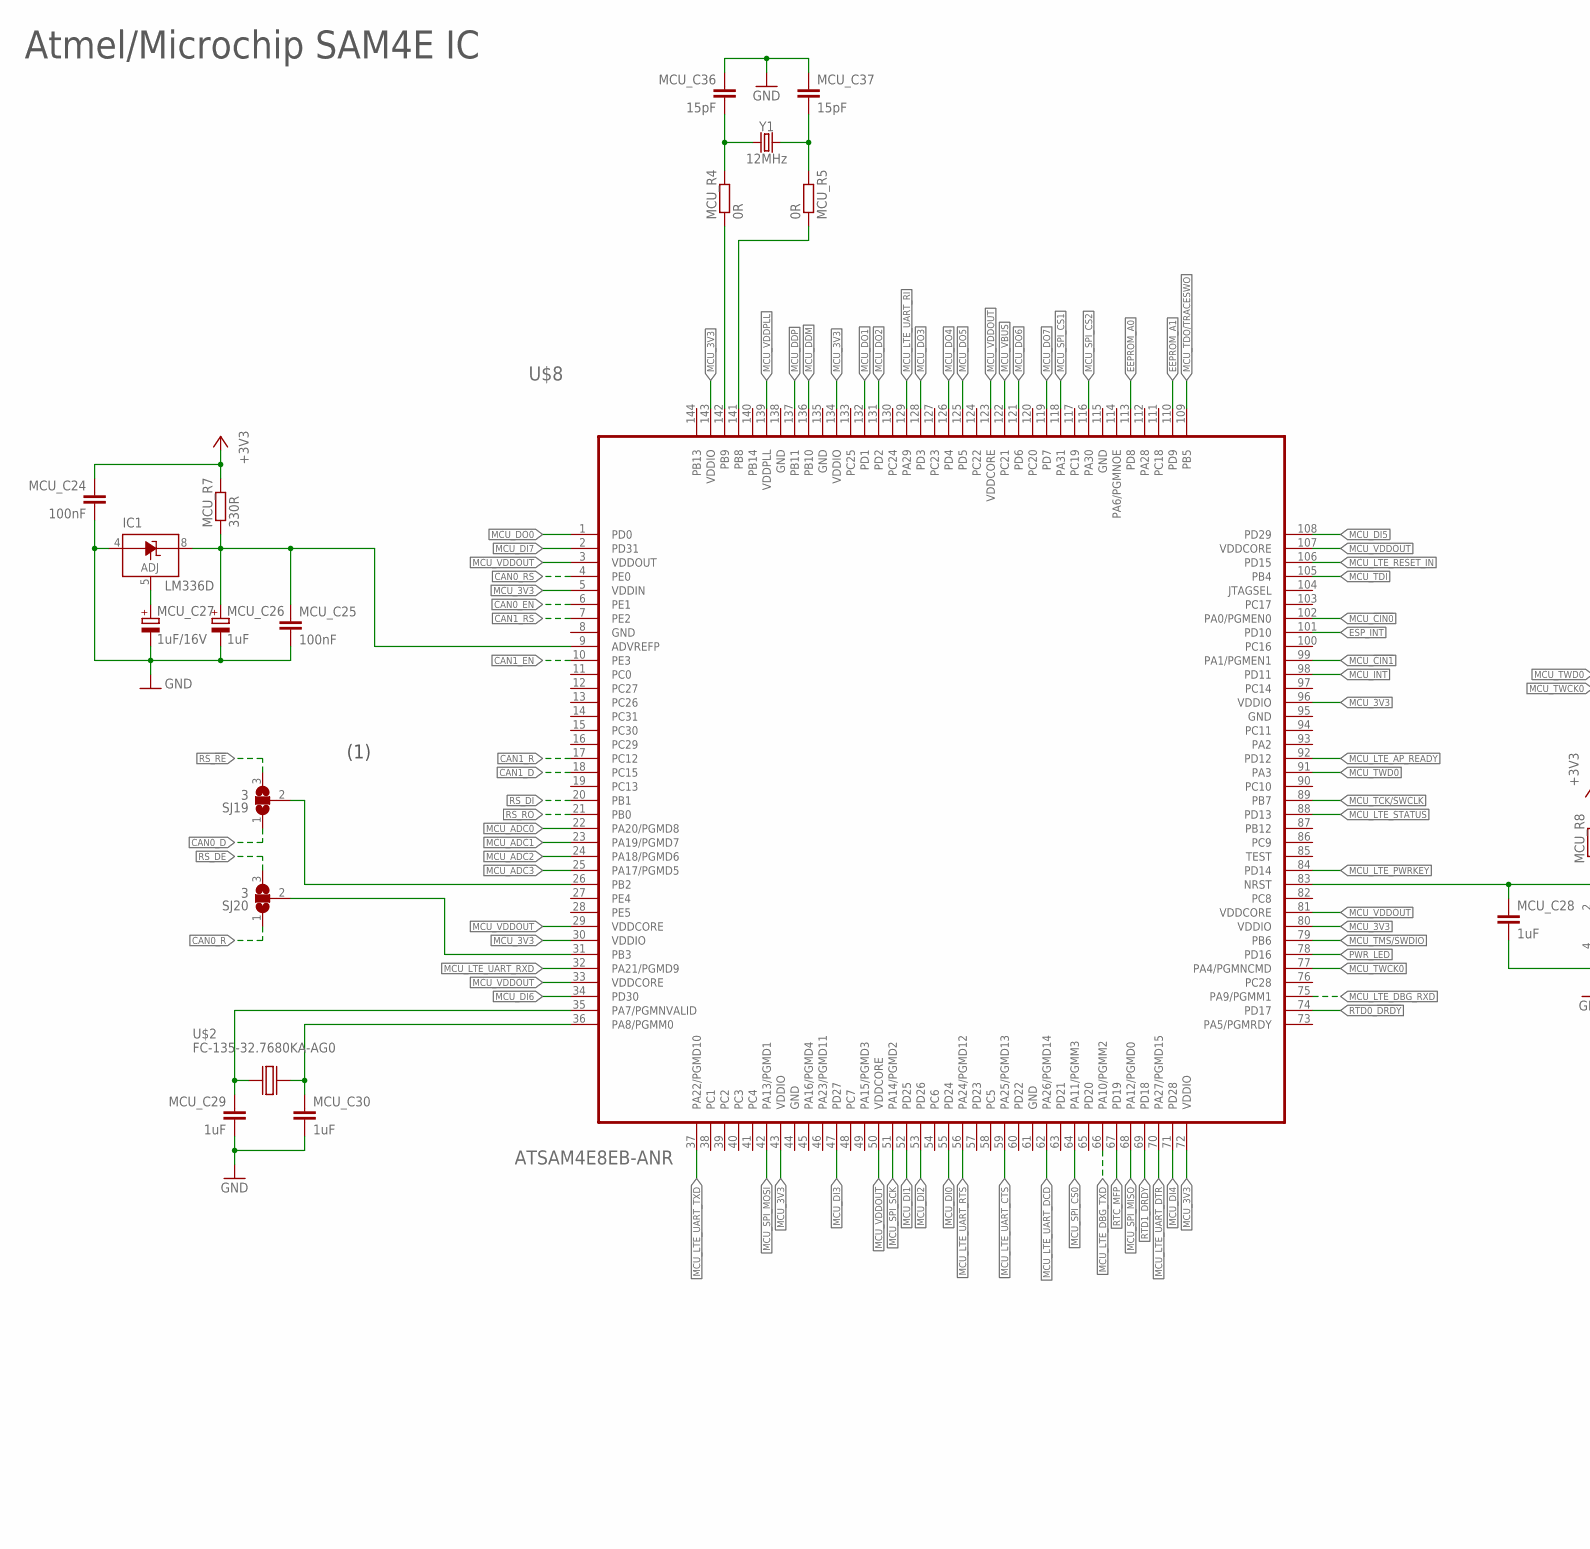
[picture p122: schematic plc_sam4e.sch, sheet 2, part in row 1, column 1]

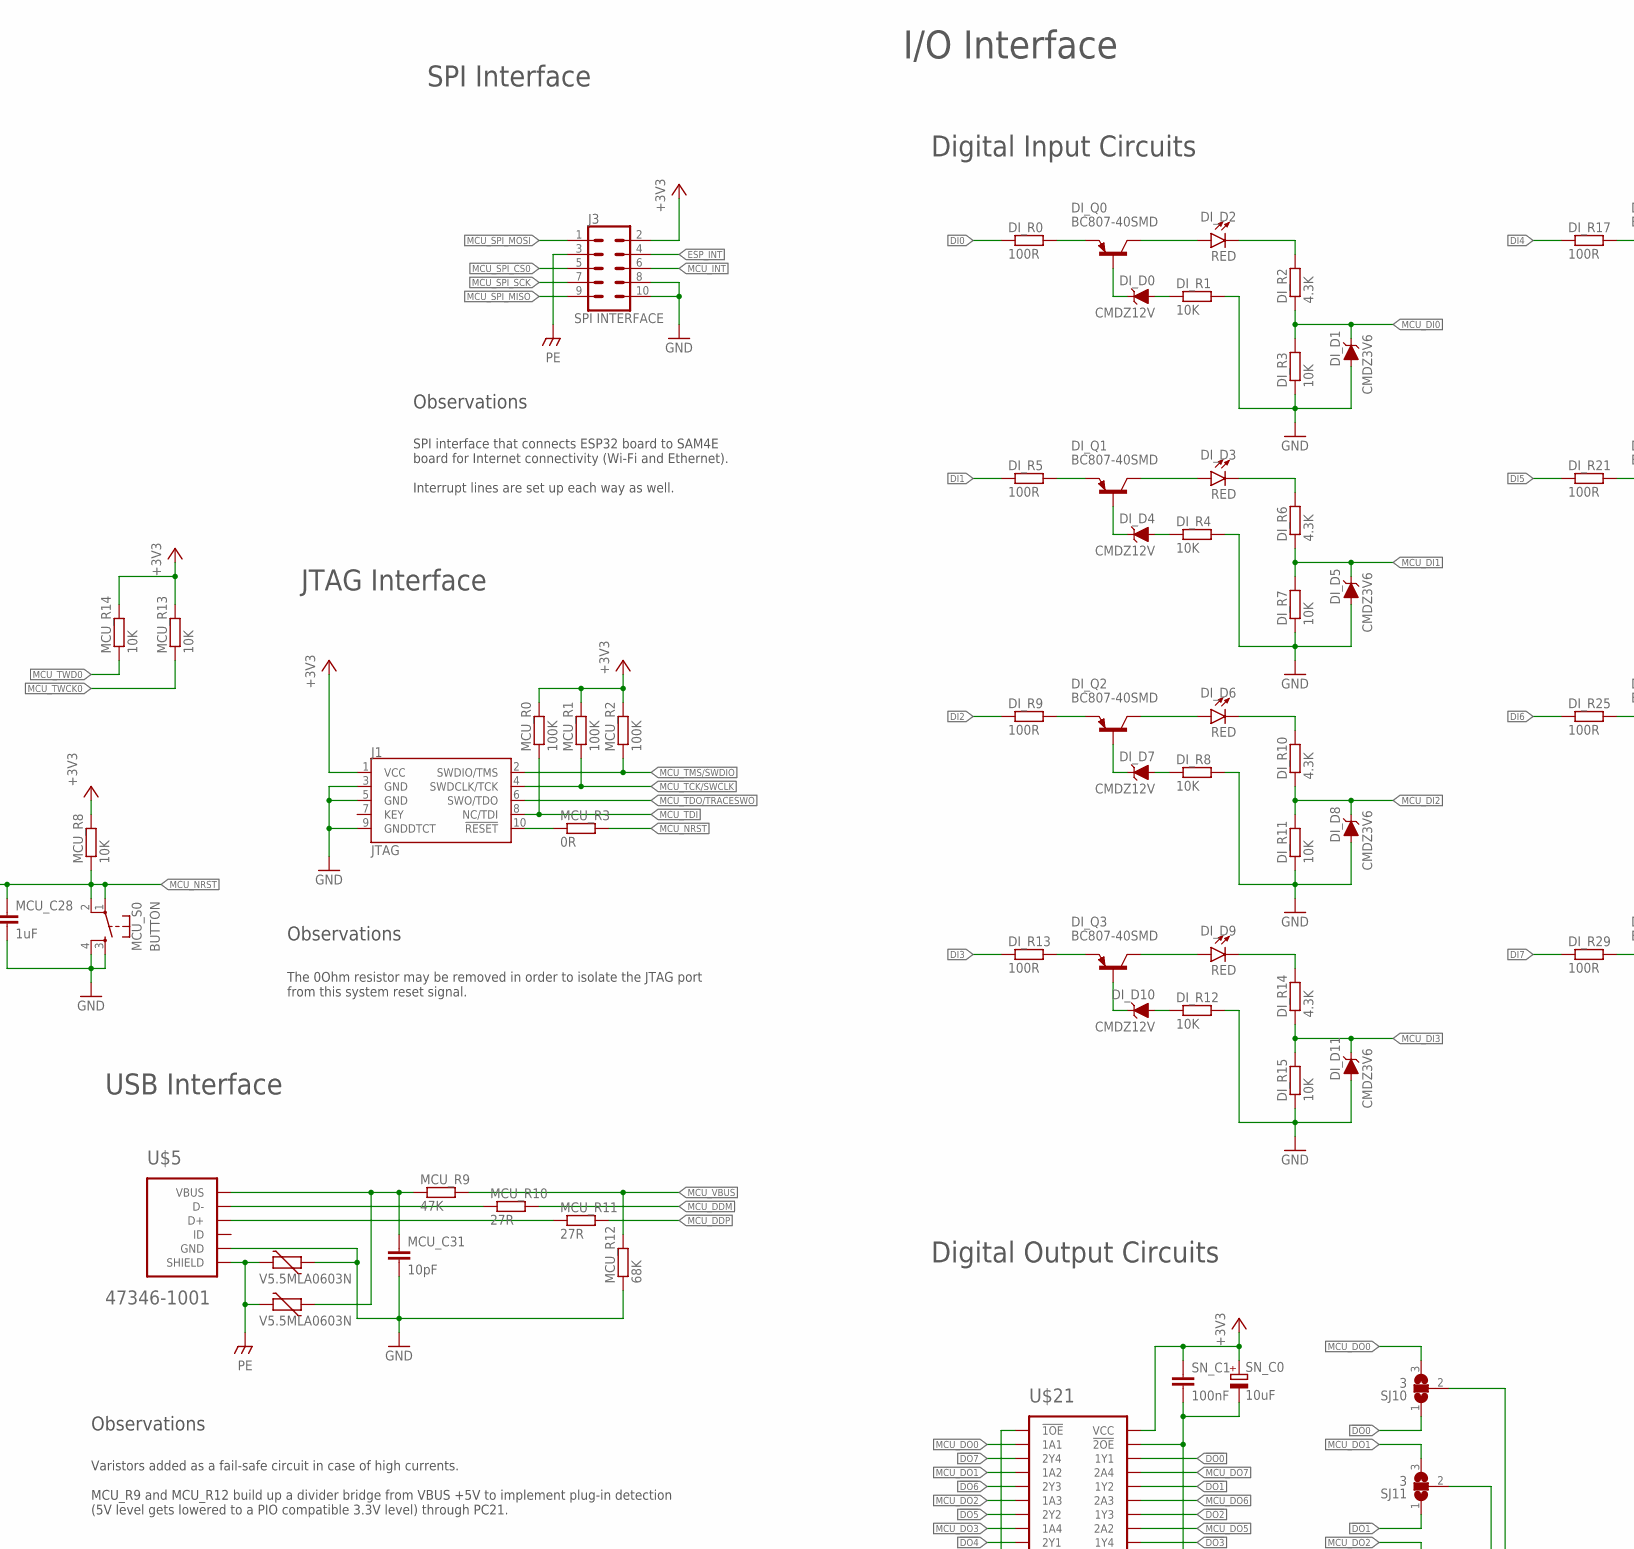
[picture p123: schematic plc_sam4e.sch, sheet 2, part in row 1, column 2]

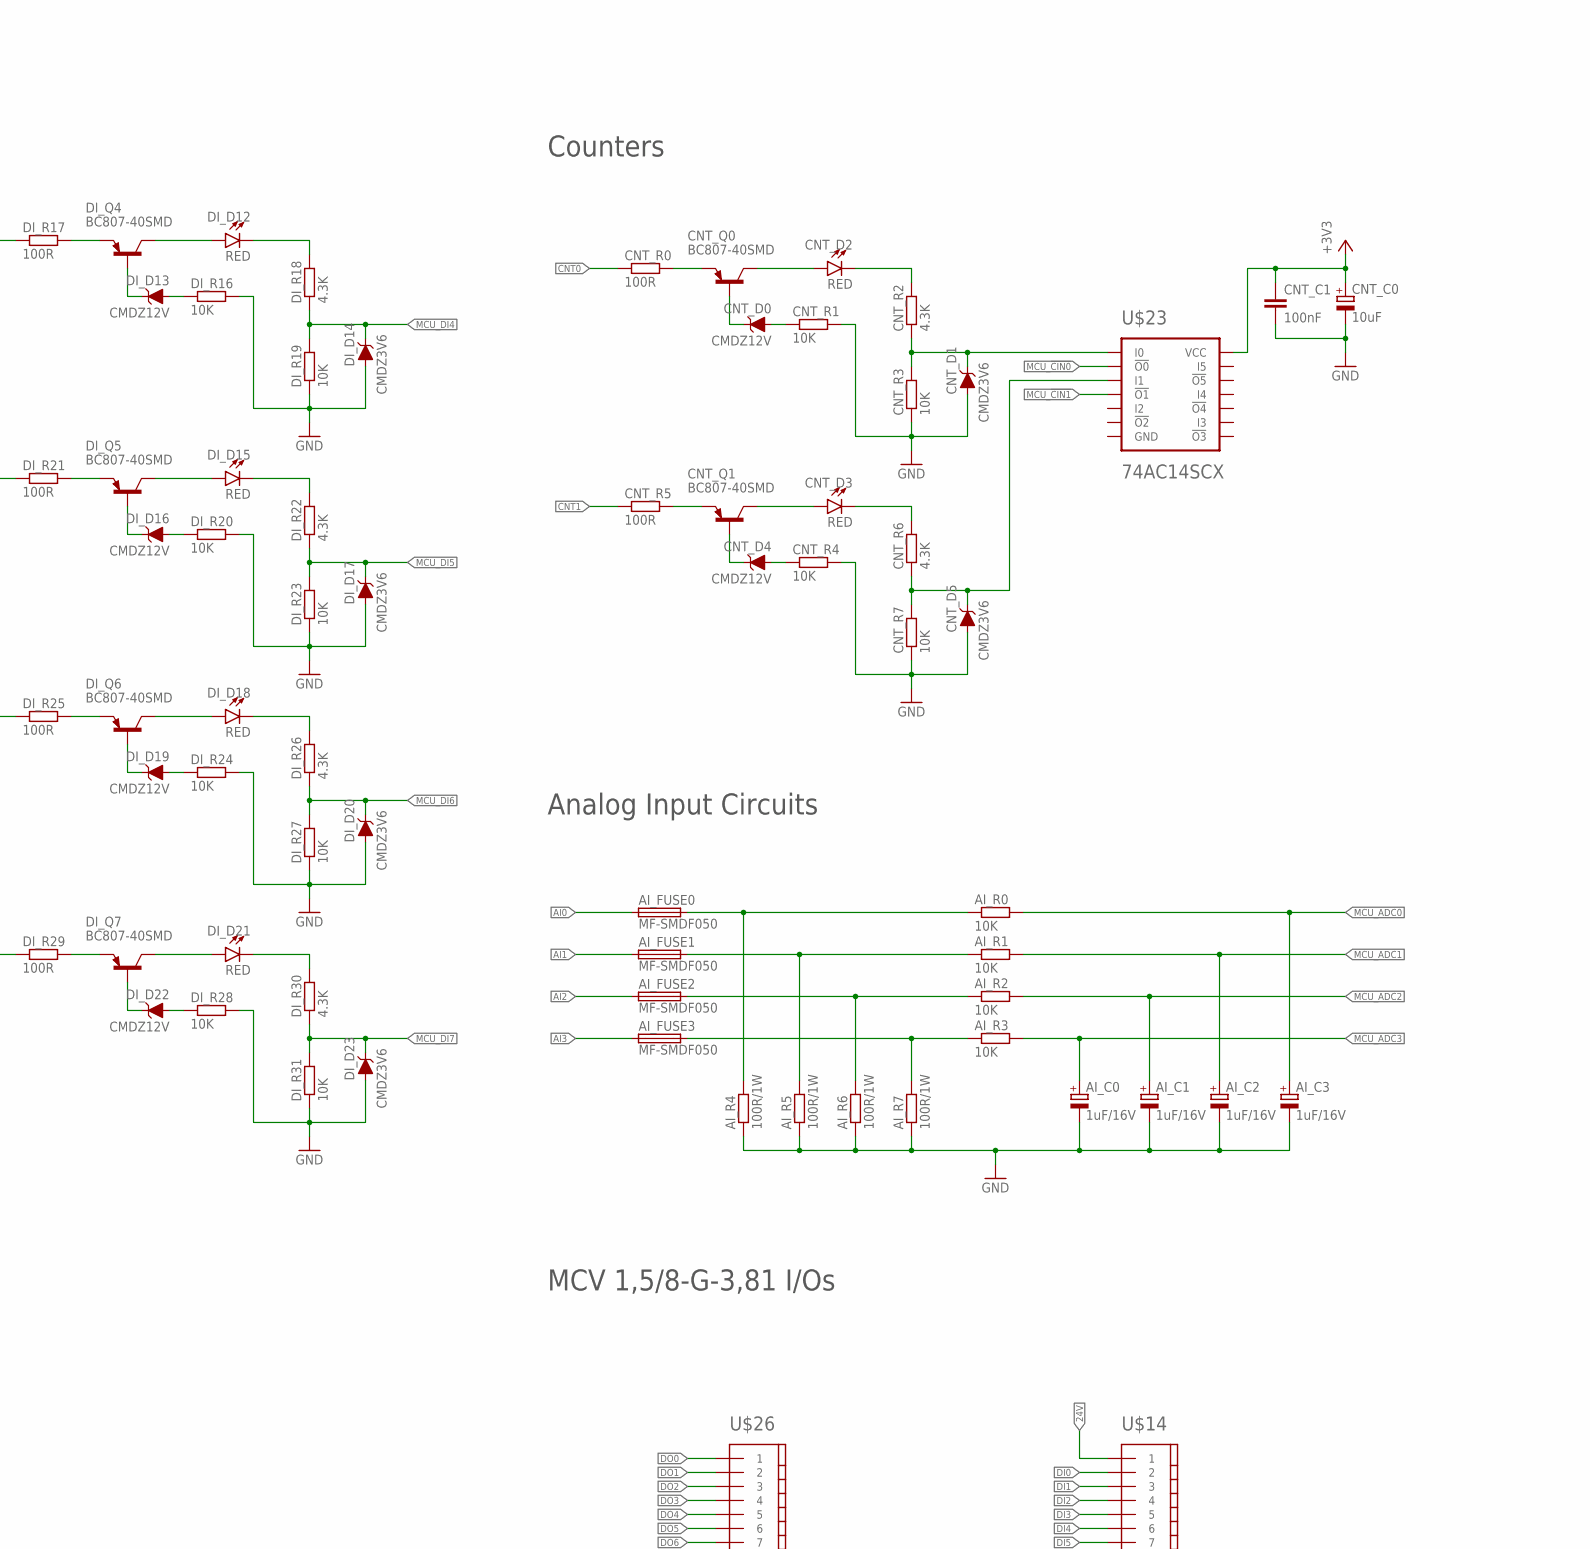
[picture p124: schematic plc_sam4e.sch, sheet 2, part in row 1, column 3]

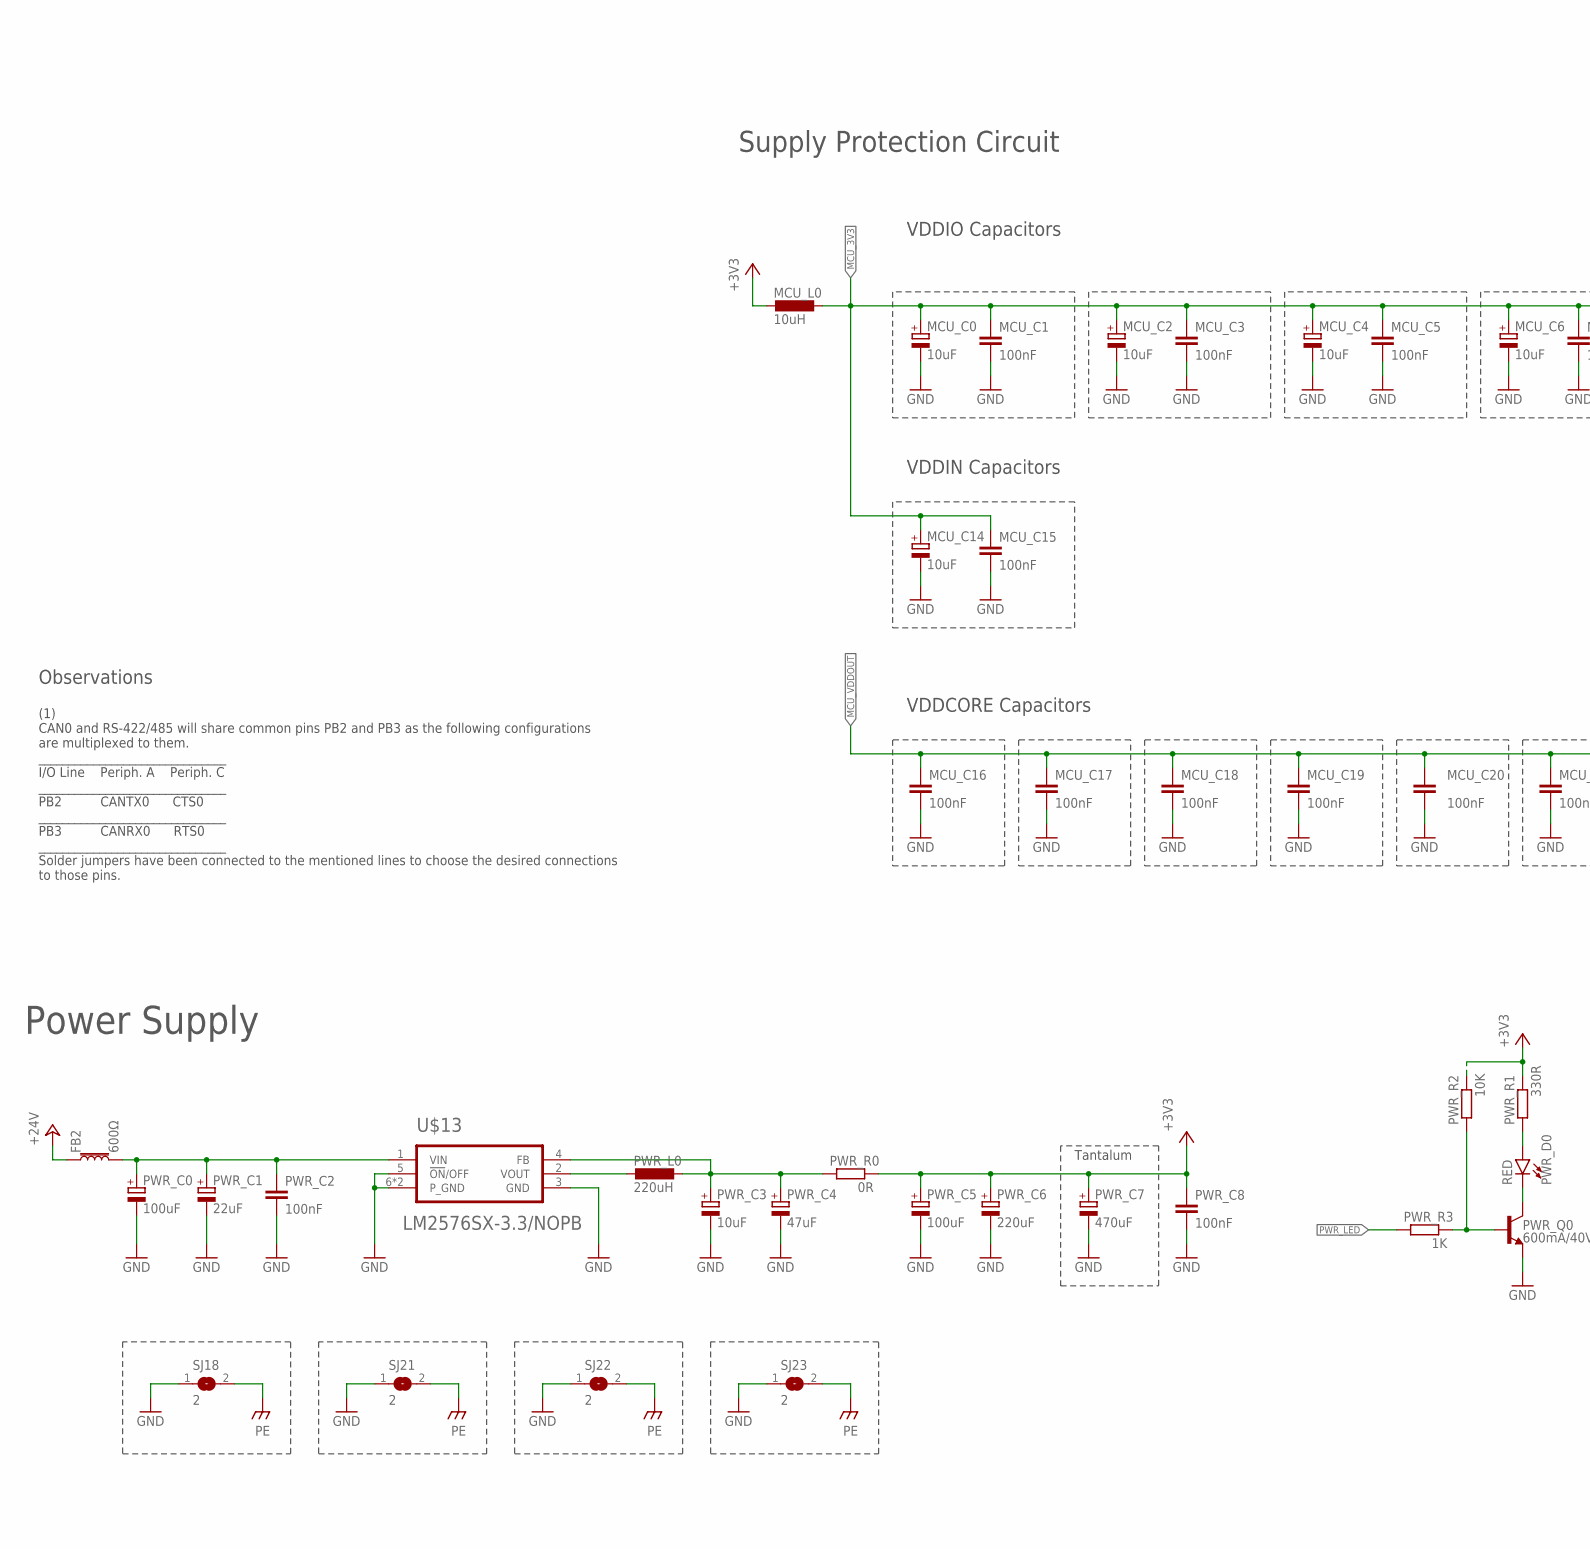
[picture p125: schematic plc_sam4e.sch, sheet 2, part in row 2, column 1]

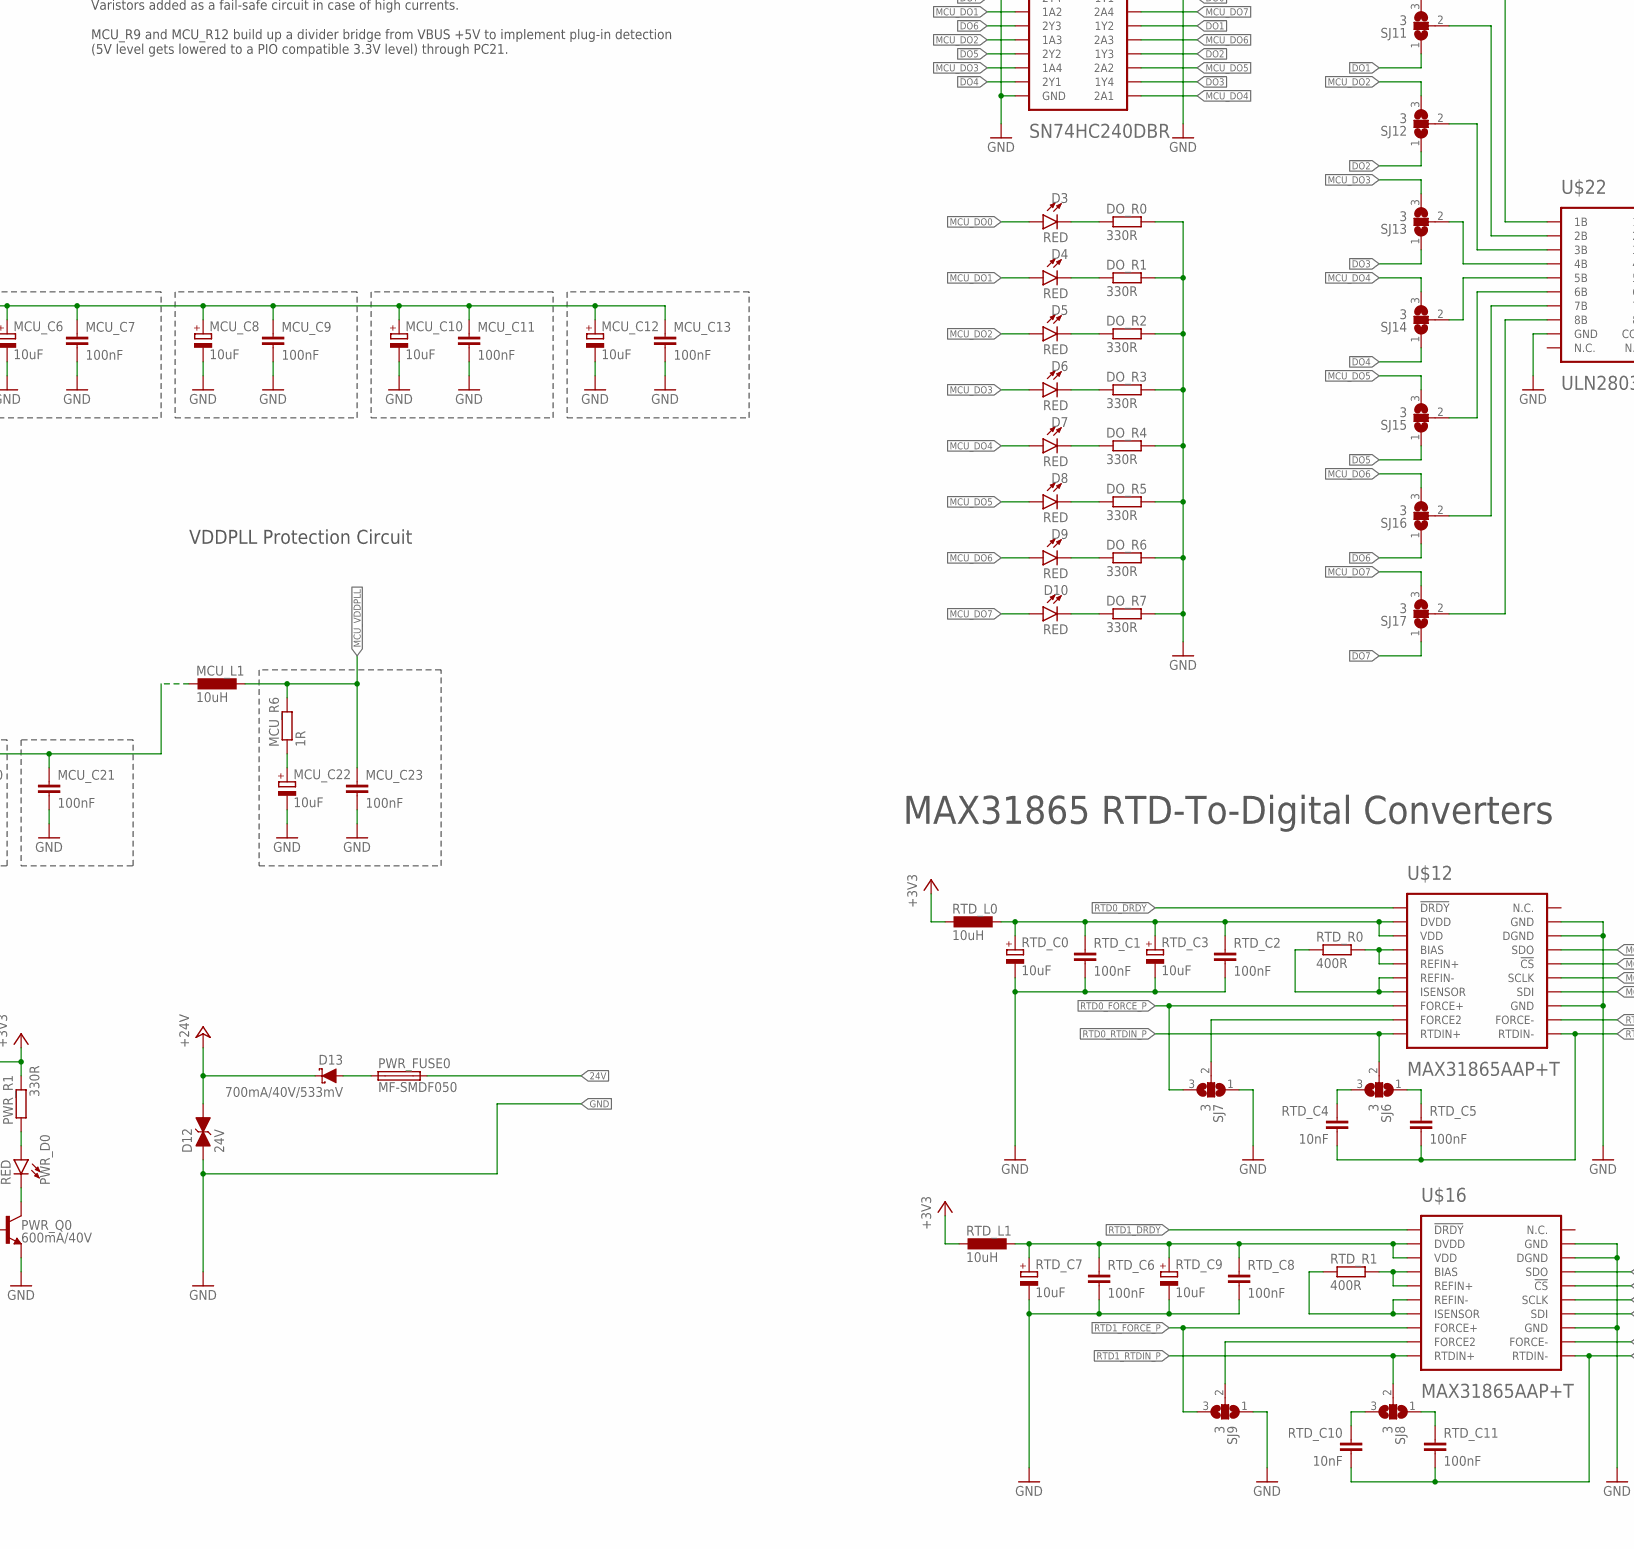
[picture p126: schematic plc_sam4e.sch, sheet 2, part in row 2, column 2]

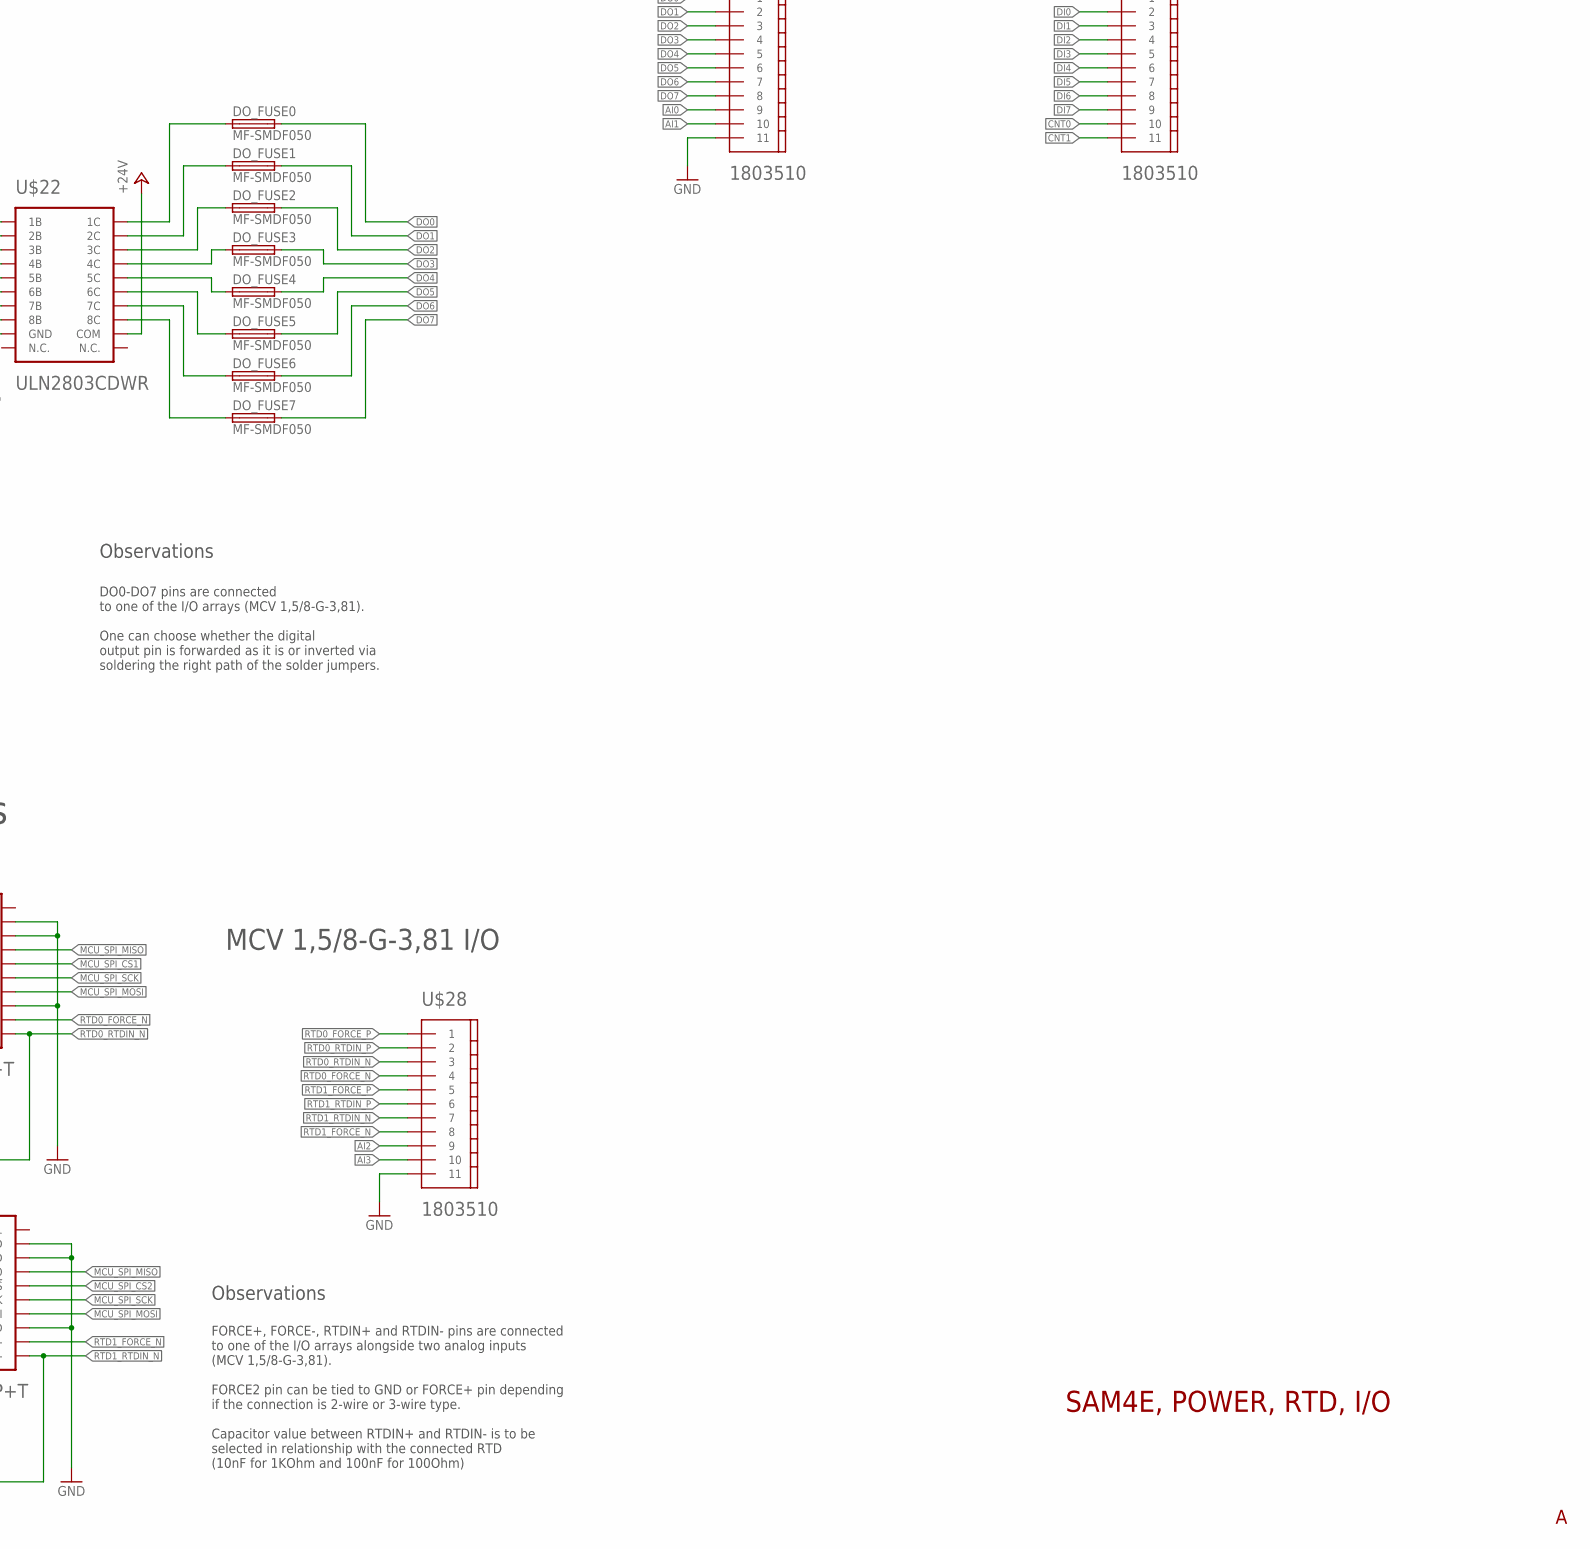
[picture p127: schematic plc_sam4e.sch, sheet 2, part in row 2, column 3]

Parts:
AI_C0, AI_C1, AI_C2, AI_C3: 1uF/16V; SMC_B
AI_FUSE0, AI_FUSE1, AI_FUSE2, AI_FUSE3: MF-SMDF050
AI_R0, AI_R1, AI_R2, AI_R3: 10K; R0402
AI_R4, AI_R5, AI_R6, AI_R7: 100R/1W; R0402
CNT_C0: 10uF; SMC_B
CNT_C1: 100nF; C0402
CNT_D0, CNT_D4: CMDZ12V; SOD-323
CNT_D1, CNT_D5: CMDZ3V6; SOD-323
CNT_D2, CNT_D3: RED; LED-1206
CNT_Q0, CNT_Q1: BC807-40SMD; SOT23-BEC
CNT_R0, CNT_R5: 100R; R0402
CNT_R1, CNT_R3, CNT_R4, CNT_R7: 10K; R0402
CNT_R2, CNT_R6: 4.3K; R0402
D3, D4, D5, D6, D7, D8, D9, D10: RED; LED-1206
D12: 24V; 0603
D13: 700mA/40V/533mV; SOT23-3
DI_D0, DI_D4, DI_D7, DI_D10, DI_D13, DI_D16, DI_D19, DI_D22: CMDZ12V; SOD-323
DI_D1, DI_D5, DI_D8, DI_D11, DI_D14, DI_D17, DI_D20, DI_D23: CMDZ3V6; SOD-323
DI_D2, DI_D3, DI_D6, DI_D9, DI_D12, DI_D15, DI_D18, DI_D21: RED; LED-1206
DI_Q0, DI_Q1, DI_Q2, DI_Q3, DI_Q4, DI_Q5, DI_Q6, DI_Q7: BC807-40SMD; SOT23-BEC
DI_R0, DI_R5, DI_R9, DI_R13, DI_R17, DI_R21, DI_R25, DI_R29: 100R; R0402
DI_R1, DI_R3, DI_R4, DI_R7, DI_R8, DI_R11, DI_R12, DI_R15, DI_R16, DI_R19, DI_R20, DI_R23, DI_R24, DI_R27, DI_R28, DI_R31: 10K; R0402
DI_R2, DI_R6, DI_R10, DI_R14, DI_R18, DI_R22, DI_R26, DI_R30: 4.3K; R0402
DO_FUSE0, DO_FUSE1, DO_FUSE2, DO_FUSE3, DO_FUSE4, DO_FUSE5, DO_FUSE6, DO_FUSE7: MF-SMDF050
DO_R0, DO_R1, DO_R2, DO_R3, DO_R4, DO_R5, DO_R6, DO_R7: 330R; R0402
FB2: 600Ω; 0805
IC1: LM336D; SO08
J1: JTAG; 2X5-SMD-UNSHROUDED
J3: SPI INTERFACE; 2X5-SHROUDED_SMD
MCU_C0, MCU_C2, MCU_C4, MCU_C6, MCU_C8, MCU_C10, MCU_C12, MCU_C14, MCU_C22: 10uF; SMC_B
MCU_C1, MCU_C3, MCU_C5, MCU_C7, MCU_C9, MCU_C11, MCU_C13, MCU_C15, MCU_C16, MCU_C17, MCU_C18, MCU_C19, MCU_C20, MCU_C21, MCU_C23, MCU_C24, MCU_C25: 100nF; C0402
MCU_C26: 1uF; SMC_B
MCU_C27: 1uF/16V; SMC_B
MCU_C28, MCU_C29, MCU_C30: 1uF; C0402
MCU_C31: 10pF; C0402
MCU_C36, MCU_C37: 15pF; C0402
MCU_L0, MCU_L1: 10uH; L1812
MCU_R0, MCU_R1, MCU_R2: 100K; R0402
MCU_R3, MCU_R4, MCU_R5: 0R; R0402
MCU_R6: 1R; R0402
MCU_R7: 330R; R0402
MCU_R8, MCU_R13, MCU_R14: 10K; R0402
MCU_R9: 47K; R0402
MCU_R10, MCU_R11: 27R; R0402
MCU_R12: 68K; R0402
MCU_S0: BUTTON; TACTILE_SWITCH_SMD_4.6X2.8MM
MCU_VAR0, MCU_VAR1: V5.5MLA0603N; CT/CN0603
PWR_C0, PWR_C5: 100uF; SMC_B
PWR_C1: 22uF; SMC_B
PWR_C2, PWR_C8: 100nF; C0402
PWR_C3: 10uF; SMC_B
PWR_C4: 47uF; SMC_B
PWR_C6: 220uF; SMC_B
PWR_C7: 470uF; SMC_B
PWR_D0: RED; LED-1206
PWR_FUSE0: MF-SMDF050
PWR_L0: 220uH; L1812
PWR_Q0: 600mA/40V; SOT23-3
PWR_R0: 0R; R0402
PWR_R1: 330R; R0402
PWR_R2: 10K; R0402
PWR_R3: 1K; R0402
RTD_C0, RTD_C3, RTD_C7, RTD_C9: 10uF; SMC_B
RTD_C1, RTD_C2, RTD_C5, RTD_C6, RTD_C8, RTD_C11: 100nF; C0402
RTD_C4, RTD_C10: 10nF; C0402
RTD_L0, RTD_L1: 10uH; L1812
RTD_R0, RTD_R1: 400R; R0402
SJ6, SJ7, SJ8, SJ9, SJ10, SJ11, SJ12, SJ13, SJ14, SJ15, SJ16, SJ17, SJ19, SJ20: 3; SJ_2
SJ18, SJ21, SJ22, SJ23: 2; SJ
SN_C0: 10uF; SMC_B
SN_C1: 100nF; C0402
U$2: FC-135-32.7680KA-AG0; 3.2X1.5MM
U$5: 47346-1001
U$8: ATSAM4E8EB-ANR; LQFP-144
U$12, U$16: MAX31865AAP+T; TSSOP-20
U$13: LM2576SX-3.3/NOPB; TO-263-5
U$14, U$26, U$28: 1803510
U$21: SN74HC240DBR; SSOP-20
U$22: ULN2803CDWR; SOIC-20
U$23: 74AC14SCX; SOIC-14
Y1: 12MHz; CRYSTAL-SMD-3.2X2.5MM

Connections:
24V: PWR_FUSE0.2, U$14.1; also elsewhere on the board
!DO0: SJ10.1, U$21.18 (1Y1)
!DO1: SJ11.1, U$21.16 (1Y2)
!DO2: SJ12.1, U$21.14 (1Y3)
!DO3: SJ13.1, U$21.12 (1Y4)
!DO4: SJ14.1, U$21.9 (2Y1)
!DO5: SJ15.1, U$21.7 (2Y2)
!DO6: SJ16.1, U$21.5 (2Y3)
!DO7: SJ17.1, U$21.3 (2Y4)
+3V3: CNT_C0.+, CNT_C1.1, J1.1 (VCC), J3.2, MCU_C24.1, MCU_L0.2, MCU_R0.2, MCU_R1.2, MCU_R2.2, MCU_R7.2, MCU_R8.2, MCU_R13.2, MCU_R14.2, PWR_C5.+, PWR_C6.+, PWR_C7.+, PWR_C8.1, PWR_R0.2, PWR_R1.2, PWR_R2.2, RTD_L0.2, RTD_L1.2, SN_C0.+, SN_C1.1, U$21.20 (VCC), U$23.14 (VCC); also elsewhere on the board
+24V: D12.2 (C), D13.3 (C), FB2.1, U$22.12 (COM)
AI0: AI_FUSE0.1, U$26.9
AI1: AI_FUSE1.1, U$26.10
AI2: AI_FUSE2.1, U$28.9
AI3: AI_FUSE3.1, U$28.10
CAN0_D: SJ19.1; also elsewhere on the board
CAN0_EN: U$8.6 (PE1); also elsewhere on the board
CAN0_R: SJ20.1; also elsewhere on the board
CAN0_RS: U$8.4 (PE0); also elsewhere on the board
CAN1_D: U$8.18 (PC15); also elsewhere on the board
CAN1_EN: U$8.10 (PE3); also elsewhere on the board
CAN1_R: U$8.17 (PC12); also elsewhere on the board
CAN1_RS: U$8.7 (PE2); also elsewhere on the board
CNT0: CNT_R0.1, U$14.10
CNT1: CNT_R5.1, U$14.11
DI0: DI_R0.1, U$14.2
DI1: DI_R5.1, U$14.3
DI2: DI_R9.1, U$14.4
DI3: DI_R13.1, U$14.5
DI4: DI_R17.1, U$14.6
DI5: DI_R21.1, U$14.7
DI6: DI_R25.1, U$14.8
DI7: DI_R29.1, U$14.9
DO0: DO_FUSE0.2, U$26.1
DO1: DO_FUSE1.2, U$26.2
DO2: DO_FUSE2.2, U$26.3
DO3: DO_FUSE3.2, U$26.4
DO4: DO_FUSE4.2, U$26.5
DO5: DO_FUSE5.2, U$26.6
DO6: DO_FUSE6.2, U$26.7
DO7: DO_FUSE7.2, U$26.8
EEPROM_A0: U$8.113 (PD8); also elsewhere on the board
EEPROM_A1: U$8.110 (PD9); also elsewhere on the board
ESP_INT: J3.4, U$8.101 (PD10)
GND: AI_C0.-, AI_C1.-, AI_C2.-, AI_C3.-, AI_R4.1, AI_R5.1, AI_R6.1, AI_R7.1, CNT_C0.-, CNT_C1.2, CNT_D1.A, CNT_D5.A, CNT_R1.2, CNT_R3.1, CNT_R4.2, CNT_R7.1, D12.1 (A), DI_D1.A, DI_D5.A, DI_D8.A, DI_D11.A, DI_D14.A, DI_D17.A, DI_D20.A, DI_D23.A, DI_R1.2, DI_R3.1, DI_R4.2, DI_R7.1, DI_R8.2, DI_R11.1, DI_R12.2, DI_R15.1, DI_R16.2, DI_R19.1, DI_R20.2, DI_R23.1, DI_R24.2, DI_R27.1, DI_R28.2, DI_R31.1, DO_R0.2, DO_R1.2, DO_R2.2, DO_R3.2, DO_R4.2, DO_R5.2, DO_R6.2, DO_R7.2, IC1.4 (A), J1.3 (GND), J1.5 (GND), J1.9 (GNDDTCT), J3.8, J3.10, MCU_C0.-, MCU_C1.2, MCU_C2.-, MCU_C3.2, MCU_C4.-, MCU_C5.2, MCU_C6.-, MCU_C7.2, MCU_C8.-, MCU_C9.2, MCU_C10.-, MCU_C11.2, MCU_C12.-, MCU_C13.2, MCU_C14.-, MCU_C15.2, MCU_C16.2, MCU_C17.2, MCU_C18.2, MCU_C19.2, MCU_C20.2, MCU_C21.2, MCU_C22.-, MCU_C23.2, MCU_C24.2, MCU_C25.2, MCU_C26.-, MCU_C27.-, MCU_C28.2, MCU_C29.2, MCU_C30.2, MCU_C31.2, MCU_C36.1, MCU_C37.1, MCU_R12.1, MCU_S0.3, MCU_S0.4, MCU_VAR0.1, PWR_C0.-, PWR_C1.-, PWR_C2.2, PWR_C3.-, PWR_C4.-, PWR_C5.-, PWR_C6.-, PWR_C7.-, PWR_C8.2, PWR_Q0.2 (E), RTD_C0.-, RTD_C1.2, RTD_C2.2, RTD_C3.-, RTD_C6.2, RTD_C7.-, RTD_C8.2, RTD_C9.-, SJ7.1, SJ9.1, SJ18.1, SJ21.1, SJ22.1, SJ23.1, SN_C0.-, SN_C1.2, U$5.5 (GND), U$12.13 (GND), U$12.18 (DGND), U$12.19 (GND), U$13.3 (GND), U$13.5 (!ON!/OFF), U$13.6 (P_GND), U$13.7 (P_GND), U$16.13 (GND), U$16.18 (DGND), U$16.19 (GND), U$21.1 (!1OE), U$21.10 (GND), U$21.19 (!2OE), U$22.9 (GND), U$26.11, U$28.11; also elsewhere on the board
MCU_3V3: MCU_C0.+, MCU_C1.1, MCU_C2.+, MCU_C3.1, MCU_C4.+, MCU_C5.1, MCU_C6.+, MCU_C7.1, MCU_C8.+, MCU_C9.1, MCU_C10.+, MCU_C11.1, MCU_C12.+, MCU_C13.1, MCU_C14.+, MCU_C15.1, MCU_L0.1, U$8.5 (VDDIN), U$8.30 (VDDIO), U$8.43 (VDDIO), U$8.72 (VDDIO), U$8.80 (VDDIO), U$8.96 (VDDIO), U$8.134 (VDDIO), U$8.143 (VDDIO)
MCU_!CIN0: U$8.102 (PA0/PGMEN0), U$23.2 (!O0)
MCU_!CIN1: U$8.99 (PA1/PGMEN1), U$23.4 (!O1)
MCU_ADC0: AI_C3.+, AI_R0.2, U$8.22 (PA20/PGMD8)
MCU_ADC1: AI_C2.+, AI_R1.2, U$8.23 (PA19/PGMD7)
MCU_ADC2: AI_C1.+, AI_R2.2, U$8.24 (PA18/PGMD6)
MCU_ADC3: AI_C0.+, AI_R3.2, U$8.25 (PA17/PGMD5)
MCU_ADVREFP: IC1.8 (C), MCU_C25.1, MCU_C26.+, MCU_R7.1, U$8.9 (ADVREFP)
MCU_DDM: MCU_R10.2, U$8.136 (PB10)
MCU_DDP: MCU_R11.2, U$8.137 (PB11)
MCU_DI0: DI_D1.C, DI_R2.1, DI_R3.2, U$8.55 (PD24)
MCU_DI1: DI_D5.C, DI_R6.1, DI_R7.2, U$8.52 (PD25)
MCU_DI2: DI_D8.C, DI_R10.1, DI_R11.2, U$8.53 (PD26)
MCU_DI3: DI_D11.C, DI_R14.1, DI_R15.2, U$8.47 (PD27)
MCU_DI4: DI_D14.C, DI_R18.1, DI_R19.2, U$8.71 (PD28)
MCU_DI5: DI_D17.C, DI_R22.1, DI_R23.2, U$8.108 (PD29)
MCU_DI6: DI_D20.C, DI_R26.1, DI_R27.2, U$8.34 (PD30)
MCU_DI7: DI_D23.C, DI_R30.1, DI_R31.2, U$8.2 (PD31)
MCU_DO0: D3.A, SJ10.3, U$8.1 (PD0), U$21.2 (1A1)
MCU_DO1: D4.A, SJ11.3, U$8.132 (PD1), U$21.4 (1A2)
MCU_DO2: D5.A, SJ12.3, U$8.131 (PD2), U$21.6 (1A3)
MCU_DO3: D6.A, SJ13.3, U$8.128 (PD3), U$21.8 (1A4)
MCU_DO4: D7.A, SJ14.3, U$8.126 (PD4), U$21.11 (2A1)
MCU_DO5: D8.A, SJ15.3, U$8.125 (PD5), U$21.13 (2A2)
MCU_DO6: D9.A, SJ16.3, U$8.121 (PD6), U$21.15 (2A3)
MCU_DO7: D10.A, SJ17.3, U$8.119 (PD7), U$21.17 (2A4)
MCU_INT: J3.6, U$8.98 (PD11)
MCU_LTE_AP_READY: U$8.92 (PD12); also elsewhere on the board
MCU_LTE_DBG_RXD: U$8.75 (PA9/PGMM1); also elsewhere on the board
MCU_LTE_DBG_TXD: U$8.66 (PA10/PGMM2); also elsewhere on the board
MCU_LTE_PWRKEY: U$8.84 (PD14); also elsewhere on the board
MCU_LTE_RESET_IN: U$8.106 (PD15); also elsewhere on the board
MCU_LTE_STATUS: U$8.88 (PD13); also elsewhere on the board
MCU_LTE_UART_CTS: U$8.59 (PA25/PGMD13); also elsewhere on the board
MCU_LTE_UART_DCD: U$8.62 (PA26/PGMD14); also elsewhere on the board
MCU_LTE_UART_DTR: U$8.70 (PA27/PGMD15); also elsewhere on the board
MCU_LTE_UART_RI: U$8.129 (PA29); also elsewhere on the board
MCU_LTE_UART_RTS: U$8.56 (PA24/PGMD12); also elsewhere on the board
MCU_LTE_UART_RXD: U$8.32 (PA21/PGMD9); also elsewhere on the board
MCU_LTE_UART_TXD: U$8.37 (PA22/PGMD10); also elsewhere on the board
MCU_NRST: MCU_C28.1, MCU_R3.2, MCU_R8.1, MCU_S0.1, MCU_S0.2, U$8.83 (NRST)
MCU_SPI_CS0: J3.5, U$8.64 (PA11/PGMM3)
MCU_SPI_CS1: U$8.118 (PA31), U$12.16 (!CS)
MCU_SPI_CS2: U$8.116 (PA30), U$16.16 (!CS)
MCU_SPI_MISO: J3.9, U$8.68 (PA12/PGMD0), U$12.17 (SDO), U$16.17 (SDO)
MCU_SPI_MOSI: J3.1, U$8.42 (PA13/PGMD1), U$12.14 (SDI), U$16.14 (SDI)
MCU_SPI_SCK: J3.7, U$8.51 (PA14/PGMD2), U$12.15 (SCLK), U$16.15 (SCLK)
MCU_TCK/SWCLK: J1.4 (SWDCLK/TCK), MCU_R1.1, U$8.89 (PB7)
MCU_TDI: J1.8 (NC/TDI), MCU_R0.1, U$8.105 (PB4)
MCU_TDO/TRACESWO: J1.6 (SWO/TDO), U$8.109 (PB5)
MCU_TMS/SWDIO: J1.2 (SWDIO/TMS), MCU_R2.1, U$8.79 (PB6)
MCU_TWCK0: MCU_R13.1, U$8.77 (PA4/PGMNCMD); also elsewhere on the board
MCU_TWD0: MCU_R14.1, U$8.91 (PA3); also elsewhere on the board
MCU_VBUS: MCU_R9.2, MCU_R12.2, U$8.122 (PC21)
MCU_VDDOUT: MCU_C16.1, MCU_C17.1, MCU_C18.1, MCU_C19.1, MCU_C20.1, MCU_C21.1, MCU_L1.2, U$8.3 (VDDOUT), U$8.29 (VDDCORE), U$8.33 (VDDCORE), U$8.50 (VDDCORE), U$8.81 (VDDCORE), U$8.107 (VDDCORE), U$8.123 (VDDCORE)
MCU_VDDPLL: MCU_C23.1, MCU_L1.1, MCU_R6.2, U$8.139 (VDDPLL)
unnamed: D13.1 (A), PWR_FUSE0.1
unnamed: PWR_Q0.1 (B), PWR_R2.1, PWR_R3.2
unnamed: IC1.5 (ADJ), MCU_C27.+
unnamed: PWR_D0.A, PWR_R1.1
unnamed: PWR_L0.2, U$13.2 (VOUT)
unnamed: FB2.2, PWR_C0.+, PWR_C1.+, PWR_C2.1, U$13.1 (VIN)
unnamed: PWR_C3.+, PWR_C4.+, PWR_L0.1, PWR_R0.1, U$13.4 (FB)
unnamed: PWR_D0.C, PWR_Q0.3 (C)
unnamed: SJ20.2, U$8.31 (PB3)
unnamed: MCU_R5.1, U$8.141 (PB8)
unnamed: SJ7.2, U$12.9 (FORCE2)
unnamed: MCU_C31.1, MCU_R9.1, MCU_VAR1.1, U$5.1 (VBUS)
unnamed: RTD_R1.2, U$16.4 (BIAS), U$16.5 (REFIN+)
unnamed: RTD_C0.+, RTD_C1.1, RTD_C2.1, RTD_C3.+, RTD_L0.1, U$12.2 (DVDD), U$12.3 (VDD)
unnamed: MCU_C22.+, MCU_R6.1
unnamed: RTD_R1.1, U$16.6 (REFIN-), U$16.7 (ISENSOR)
unnamed: RTD_R0.2, U$12.4 (BIAS), U$12.5 (REFIN+)
unnamed: RTD_R0.1, U$12.6 (REFIN-), U$12.7 (ISENSOR)
unnamed: SJ13.2, U$22.4 (4B)
unnamed: SJ14.2, U$22.5 (5B)
unnamed: SJ12.2, U$22.3 (3B)
unnamed: SJ15.2, U$22.6 (6B)
unnamed: AI_FUSE0.2, AI_R0.1, AI_R4.2
unnamed: RTD_C10.1, SJ8.3
unnamed: RTD_C4.1, SJ6.3
unnamed: RTD_C5.1, SJ6.1
unnamed: RTD_C11.1, SJ8.1
unnamed: RTD_C6.1, RTD_C7.+, RTD_C8.1, RTD_C9.+, RTD_L1.1, U$16.2 (DVDD), U$16.3 (VDD)
unnamed: SJ9.2, U$16.9 (FORCE2)
unnamed: AI_FUSE1.2, AI_R1.1, AI_R5.2
unnamed: AI_FUSE2.2, AI_R2.1, AI_R6.2
unnamed: AI_FUSE3.2, AI_R3.1, AI_R7.2
unnamed: SJ16.2, U$22.7 (7B)
unnamed: SJ17.2, U$22.8 (8B)
unnamed: SJ11.2, U$22.2 (2B)
unnamed: SJ10.2, U$22.1 (1B)
unnamed: DO_FUSE0.1, U$22.20 (1C)
unnamed: DO_FUSE1.1, U$22.19 (2C)
unnamed: DO_FUSE2.1, U$22.18 (3C)
unnamed: DO_FUSE3.1, U$22.17 (4C)
unnamed: DO_FUSE4.1, U$22.16 (5C)
unnamed: DO_FUSE5.1, U$22.15 (6C)
unnamed: DO_FUSE6.1, U$22.14 (7C)
unnamed: DO_FUSE7.1, U$22.13 (8C)
unnamed: D3.C, DO_R0.1
unnamed: DI_Q0.E, DI_R0.2
unnamed: DI_D2.A, DI_Q0.C
unnamed: D4.C, DO_R1.1
unnamed: DI_D0.C, DI_Q0.B
unnamed: DI_D0.A, DI_R1.1
unnamed: D5.C, DO_R2.1
unnamed: DI_Q1.E, DI_R5.2
unnamed: DI_D3.A, DI_Q1.C
unnamed: D6.C, DO_R3.1
unnamed: DI_D2.C, DI_R2.2
unnamed: DI_D4.C, DI_Q1.B
unnamed: D7.C, DO_R4.1
unnamed: DI_D4.A, DI_R4.1
unnamed: DI_D3.C, DI_R6.2
unnamed: D8.C, DO_R5.1
unnamed: DI_Q2.E, DI_R9.2
unnamed: DI_D6.A, DI_Q2.C
unnamed: D9.C, DO_R6.1
unnamed: DI_D7.C, DI_Q2.B
unnamed: DI_D7.A, DI_R8.1
unnamed: D10.C, DO_R7.1
unnamed: DI_D6.C, DI_R10.2
unnamed: DI_Q3.E, DI_R13.2
unnamed: DI_D9.A, DI_Q3.C
unnamed: DI_D10.C, DI_Q3.B
unnamed: DI_D10.A, DI_R12.1
unnamed: DI_D9.C, DI_R14.2
unnamed: DI_Q4.E, DI_R17.2
unnamed: DI_D12.A, DI_Q4.C
unnamed: DI_D13.C, DI_Q4.B
unnamed: DI_D13.A, DI_R16.1
unnamed: DI_D12.C, DI_R18.2
unnamed: DI_Q5.E, DI_R21.2
unnamed: DI_D15.A, DI_Q5.C
unnamed: DI_D16.C, DI_Q5.B
unnamed: DI_D16.A, DI_R20.1
unnamed: DI_D15.C, DI_R22.2
unnamed: DI_Q6.E, DI_R25.2
unnamed: DI_D18.A, DI_Q6.C
unnamed: DI_D19.C, DI_Q6.B
unnamed: DI_D19.A, DI_R24.1
unnamed: DI_D18.C, DI_R26.2
unnamed: DI_Q7.E, DI_R29.2
unnamed: DI_D21.A, DI_Q7.C
unnamed: DI_D22.C, DI_Q7.B
unnamed: DI_D22.A, DI_R28.1
unnamed: DI_D21.C, DI_R30.2
unnamed: CNT_Q0.E, CNT_R0.2
unnamed: CNT_D2.A, CNT_Q0.C
unnamed: CNT_D0.C, CNT_Q0.B
unnamed: CNT_D0.A, CNT_R1.1
unnamed: CNT_D2.C, CNT_R2.2
unnamed: CNT_Q1.E, CNT_R5.2
unnamed: CNT_D3.A, CNT_Q1.C
unnamed: CNT_D4.C, CNT_Q1.B
unnamed: CNT_D4.A, CNT_R4.1
unnamed: CNT_D3.C, CNT_R6.2
unnamed: CNT_D1.C, CNT_R2.1, CNT_R3.2, U$23.1 (I0)
unnamed: CNT_D5.C, CNT_R6.1, CNT_R7.2, U$23.3 (I1)
unnamed: J1.10 (!RESET), MCU_R3.1
unnamed: MCU_C36.2, MCU_R4.2, Y1.1
unnamed: MCU_C37.2, MCU_R5.2, Y1.3 (2)
unnamed: MCU_C29.1, U$2.2, U$8.35 (PA7/PGMNVALID)
unnamed: MCU_C30.1, U$2.1, U$8.36 (PA8/PGMM0)
unnamed: MCU_R11.1, U$5.3 (D+)
unnamed: MCU_R10.1, U$5.2 (D-)
unnamed: MCU_R4.1, U$8.142 (PB9)
unnamed: SJ19.2, U$8.26 (PB2)
P$1: J3.3, MCU_VAR0.2, MCU_VAR1.2, SJ18.2, SJ21.2, SJ22.2, SJ23.2, U$5.6 (SHIELD), U$5.7 (SHIELD), U$5.8 (SHIELD), U$5.9 (SHIELD), U$5.10 (SHIELD), U$5.11 (SHIELD); also elsewhere on the board
PWR_LED: PWR_R3.1, U$8.78 (PD16)
RS_!RE: SJ19.3; also elsewhere on the board
RS_DE: SJ20.3; also elsewhere on the board
RS_DI: U$8.20 (PB1); also elsewhere on the board
RS_RO: U$8.21 (PB0); also elsewhere on the board
RTC_MFP: U$8.67 (PD19); also elsewhere on the board
RTD0_!DRDY: U$8.74 (PD17), U$12.1 (!DRDY)
RTD0_FORCE_N: U$12.12 (FORCE-), U$28.4
RTD0_FORCE_P: SJ7.3, U$12.8 (FORCE+), U$28.1
RTD0_RTDIN_N: RTD_C4.2, RTD_C5.2, U$12.11 (RTDIN-), U$28.3
RTD0_RTDIN_P: SJ6.2, U$12.10 (RTDIN+), U$28.2
RTD1_!DRDY: U$8.69 (PD18), U$16.1 (!DRDY)
RTD1_FORCE_N: U$16.12 (FORCE-), U$28.8
RTD1_FORCE_P: SJ9.3, U$16.8 (FORCE+), U$28.5
RTD1_RTDIN_N: RTD_C10.2, RTD_C11.2, U$16.11 (RTDIN-), U$28.7
RTD1_RTDIN_P: SJ8.2, U$16.10 (RTDIN+), U$28.6

Notes on the sheet:
Tantalum
MAX31865 RTD-To-Digital Converters
Observations
FORCE+, FORCE-, RTDIN+ and RTDIN- pins are connected to one of the I/O arrays alongside two analog inputs (MCV 1,5/8-G-3,81). FORCE2 pin can be tied to GND or FORCE+ pin depending if the connection is 2-wire or 3-wire type. Capacitor value between RTDIN+ and RTDIN- is to be selected in relationship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
MCV 1,5/8-G-3,81 I/O
Digital Output Circuits
Analog Input Circuits
Digital Input Circuits
Counters
I/O Interface
DO0-DO7 pins are connected to one of the I/O arrays (MCV 1,5/8-G-3,81). One can choose whether the digital output pin is forwarded as it is or inverted via soldering the right path of the solder jumpers.
MCV 1,5/8-G-3,81 I/Os
SPI Interface
SPI interface that connects ESP32 board to SAM4E board for Internet connectivity (Wi-Fi and Ethernet). Interrupt lines are set up each way as well.
VDDIO Capacitors
VDDIN Capacitors
VDDCORE Capacitors
VDDPLL Protection Circuit
Supply Protection Circuit
USB Interface
Varistors added as a fail-safe circuit in case of high currents. MCU_R9 and MCU_R12 build up a divider bridge from VBUS +5V to implement plug-in detection (5V level gets lowered to a PIO compatible 3.3V level) through PC21.
Atmel/Microchip SAM4E IC
Power Supply
JTAG Interface
The 0Ohm resistor may be removed in order to isolate the JTAG port from this system reset signal.
(1) CAN0 and RS-422/485 will share common pins PB2 and PB3 as the following configurations are multiplexed to them. _______________________________ I/O Line Periph. A Periph. C _______________________________ PB2 CANTX0 CTS0 _______________________________ PB3 CANRX0 RTS0 __________________________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
(1)
SAM4E, POWER, RTD, I/O

Board: 2 copper layers, 357 parts (0 on the bottom side), 300 nets, no tracks yet.
