nicolaeandreivasile/plc-embedded-application/board-design/eagle-files/ESP32-PLC-programmer/plc_esp32_programmer.brd

## EAGLE design board-design/eagle-files/ESP32-PLC-programmer/plc_esp32_programmer.brd (2026-04-05)

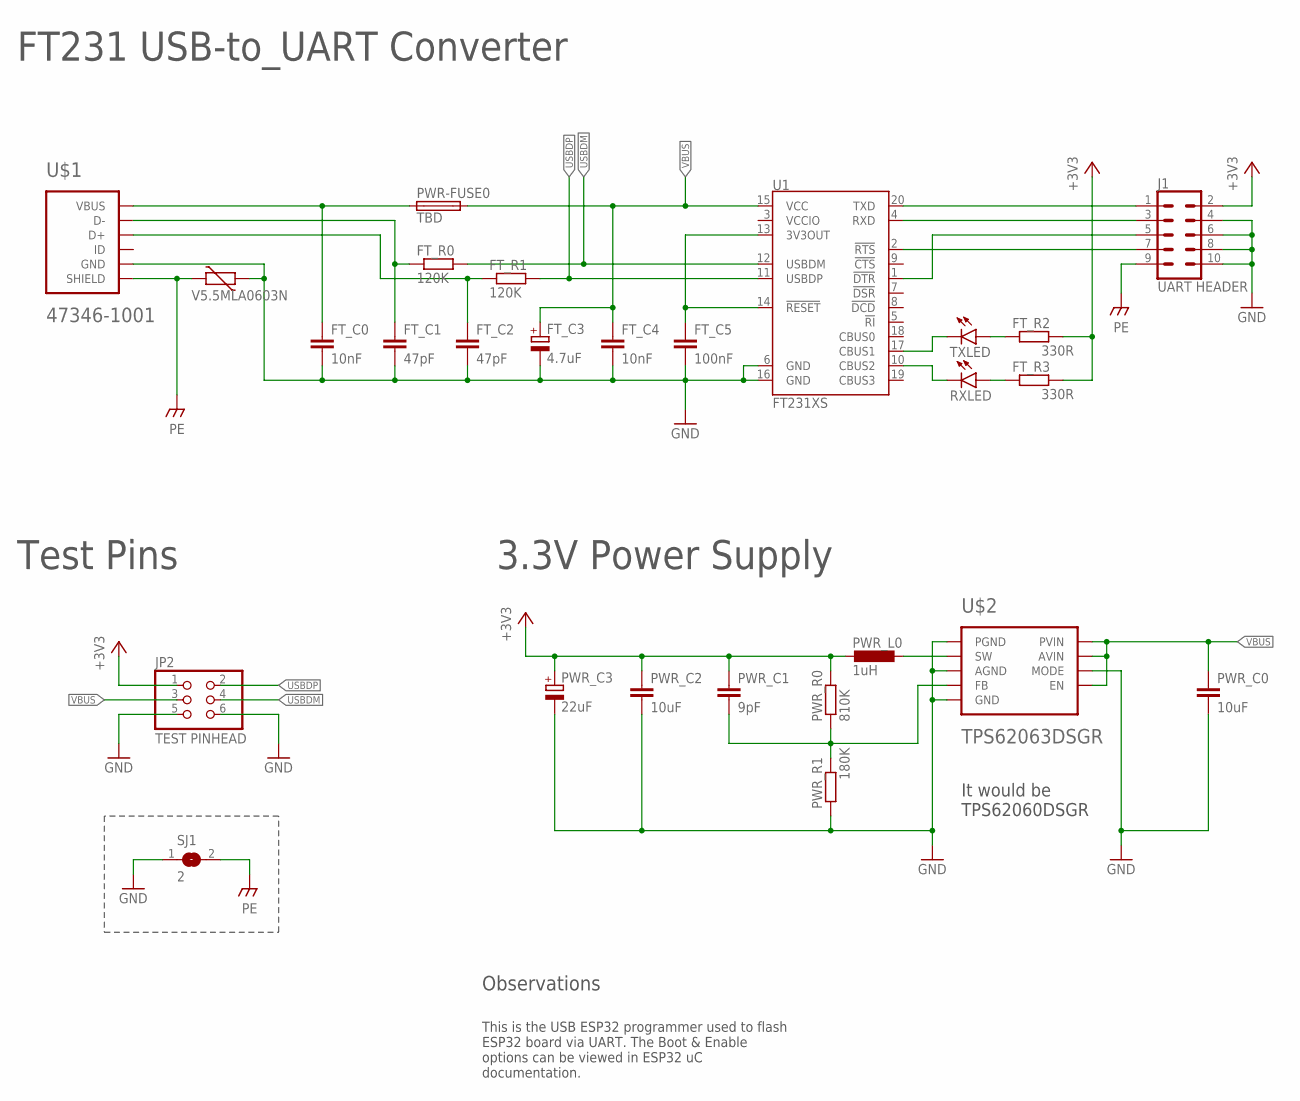
[picture p128: schematic plc_esp32_programmer.sch]

Parts:
FT_C0, FT_C4: 10nF; C0402
FT_C1, FT_C2: 47pF; C0402
FT_C3: 4.7uF; SMC_B
FT_C5: 100nF; C0402
FT_R0, FT_R1: 120K; R0402
FT_R2, FT_R3: 330R; R0402
J1: UART HEADER; 2X5-SHROUDED_SMD
JP2: TEST PINHEAD; 2X03
MCU_VAR1: V5.5MLA0603N; CT/CN0603
PWR-FUSE0: TBD; MF-SMDF050
PWR_C0, PWR_C2: 10uF; C0603
PWR_C1: 9pF; C0402
PWR_C3: 22uF; SMC_B
PWR_L0: 1uH; L1210
PWR_R0: 810K; R0402
PWR_R1: 180K; R0402
RXLED: LG_T679-E1F1-1; PLCC2
SJ1: 2; SJ
TXLED: LG_T679-E1F1-1; PLCC2
U1: FT231XS; SSOP20_L
U$1: 47346-1001
U$2: TPS62063DSGR; WSON-8

Connections:
+3V3: FT_R2.2, FT_R3.2, J1.2, JP2.1, PWR_C1.1, PWR_C2.1, PWR_C3.+, PWR_L0.2, PWR_R0.2
GND: FT_C0.2, FT_C1.2, FT_C2.2, FT_C3.-, FT_C4.2, FT_C5.2, J1.4, J1.6, J1.8, J1.10, JP2.5, JP2.6, MCU_VAR1.1, PWR_C0.2, PWR_C2.2, PWR_C3.-, PWR_R1.1, SJ1.1, U1.6 (GND), U1.16 (GND), U$1.5 (GND), U$2.1 (PGND), U$2.3 (AGND), U$2.6 (MODE), U$2.9 (GND), U$2.10 (GND), U$2.11 (GND)
unnamed: J1.1, U1.20 (TXD)
unnamed: J1.3, U1.4 (RXD)
unnamed: J1.7, U1.2 (!RTS)
unnamed: J1.5, U1.1 (!DTR)
unnamed: FT_C5.1, U1.13 (3V3OUT), U1.14 (!RESET)
unnamed: FT_C2.1, FT_R1.1, U$1.3 (D+)
unnamed: FT_C1.1, FT_R0.1, U$1.2 (D-)
unnamed: FT_C0.1, PWR-FUSE0.1, U$1.1 (VBUS)
unnamed: FT_R3.1, RXLED.A
unnamed: RXLED.C, U1.10 (CBUS2)
unnamed: PWR_L0.1, U$2.2 (SW)
unnamed: PWR_C1.2, PWR_R0.1, PWR_R1.2, U$2.4 (FB)
unnamed: FT_R2.1, TXLED.A
unnamed: TXLED.C, U1.17 (CBUS1)
PE: J1.9, MCU_VAR1.2, SJ1.2, U$1.6 (SHIELD), U$1.7 (SHIELD), U$1.8 (SHIELD), U$1.9 (SHIELD), U$1.10 (SHIELD), U$1.11 (SHIELD)
USBDM: FT_R0.2, JP2.4, U1.12 (USBDM)
USBDP: FT_R1.2, JP2.2, U1.11 (USBDP)
VBUS: FT_C3.+, FT_C4.1, JP2.3, PWR-FUSE0.2, PWR_C0.1, U1.15 (VCC), U$2.5 (EN), U$2.7 (AVIN), U$2.8 (PVIN)

Notes on the sheet:
It would be TPS62060DSGR
FT231 USB-to_UART Converter
3.3V Power Supply
Test Pins
Observations
This is the USB ESP32 programmer used to flash ESP32 board via UART. The Boot & Enable options can be viewed in ESP32 uC documentation.

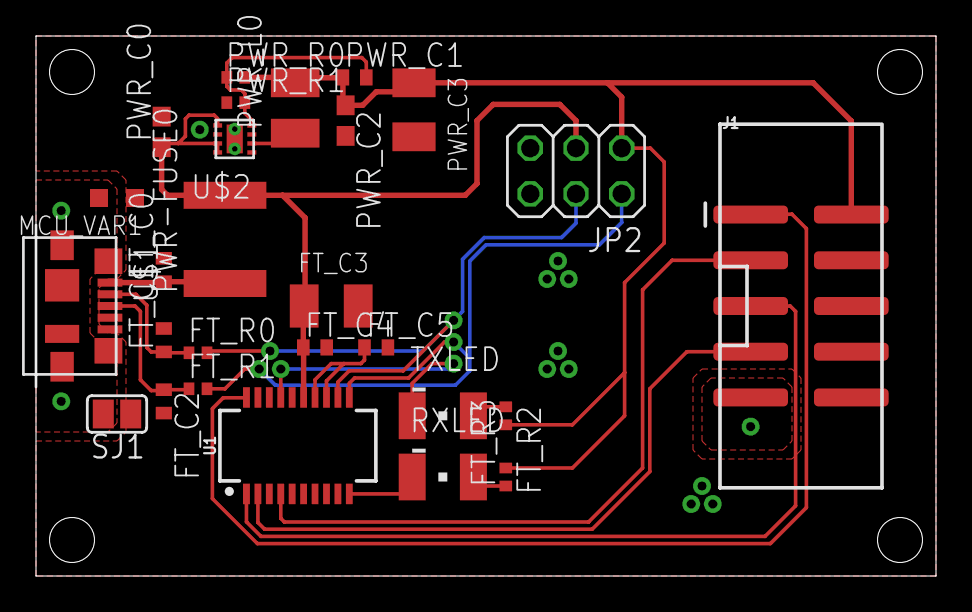
[picture p129: board plc_esp32_programmer.brd from above]

Board: 2 copper layers, 50.0 x 30.0 mm, 27 parts (0 on the bottom side), 20 nets.
