nicolaeandreivasile/plc-embedded-application/(commit log)

2021-10-17 Initial files added
    [esp32-plc.brd, esp32-plc.sch]
2021-10-19 Changed board schematic
    [esp32-plc.brd, esp32-plc.sch]
2021-12-15 Eagle schematic changed
    [esp32-plc.brd, esp32-plc.sch]
2022-02-09 Added RS485 Interface Module
    [esp32-plc.brd, esp32-plc.sch]
2022-02-11 Updated schematic
    [esp32-plc.brd, esp32-plc.sch]
2022-02-13 Logic unit schematic updated
    [esp32-plc.brd, esp32-plc.sch]
2023-04-20 PLC Update
    Added Ethernet module.
    [esp32-plc.brd, esp32-plc.sch]
2023-06-25 PLC board design
    Verifications and improvements of the hardware design.
    [esp32-plc.brd, esp32-plc.sch]
2023-12-02 [UPDATE] Refactored repository
    Updated repository with laatest work. Uploaded work that has been made in EAGLE and continued in Kicad. Removed redundant information.
    [CAN.kicad_sch, DI.kicad_sch, DO.kicad_sch, ESP32-PLC-programmer.csv, ESP32-PLC-programmer.kicad_pcb, ESP32-PLC-programmer.kicad_sch, ESP32-PLC.kicad_pcb, ESP32-PLC.kicad_sch]
2023-12-03 [UPDATE]
    Finished ESP32 and ESP32-programmer board designs (few corrections to be made when manufacturer is chosen - design rules).
    [ESP32-PLC-programmer.csv, ESP32-PLC-programmer.kicad_pcb, ESP32-PLC-programmer.kicad_sch, ESP32-PLC.csv, ESP32-PLC.kicad_pcb, ESP32-PLC.kicad_sch, ESP32-WROVER.kicad_sch, LAN8720A.kicad_sch]
2023-12-03 [UPDATE]
    Fixed design PDF files.
    [ESP32-PLC-programmer.csv, ESP32-PLC-programmer.kicad_pcb, ESP32-PLC.csv]
2023-12-03 [Components]
    Completed component lists for ESP32-programmer and ESP32 boards.
    [ESP32-PLC-programmer.csv, ESP32-PLC.csv]
2023-12-08 [FIX]
    Updated footprints for tactile switches.
    [ESP32-PLC.csv, ESP32-PLC.kicad_pcb, ESP32-PLC.kicad_sch, IO.kicad_sch, SAM4E-PLC.kicad_sch]
2023-12-08 [UPDATE]
    Refactored schematic for LTE, Power and other schematic sub-sheets.
    [CAN.kicad_sch, IO.kicad_sch, LTE.kicad_sch, PWR.kicad_sch, SAM4E-PLC.kicad_sch]
2023-12-09 [UPDATE]
    First draft of SAM4E-PLC schematic completed.
    [CAN_RS-485_RTD.kicad_sch, DI.kicad_sch, DO.kicad_sch, IO.kicad_sch, LTE.kicad_sch, PWR.kicad_sch, RS-485.kicad_sch, RTC.kicad_sch]
2023-12-09 [IN PROGRESS]
    SAM4E-PLC PCB design in progress.
    [IO.kicad_sch, PWR.kicad_sch, RTC_EEPROM.kicad_sch, SAM4E-PLC.kicad_pcb, SAM4E-PLC.kicad_sch]
2023-12-10 [UPDATE]
    Work in progress.
    [CAN_RS-485_RTD.kicad_sch, IO.kicad_sch, LTE.kicad_sch, PWR.kicad_sch, RTC_EEPROM.kicad_sch, SAM4E-PLC.kicad_pcb, SAM4E-PLC.kicad_sch]
2023-12-22 [UPDATE]
    Finished ESP32-PLC board design
    [ESP32-PLC.csv, ESP32-PLC.kicad_pcb, ESP32-PLC.kicad_sch, LAN8720A.kicad_sch, LTE.kicad_sch, RTC.kicad_sch]
2023-12-22 [UPDATE]
    Completed SAM4E-PLC board design.
    [CAN_RS-485_RTD.kicad_sch, IO.kicad_sch, LTE.kicad_sch, PWR.kicad_sch, RTC_EEPROM.kicad_sch, SAM4E-PLC.csv, SAM4E-PLC.kicad_pcb, SAM4E-PLC.kicad_sch]
2023-12-22 [Prototype A completed]
    Completed first board prototype design.
2024-06-08 [Final report]
    Added simple images for ESP32 adn SAM4
2024-06-11 [Libraries]
    Added used libraries for the KiCad projects.
2024-06-12 [Final report]
    Added 3D models.
    [CAN_RS-485_RTD.kicad_sch, ESP32-PLC-programmer.kicad_pcb, ESP32-PLC.kicad_pcb, ESP32-PLC.kicad_sch, IO.kicad_sch, LAN8720A.kicad_sch, LTE.kicad_sch, PWR.kicad_sch]
2024-06-13 [PLC]
    Updated PCB PDFs.
2026-04-05 [Refactor] Documentation refactoring
    Sorted documentation and added final report for the device.
